bsobeloffgittes/NFR25-CAD/Aerodynamics/Bodywork/PaintJob Design/2x2_twill_pattern_carbon_size-540.jpg

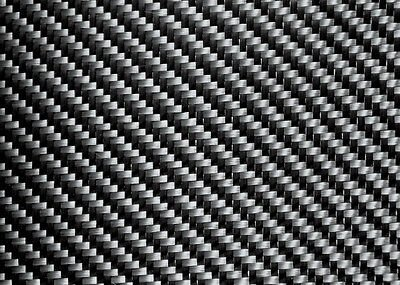
Aerodynamics/Bodywork/PaintJob Design/2x2_twill_pattern_carbon_size-540.jpg
