bsobeloffgittes/NFR25-CAD/Accumulator/Penthouse/Penthouse Internals/reference_images/receptacle_model_dimensions.jpg

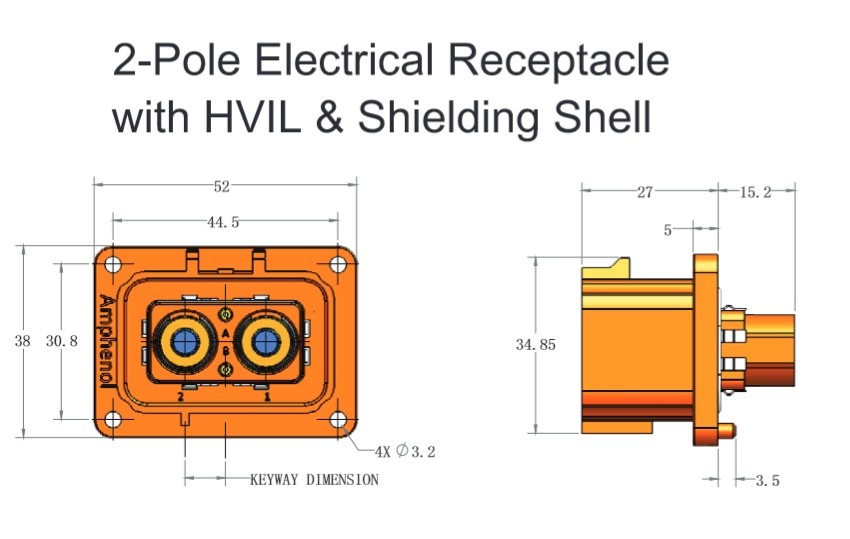
Accumulator/Penthouse/Penthouse Internals/reference_images/receptacle_model_dimensions.jpg
