bsobeloffgittes/NFR25-CAD/README.md

# NFR25-CAD
CAD file management for NFR25
