bsobeloffgittes/NFR25-CAD/Aerodynamics/Bodywork/Car Number.jpg

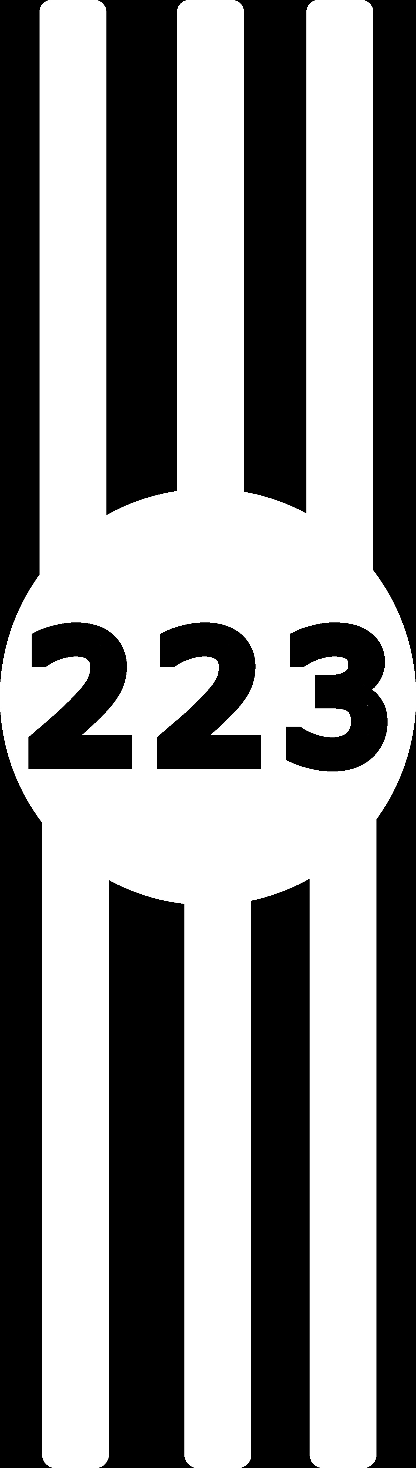
Aerodynamics/Bodywork/Car Number.jpg
