bsobeloffgittes/NFR25-CAD/Aerodynamics/Bodywork/Car Number.png

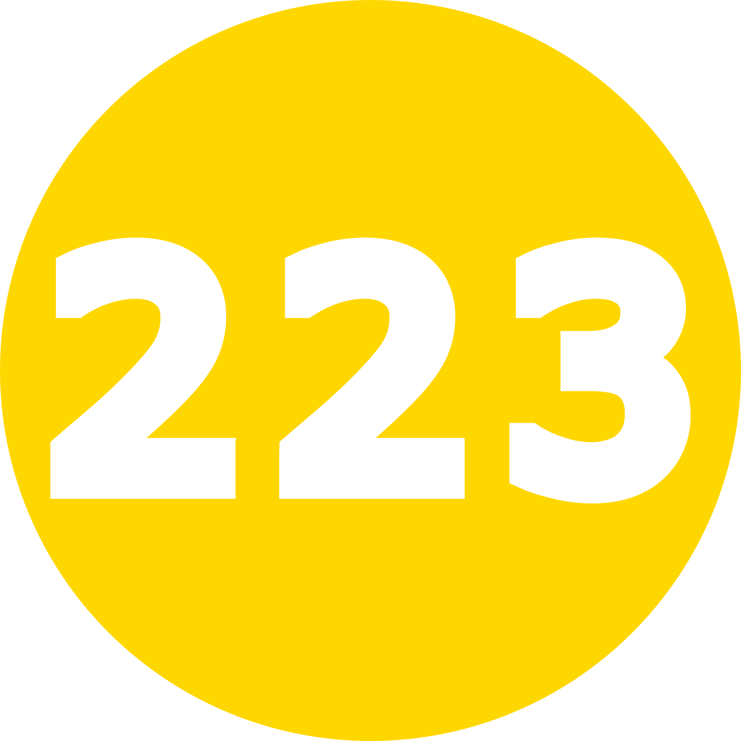
Aerodynamics/Bodywork/Car Number.png
