bsobeloffgittes/NFR25-CAD/Aerodynamics/Bodywork/Mechanical Tech Inspection Stickers/NFR25_Car_Number.png

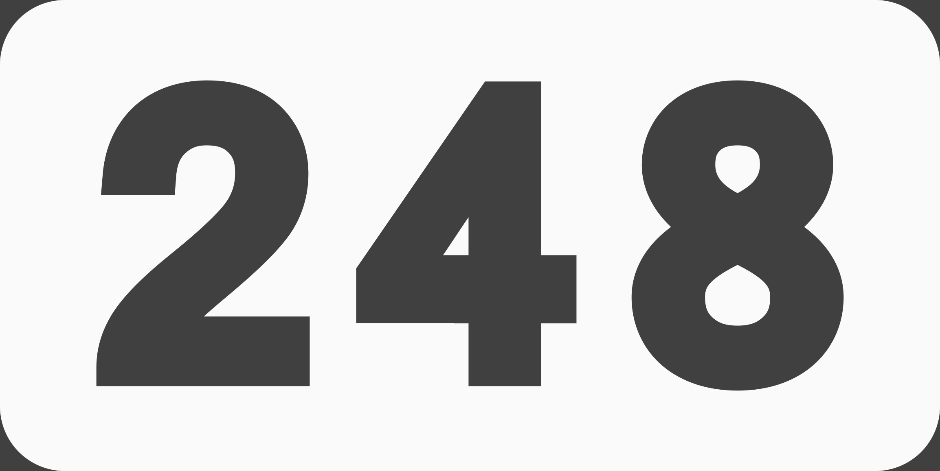
Aerodynamics/Bodywork/Mechanical Tech Inspection Stickers/NFR25_Car_Number.png
