bsobeloffgittes/NFR25-CAD/Aerodynamics/Bodywork/Mechanical Tech Inspection Stickers/NFR25_School_Name.png

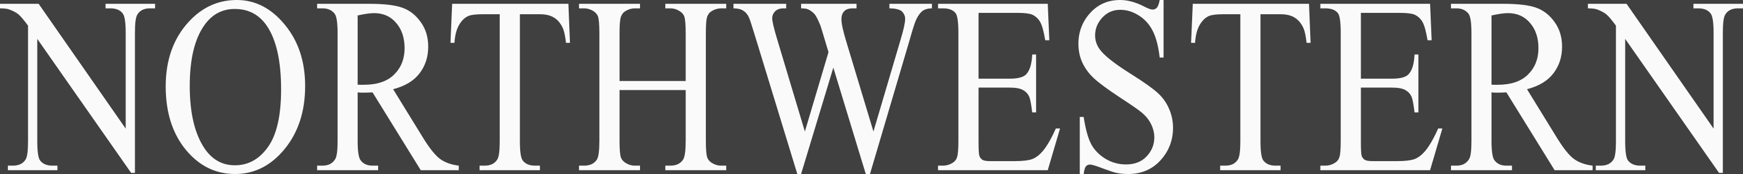
Aerodynamics/Bodywork/Mechanical Tech Inspection Stickers/NFR25_School_Name.png
