bsobeloffgittes/NFR25-CAD/Aerodynamics/Bodywork/School Name.png

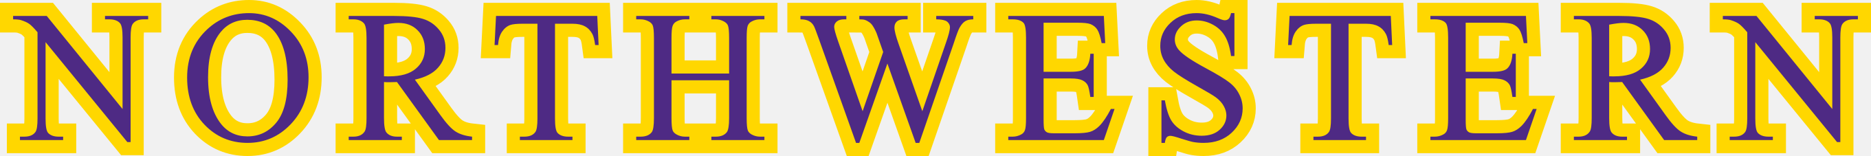
Aerodynamics/Bodywork/School Name.png
