bsobeloffgittes/NFR25-CAD/Aerodynamics/Bodywork/Wildcat.png

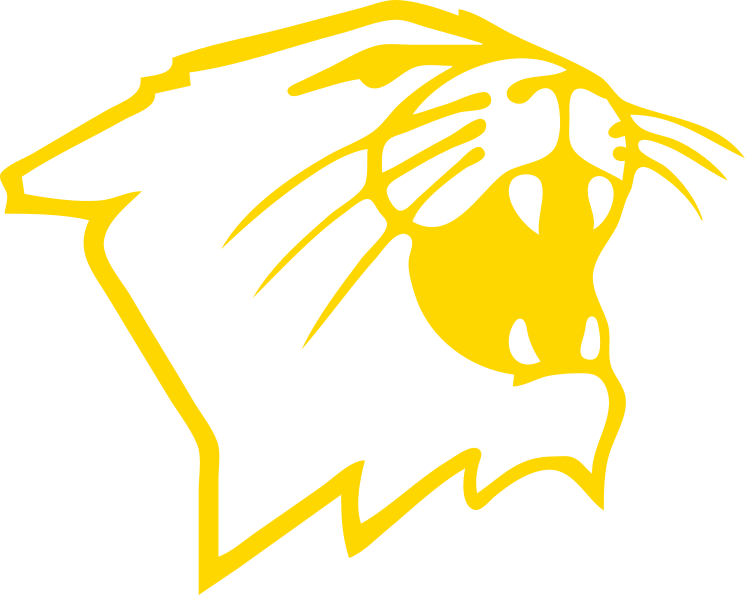
Aerodynamics/Bodywork/Wildcat.png
