bsobeloffgittes/NFR25-CAD/Chassis/Jigging/Adapter Plate Drawings/2_frame.JPG

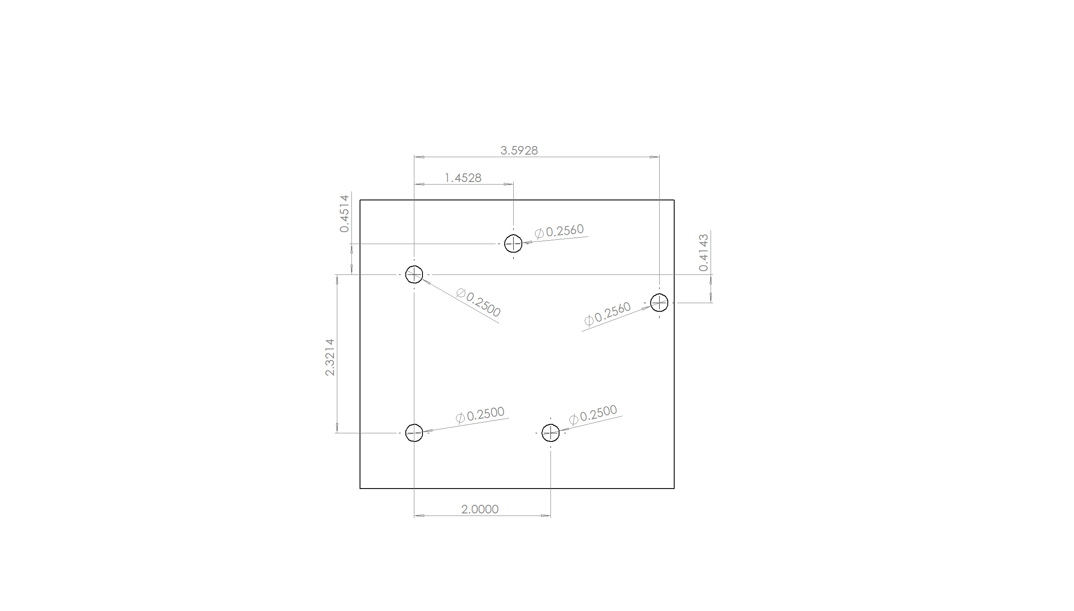
Chassis/Jigging/Adapter Plate Drawings/2_frame.JPG
