bsobeloffgittes/NFR25-CAD/Suspension/Rockers/Rear Rockers/Front-Rear Rocker Tabs.JPG

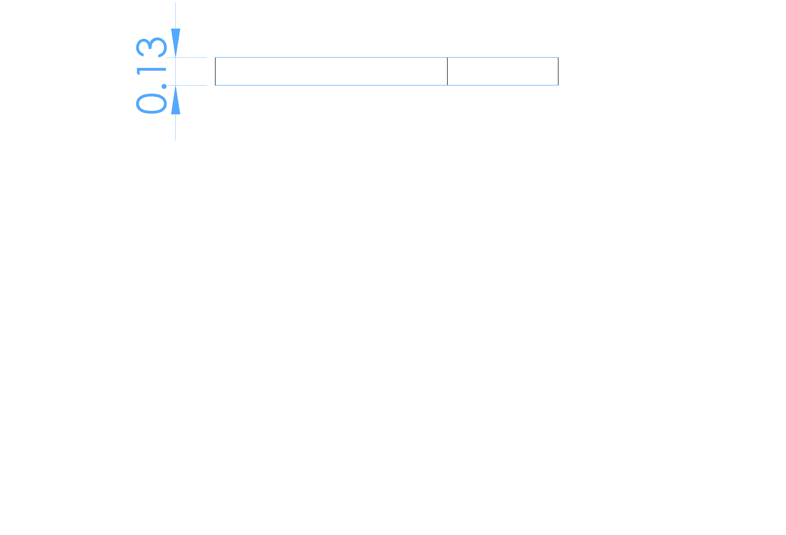
Suspension/Rockers/Rear Rockers/Front-Rear Rocker Tabs.JPG
