bsobeloffgittes/NFR25-CAD/Accumulator/Penthouse/Penthouse Internals/Penthouse Bystronic Parts/GLV_Penthouse_Plate.png

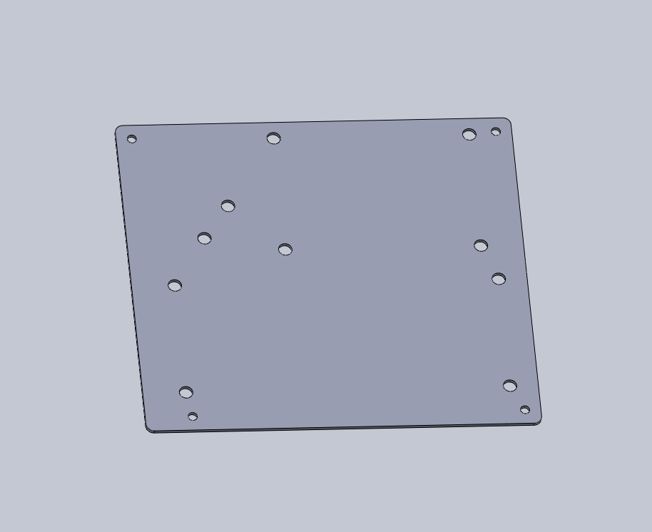
Accumulator/Penthouse/Penthouse Internals/Penthouse Bystronic Parts/GLV_Penthouse_Plate.png
