bsobeloffgittes/NFR25-CAD/Accumulator/Penthouse/Penthouse Internals/Penthouse Bystronic Parts/TS_Penthouse_Plate.png

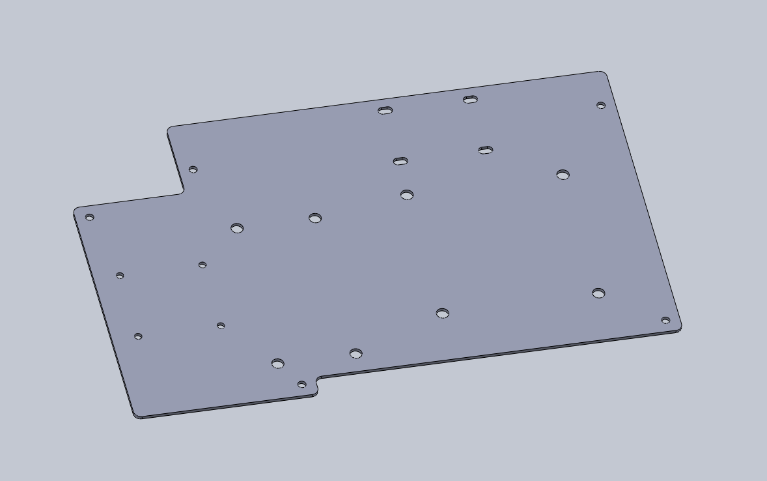
Accumulator/Penthouse/Penthouse Internals/Penthouse Bystronic Parts/TS_Penthouse_Plate.png
