bsobeloffgittes/NFR25-CAD/Electrical/Inverter/Bystronic Parts Order/InverterBody.png

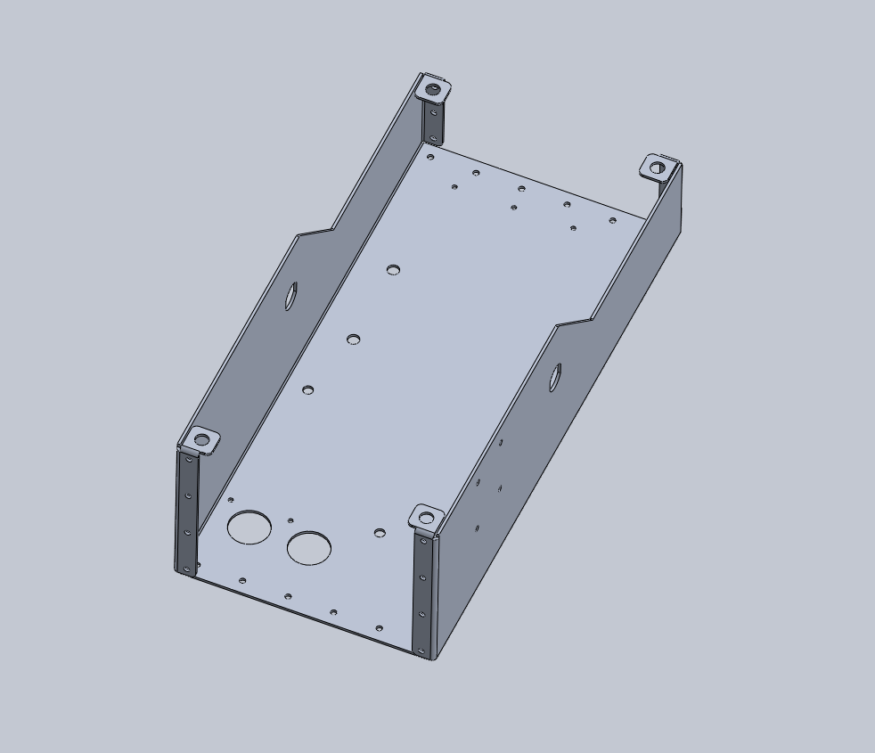
Electrical/Inverter/Bystronic Parts Order/InverterBody.png
