bsobeloffgittes/NFR25-CAD/Electrical/Inverter/Bystronic Parts Order/InverterLeftWall.png

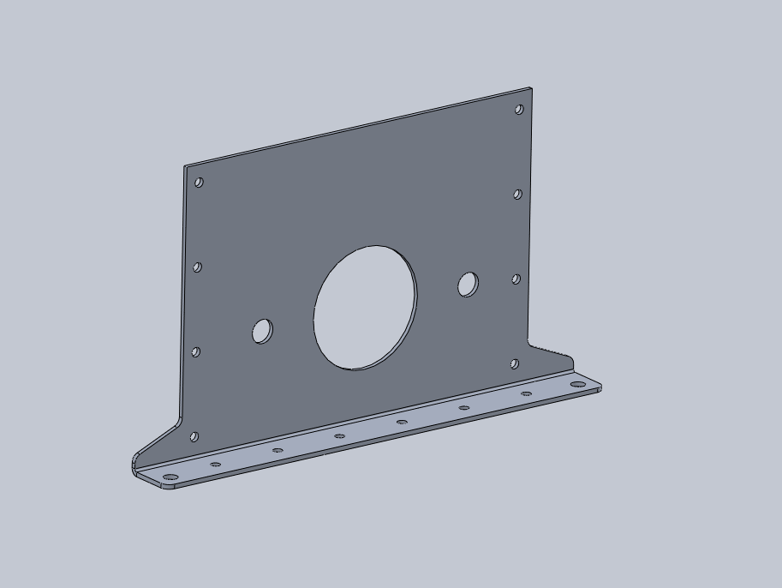
Electrical/Inverter/Bystronic Parts Order/InverterLeftWall.png
