bsobeloffgittes/NFR25-CAD/Electrical/Inverter/Bystronic Parts Order/InverterLid.png

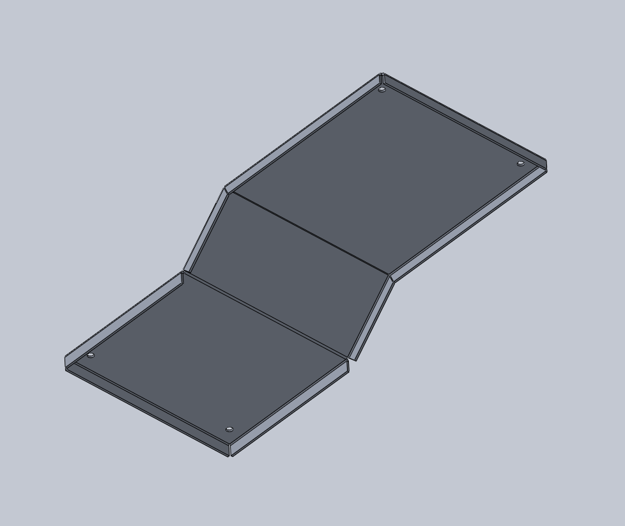
Electrical/Inverter/Bystronic Parts Order/InverterLid.png
