bsobeloffgittes/NFR25-CAD/Electrical/Inverter/Bystronic Parts Order/InverterRightWall.png

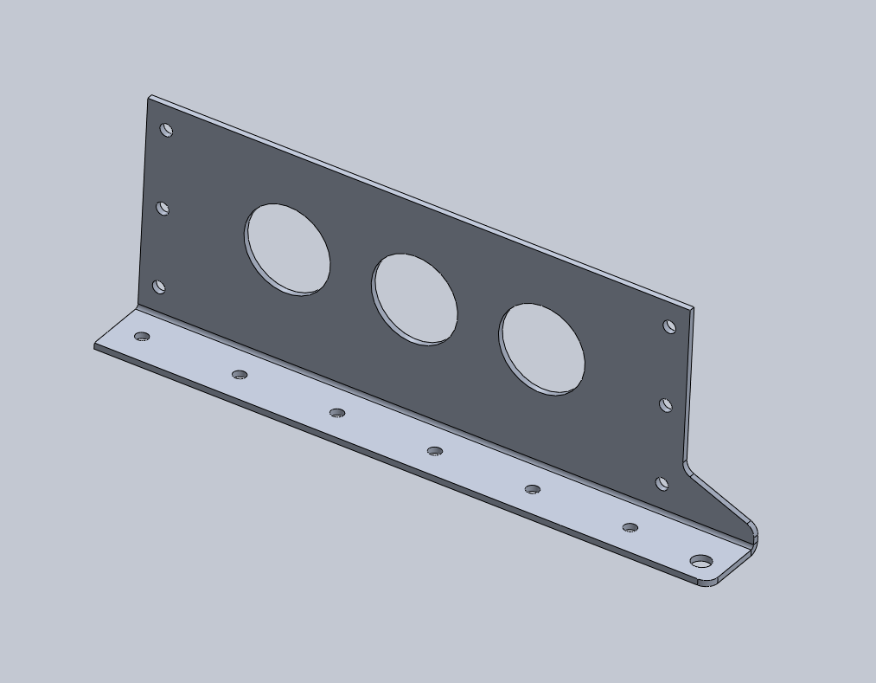
Electrical/Inverter/Bystronic Parts Order/InverterRightWall.png
