bsobeloffgittes/NFR25-CAD/Electrical/Inverter/Bystronic Parts Order/PenthouseLid.png

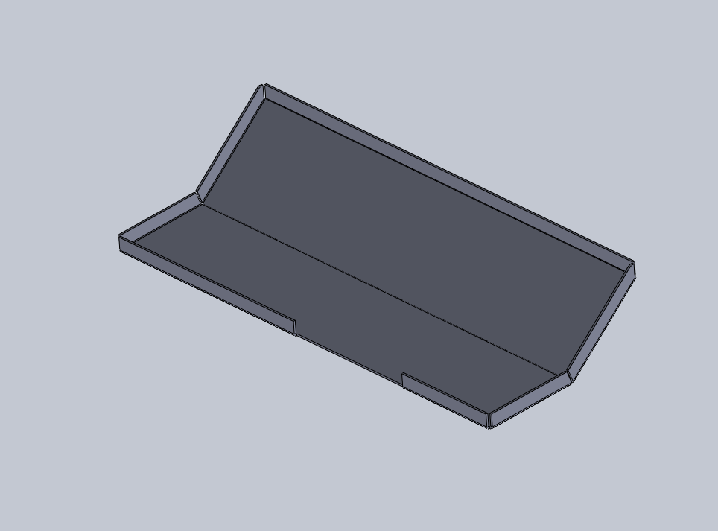
Electrical/Inverter/Bystronic Parts Order/PenthouseLid.png
