bsobeloffgittes/NFR25-CAD/Electrical/Inverter/Bystronic Parts Order/SegmentInternalWall.png

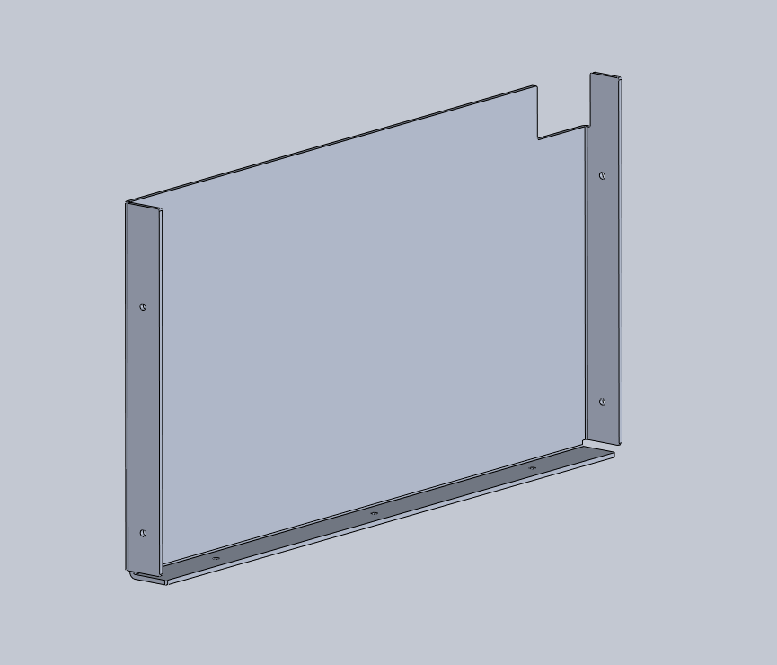
Electrical/Inverter/Bystronic Parts Order/SegmentInternalWall.png
