bsobeloffgittes/NFR25-CAD/Chassis/Ergo/PedalBox Floor^_Chassis_Assembly_NFR25.SLDPRT

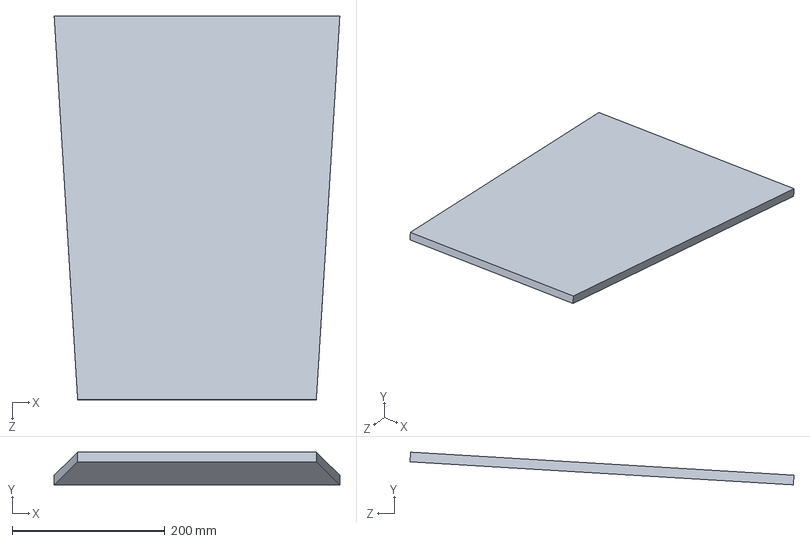
[picture p19: CAD file, 2025-07-07]
Chassis/Ergo/PedalBox Floor^_Chassis_Assembly_NFR25.SLDPRT
373.9 x 42.9 x 502.6 mm
