bsobeloffgittes/NFR25-CAD/Chassis/Frame/Main RH 1.SLDPRT

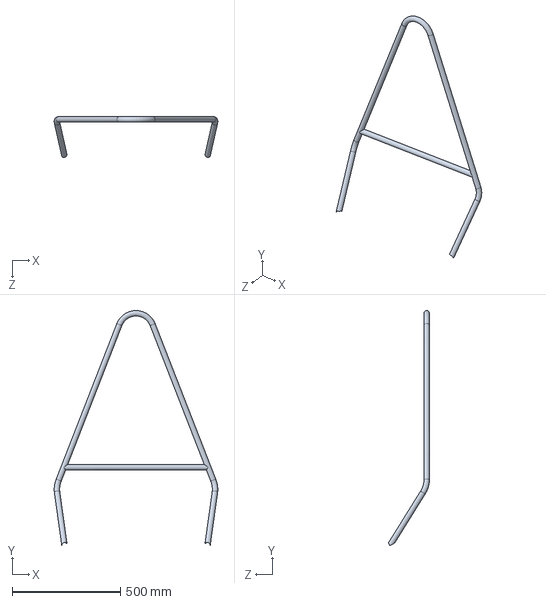
[picture p20: CAD file, 2024-11-23]
Chassis/Frame/Main RH 1.SLDPRT
756.1 x 1085.5 x 188.7 mm
