bsobeloffgittes/NFR25-CAD/Aerodynamics/Floors/Main Floor.DXF

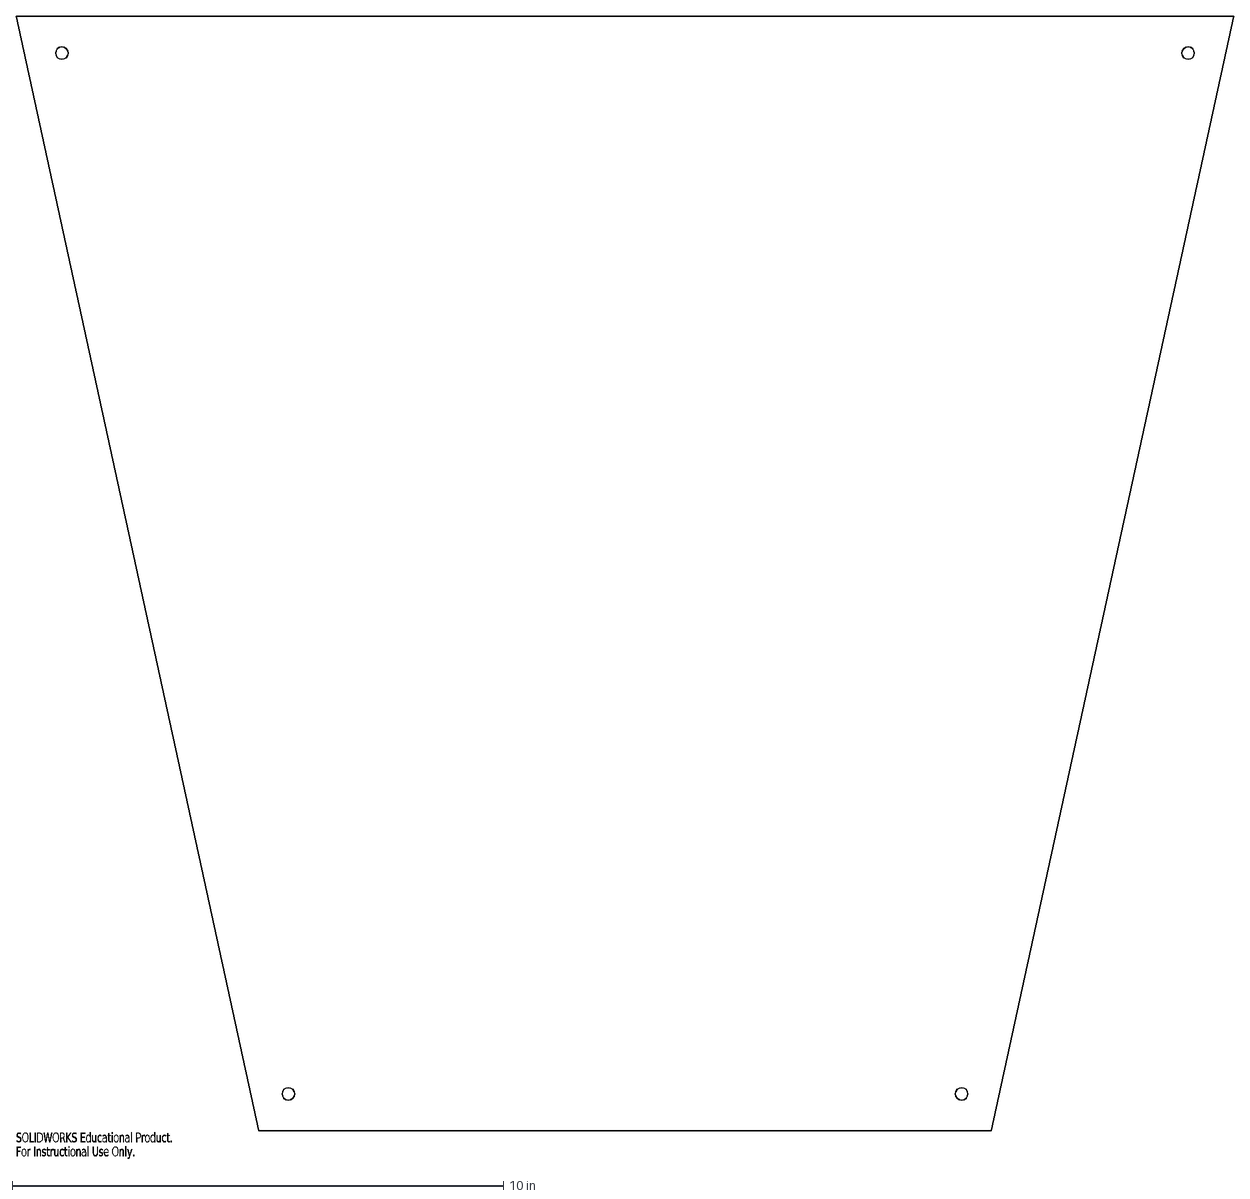
[picture p21: CAD file, 2025-04-21]
Aerodynamics/Floors/Main Floor.DXF
SOLIDWORKS Educational Product.
For Instructional Use Only.
