bsobeloffgittes/NFR25-CAD/Aerodynamics/Front Wing/Front Wing Molds/Front_Wing_Main_Foil.STEP

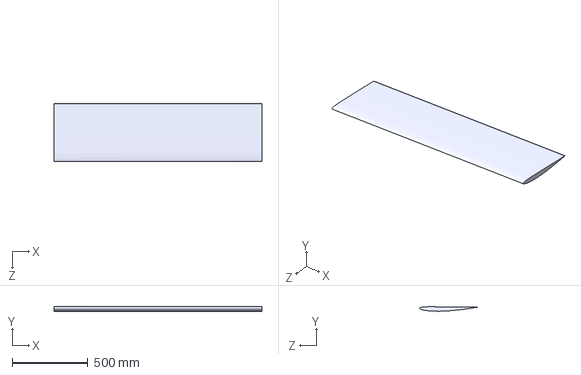
[picture p22: CAD file, 2025-02-25]
Aerodynamics/Front Wing/Front Wing Molds/Front_Wing_Main_Foil.STEP
1377.2 x 30.3 x 384.4 mm
