bsobeloffgittes/NFR25-CAD/Chassis/Frame/Full Main RH.SLDPRT

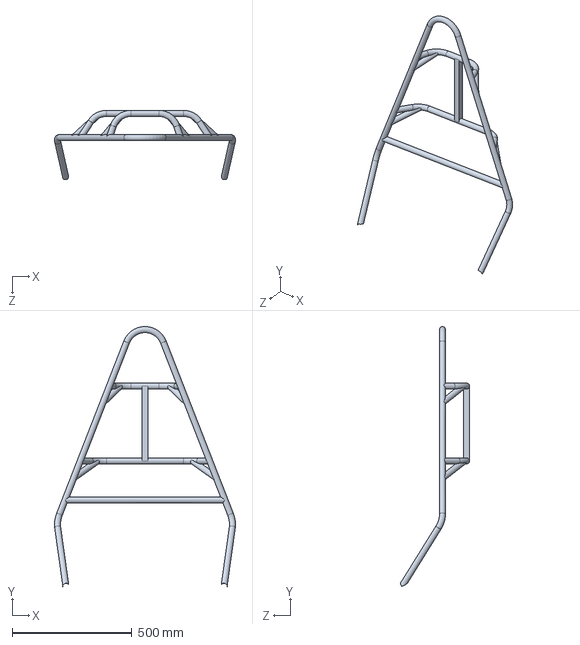
[picture p23: CAD file, 2024-11-20]
Chassis/Frame/Full Main RH.SLDPRT
756.1 x 1085.5 x 289.5 mm
