bsobeloffgittes/NFR25-CAD/Aerodynamics/Front Wing/Front Wing Molds/Front_Wing_Main_Foil_Mold.STEP

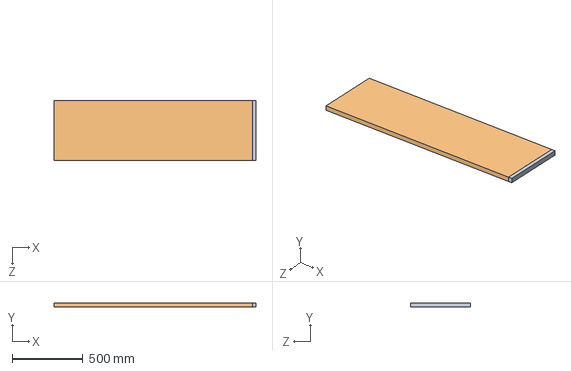
[picture p24: CAD file, 2025-02-25]
Aerodynamics/Front Wing/Front Wing Molds/Front_Wing_Main_Foil_Mold.STEP
1428.0 x 30.7 x 425.5 mm
