bsobeloffgittes/NFR25-CAD/Chassis/Ergo/Main Floor Front Tab NFR25.SLDPRT

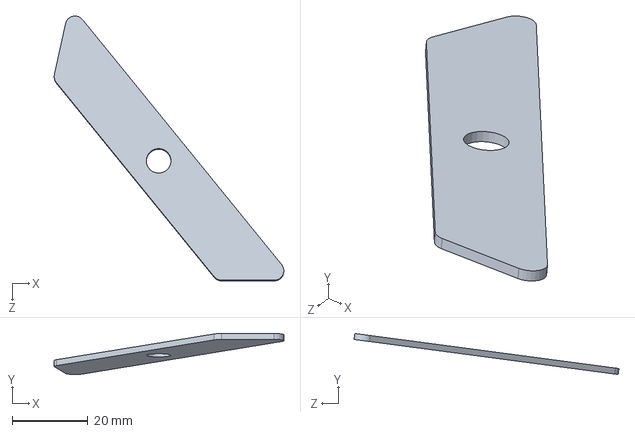
[picture p25: CAD file, 2025-04-30]
Chassis/Ergo/Main Floor Front Tab NFR25.SLDPRT
60.5 x 10.8 x 69.9 mm
