bsobeloffgittes/NFR25-CAD/Chassis/Ergo/Seat Floor^_Chassis_Assembly_NFR25.SLDPRT

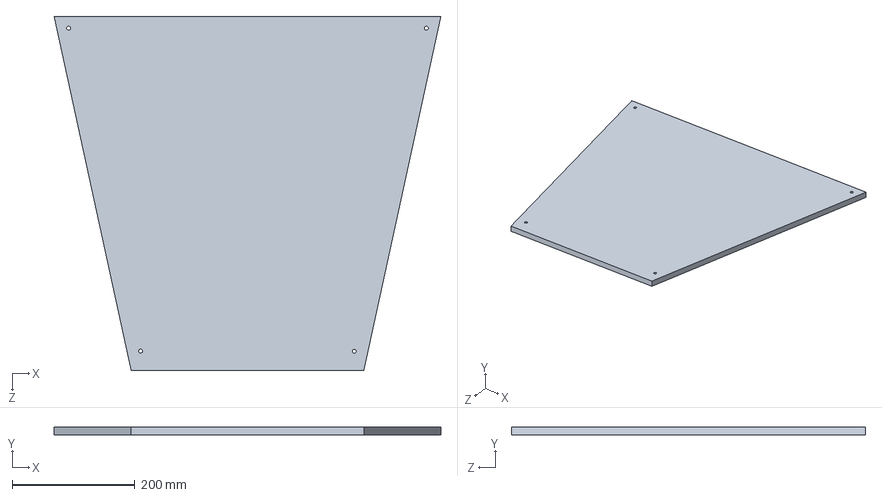
[picture p26: CAD file, 2025-04-30]
Chassis/Ergo/Seat Floor^_Chassis_Assembly_NFR25.SLDPRT
629.9 x 12.7 x 576.5 mm
