bsobeloffgittes/NFR25-CAD/Chassis/sus tab jigging/Motor diff mount tabs/Part31^sus tab jigging assembly.SLDPRT

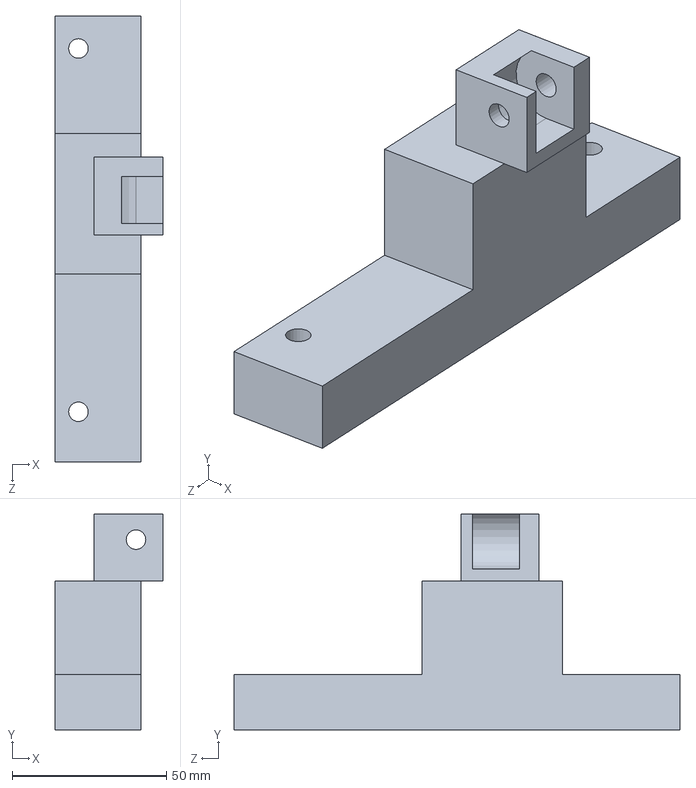
[picture p27: CAD file, 2025-02-08]
Chassis/sus tab jigging/Motor diff mount tabs/Part31^sus tab jigging assembly.SLDPRT
35.1 x 70.0 x 144.8 mm
