bsobeloffgittes/NFR25-CAD/Accumulator/Segments/Busbar Bonding/segAssemblyCover.SLDPRT

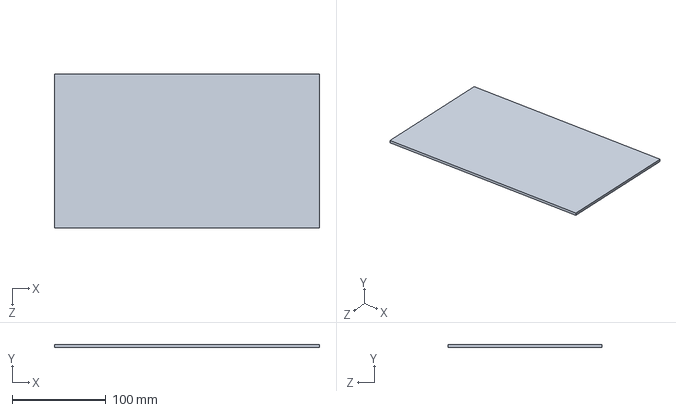
[picture p28: CAD file, 2024-10-24]
Accumulator/Segments/Busbar Bonding/segAssemblyCover.SLDPRT
283.0 x 3.20 x 164.0 mm
