bsobeloffgittes/NFR25-CAD/Accumulator/Segments/Maintenance Plugs and Busbars/Intersegment Maintenance Plugs/Covers and Busbar/LongFemale_Maintenance_Plug_CoverPrint.STL

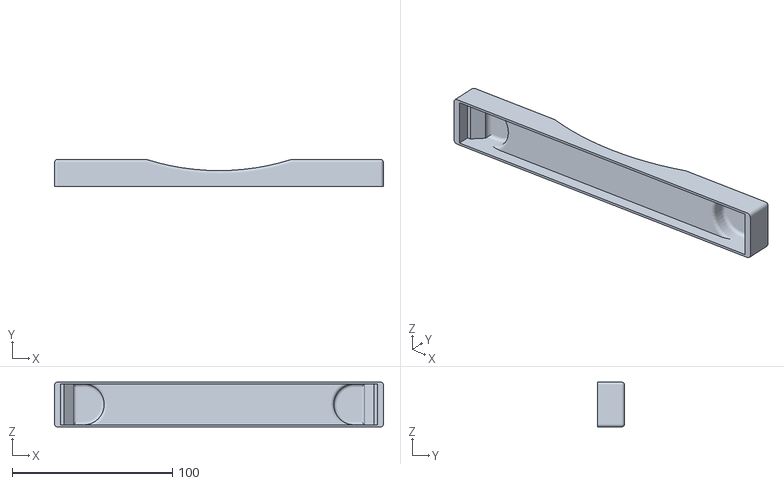
[picture p29: CAD file, 2025-04-21]
Accumulator/Segments/Maintenance Plugs and Busbars/Intersegment Maintenance Plugs/Covers and Busbar/LongFemale_Maintenance_Plug_CoverPrint.STL
205.0 x 17.0 x 28.0
