bsobeloffgittes/NFR25-CAD/Accumulator/Water Cooling/CFD Assemblies and Step files/CFDSimAssemblyStep.STEP

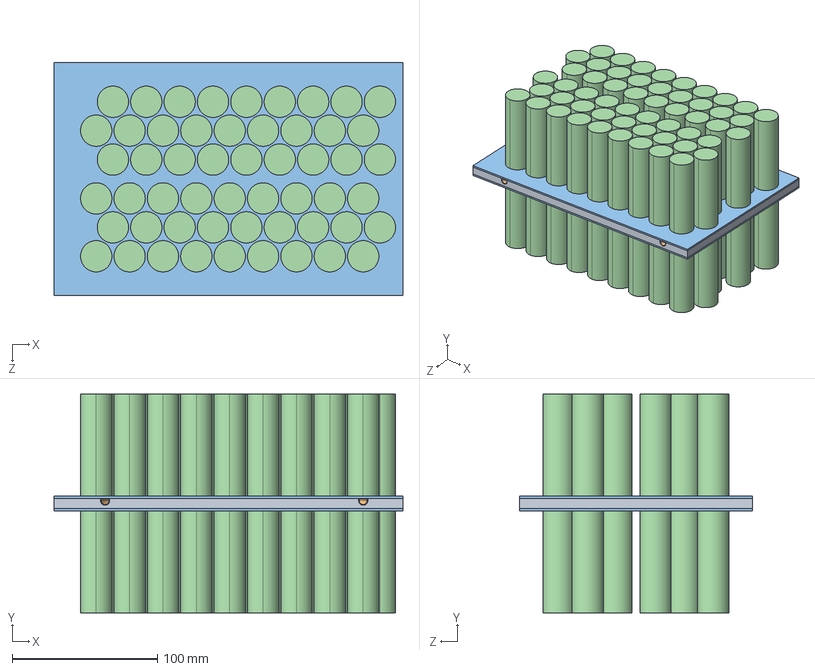
[picture p30: CAD file, 2024-08-12]
Accumulator/Water Cooling/CFD Assemblies and Step files/CFDSimAssemblyStep.STEP
240.0 x 150.3 x 160.0 mm
seriesColdPlate
thermalPad x 2
CellExample x 108
