bsobeloffgittes/NFR25-CAD/Suspension/Steering/151931058-7-skf_bearing_61904-2rs1_2/skf_bearing_61904-2rs1_2.SLDASM

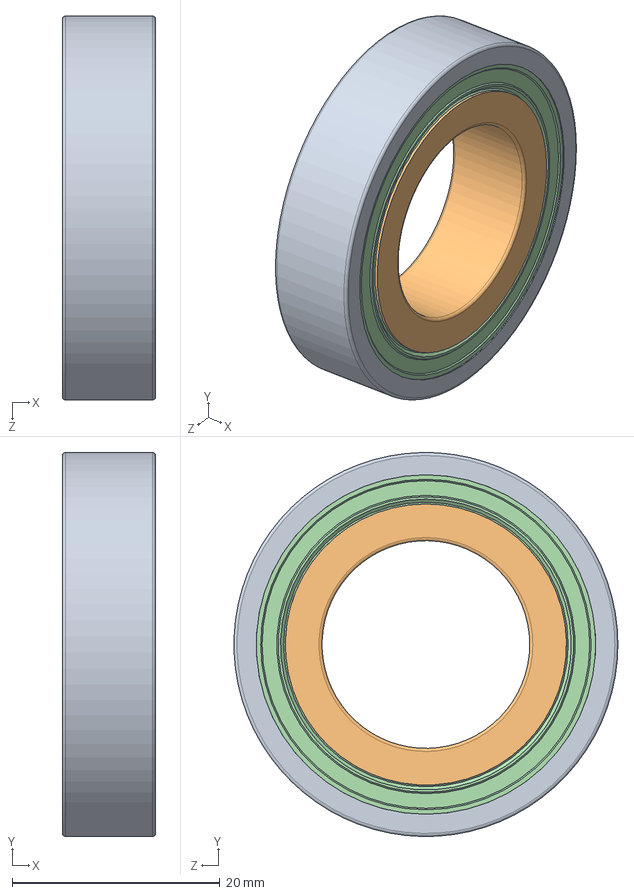
[picture p31: CAD file, 2024-10-29]
Suspension/Steering/151931058-7-skf_bearing_61904-2rs1_2/skf_bearing_61904-2rs1_2.SLDASM
9.00 x 37.0 x 37.0 mm
skf_bearing_61904-2rs1_2_01
skf_bearing_61904-2rs1_2_02
skf_bearing_61904-2rs1_2_03
skf_bearing_61904-2rs1_2_04
skf_bearing_61904-2rs1_2_05
