bsobeloffgittes/NFR25-CAD/Chassis/Ergo/Main Floor.DXF

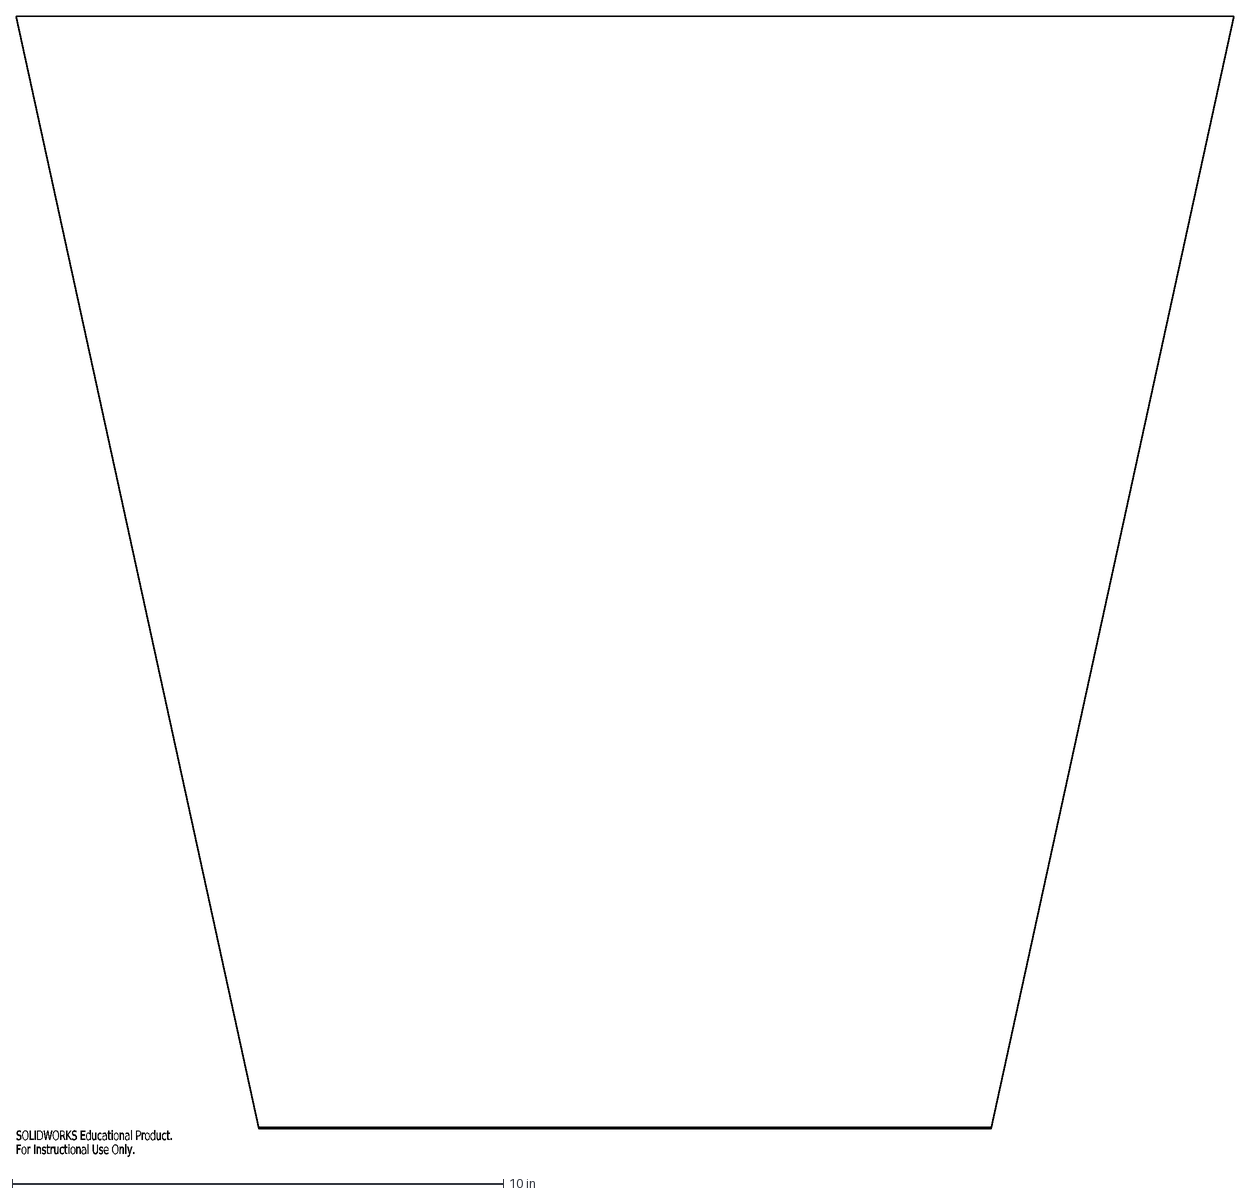
[picture p32: CAD file, 2025-04-21]
Chassis/Ergo/Main Floor.DXF
SOLIDWORKS Educational Product.
For Instructional Use Only.
