bsobeloffgittes/NFR25-CAD/Accumulator/Penthouse/Penthouse Internals/ELRA2Z25_main_battery_connector.SLDPRT

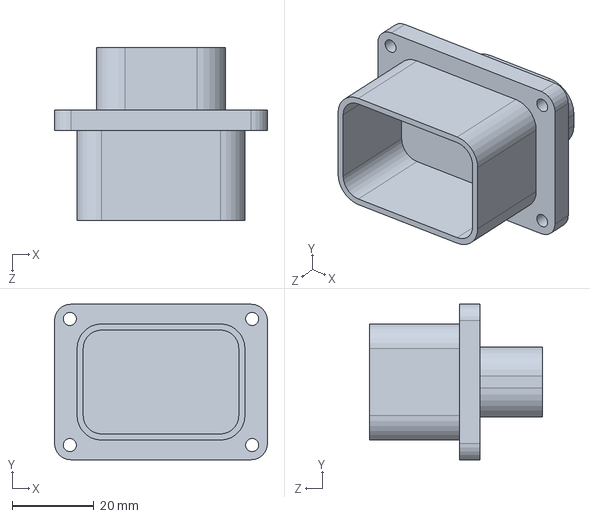
[picture p33: CAD file, 2024-11-02]
Accumulator/Penthouse/Penthouse Internals/ELRA2Z25_main_battery_connector.SLDPRT
52.0 x 38.0 x 42.2 mm
