bsobeloffgittes/NFR25-CAD/Electrical/LV Battery/Yay!/LV_main-connector.SLDPRT

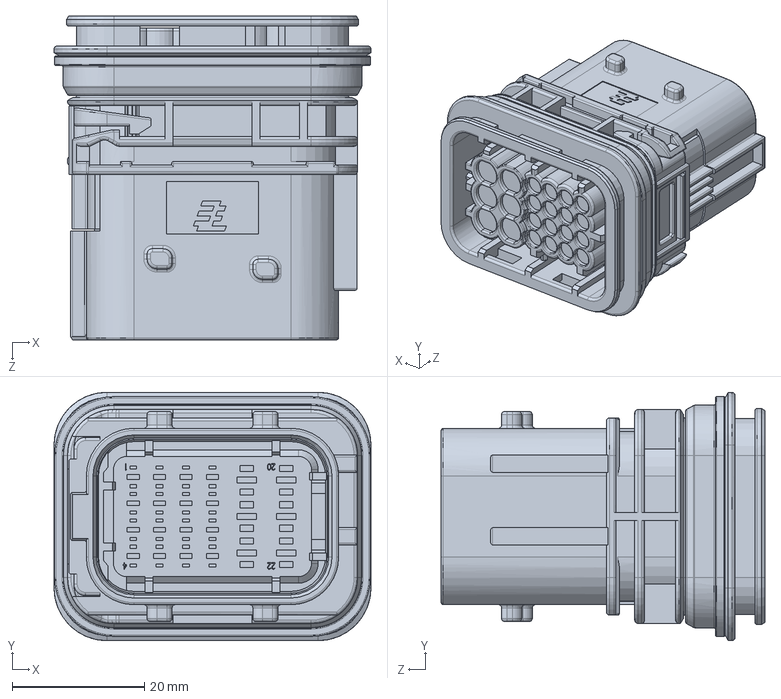
[picture p34: CAD file, 2025-02-05]
Electrical/LV Battery/Yay!/LV_main-connector.SLDPRT
48.0 x 37.6 x 49.0 mm
