bsobeloffgittes/NFR25-CAD/Chassis/Jigging/Adapter Plates/main_roll_hoop_frame.SLDPRT

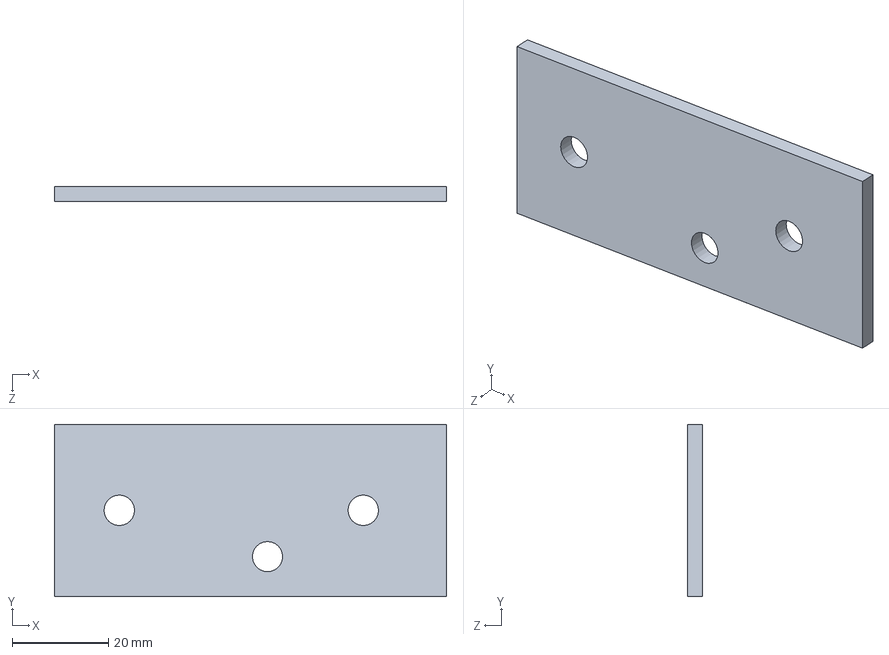
[picture p35: CAD file, 2024-12-17]
Chassis/Jigging/Adapter Plates/main_roll_hoop_frame.SLDPRT
81.6 x 35.8 x 3.17 mm
