bsobeloffgittes/NFR25-CAD/Suspension/Hubs/Front Hubs/skf_bearing_32008_x_2.SLDASM

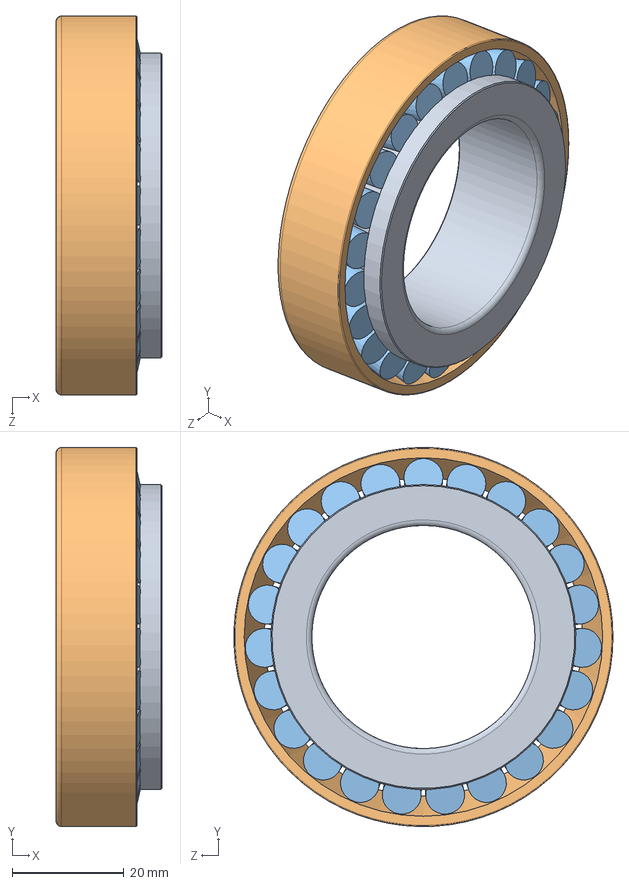
[picture p36: CAD file, 2024-10-03]
Suspension/Hubs/Front Hubs/skf_bearing_32008_x_2.SLDASM
19.0 x 68.0 x 68.0 mm
skf_bearing_32008_x_2_01
skf_bearing_32008_x_2_02
skf_bearing_32008_x_2_03
