bsobeloffgittes/NFR25-CAD/Accumulator/Segments/Maintenance Plugs and Busbars/Intersegment Maintenance Plugs/Covers and Busbar/Female_Maintenance_Plug_Cover.SLDPRT

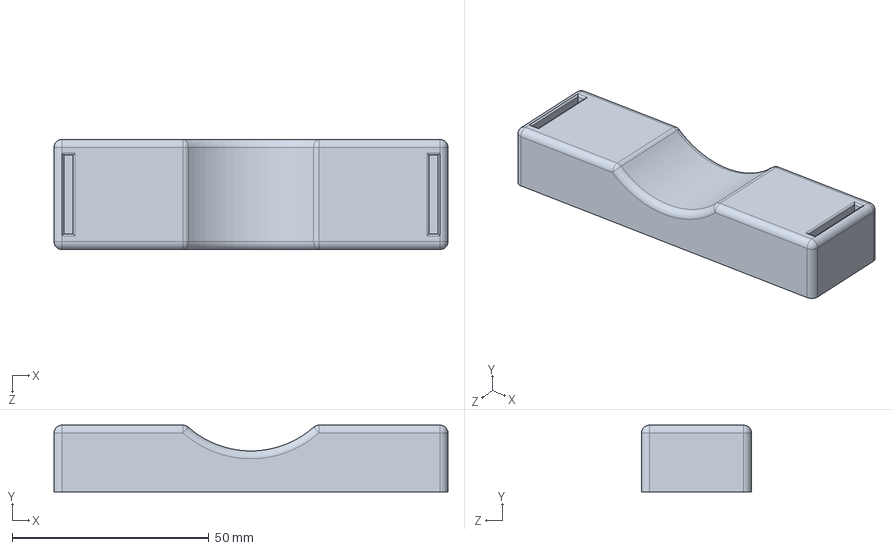
[picture p37: CAD file, 2025-02-15]
Accumulator/Segments/Maintenance Plugs and Busbars/Intersegment Maintenance Plugs/Covers and Busbar/Female_Maintenance_Plug_Cover.SLDPRT
100.2 x 17.0 x 28.0 mm
