bsobeloffgittes/NFR25-CAD/Chassis/Ergo/Main Floor Rear Tab NFR25.SLDPRT

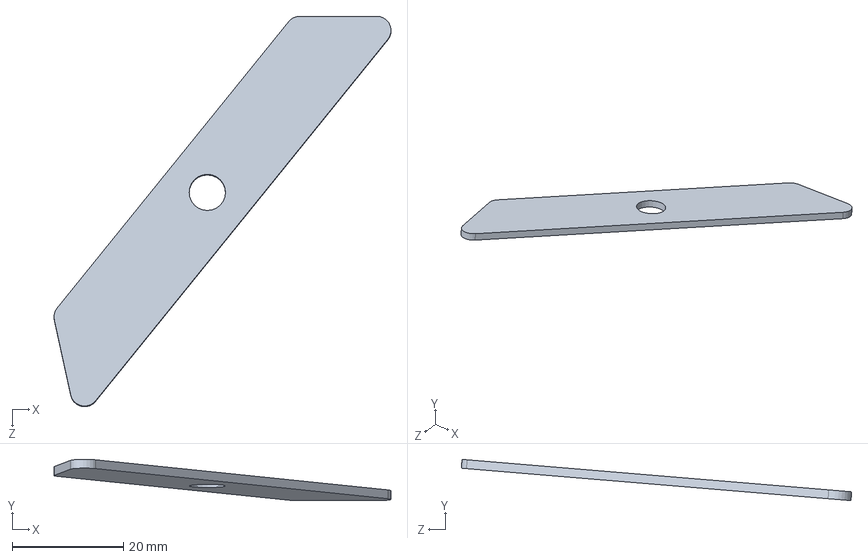
[picture p38: CAD file, 2025-04-03]
Chassis/Ergo/Main Floor Rear Tab NFR25.SLDPRT
60.5 x 7.41 x 70.1 mm
