bsobeloffgittes/NFR25-CAD/Accumulator/Mounts/Jig assembly.SLDASM

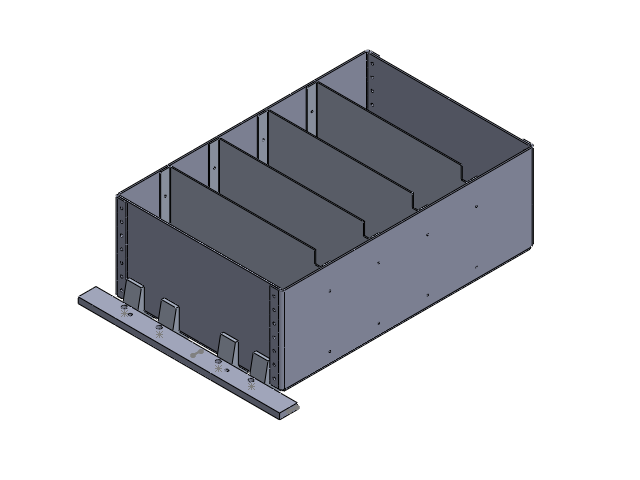
[picture p39: CAD file, 2025-02-11]
Accumulator/Mounts/Jig assembly.SLDASM
Side_Accumulator_Mount x 4
SegmentExternalWalls
SegmentInternalWall x 4
Mount Jig Bar
