bsobeloffgittes/NFR25-CAD/Accumulator/Other/Drake's Folder/5seg_accumulator.SLDASM

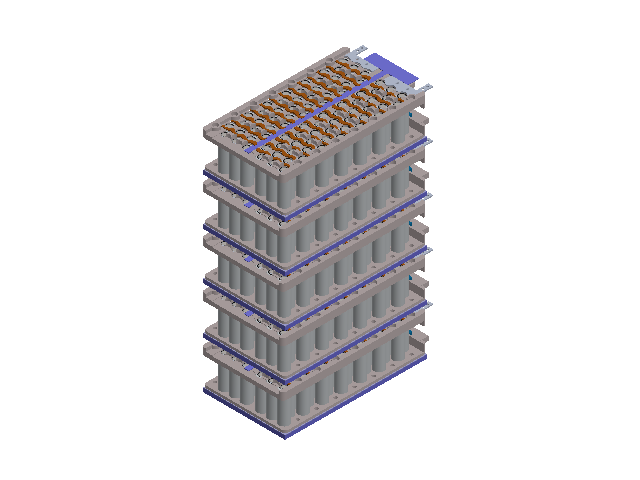
[picture p40: CAD file, 2024-08-24]
Accumulator/Other/Drake's Folder/5seg_accumulator.SLDASM
TopCellHolder_5seg x 5
BottomCellHolder_5segV2 x 5
NFR_22_molicell_21700_Version_2.0 (shucked, different top geometry) x 420
5seg_busbar_1 x 70
topBusbar x 5
bottomBusbar x 5
maleMolexMP x 10
BMS_25 x 5
MockSensePCB x 5
5seg_busbar_2 x 60
MasterNegativeSM x 5
MasterPositiveSM x 5
thermal_pad_5seg x 5
temp_cold_plate_5seg x 5
