bsobeloffgittes/NFR25-CAD/Accumulator/Penthouse/penthouse box/penthouse_container.SLDASM

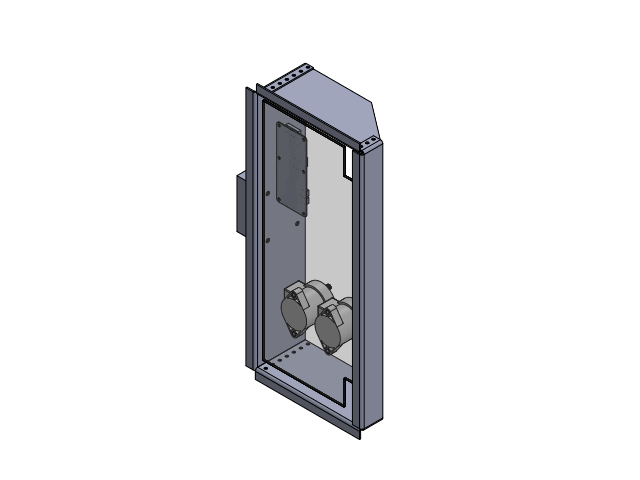
[picture p41: CAD file, 2024-10-17]
Accumulator/Penthouse/penthouse box/penthouse_container.SLDASM
Penthouse_rightwall
Penthouse_box_frontface
Penthouse_box_backface
iso175_IMD
ev200a_KILOVAC-Contactor-500+Amps-12-900VDC x 2
Plastic Base Plate
MSDXLF000R Base Mockup
Penthouse_leftwall
SLPRBBPSO_Receptacle
