bsobeloffgittes/NFR25-CAD/Accumulator/Penthouse/Penthouse_Container.SLDASM

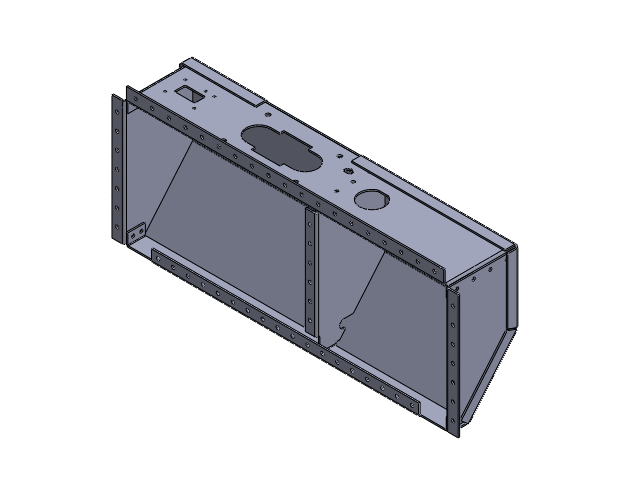
[picture p42: CAD file, 2025-04-03]
Accumulator/Penthouse/Penthouse_Container.SLDASM
PenthouseInternalWall
Penthouse_Rear_Wall
Penthouse_Front_Wall
Penthouse_Left_Wall
PenthouseLid
Penthouse_Right_Wall
