bsobeloffgittes/NFR25-CAD/Accumulator/Segment Container/Container/Latches/Southco-TL-40-111-52.sldasm

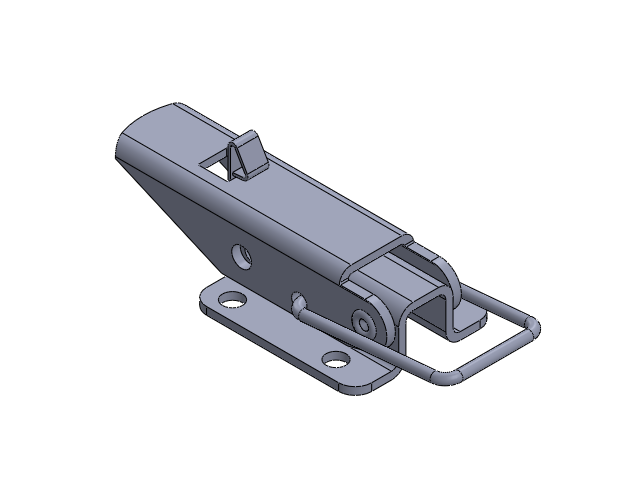
[picture p43: CAD file, 2025-04-21]
Accumulator/Segment Container/Container/Latches/Southco-TL-40-111-52.sldasm
Southco-TL-40-111-52_TL-40-111-52_Base
Southco-TL-40-111-52_TL-40-111-52_Lever
Southco-TL-40-111-52_TL-40-111-52_Rivet
Southco-TL-40-111-52_TL-40-111-52_Special link
