bsobeloffgittes/NFR25-CAD/Accumulator/Segment Container/SegmentContainer.SLDASM

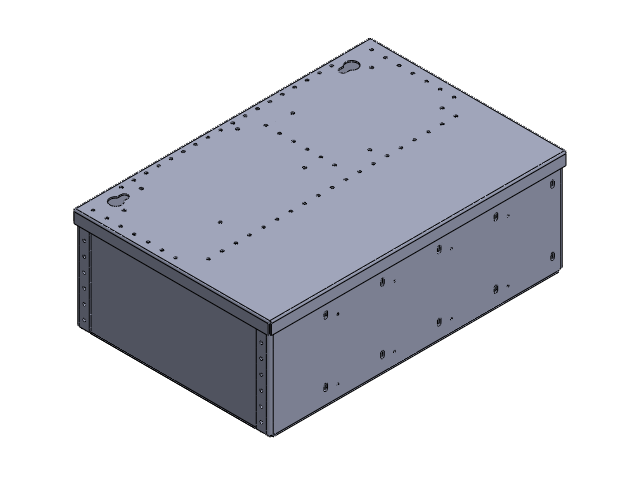
[picture p44: CAD file, 2025-05-03]
Accumulator/Segment Container/SegmentContainer.SLDASM
SegmentExternalWalls
SegmentInternalWall x 4
SegmentLid
