bsobeloffgittes/NFR25-CAD/Accumulator/Segment_Box.SLDASM

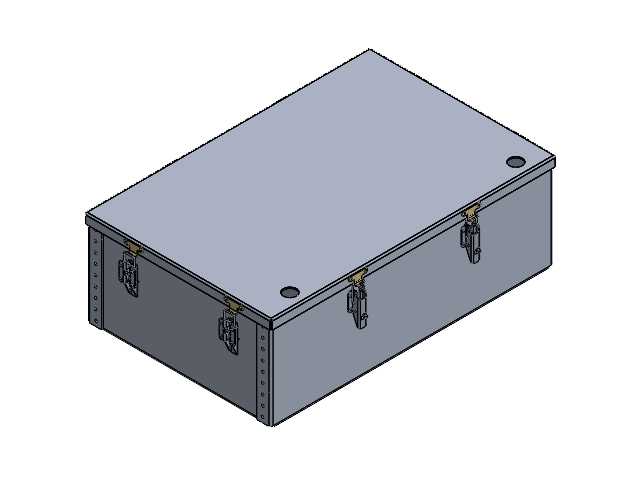
[picture p45: CAD file, 2024-10-30]
Accumulator/Segment_Box.SLDASM
Accumulator_Container_Lid_v2
Accumulator_Container_OnePiece
wall with flanges x 4
Southco-TL-17-209-52 x 8
Southco-TL-40-111-52_TL-40-111-52_Base x 8
Southco-TL-40-111-52_TL-40-111-52_Lever x 8
Southco-TL-40-111-52_TL-40-111-52_Rivet x 8
Southco-TL-40-111-52_TL-40-111-52_Special link x 8
