bsobeloffgittes/NFR25-CAD/Accumulator/Segments/5 Segment Assemblies/5SegAssem.SLDASM

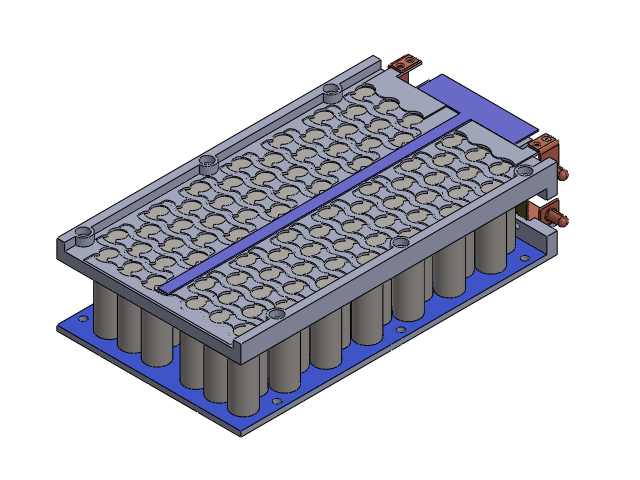
[picture p46: CAD file, 2024-08-24]
Accumulator/Segments/5 Segment Assemblies/5SegAssem.SLDASM
5SegTopCellHolder
CellExample x 84
5SegBottomCellHolder
MockSensePCB
BMS_25
MasterPos5Seg
MasterNeg5Seg
bottomBusbar
topBusbar
maleMolexMP x 2
BusbarBolt
