bsobeloffgittes/NFR25-CAD/Accumulator/Segments/8 Segment Design/Assemblies/SegmentandColdplate.SLDASM

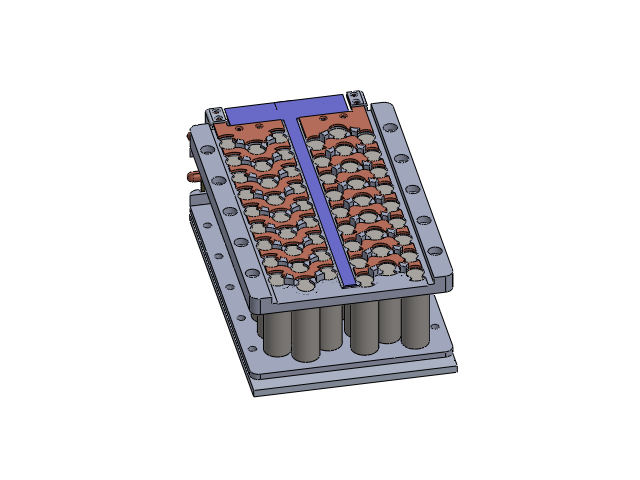
[picture p47: CAD file, 2024-08-19]
Accumulator/Segments/8 Segment Design/Assemblies/SegmentandColdplate.SLDASM
TopCellHolder
BottomCellHolder
CellExample x 54
MockSensePCB
maleMolexMP x 2
MasterPositiveSM
MasterNegativeSM
topBusbar
bottomBusbar
CellBusbarTemplate x 16
BMS_25
seriesColdPlate
