bsobeloffgittes/NFR25-CAD/Accumulator/Segments/Cell Holders/Moi_Calcs_Assem.SLDASM

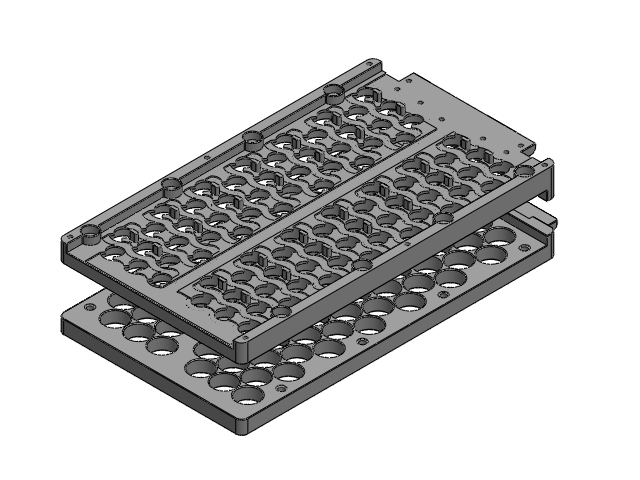
[picture p48: CAD file, 2025-01-15]
Accumulator/Segments/Cell Holders/Moi_Calcs_Assem.SLDASM
BottomCellHolder
TopCellHolder
