bsobeloffgittes/NFR25-CAD/Accumulator/Segments/Maintenance Plugs and Busbars/Intersegment Maintenance Plugs/LongMP.SLDASM

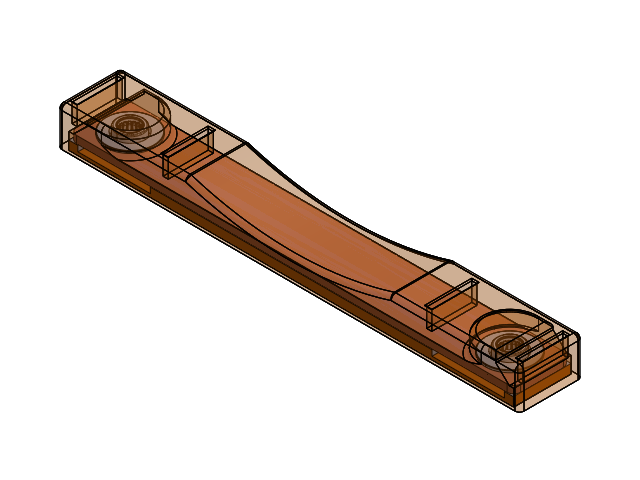
[picture p49: CAD file, 2025-04-21]
Accumulator/Segments/Maintenance Plugs and Busbars/Intersegment Maintenance Plugs/LongMP.SLDASM
LongFemaleMPBusbar
LongFemaleMPBottomCover
LongFemale_Maintenance_Plug_Cover
femaleMolexMP x 2
