bsobeloffgittes/NFR25-CAD/Accumulator/Segments/Segment Assemblies/OneSegTopPositive.SLDASM

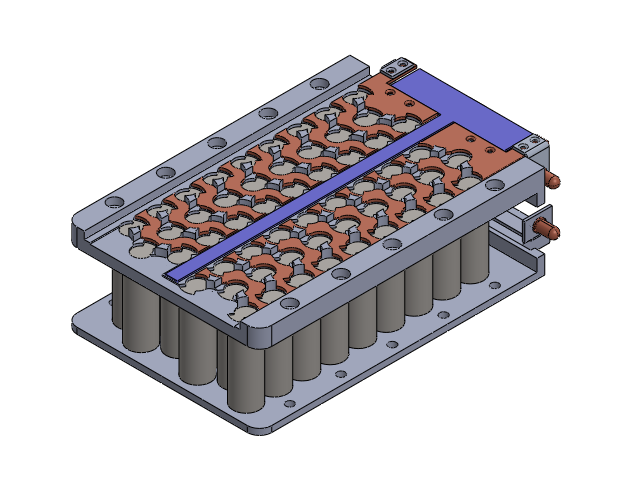
[picture p50: CAD file, 2024-08-12]
Accumulator/Segments/Segment Assemblies/OneSegTopPositive.SLDASM
TopCellHolder
BottomCellHolder
CellExample x 54
MockSensePCB
maleMolexMP x 2
MasterNegativeSM
MasterPositiveSM
topBusbar
bottomBusbar
CellBusbarTemplate x 16
