bsobeloffgittes/NFR25-CAD/Accumulator/Water Cooling/CFD Assemblies and Step files/SegmentCFD.SLDASM

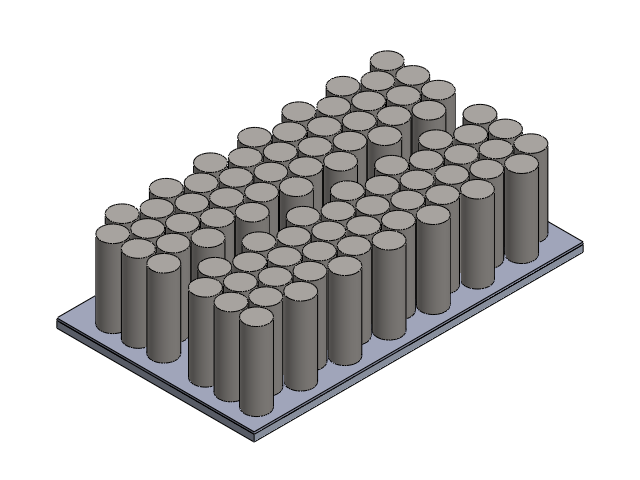
[picture p51: CAD file, 2024-10-01]
Accumulator/Water Cooling/CFD Assemblies and Step files/SegmentCFD.SLDASM
Molicel21700 x 84
AccumColdPlate
ThermalPad
