bsobeloffgittes/NFR25-CAD/Accumulator/Water Cooling/Cold Plates/Manufacturing/Base_Plate_Assembly.SLDASM

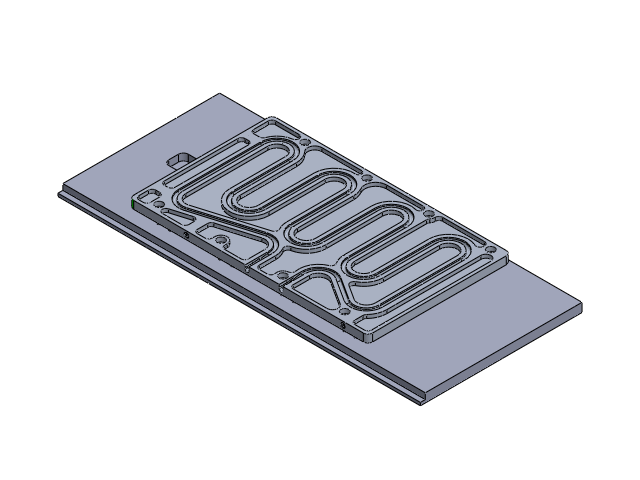
[picture p52: CAD file, 2025-01-20]
Accumulator/Water Cooling/Cold Plates/Manufacturing/Base_Plate_Assembly.SLDASM
Base_Plate
Cold_Plate
