bsobeloffgittes/NFR25-CAD/Accumulator/Water Cooling/Cold_Plate_Assembly.SLDASM

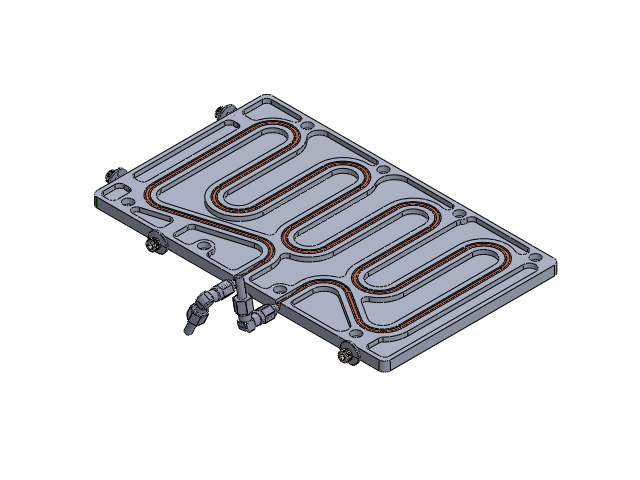
[picture p53: CAD file, 2025-05-03]
Accumulator/Water Cooling/Cold_Plate_Assembly.SLDASM
Cold_Plate
TubeNutCollar x 2
TubenutBlockModel x 2
RightAngleBlockModel x 2
BarbBlockModel x 2
94709A416_1-4_.75_SealingWasher x 4
91864A047_1-4x28_1-2_CapScrew x 4
