bsobeloffgittes/NFR25-CAD/Accumulator/Water Cooling/Hardware/ColdPlateFittingAssembly.SLDASM

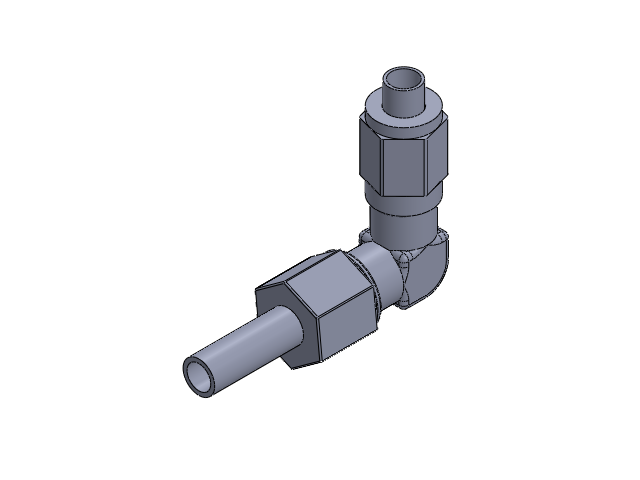
[picture p54: CAD file, 2025-02-05]
Accumulator/Water Cooling/Hardware/ColdPlateFittingAssembly.SLDASM
TubeNutCollar
TubenutBlockModel
RightAngleBlockModel
BarbBlockModel
