bsobeloffgittes/NFR25-CAD/Accumulator/Water Cooling/Splitter/5WaySplitter.SLDASM

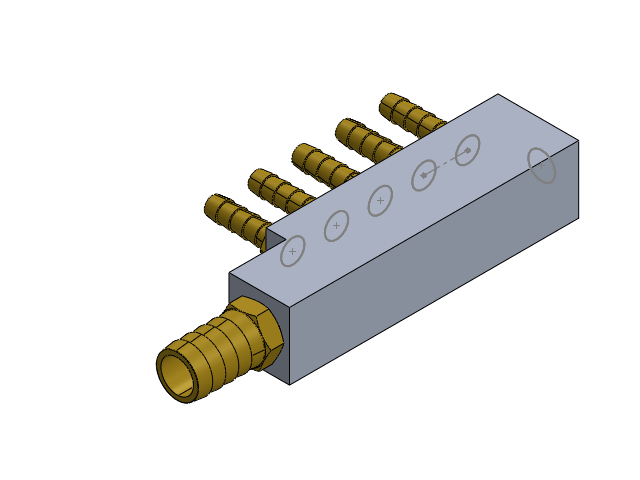
[picture p55: CAD file, 2025-05-03]
Accumulator/Water Cooling/Splitter/5WaySplitter.SLDASM
5waysplitter11.2
5346K13_1-4Hose1-8NPTThreads x 5
5346K65_5-8Hose3-8NPTThreads
