bsobeloffgittes/NFR25-CAD/Accumulator/Water Cooling/Swirl Pot/Swirl Pot Assembly.SLDASM

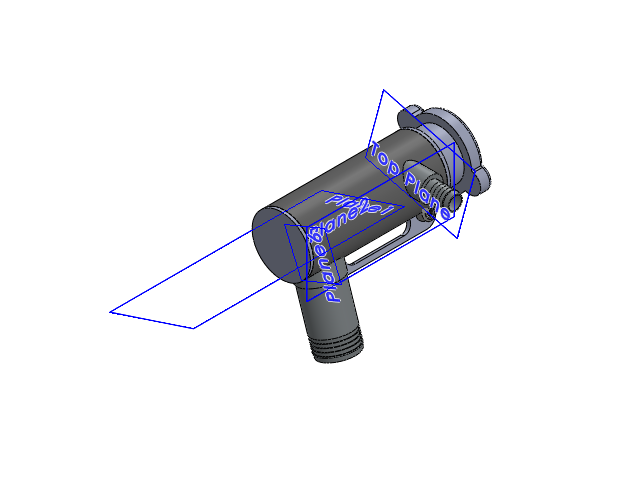
[picture p56: CAD file, 2025-07-06]
Accumulator/Water Cooling/Swirl Pot/Swirl Pot Assembly.SLDASM
Tube
top
bottom
1 barb
3_8 barb
Part2^Swirl Pot Assembly
95105A122_Zinc-Plated Steel Heavy-Duty Rivet Nut x 2
Swirl Pot
tabsnew
