bsobeloffgittes/NFR25-CAD/Aerodynamics/Bodywork/Mold/Routing Layers/Layer_1&2.SLDASM

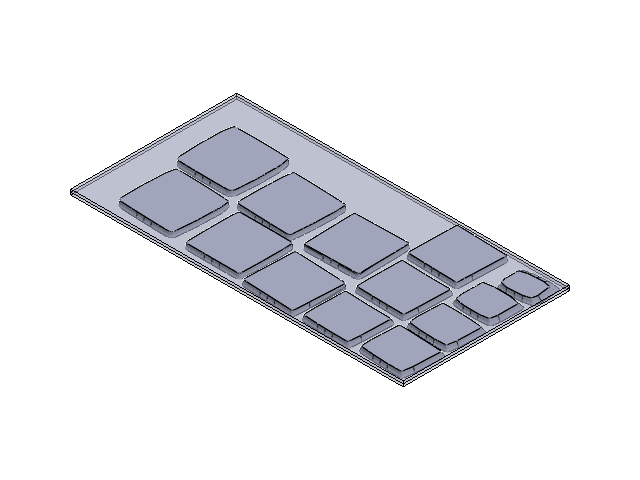
[picture p57: CAD file, 2024-09-24]
Aerodynamics/Bodywork/Mold/Routing Layers/Layer_1&2.SLDASM
MDF_Layer x 2
NS_10
NS_2
NS_3
NS_4
NS_5
NS_6
NS_7
NS_8
NS_9
NS_11
NS_12
NS_13
NS_14
