bsobeloffgittes/NFR25-CAD/Aerodynamics/Bodywork/NFR25_Bodywork.SLDASM

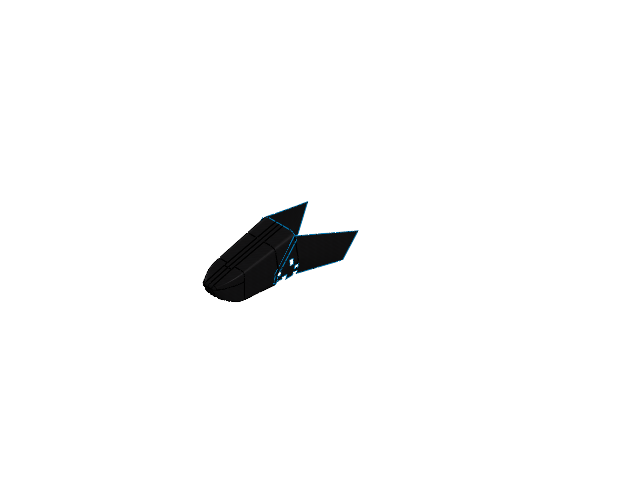
[picture p58: CAD file, 2025-07-06]
Aerodynamics/Bodywork/NFR25_Bodywork.SLDASM
NFR25_Nosecone
NFR25_Side_panels
