bsobeloffgittes/NFR25-CAD/Aerodynamics/CFD Block Model/CFD_Block_Model_All_Aero_NFR25.SLDASM

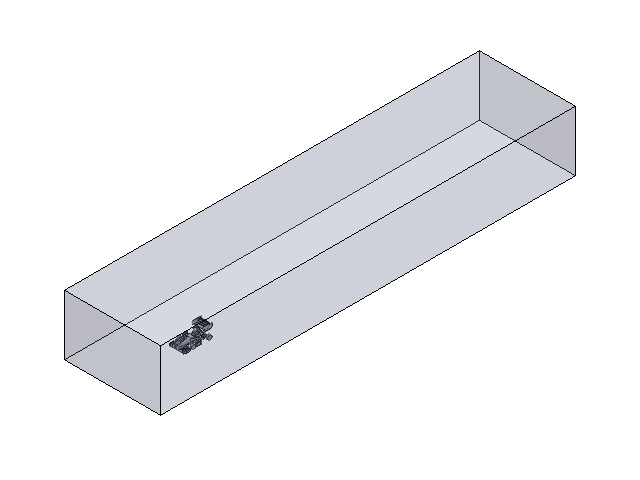
[picture p59: CAD file, 2024-09-06]
Aerodynamics/CFD Block Model/CFD_Block_Model_All_Aero_NFR25.SLDASM
CFD_Block_Model_NFR25
NFR24_Front_Wing
NFR24_Rear_Wing
NFR21_Side_Aero
NFR24_Undertray_Diffuser
NFR25_Straight_Wind_Tunnel
