bsobeloffgittes/NFR25-CAD/Aerodynamics/Composites_One_Carbon_Fiber.SLDASM

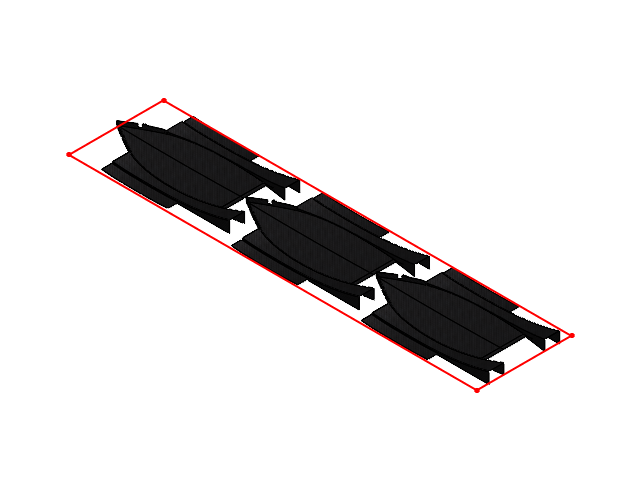
[picture p60: CAD file, 2025-04-03]
Aerodynamics/Composites_One_Carbon_Fiber.SLDASM
Undertray_V10 x 3
