bsobeloffgittes/NFR25-CAD/Aerodynamics/Rear Wing/Active Aero Virtual Rig V2.SLDASM

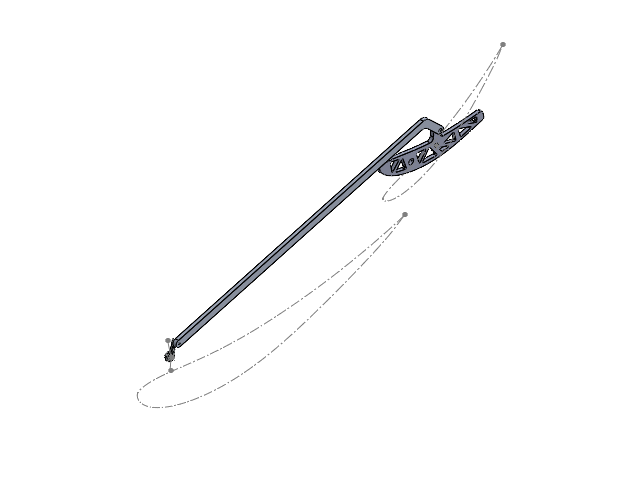
[picture p61: CAD file, 2025-07-06]
Aerodynamics/Rear Wing/Active Aero Virtual Rig V2.SLDASM
RW_SF_Insert_Active_Aero
active_aero_arm_v4
SERVO ARM HORN 25T ALUMINIUM
