bsobeloffgittes/NFR25-CAD/Aerodynamics/Rear Wing/Mounting/NFR25_RearWing_Mounting.SLDASM

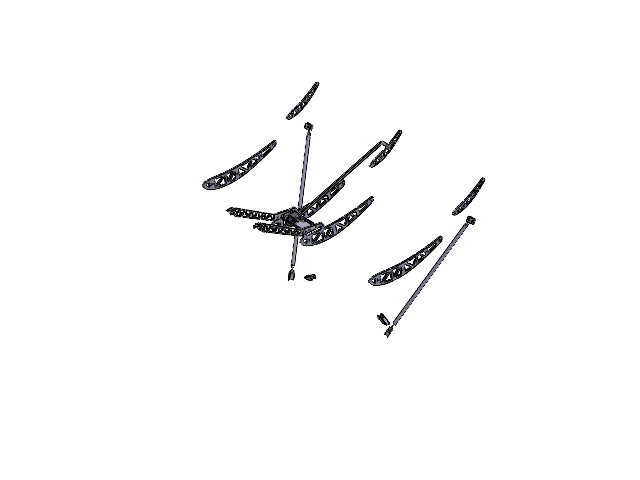
[picture p62: CAD file, 2025-07-06]
Aerodynamics/Rear Wing/Mounting/NFR25_RearWing_Mounting.SLDASM
Insert x 4
AB-4-AuroraBearingC0.-1 x 4
Carbon tube x 2
Swan_Neck x 2
RW_SF_Insert
Bottom Tabs
Aluminum Tabs
Top Tabs
Cable_Pulley_Tabs
servo_motor
Servo_Mount
Servo_brace_v2
SERVO ARM HORN 25T ALUMINIUM
Bottom Tabs Spacer x 4
Active_Aero_Linkages
Top Tabs Spacer x 4
active_aero_arm_v4
