bsobeloffgittes/NFR25-CAD/Aerodynamics/Undertray/Tabs/Undertray_Tab_Location.SLDASM

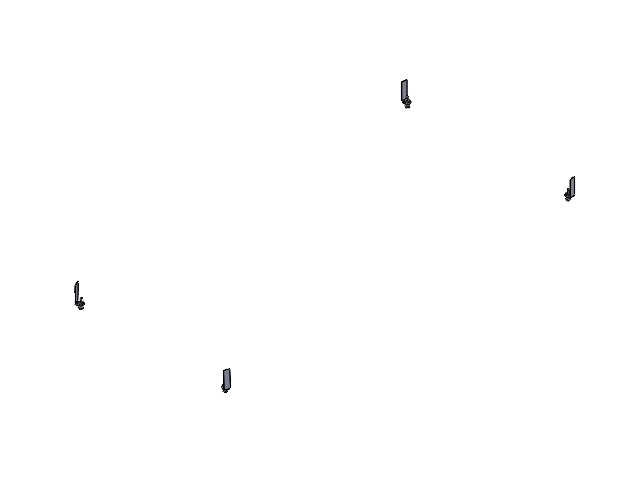
[picture p63: CAD file, 2025-07-06]
Aerodynamics/Undertray/Tabs/Undertray_Tab_Location.SLDASM
Undertray_tab_front x 4
92620A564_Zinc Yellow-Chromate Plated Hex Head Screw x 4
93286A013_Aluminum Washer x 4
95462A505_Medium-Strength Steel Hex Nut x 4
