bsobeloffgittes/NFR25-CAD/Chassis/Baseplate/Baseplate Assembly/Total Baseplate.SLDASM

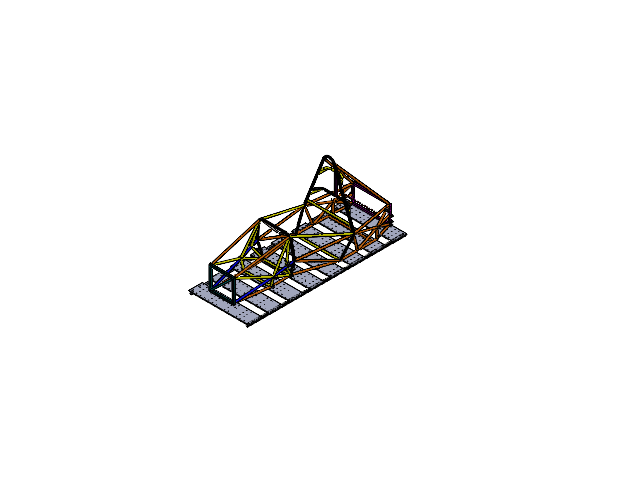
[picture p65: CAD file, 2025-04-03]
Chassis/Baseplate/Baseplate Assembly/Total Baseplate.SLDASM
Slab x 8
SquareRods
1010-S-92-CL
Frame_NFR25
