bsobeloffgittes/NFR25-CAD/Chassis/Dash/Dashbox CAD/Dashbox assembly.SLDASM

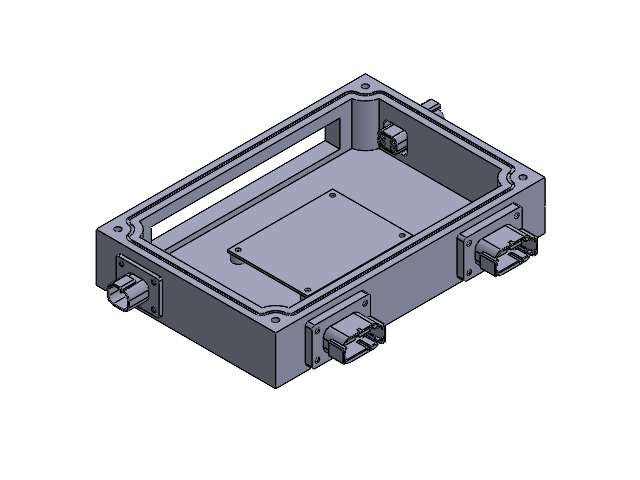
[picture p66: CAD file, 2025-04-03]
Chassis/Dash/Dashbox CAD/Dashbox assembly.SLDASM
Dashbox
12 pin connector x 2
4 pin connector x 2
PCB mockup
