bsobeloffgittes/NFR25-CAD/Chassis/Drivetrain/Motor Sprocket Adapter/MSA_Assembly.SLDASM

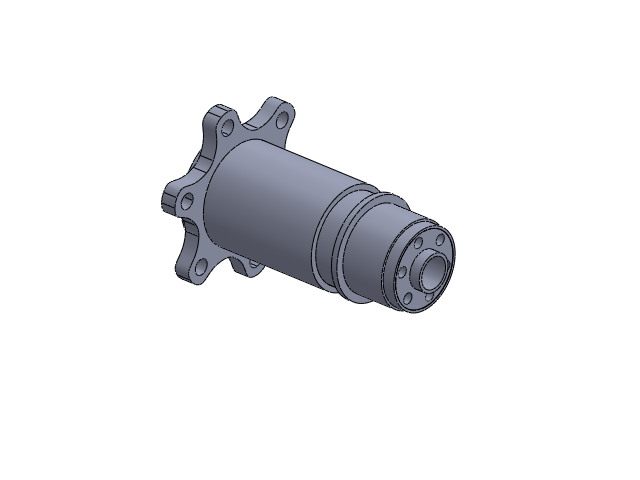
[picture p67: CAD file, 2025-07-06]
Chassis/Drivetrain/Motor Sprocket Adapter/MSA_Assembly.SLDASM
Adapter
MSA Spacer
MSA Sleeve
90117A205_Alloy Steel Wire-Lockable Socket Head Screw x 6
