bsobeloffgittes/NFR25-CAD/Chassis/Jigging/Jigging Assembly.SLDASM

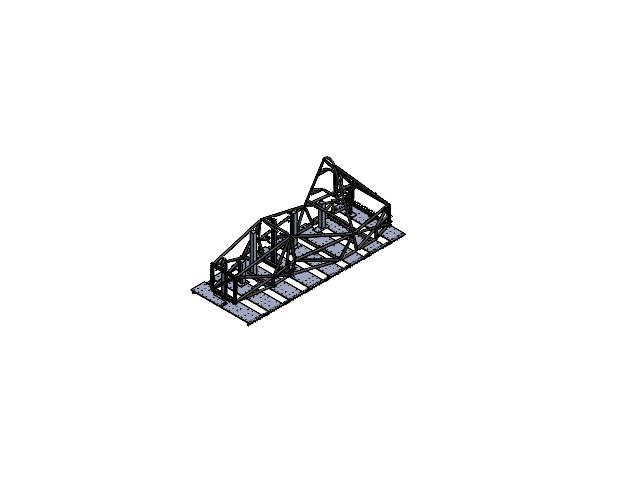
[picture p68: CAD file, 2025-02-05]
Chassis/Jigging/Jigging Assembly.SLDASM
Slab x 8
SquareRods
1010-S-92-CL
Frame_NFR25
Aluminum Extrusion x 7
First Plate^Jigging Assembly
Second Plate^Jigging Assembly
Third Plate^Jigging Assembly
Fourth Plate^Jigging Assembly
Fifth Plate^Jigging Assembly
Sixth Plate^Jigging Assembly
Seventh Plate^Jigging Assembly
FBH Holder^Jigging Assembly
RBH Holder^Jigging Assembly
Tube Holder x 24
Standardized_UBlock x 6
UBlock_Square x 2
1_frame
2_frame
3_frame
4_frame
5_frame
Part13^Jigging Assembly
7_frame 1x1
FBH
front_sus_box_frame
front_roll_hoop_frame
main_floor_frame
RBH
