bsobeloffgittes/NFR25-CAD/Chassis/Pedalbox/Machining/Pedal Machining Assembly.SLDASM

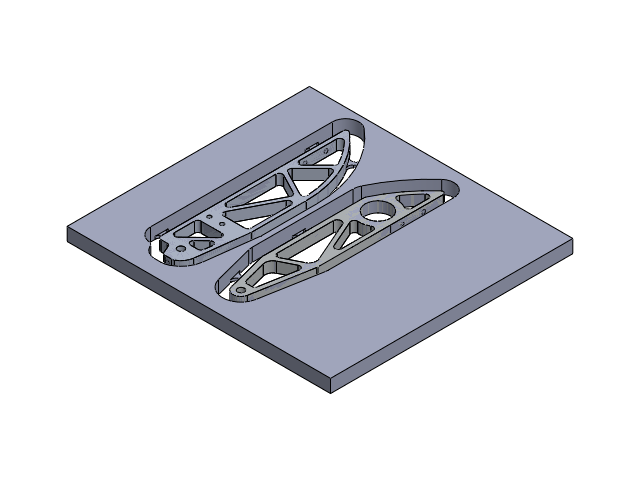
[picture p69: CAD file, 2025-04-03]
Chassis/Pedalbox/Machining/Pedal Machining Assembly.SLDASM
ThrottlePedalArm_Corrected
UpdatedBrakePedalBody
Pedal Stock
