bsobeloffgittes/NFR25-CAD/Electrical/Charger/Charger internals/Internals mounting plate/Internals mounting plate assembly.SLDASM

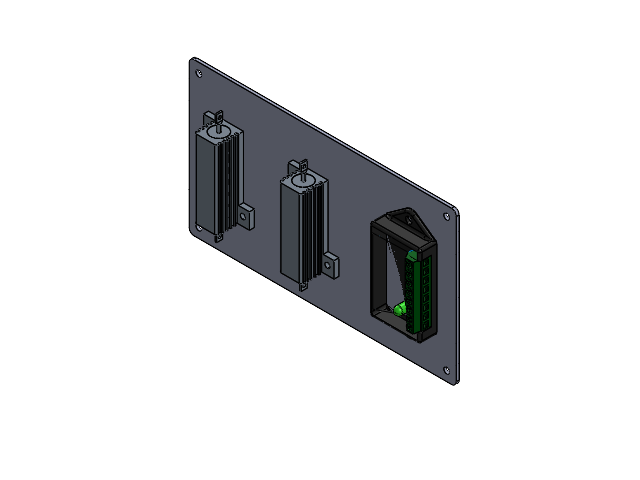
[picture p70: CAD file, 2025-05-01]
Electrical/Charger/Charger internals/Internals mounting plate/Internals mounting plate assembly.SLDASM
charger internals mounting plate
te hsa50 x 2
avc2.r
