bsobeloffgittes/NFR25-CAD/Electrical/Maintenance Panel/_Maintenance_Panel_Assembly_NFR25.SLDASM

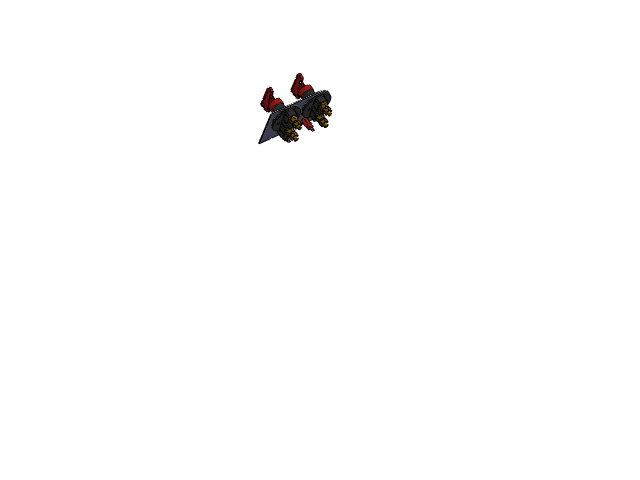
[picture p71: CAD file, 2025-05-02]
Electrical/Maintenance Panel/_Maintenance_Panel_Assembly_NFR25.SLDASM
Maintenance_Panel_NFR25
72913-2_Banana_Jack_Red x 2
72913-0_Banana_Jack_Black
TSMS Circle
GLVMS Circle
Battery Disconnect Switch x 2
