bsobeloffgittes/NFR25-CAD/Suspension/Brakes/MirrorWilwood_GP200.SLDASM

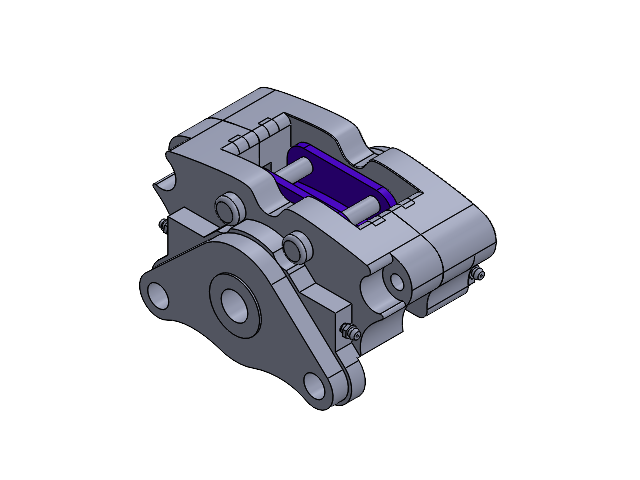
[picture p73: CAD file, 2025-04-03]
Suspension/Brakes/MirrorWilwood_GP200.SLDASM
MirrorBrake Caliper_Corrected
MirrorBrake Caliper 2
MirrorGuide x 2
MirrorPads x 2
MirrorBleed Screw x 4
