bsobeloffgittes/NFR25-CAD/Suspension/Coilovers/Ohlins TTX25 MkII FSAE Shock Assembly.SLDASM

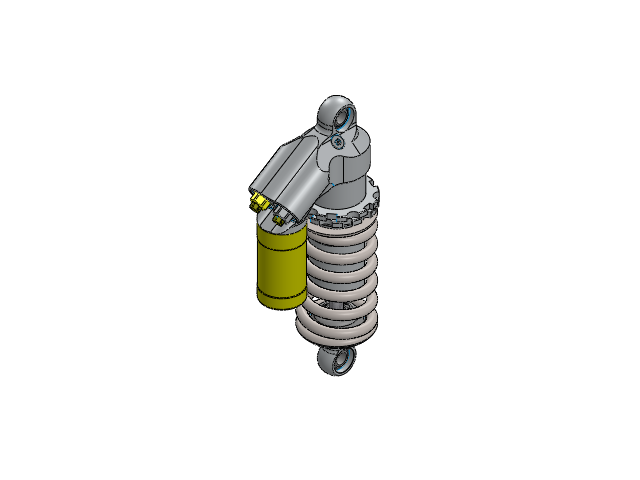
[picture p74: CAD file, 2025-07-06]
Suspension/Coilovers/Ohlins TTX25 MkII FSAE Shock Assembly.SLDASM
Ohlins TTX25 MkII FSAE Shock Upper
Ohlins TTX25 MkII FSAE Shock Lower
Ohlin FSAE Shock Spring
