bsobeloffgittes/NFR25-CAD/Suspension/Rockers/Rear Rockers/Reference_Rocker and Arm Assem.SLDASM

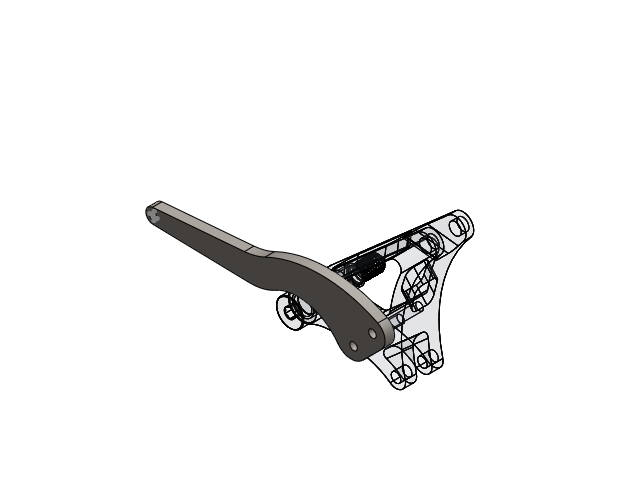
[picture p75: CAD file, 2025-05-22]
Suspension/Rockers/Rear Rockers/Reference_Rocker and Arm Assem.SLDASM
Rear_Rocker_ARB_Arm
Rear_Rocker_For_Arm_Reference
92981A415_Alloy Steel Shoulder Screws
