bsobeloffgittes/NFR25-CAD/Suspension/Rockers/Rockers CNC/Rockers billet assembly.SLDASM

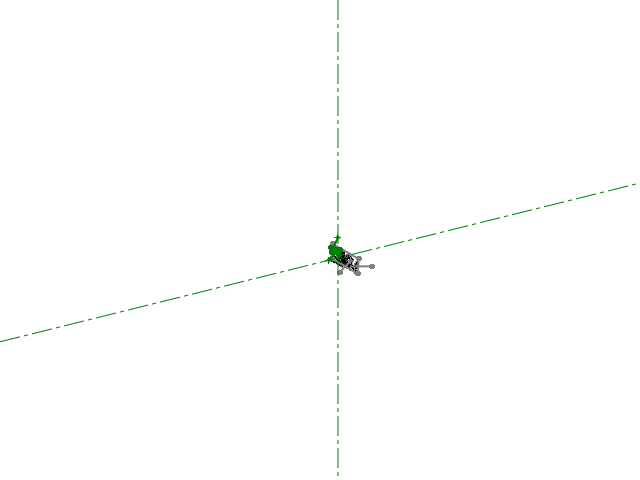
[picture p76: CAD file, 2024-10-28]
Suspension/Rockers/Rockers CNC/Rockers billet assembly.SLDASM
Front Rockers x 2
Rear Rockers V3 x 2
