bsobeloffgittes/NFR25-CAD/Suspension/Steering/Ruland_US12-6-6-F/Ruland_us12-6-f.SLDASM

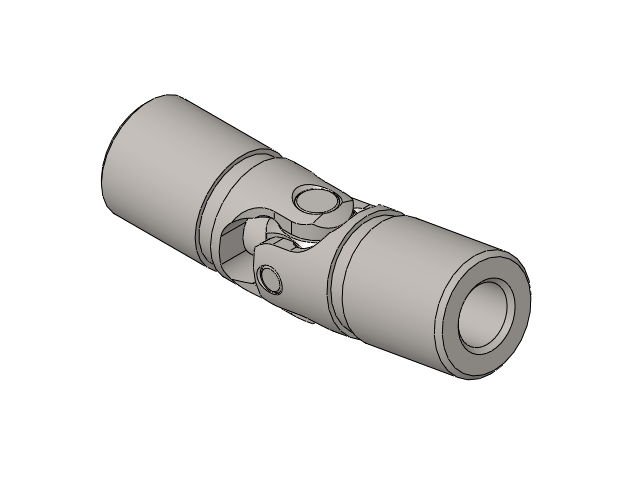
[picture p77: CAD file, 2025-02-05]
Suspension/Steering/Ruland_US12-6-6-F/Ruland_us12-6-f.SLDASM
Ruland_Y750 YOKES_Y6X6-LH
Ruland_HD-2A HD SERIES BLOCK_750-2A
Ruland_HD-3A HD SERIES SMALL PIN_750-3A
Ruland_HD-5A HD SERIES LARGE PIN_750-5A
Ruland_Y750 YOKES_Y6X6-SH
