bsobeloffgittes/NFR25-CAD/Suspension/Steering/Steering Wheel Assembly.SLDASM

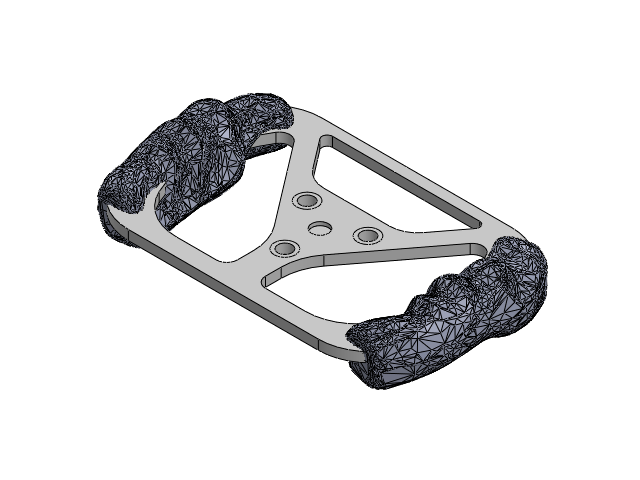
[picture p78: CAD file, 2025-05-05]
Suspension/Steering/Steering Wheel Assembly.SLDASM
Steering Wheel Plate
Steering_Wheel_Grip x 2
