bsobeloffgittes/NFR25-CAD/Vehicle Integration/Tabs for manufacturing/125 tabs/0.125 tabs assem.SLDASM

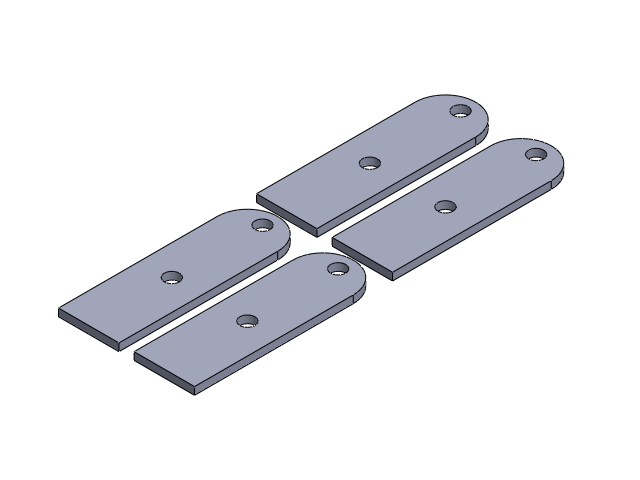
[picture p79: CAD file, 2025-04-03]
Vehicle Integration/Tabs for manufacturing/125 tabs/0.125 tabs assem.SLDASM
4X---New_Rear_ARB_Tab x 4
