bsobeloffgittes/NFR25-CAD/Accumulator/Penthouse/penthouse box/Penthouse_internals.SLDASM

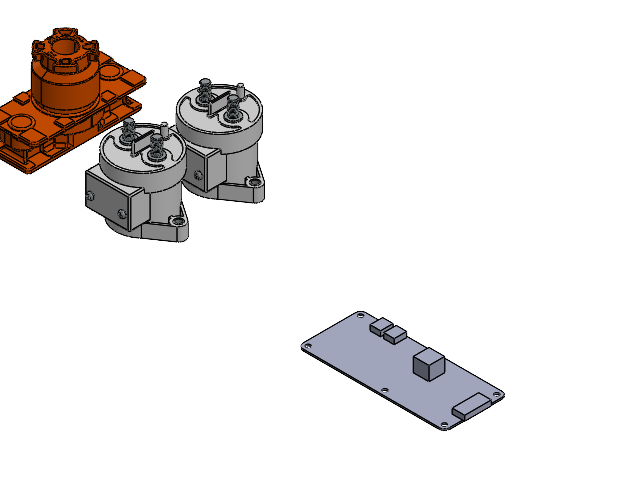
[picture p80: CAD file, 2024-10-17]
Accumulator/Penthouse/penthouse box/Penthouse_internals.SLDASM
iso175_IMD
ev200a_KILOVAC-Contactor-500+Amps-12-900VDC x 2
