bsobeloffgittes/NFR25-CAD/Accumulator/Segments/Cell Characterization/cell char holder assembly.SLDASM

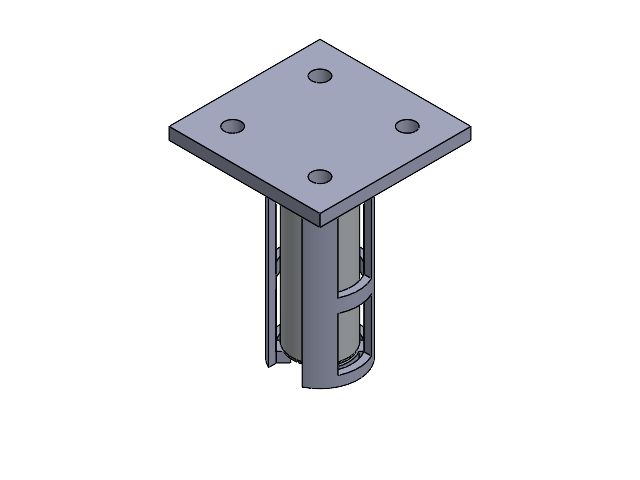
[picture p81: CAD file, 2025-02-08]
Accumulator/Segments/Cell Characterization/cell char holder assembly.SLDASM
cell char holder
Molicel21700
cell char base plate
