bsobeloffgittes/NFR25-CAD/Accumulator/Segments/Maintenance Plugs and Busbars/Intersegment Maintenance Plugs/Female_Maintenance_Plug_Assembly.SLDASM

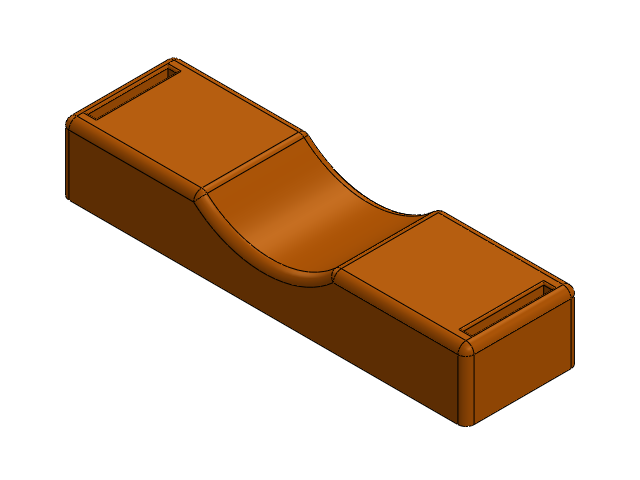
[picture p82: CAD file, 2025-02-15]
Accumulator/Segments/Maintenance Plugs and Busbars/Intersegment Maintenance Plugs/Female_Maintenance_Plug_Assembly.SLDASM
FemaleMPBusbar
2043130010_FemaleMolex x 2
Female_Maintenance_Plug_Cover
FemaleMPBottomCover
