bsobeloffgittes/NFR25-CAD/Accumulator/Segments/Segment Assemblies/OneSegTopNegative.SLDASM

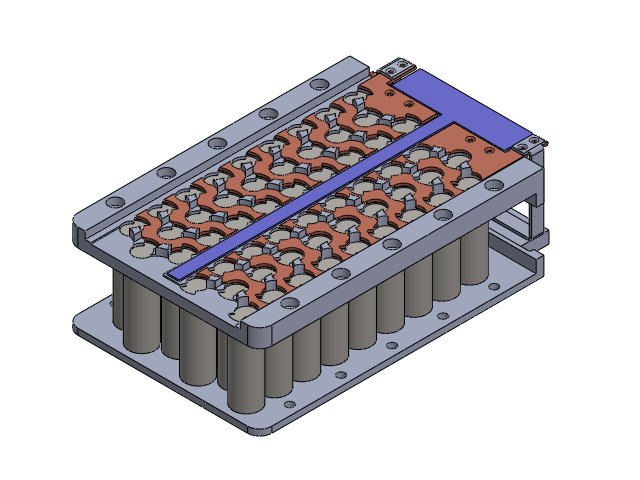
[picture p83: CAD file, 2024-08-12]
Accumulator/Segments/Segment Assemblies/OneSegTopNegative.SLDASM
TopCellHolder
BottomCellHolder
CellExample x 54
MockSensePCB
maleMolexMP x 2
MasterPositiveSM
MasterNegativeSM
topBusbar
bottomBusbar
CellBusbarTemplate x 16
