bsobeloffgittes/NFR25-CAD/Accumulator/Water Cooling/Splitter/Cylindrical splitter (iteration 2)/cylindrical splitter assembly.SLDASM

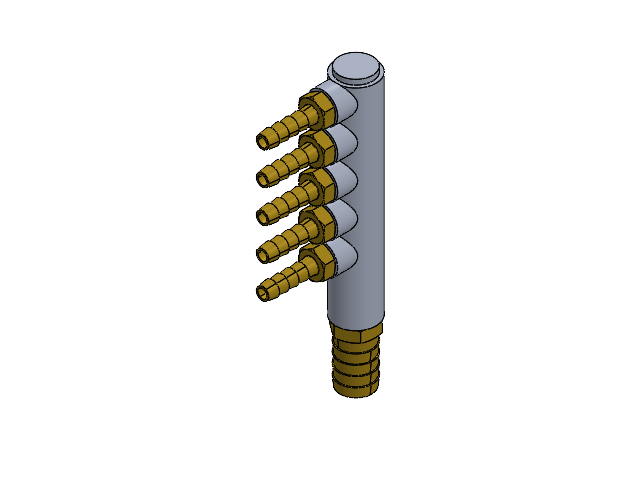
[picture p84: CAD file, 2025-01-15]
Accumulator/Water Cooling/Splitter/Cylindrical splitter (iteration 2)/cylindrical splitter assembly.SLDASM
splitter cylindrical body
5346K65_5-8Hose3-8NPTThreads
5346K13_1-4Hose1-8NPTThreads x 5
