bsobeloffgittes/NFR25-CAD/Aerodynamics/Bodywork/Mold/Routing Layers/Layer_5&6.SLDASM

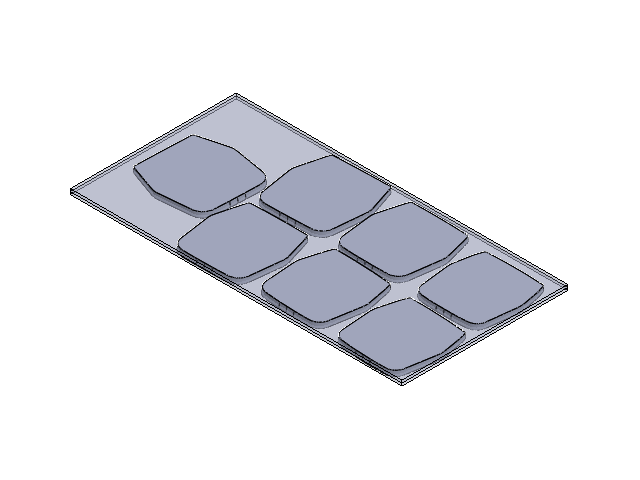
[picture p85: CAD file, 2024-09-24]
Aerodynamics/Bodywork/Mold/Routing Layers/Layer_5&6.SLDASM
MDF_Layer x 2
NS_23
NS_24
NS_25
NS_26
NS_27
NS_28
NS_29
