bsobeloffgittes/NFR25-CAD/Aerodynamics/Bodywork/Tabs/Bodywork Tabs.SLDASM

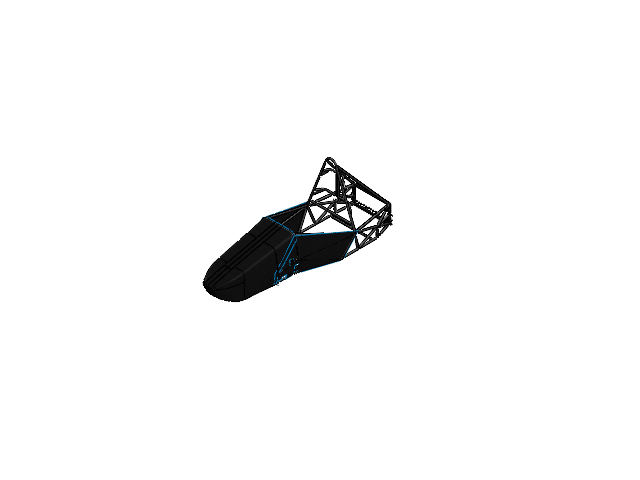
[picture p86: CAD file, 2025-04-03]
Aerodynamics/Bodywork/Tabs/Bodywork Tabs.SLDASM
Frame_NFR25
NFR25_Nosecone
NFR25_Side_panels
