bsobeloffgittes/NFR25-CAD/Aerodynamics/NFR25_Aero.SLDASM

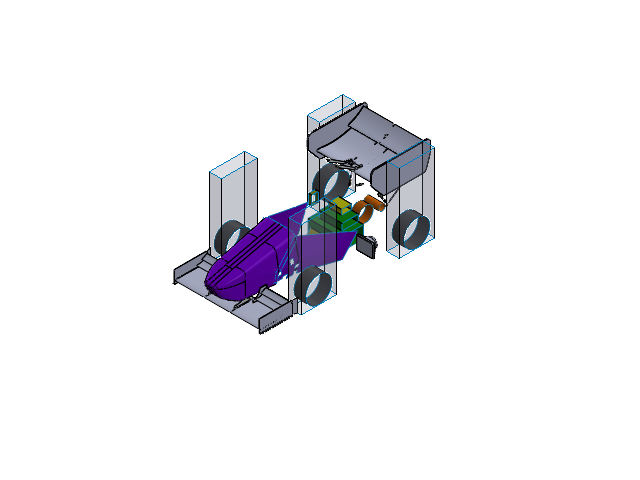
[picture p87: CAD file, 2024-11-26]
Aerodynamics/NFR25_Aero.SLDASM
_Block_Model_NFR25
NFR25 Aero Limits
NFR25_Nosecone
NFR25_Side_panels
NFR25_Radiator
NFR25_RearWing_DONOTCHANGEhigh_aoa x 2
Active_Aero_Linkages
Insert x 4
AB-4-AuroraBearingC0.-1 x 3
Carbon tube x 2
Swan_Neck x 2
NFR25_RearWing_Inserts
Bottom Tabs
Aluminum Tabs
Top Tabs
Cable_Pulley_Tabs
Pulley_Body x 2
Pulley_Eye x 2
servo_motor
Servo_Mount
Servo_Brace
NFR_25_FrontWing_Insert
NFR_25_FrontWing_V2 (drew)
NFR_25_FrontWing_Top_Mount
NFR_25_FrontWing_Tabs
