bsobeloffgittes/NFR25-CAD/Aerodynamics/Rear Wing/Mounting/Carbon tube assembly.SLDASM

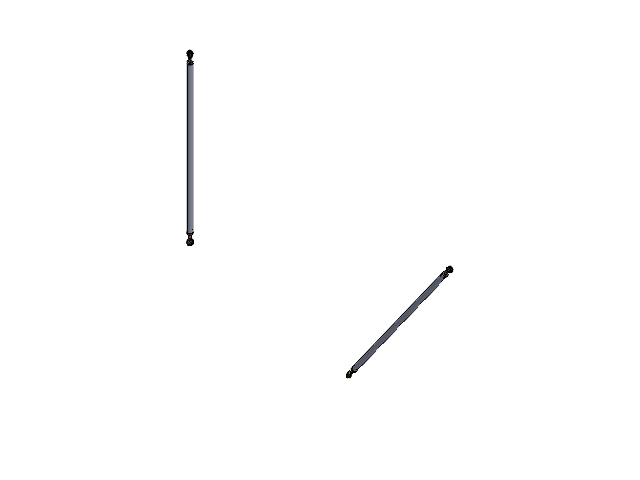
[picture p88: CAD file, 2025-07-06]
Aerodynamics/Rear Wing/Mounting/Carbon tube assembly.SLDASM
Insert x 4
AB-4-AuroraBearingC0.-1 x 4
Carbon tube x 2
