bsobeloffgittes/NFR25-CAD/Chassis/Baseplate/Baseplate Assembly/Only Baseplate.SLDASM

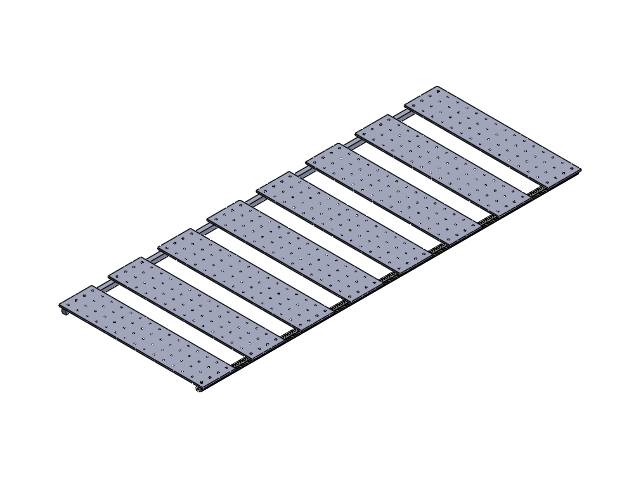
[picture p89: CAD file, 2024-11-20]
Chassis/Baseplate/Baseplate Assembly/Only Baseplate.SLDASM
Slab x 8
SquareRods
1010-S-92-CL
91290A148_Alloy Steel Socket Head Screw (1)
