bsobeloffgittes/NFR25-CAD/Chassis/Drivetrain/MotorDiffAssembly_24(Reference)/xcadmodel-r1132100926407-00035150.sldasm

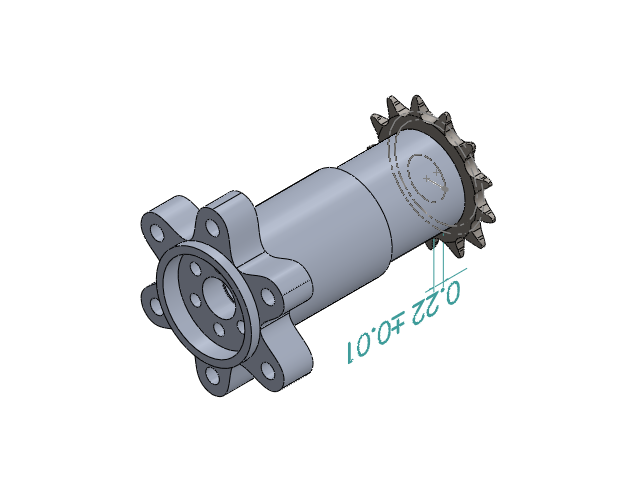
[picture p90: CAD file, 2024-10-28]
Chassis/Drivetrain/MotorDiffAssembly_24(Reference)/xcadmodel-r1132100926407-00035150.sldasm
Motor_Sprocket_Adapter_V.2_NFR24 - Copy
Motor_Sprocket_V.2_NFR24
Motor_Sprocket_Adapter_Spacer_V2.0_NFR24
