bsobeloffgittes/NFR25-CAD/Chassis/Pedalbox/OTS parts - Brake/Balance Bar/72-260 .4375 BALANCE BAR, 10-20-2014.SLDASM

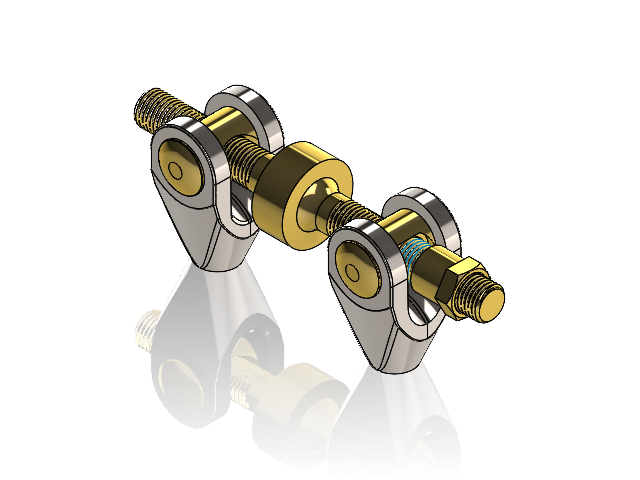
[picture p91: CAD file, 2024-09-08]
Chassis/Pedalbox/OTS parts - Brake/Balance Bar/72-260 .4375 BALANCE BAR, 10-20-2014.SLDASM
