bsobeloffgittes/NFR25-CAD/Suspension/Anti-Roll Bar/AM-3 Motion.SLDASM

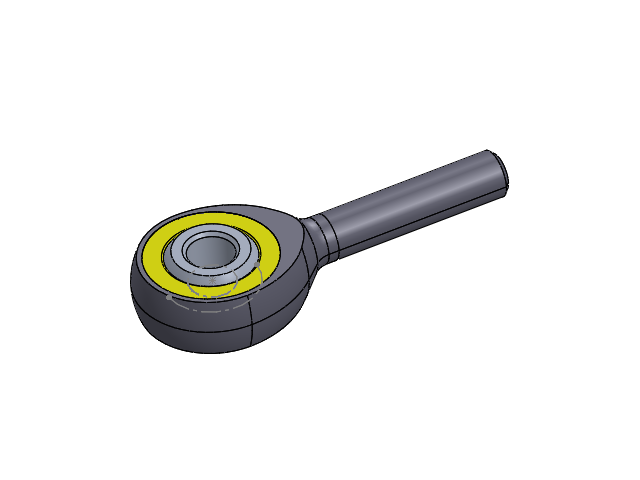
[picture p92: CAD file, 2025-04-03]
Suspension/Anti-Roll Bar/AM-3 Motion.SLDASM
AM-3
AM-3 Spherical
