bsobeloffgittes/NFR25-CAD/Suspension/Anti-Roll Bar/New_Rear_ARB/Rear_ARB_Right_Mount.SLDASM

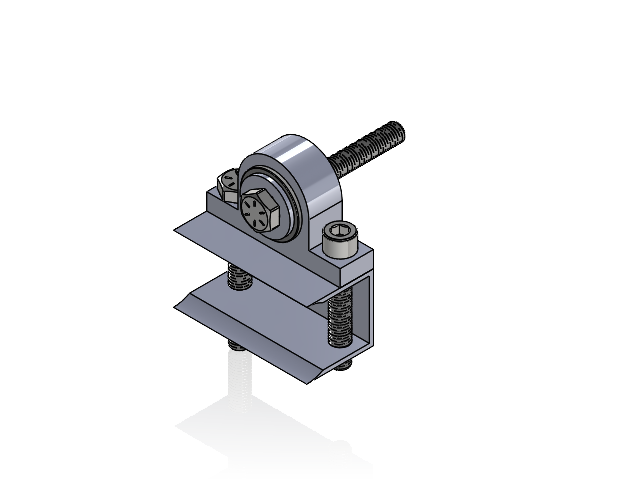
[picture p93: CAD file, 2025-05-22]
Suspension/Anti-Roll Bar/New_Rear_ARB/Rear_ARB_Right_Mount.SLDASM
New_Front_ARBMount
Front_arb_bearing_6338K572_Oil-Embedded Flanged Sleeve Bearing x 2
New_Front_ARB_Sleeve
