bsobeloffgittes/NFR25-CAD/Suspension/Hub Motors/R&D Assembly.SLDASM

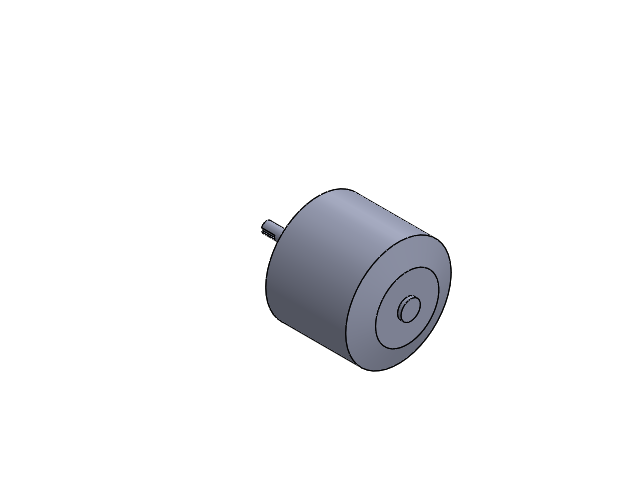
[picture p94: CAD file, 2025-05-22]
Suspension/Hub Motors/R&D Assembly.SLDASM
25KW MOTOR MA-3D
Motor Mount
