bsobeloffgittes/NFR25-CAD/Vehicle Integration/Tabs for manufacturing/250 tabs/0.25 tabs assem.SLDASM

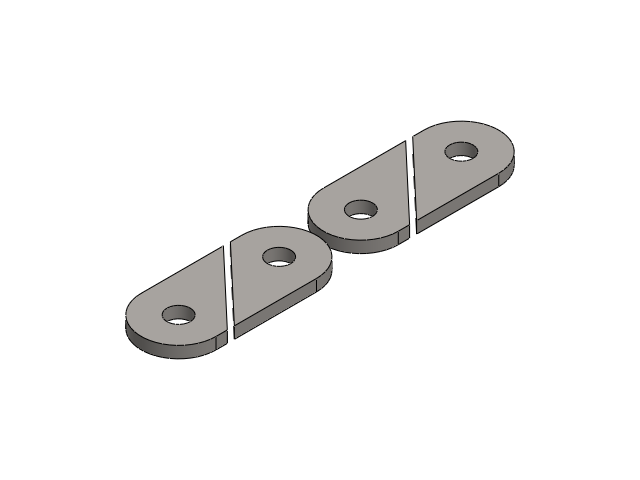
[picture p95: CAD file, 2025-04-03]
Vehicle Integration/Tabs for manufacturing/250 tabs/0.25 tabs assem.SLDASM
4X---Lap Belt Tab x 4
