bsobeloffgittes/NFR25-CAD/Accumulator/Segment Container/Container/Latches/Southco-TL-20-102-52.sldasm

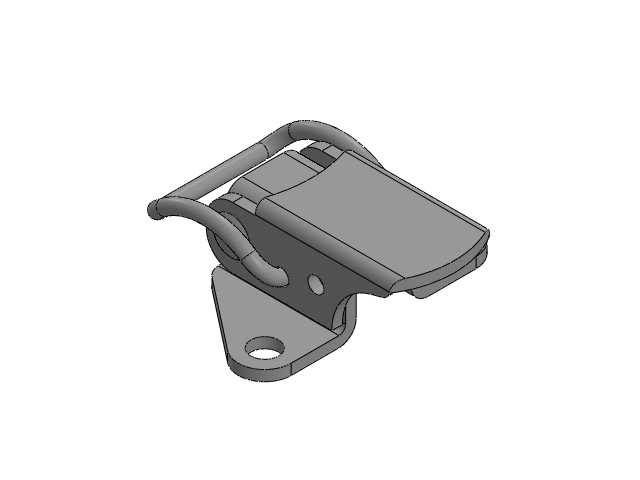
[picture p96: CAD file, 2024-12-11]
Accumulator/Segment Container/Container/Latches/Southco-TL-20-102-52.sldasm
Southco-TL-20-102-52_SW3dPS-TL-20-102-07_TL_BASE_clf
Southco-TL-20-102-52_TL-20-102-52.sldasm-Part-1
Southco-TL-20-102-52_SW3dPS-TL-20-102-07_TL_RIVET_clf
Southco-TL-20-102-52_SW3dPS-TL-20-102-07_TL LEVER_clf
