bsobeloffgittes/NFR25-CAD/Accumulator/Segments/Segment Assemblies/TwoSegments.SLDASM

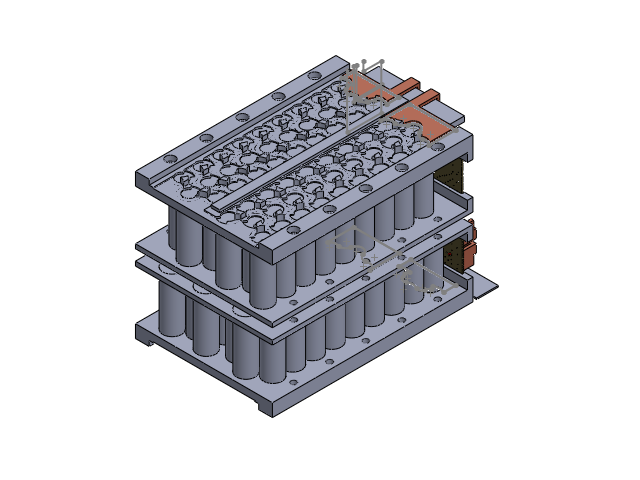
[picture p97: CAD file, 2024-08-07]
Accumulator/Segments/Segment Assemblies/TwoSegments.SLDASM
TopCellHolder x 2
BottomCellHolder x 2
CellExample x 108
Board.step x 2
0.47uF.step x 178
DF11-4DP-2DSA(24).step x 6
ESDAVLC6-2BLY.step x 4
PBQ79656PAPTQ1.step x 4
10.step x 108
PBHV8115X, 115.step x 4
TPB2,54.step x 4
87606-315LF.step x 4
SMD1,27-2,54.step x 4
10_1.step x 40
