bsobeloffgittes/NFR25-CAD/Aerodynamics/Bodywork/Mold/Routing Layers/Layer_3&4.SLDASM

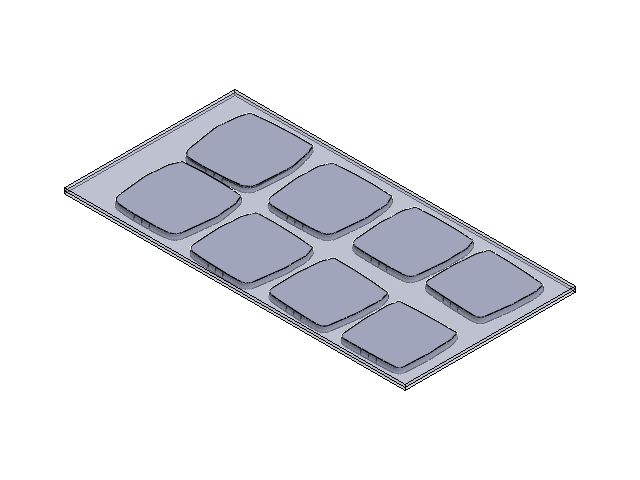
[picture p98: CAD file, 2024-09-24]
Aerodynamics/Bodywork/Mold/Routing Layers/Layer_3&4.SLDASM
MDF_Layer x 2
NS_15
NS_16
NS_17
NS_18
NS_19
NS_20
NS_21
NS_22
