bsobeloffgittes/NFR25-CAD/Aerodynamics/Front Wing/wind tunnel/Wind Tunnel Assembly.SLDASM

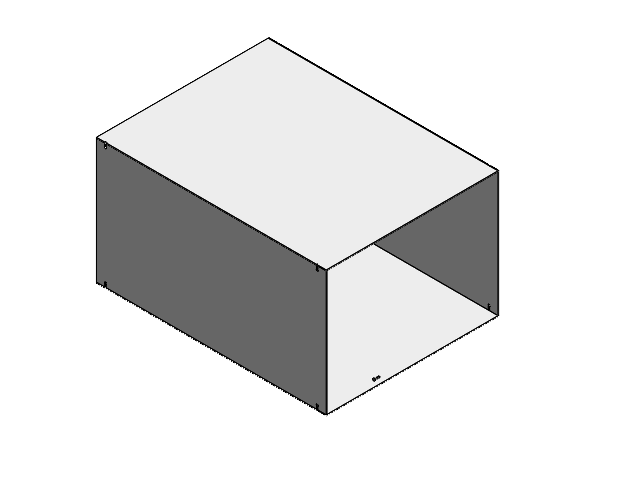
[picture p99: CAD file, 2025-02-27]
Aerodynamics/Front Wing/wind tunnel/Wind Tunnel Assembly.SLDASM
Sides x 2
Top & bottom x 2
92356A261_18-8 Stainless Steel Square-Neck Carriage Bolt
