bsobeloffgittes/NFR25-CAD/Aerodynamics/Rear Wing/Mounting/Active_Aero_Mounting.SLDASM

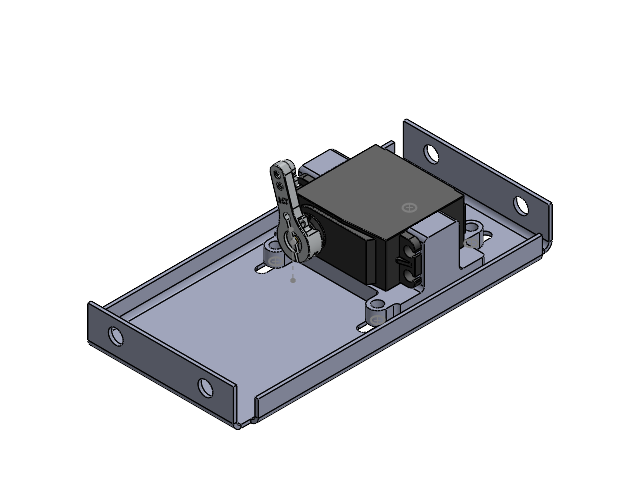
[picture p100: CAD file, 2025-07-06]
Aerodynamics/Rear Wing/Mounting/Active_Aero_Mounting.SLDASM
servo_motor
Servo_Mount
Servo_brace_v2
SERVO ARM HORN 25T ALUMINIUM
