bsobeloffgittes/NFR25-CAD/Aerodynamics/Waterjetting/Plate_23in_10in.SLDASM

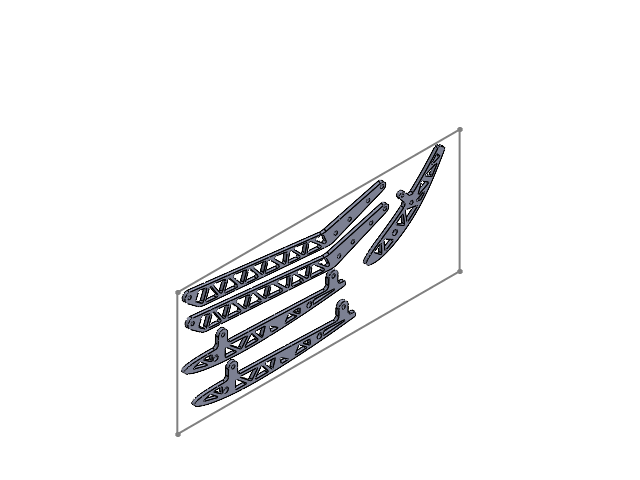
[picture p101: CAD file, 2025-02-28]
Aerodynamics/Waterjetting/Plate_23in_10in.SLDASM
RW_Swan_Neck.step x 2
RW_SF_Insert.step
FW_MF_Insert.step x 2
