bsobeloffgittes/NFR25-CAD/Chassis/Dash/V1/Dashboard CAD/screen-cad/assembly.SLDASM

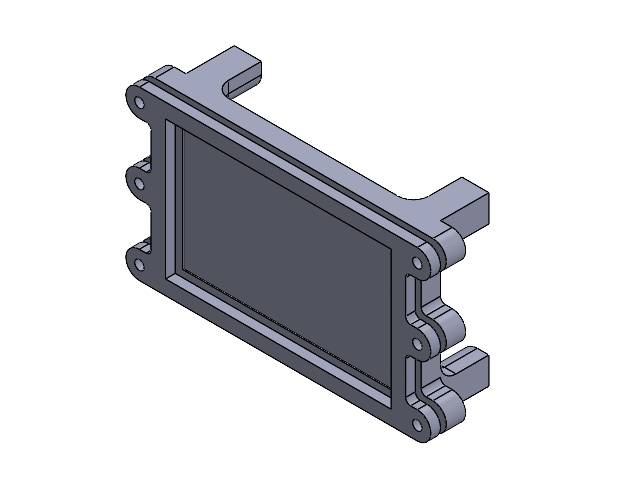
[picture p102: CAD file, 2025-03-01]
Chassis/Dash/V1/Dashboard CAD/screen-cad/assembly.SLDASM
5in-display
top-plate
base
standoff x 4
board
