bsobeloffgittes/NFR25-CAD/Electrical/LV Battery/Yay!/lv_layout.SLDASM

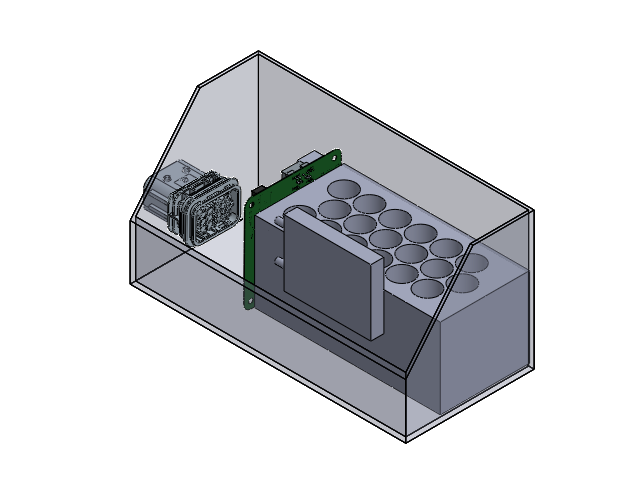
[picture p103: CAD file, 2025-02-05]
Electrical/LV Battery/Yay!/lv_layout.SLDASM
LV_Battery_Testing
lv_cell_block
PDM
LV_main-connector
bms_block
