bsobeloffgittes/NFR25-CAD/Electrical/Safety Lights Enclosure/RML Enclosure Assembly.SLDASM

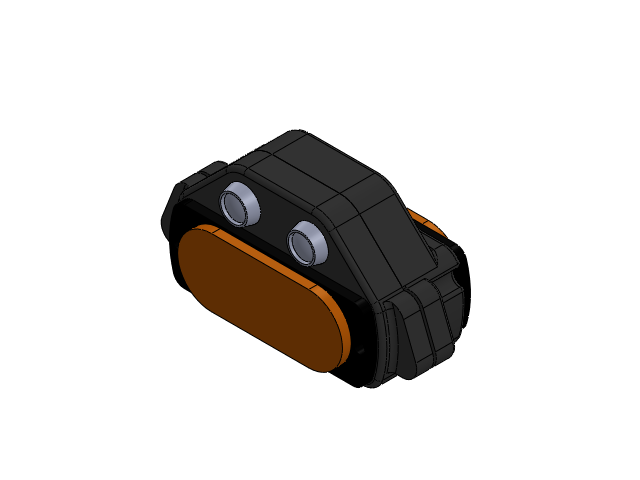
[picture p104: CAD file, 2025-04-21]
Electrical/Safety Lights Enclosure/RML Enclosure Assembly.SLDASM
Ready to Move Light x 2
Safety Status Indicator x 2
RML TSSI Enclosure
