bsobeloffgittes/NFR25-CAD/Suspension/Anti-Roll Bar/New_Rear_ARB/New_Rear_ARB.SLDASM

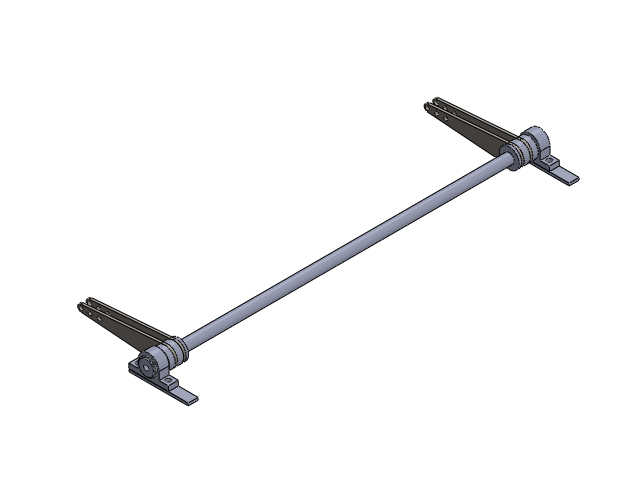
[picture p105: CAD file, 2025-05-22]
Suspension/Anti-Roll Bar/New_Rear_ARB/New_Rear_ARB.SLDASM
New_Rear_ARB_Delrin_Spacer x 2
New_Rear_ARB_Steel_Inster x 2
New_Front_ARBMount x 2
Front_arb_bearing_6338K572_Oil-Embedded Flanged Sleeve Bearing x 4
New_Front_ARB_Sleeve x 2
Rear_ARB_Torsion_Bar
Rear_ARB_Tab x 2
New_Rear_ARB_Lever x 4
Part2^New_Rear_ARB
New_Rear_ARB_Cyl_Delrin_Spacer x 2
