bsobeloffgittes/NFR25-CAD/Suspension/Arms/Front_Lower_Arm_Assembly_NFR25.SLDASM

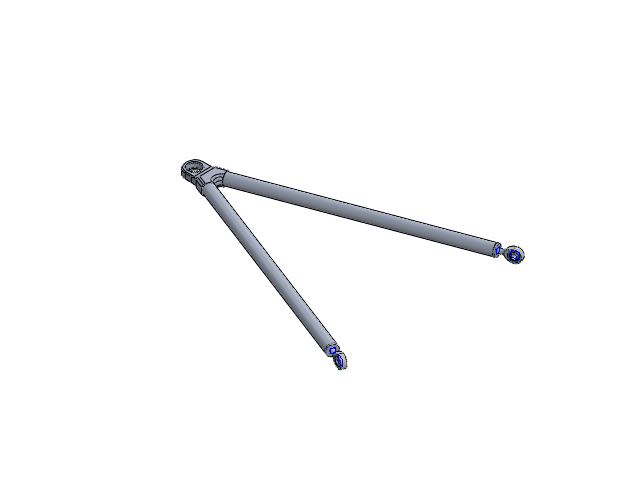
[picture p106: CAD file, 2025-04-03]
Suspension/Arms/Front_Lower_Arm_Assembly_NFR25.SLDASM
AM-4T x 2
wishbone_end_front_lower_nfr25
0.625x0.5 insert x 2
CF Tube 1^Front_Lower_Arm_Assembly_NFR25
CF Tube 2^Front_Lower_Arm_Assembly_NFR25
