bsobeloffgittes/NFR25-CAD/Vehicle Integration/remodeled/pedalbox_throttle.SLDASM

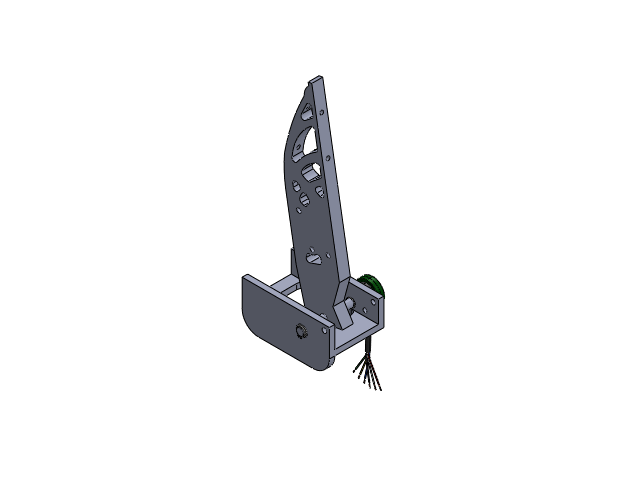
[picture p108: CAD file, 2025-02-08]
Vehicle Integration/remodeled/pedalbox_throttle.SLDASM
throttle_baseplate
ThrottlePedalBody
6659K222_Oil-Embedded 841 Bronze Flanged Sleeve Bearing x 2
Euro-XPD-2832-836-214-911-00.STEP
98541A116_External Retaining Ring
throttle_shaft
