bsobeloffgittes/NFR25-CAD/Vehicle Integration/Tabs for manufacturing/0625 tabs/0.0625 tabs pt5.SLDASM

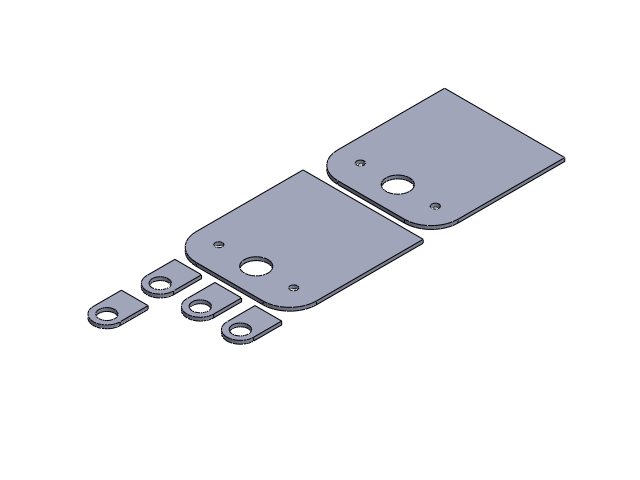
[picture p109: CAD file, 2025-04-21]
Vehicle Integration/Tabs for manufacturing/0625 tabs/0.0625 tabs pt5.SLDASM
4X---Dashboard_Tab_NFR25 x 4
Bodywork Tab x 2
