bsobeloffgittes/NFR25-CAD/Accumulator/Mounts/Container in frame.SLDASM

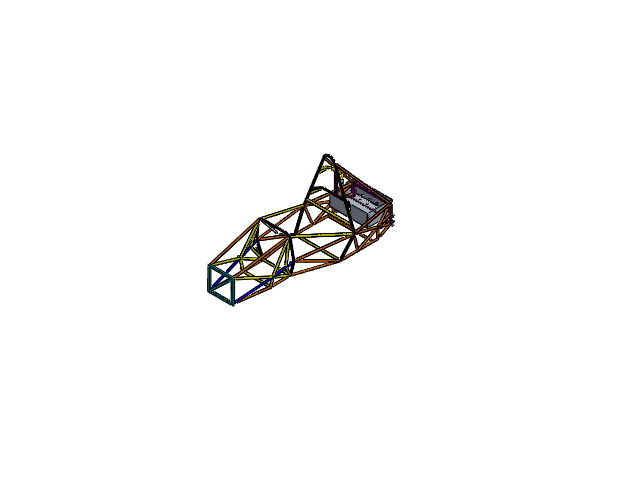
[picture p110: CAD file, 2024-10-17]
Accumulator/Mounts/Container in frame.SLDASM
Frame_NFR25
Accumulator_Container_OnePiece
