bsobeloffgittes/NFR25-CAD/Accumulator/Mounts/Mounts Parts & Assemblies/Rear_Mount_Assembly.SLDASM

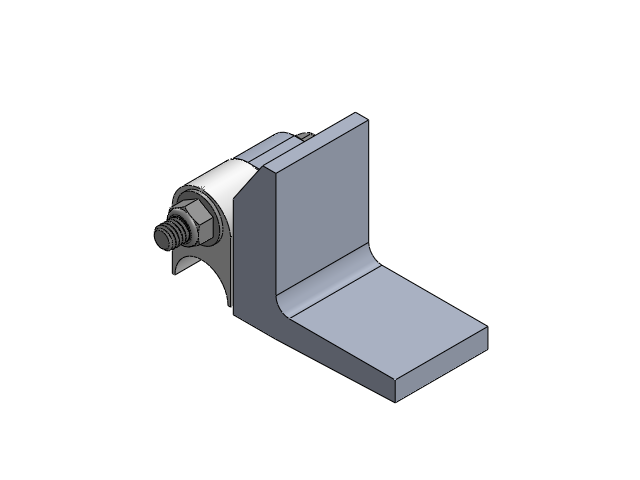
[picture p111: CAD file, 2025-02-05]
Accumulator/Mounts/Mounts Parts & Assemblies/Rear_Mount_Assembly.SLDASM
Rear_Chassis_Mount
Rear_Accumulator_Mount
93298A130_Medium-Strength Steel Nylon-Insert Flange Locknut
90409A138_High-Strength Grade 8 Steel Hex Head Screw
