bsobeloffgittes/NFR25-CAD/Accumulator/Segments/8 Segment Design/Assemblies/OneSegmentTemplate.SLDASM

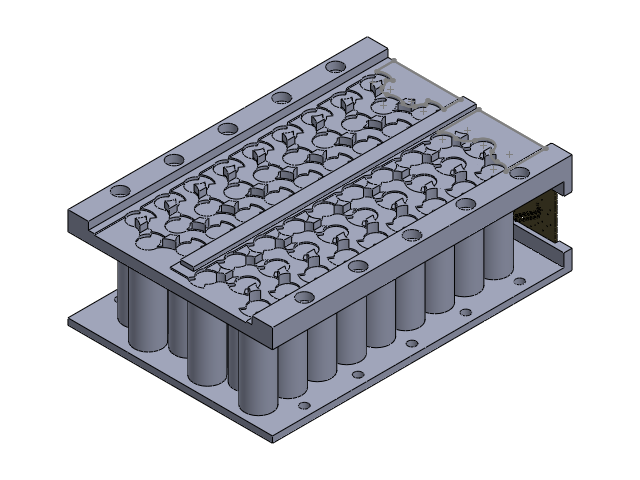
[picture p112: CAD file, 2024-08-08]
Accumulator/Segments/8 Segment Design/Assemblies/OneSegmentTemplate.SLDASM
TopCellHolder
BottomCellHolder
CellExample x 54
Board.step
0.47uF.step x 89
DF11-4DP-2DSA(24).step x 3
ESDAVLC6-2BLY.step x 2
PBQ79656PAPTQ1.step x 2
10.step x 54
PBHV8115X, 115.step x 2
TPB2,54.step x 2
87606-315LF.step x 2
SMD1,27-2,54.step x 2
10_1.step x 20
