bsobeloffgittes/NFR25-CAD/Accumulator/Segments/8 Segment Design/Practice Cell Holders/PracticeSegmentAssembly.SLDASM

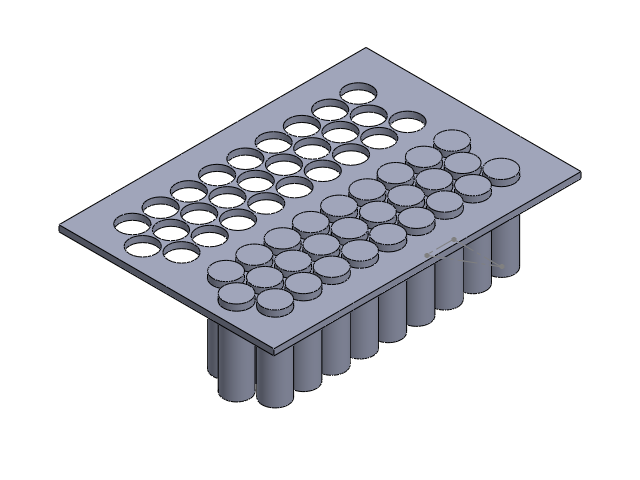
[picture p113: CAD file, 2024-07-14]
Accumulator/Segments/8 Segment Design/Practice Cell Holders/PracticeSegmentAssembly.SLDASM
CellExample x 27
PracticeCellHolder
