bsobeloffgittes/NFR25-CAD/Aerodynamics/Front Wing/Front_Wing_Assembly.SLDASM

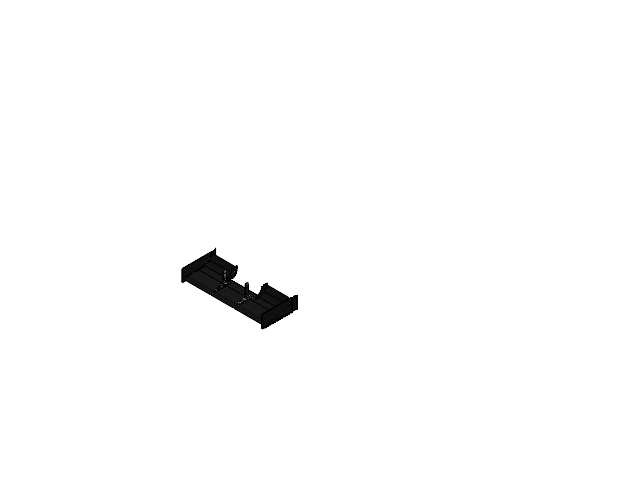
[picture p114: CAD file, 2025-04-03]
Aerodynamics/Front Wing/Front_Wing_Assembly.SLDASM
NFR_25_FrontWing_Insert
NFR_25_FrontWing_V2 (drew)
NFR_25_FrontWing_Top_Mount
NFR_25_FrontWing_Tabs
94459A340_Heat-Set Inserts for Plastic x 22
Structural Tube x 2
TopFoilInsert
MidFoilInsert
91255A027_Button Head Hex Drive Screw x 22
98019A226_18-8 Stainless Steel Mil. Spec. Washer x 8
90631A411_Low-Strength Steel Nylon-Insert Locknut x 8
90128A944_Zinc-Plated Alloy Steel Socket Head Screw x 4
92562A143_Mil. Spec. Alloy Steel Socket Head Screw x 4
