bsobeloffgittes/NFR25-CAD/Aerodynamics/Rear Wing/Mounting/twoSwanNecks.SLDASM

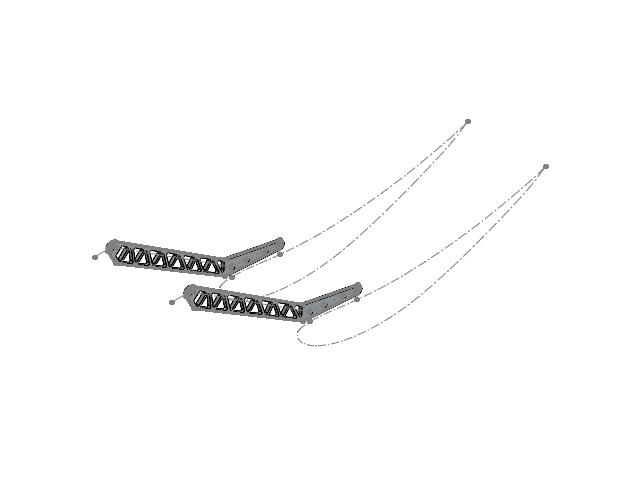
[picture p115: CAD file, 2025-05-03]
Aerodynamics/Rear Wing/Mounting/twoSwanNecks.SLDASM
Swan_Neck x 2
