bsobeloffgittes/NFR25-CAD/Suspension/Arms/Front_Pull_Rod_Assembly_NFR25.SLDASM

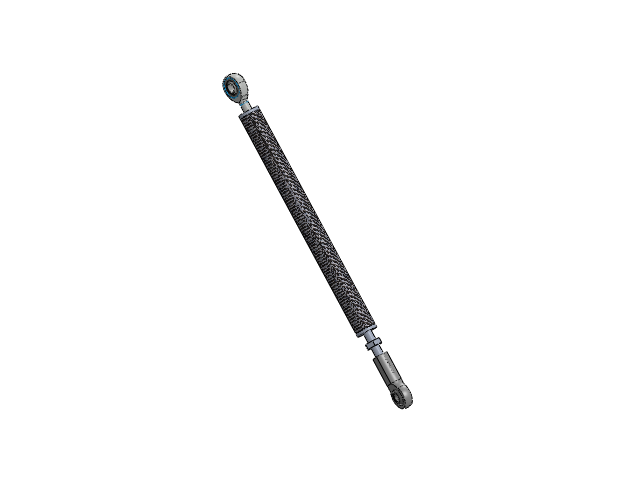
[picture p116: CAD file, 2025-04-03]
Suspension/Arms/Front_Pull_Rod_Assembly_NFR25.SLDASM
AM-4T
0.625x0.5 insert x 2
Female 0.25-28 Rod end
JSI-4F_turnbuckle
CF Tube^Front_Pull_Rod_Assembly_NFR25
