bsobeloffgittes/NFR25-CAD/Suspension/Front_Corner_Assembly_Right_NFR25.SLDASM

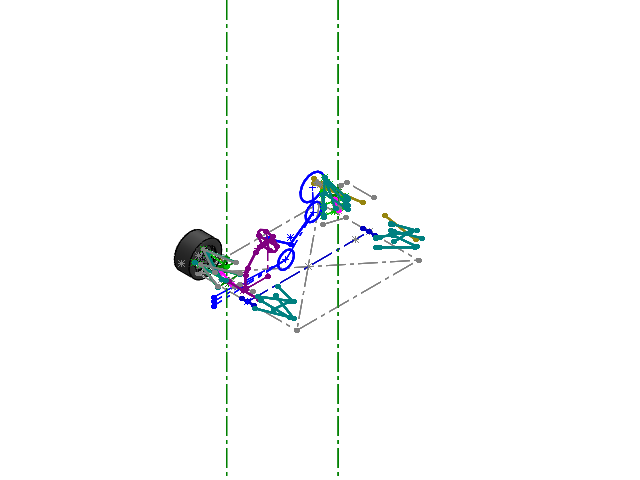
[picture p117: CAD file, 2024-09-10]
Suspension/Front_Corner_Assembly_Right_NFR25.SLDASM
_Suspension_Skeleton_NFR25 x 2
Hoosier 16.0 x 7.5-10
OZ FS Magnesium CL 10in Wheel 7.5in
FrontHub_NFR25
SKF_32007_X
SKF_32006_X
Wheel_Nut_NFR24
Front_Uprights_NFR25
Rotor_Front_NFR24
NFR22-20 Float Pin x 6
Ohlins TTX25 MkII FSAE Shock Upper
Ohlins TTX25 MkII FSAE Shock Lower
Ohlin FSAE Shock Spring
AM-4T x 2
HAB-4ET-sphericalbearing x 2
NFR22 Spherical Bearing Housing x 2
rough-block x 2
