bsobeloffgittes/NFR25-CAD/Suspension/Hubs/Rear Hubs/RearHubAssembly.SLDASM

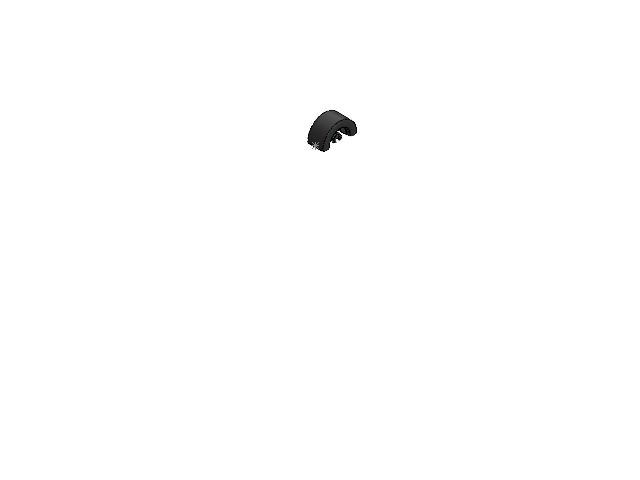
[picture p118: CAD file, 2025-05-11]
Suspension/Hubs/Rear Hubs/RearHubAssembly.SLDASM
RearHubs_NFR25
skf_bearing_61916-2rz_2_01 x 2
skf_bearing_61916-2rz_2_02 x 2
skf_bearing_61916-2rz_2_03 x 2
skf_bearing_61916-2rz_2_04 x 2
skf_bearing_61916-2rz_2_05 x 2
rear hub back
Wheel_Nut_NFR24
Hoosier 16.0 x 7.5-10
OZ FS Magnesium CL 10in Wheel 7.5in
