bsobeloffgittes/NFR25-CAD/Suspension/Steering/_Steering_Assembly_NFR25.SLDASM

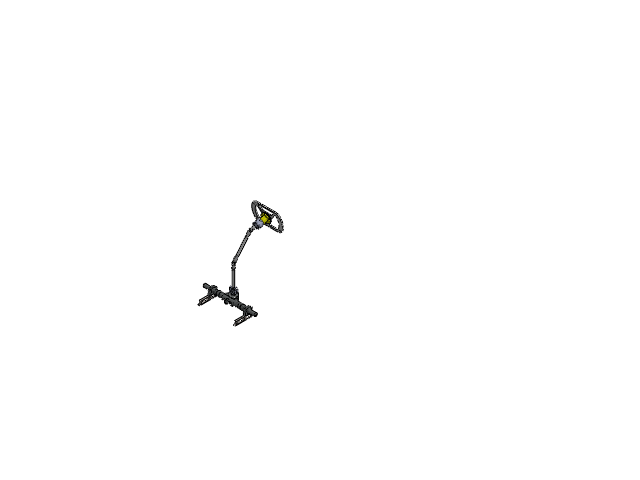
[picture p119: CAD file, 2025-05-02]
Suspension/Steering/_Steering_Assembly_NFR25.SLDASM
_Suspension_Skeleton_NFR25
Steering Wheel Plate
Racetech Quick Release
Top Mount Adapter
Steering Mount
skf_bearing_61904-2rs1_2_01 x 2
skf_bearing_61904-2rs1_2_02 x 2
skf_bearing_61904-2rs1_2_03 x 2
skf_bearing_61904-2rs1_2_04 x 2
skf_bearing_61904-2rs1_2_05 x 2
KAZ_Steering_Rack_-_Dumb_Solid
Ruland_Y750 YOKES_Y6X6-LH x 2
Ruland_HD-2A HD SERIES BLOCK_750-2A x 2
Ruland_HD-3A HD SERIES SMALL PIN_750-3A x 2
Ruland_HD-5A HD SERIES LARGE PIN_750-5A x 2
Ruland_Y750 YOKES_Y6X6-SH x 2
Steering Upper Column
Steering Lower Column
NFR25 Rack Pillow Block Mount x 2
Steering Column to U Joint Adapter x 3
lower_steering_adapter_nfr24
