bsobeloffgittes/NFR25-CAD/Suspension/Uprights/Front Uprights/Front Uprights Assembly.SLDASM

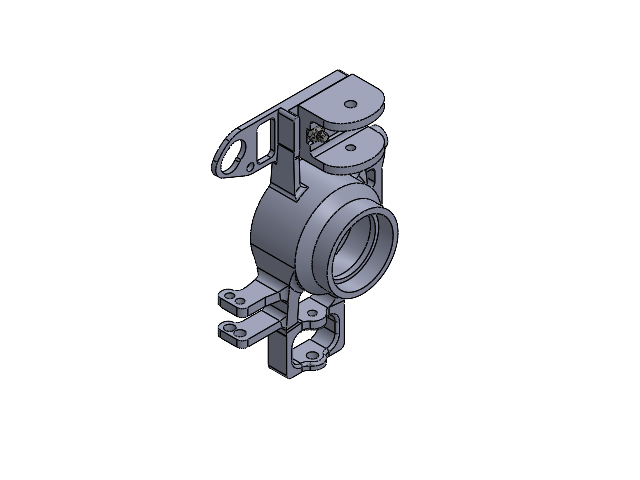
[picture p120: CAD file, 2025-02-13]
Suspension/Uprights/Front Uprights/Front Uprights Assembly.SLDASM
Front_Uprights_NFR25
Part1^Front Uprights Assembly
front Upright clevis NFR25
99291A220_Top-Lock Distorted-Thread Locknut x 2
91257A112_Zinc Yellow-Chromate Plated Hex Head Screw x 2
