bsobeloffgittes/NFR25-CAD/Vehicle Integration/Tabs for manufacturing/0625 tabs/0.0625 tabs pt1.SLDASM

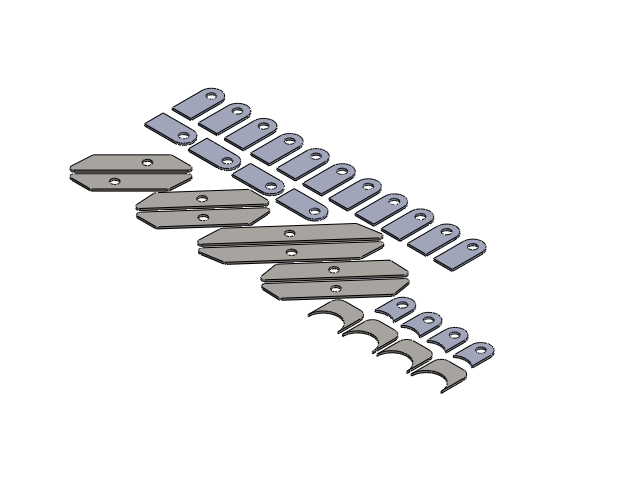
[picture p121: CAD file, 2025-04-03]
Vehicle Integration/Tabs for manufacturing/0625 tabs/0.0625 tabs pt1.SLDASM
2X---Front Floor Front Tab NFR25 x 2
2X---Front Floor Rear Tab NFR25 x 2
2X---Main Floor Front Tab NFR25 x 2
2X---Main Floor Rear Tab NFR25 x 2
4X---Shoulder Harness Tab x 4
4X---Standard Coped 1in Tab x 4
15X---Standard 1in Tab x 15
