bsobeloffgittes/NFR25-CAD/Vehicle Integration/Tabs for manufacturing/125 tabs/0.125 tabs pt 2.SLDASM

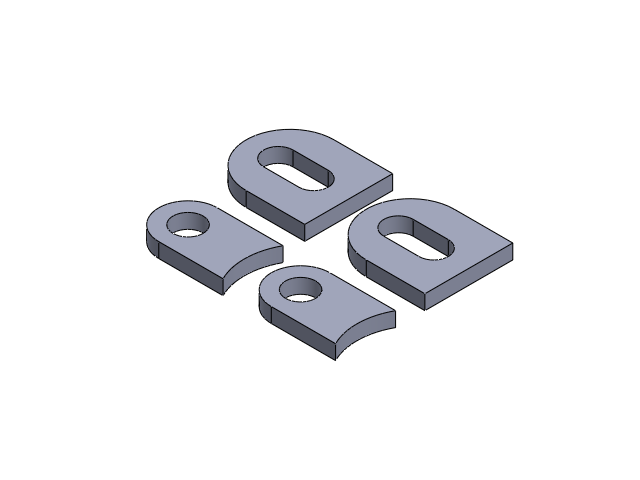
[picture p122: CAD file, 2025-04-03]
Vehicle Integration/Tabs for manufacturing/125 tabs/0.125 tabs pt 2.SLDASM
2X---Firewall Tab Top x 2
2X---Firewall Tab Bottom x 2
