bsobeloffgittes/NFR25-CAD/Accumulator/Segments/Boards and Cells/Ugly_SensePCB/SensePCB.SLDASM

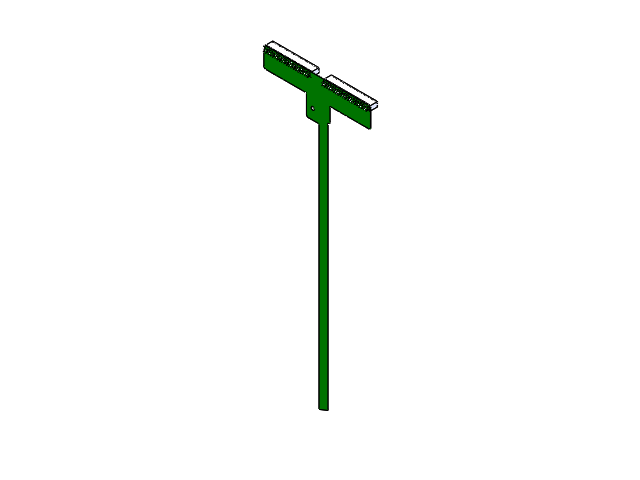
[picture p123: CAD file, 2024-09-08]
Accumulator/Segments/Boards and Cells/Ugly_SensePCB/SensePCB.SLDASM
Board-Part-1
