bsobeloffgittes/NFR25-CAD/Aerodynamics/Bodywork/Mold/side_panel_mdf.SLDASM

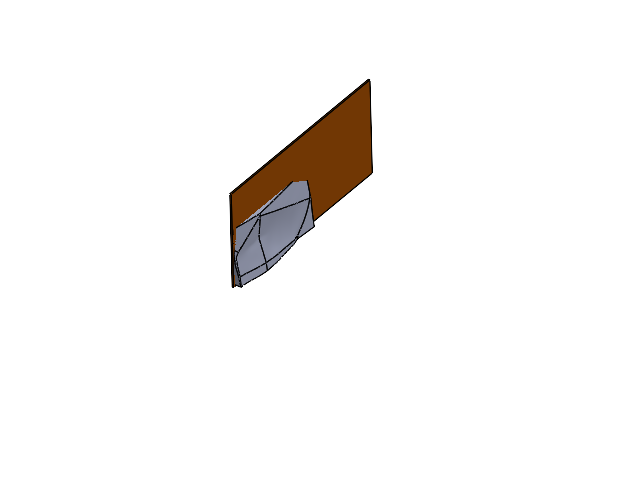
[picture p124: CAD file, 2024-11-21]
Aerodynamics/Bodywork/Mold/side_panel_mdf.SLDASM
NFR25_Right_Back_Side_Panel_Mold
MDF_Layer
