bsobeloffgittes/NFR25-CAD/Electrical/Charger/Elcon HK-LF-540-12-A assembly.SLDPRT.SLDASM

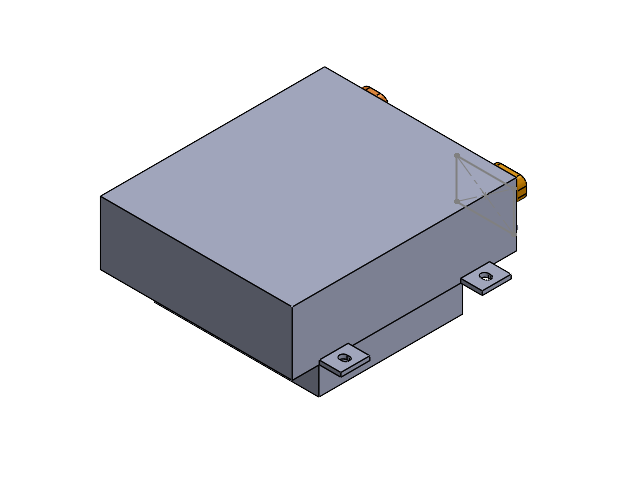
[picture p125: CAD file, 2025-04-26]
Electrical/Charger/Elcon HK-LF-540-12-A assembly.SLDPRT.SLDASM
Elcon HK-LF-540-12-A block model
HVSL362022A
HVSL633023A
Molex 348302001
