bsobeloffgittes/NFR25-CAD/Suspension/Anti-Roll Bar/ARB_Assembly_Front_NFR25.SLDASM

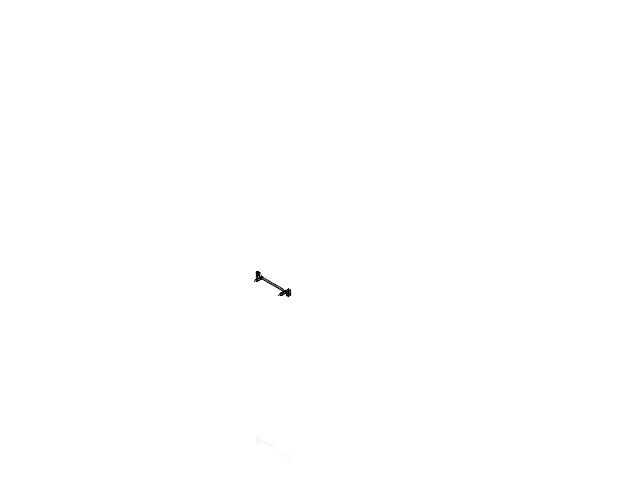
[picture p126: CAD file, 2025-02-26]
Suspension/Anti-Roll Bar/ARB_Assembly_Front_NFR25.SLDASM
_Suspension_Skeleton_NFR25
_Chassis_Skeleton_NFR25
AM-3 x 2
Front_arb_bearing_6338K572_Oil-Embedded Flanged Sleeve Bearing x 4
Front_arb_bolt_92620A241_Zinc Yellow-Chromate Plated Hex Head Screw x 2
Front_arb_slot x 4
Front_arb_small_bar_89955K479 x 2
Front_arb_torsion_bar_89955K299
Front_arb_torsion_lever_adapter x 2
Front_arb_washer x 2
Front_arb_lower_tab x 2
