bsobeloffgittes/NFR25-CAD/Suspension/Arms/Front_Tie_Rod_Assembly_NFR25.SLDASM

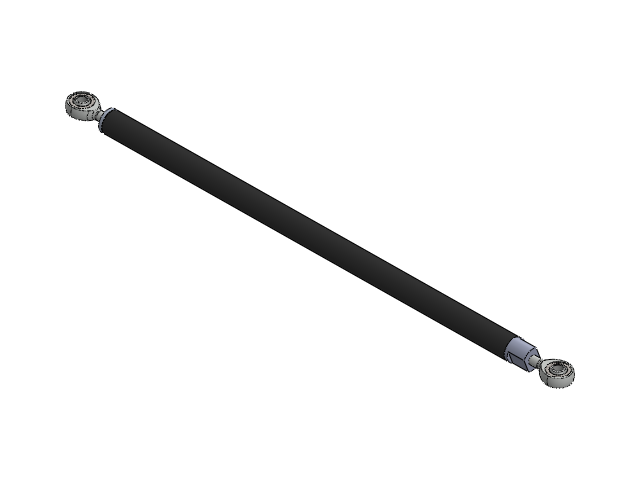
[picture p127: CAD file, 2025-04-03]
Suspension/Arms/Front_Tie_Rod_Assembly_NFR25.SLDASM
AM-4T x 2
0.625x0.5 LHT insert
0.625x0.5 insert
CF Tube^Front_Tie_Rod_Assembly_NFR25
