bsobeloffgittes/NFR25-CAD/Suspension/Hubs/Front Hubs/Front_hubs_assembly.SLDASM

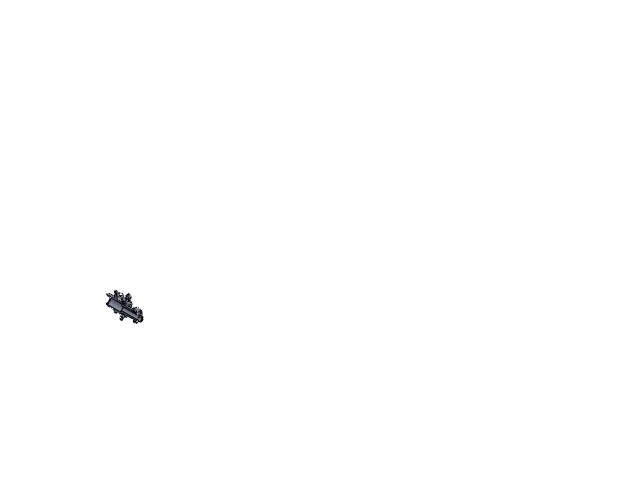
[picture p128: CAD file, 2024-10-03]
Suspension/Hubs/Front Hubs/Front_hubs_assembly.SLDASM
FrontHub_NFR25
skf_bearing_32006_x_2_01
skf_bearing_32006_x_2_02
skf_bearing_32006_x_2_03
skf_bearing_32008_x_2_01
skf_bearing_32008_x_2_02
skf_bearing_32008_x_2_03
