bsobeloffgittes/NFR25-CAD/Suspension/Rear_Corner_Assembly_Right_NFR25.SLDASM

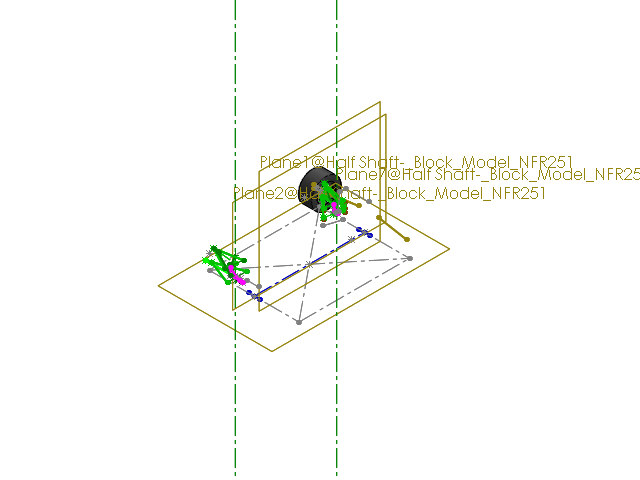
[picture p129: CAD file, 2024-09-01]
Suspension/Rear_Corner_Assembly_Right_NFR25.SLDASM
_Suspension_Skeleton_NFR25
Hoosier 16.0 x 7.5-10
OZ FS Magnesium CL 10in Wheel 7.5in
RearHubs_NFR25
Wheel_Nut_NFR24
RearUpright NFR25
MirrorBrake Caliper_Corrected
MirrorBrake Caliper 2
MirrorGuide x 2
MirrorPads x 2
MirrorBleed Screw x 4
Rotor_Rear_NFR24
NFR22-20 Float Pin x 6
SKF_61916-2RZ x 2
Ohlins TTX25 MkII FSAE Shock Upper
Ohlins TTX25 MkII FSAE Shock Lower
Ohlin FSAE Shock Spring
AM-4T x 4
HAB-4ET-sphericalbearing
NFR22 Spherical Bearing Housing
