bsobeloffgittes/NFR25-CAD/Suspension/Tire Sensor/SensorMountv3.SLDASM

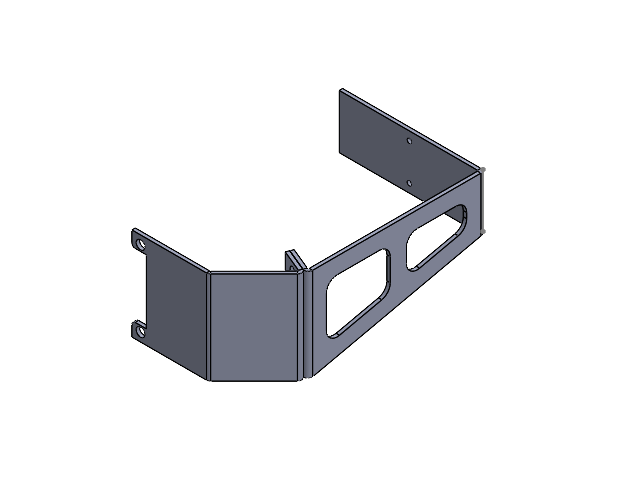
[picture p130: CAD file, 2025-04-21]
Suspension/Tire Sensor/SensorMountv3.SLDASM
SensorMountv3pt1
SensorMountv3pt2
