bsobeloffgittes/NFR25-CAD/Accumulator/Segments/8 Segment Design/Practice Cell Holders/PracticeSegmentAssembly2.SLDASM

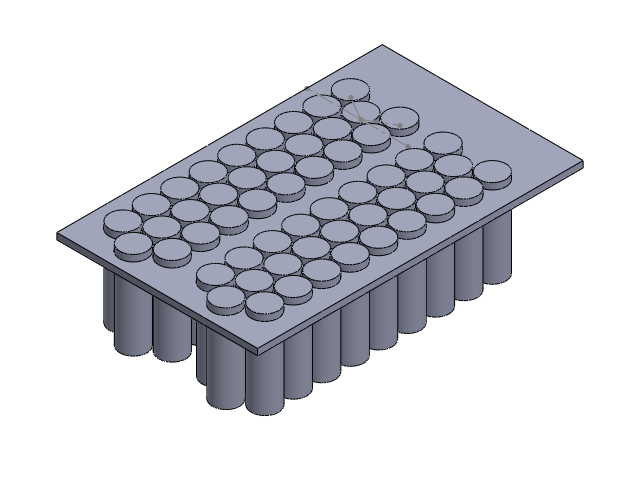
[picture p131: CAD file, 2024-07-14]
Accumulator/Segments/8 Segment Design/Practice Cell Holders/PracticeSegmentAssembly2.SLDASM
PracticeCellHolder2
CellExample x 54
