bsobeloffgittes/NFR25-CAD/Aerodynamics/Bodywork/Nosecone mdf/Assem1.SLDASM

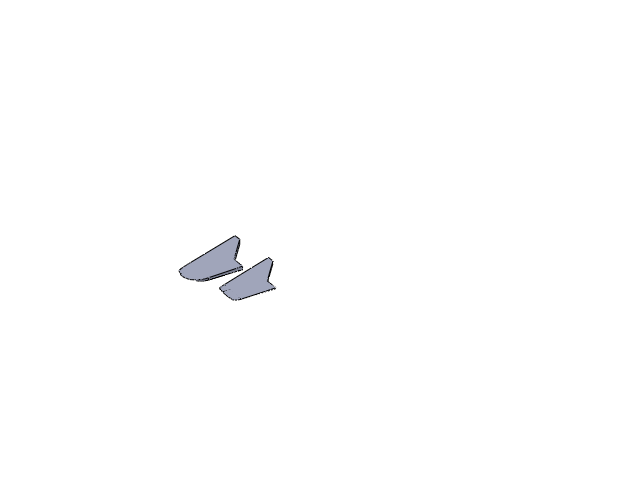
[picture p132: CAD file, 2024-10-28]
Aerodynamics/Bodywork/Nosecone mdf/Assem1.SLDASM
NFR25_Nosecone_mdf_2 x 2
