bsobeloffgittes/NFR25-CAD/Chassis/Jigging/Main RH Setup.SLDASM

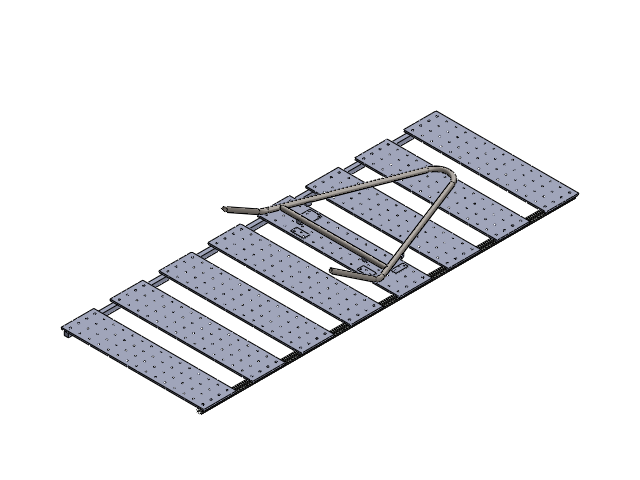
[picture p133: CAD file, 2024-11-23]
Chassis/Jigging/Main RH Setup.SLDASM
Slab x 8
SquareRods
1010-S-92-CL
91290A148_Alloy Steel Socket Head Screw (1)
Main RH 1
Standardized_UBlock x 4
Driver Right
Driver Left
Across Tube
Across Tube 2
