bsobeloffgittes/NFR25-CAD/Electrical/LV Battery/Yay!/LV_Battery_Testing_Assem.SLDASM

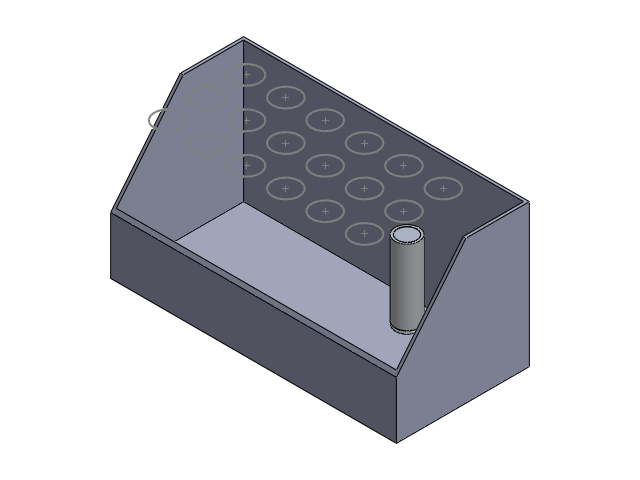
[picture p134: CAD file, 2025-02-05]
Electrical/LV Battery/Yay!/LV_Battery_Testing_Assem.SLDASM
LV_Battery_Testing
NFR_22_molicell_21700_Version_2.0 (shucked, different top geometry)
