bsobeloffgittes/NFR25-CAD/Suspension/Anti-Roll Bar/ARB_Assembly_Rear_NFR25.SLDASM

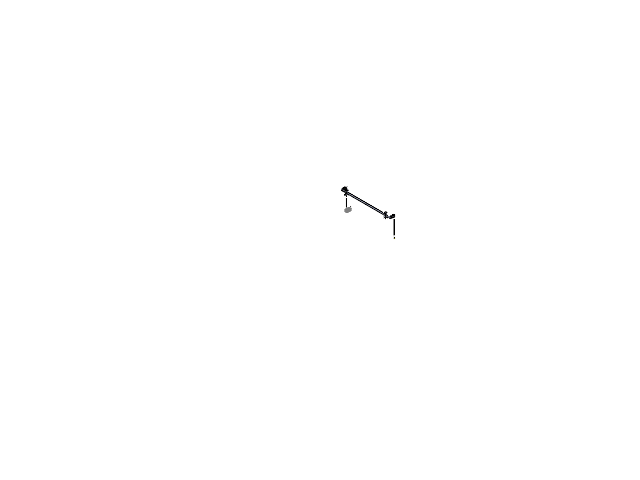
[picture p135: CAD file, 2025-02-15]
Suspension/Anti-Roll Bar/ARB_Assembly_Rear_NFR25.SLDASM
AM-3 x 5
_Chassis_Skeleton_NFR25
rear_arb_drop_link x 2
Rear_arb_slot x 4
Rear_arb_torsion_lever_adapter x 2
Rear_arb_torsion_bar_89955K299
Rear_arb_tab x 2
Rear_arb_upper_tab x 4
Rear_arb_bearing_6338K123_Oil-Embedded 841 Bronze Flanged Sleeve Bearing x 4
Rear_arb_tab_longer_screw_91251A149_Black-Oxide Alloy Steel Socket Head Screw x 4
Reat_arb_tab_nut_94528A112_Titanium Nylon-Insert Locknut x 4
