bsobeloffgittes/NFR25-CAD/Suspension/Arms/Front_Upper_Arm_Assembly_NFR25.SLDASM

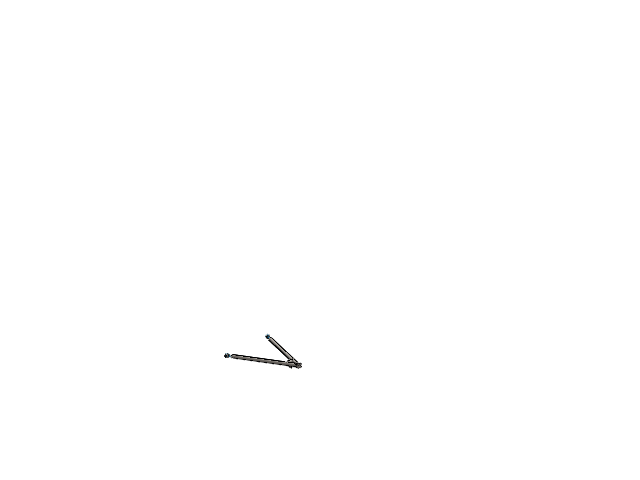
[picture p136: CAD file, 2025-04-03]
Suspension/Arms/Front_Upper_Arm_Assembly_NFR25.SLDASM
_Suspension_Skeleton_NFR25
wishbone_steel_front_upper_nfr25
AM-4T x 2
