bsobeloffgittes/NFR25-CAD/Suspension/Uprights/Mirrored Rear Upright in Stock.SLDASM

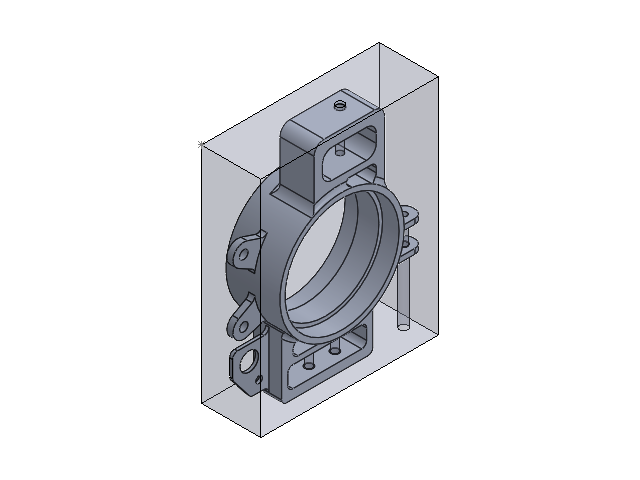
[picture p139: CAD file, 2025-01-18]
Suspension/Uprights/Mirrored Rear Upright in Stock.SLDASM
Mirrored Rear Upright
Mirrored Upright Stock
