bsobeloffgittes/NFR25-CAD/Accumulator/Mounts/Mounts Parts & Assemblies/Side_Mount_Assembly.SLDASM

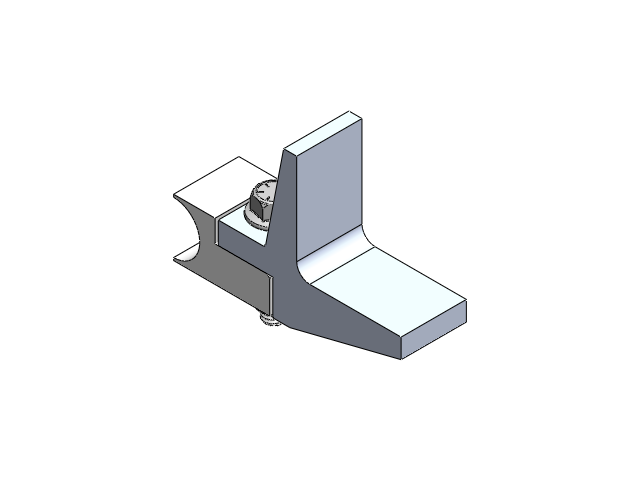
[picture p140: CAD file, 2025-02-05]
Accumulator/Mounts/Mounts Parts & Assemblies/Side_Mount_Assembly.SLDASM
Side_Chassis_Mount
Side_Accumulator_Mount
90409A135_High-Strength Grade 8 Steel Hex Head Screw
93298A130_Medium-Strength Steel Nylon-Insert Flange Locknut
