bsobeloffgittes/NFR25-CAD/Accumulator/Segment Container/8 Section Mockup/accumulator container Assemb/Accumulator_Container_Assembly_2025.SLDASM

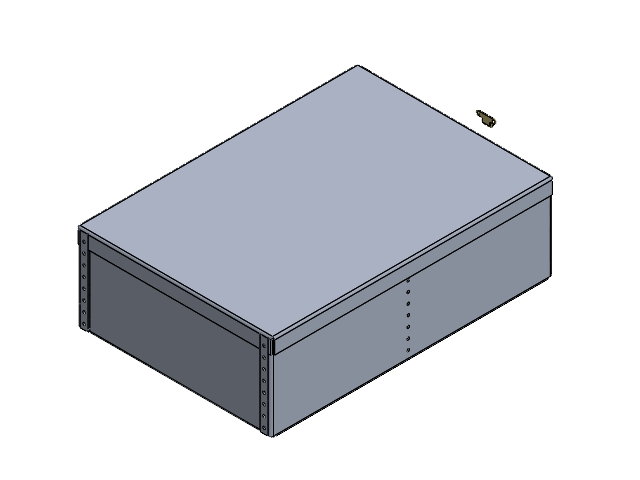
[picture p141: CAD file, 2024-08-21]
Accumulator/Segment Container/8 Section Mockup/accumulator container Assemb/Accumulator_Container_Assembly_2025.SLDASM
Accumulator_Container_OnePiece
Inner_wall_wide x 3
Inner_wall_long
Southco-TL-17-209-52
Southco-TL-40-111-52_TL-40-111-52_Base
Southco-TL-40-111-52_TL-40-111-52_Lever
Southco-TL-40-111-52_TL-40-111-52_Rivet
Southco-TL-40-111-52_TL-40-111-52_Special link
simplelid
