bsobeloffgittes/NFR25-CAD/Accumulator/Segments/Boards and Cells/NFR25_SensePCB.SLDASM

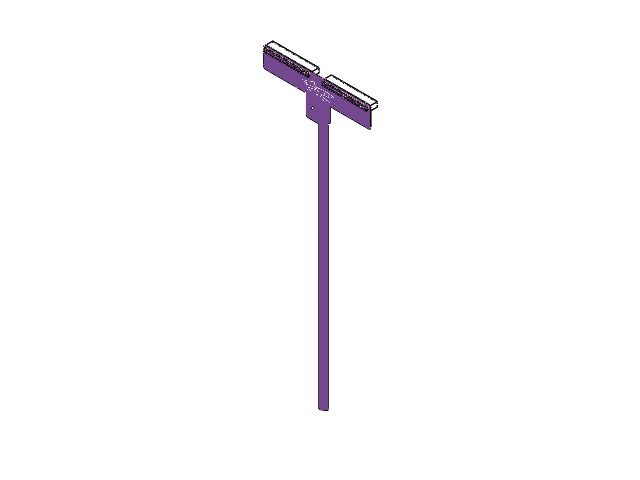
[picture p142: CAD file, 2024-09-08]
Accumulator/Segments/Boards and Cells/NFR25_SensePCB.SLDASM
NFR25_SensePCB_BOARD
AMPHENOL_87606-320LF_CMP-002-00085-2 x 2
