bsobeloffgittes/NFR25-CAD/Aerodynamics/Waterjetting/Plate_18in_14in.SLDASM

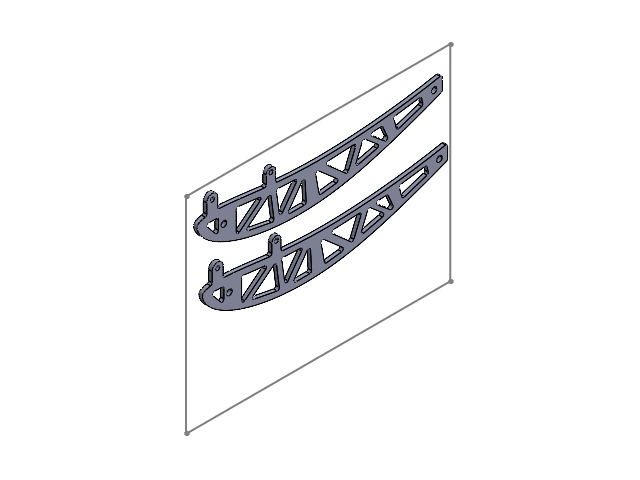
[picture p143: CAD file, 2025-02-28]
Aerodynamics/Waterjetting/Plate_18in_14in.SLDASM
RW_MF_insert.step x 2
