bsobeloffgittes/NFR25-CAD/Chassis/sus tab jigging/sus tab jigging assembly.SLDASM

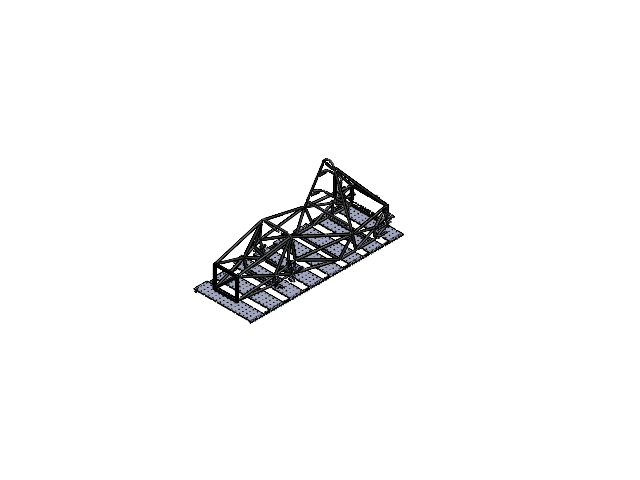
[picture p144: CAD file, 2025-02-08]
Chassis/sus tab jigging/sus tab jigging assembly.SLDASM
Slab x 8
SquareRods
1010-S-92-CL
Frame_NFR25
Part4^sus tab jigging assembly
Part8^sus tab jigging assembly
Part14^sus tab jigging assembly
back_upper_3(L)
back_lower_1(L)
back_upper_2(L)
back_upper_1(L)
front_upper_3(L)
front_lower_2(L)
front_upper_1(L)
front_lower_1(L)
Part28^sus tab jigging assembly
front_upper_2(L)
Part29^sus tab jigging assembly
Part30^sus tab jigging assembly
cyl_short x 2
Part31^sus tab jigging assembly
Part32^sus tab jigging assembly
Mirrorback_upper_3(L)
Mirrorback_lower_1(L)
Mirrorback_upper_2(L)
Mirrorfront_upper_3(L)
Mirrorfront_upper_2(L)
Mirrorfront_upper_1(L)
Mirrorfront_lower_2(L)
Mirrorfront_lower_1(L)
Mirrorback_upper_1(L)
