bsobeloffgittes/NFR25-CAD/Suspension/Arms/Rear_Upper_Arm_Assembly_NFR25.SLDASM

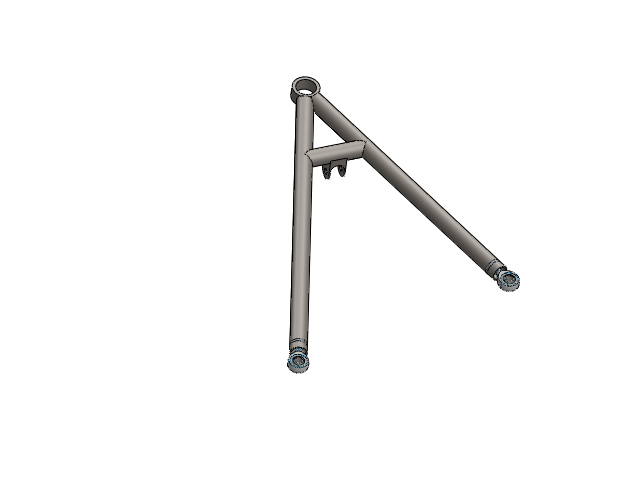
[picture p145: CAD file, 2025-04-03]
Suspension/Arms/Rear_Upper_Arm_Assembly_NFR25.SLDASM
AM-4T x 2
0.625x0.5 insert x 2
wishbone_steel_rear_upper_V2_nfr25
