bsobeloffgittes/NFR25-CAD/Suspension/Uprights/Front Uprights/FrontAssembForCAM.SLDASM

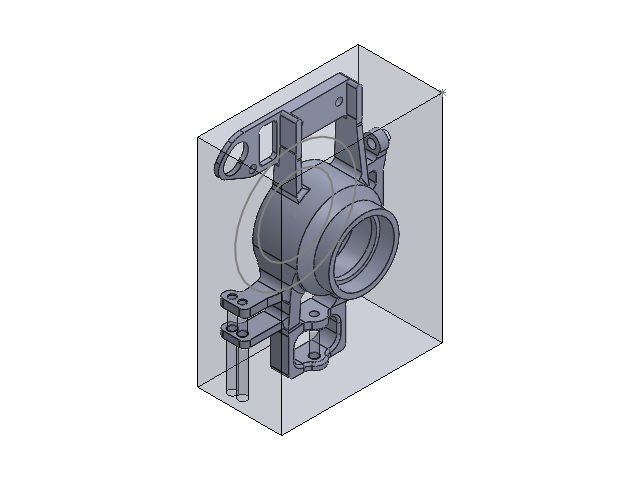
[picture p146: CAD file, 2024-11-05]
Suspension/Uprights/Front Uprights/FrontAssembForCAM.SLDASM
Front Upright Blank
Front_Uprights_NFR25
