bsobeloffgittes/NFR25-CAD/Suspension/Uprights/Rear Upright in Stock.SLDASM

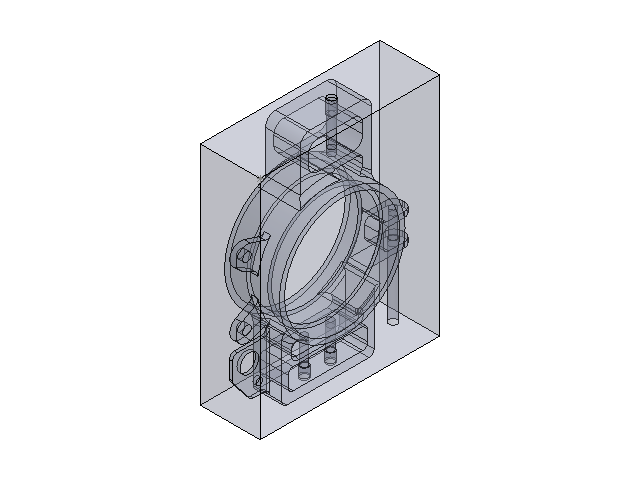
[picture p147: CAD file, 2024-11-19]
Suspension/Uprights/Rear Upright in Stock.SLDASM
RearUpright NFR25
Upright Stock
