bsobeloffgittes/NFR25-CAD/Vehicle Integration/Tabs for manufacturing/0625 tabs/0.0625 tabs pt4.SLDASM

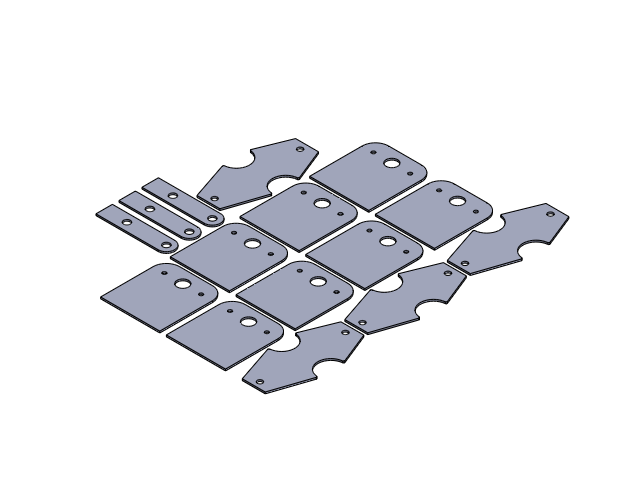
[picture p148: CAD file, 2025-04-03]
Vehicle Integration/Tabs for manufacturing/0625 tabs/0.0625 tabs pt4.SLDASM
Bodywork Tab x 8
3X---Undertray_front_top_tab x 3
4X---LV_tabs x 4
