bsobeloffgittes/NFR25-CAD/Aerodynamics/Front Wing/Inside Endplate Mold and Sytock.SLDASM

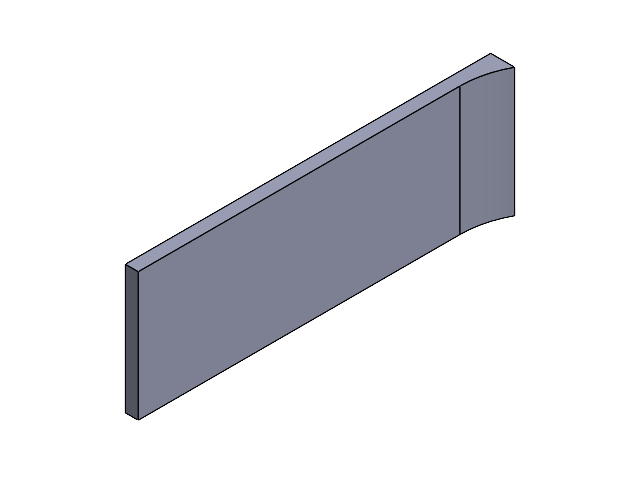
[picture p149: CAD file, 2025-04-03]
Aerodynamics/Front Wing/Inside Endplate Mold and Sytock.SLDASM
Inside Endplate Mold Stock
inside_endplate_mold.step
