bsobeloffgittes/NFR25-CAD/Suspension/Arms/Rear_Rear_Lower_Control_Arm_Assembly_NFR25.SLDASM

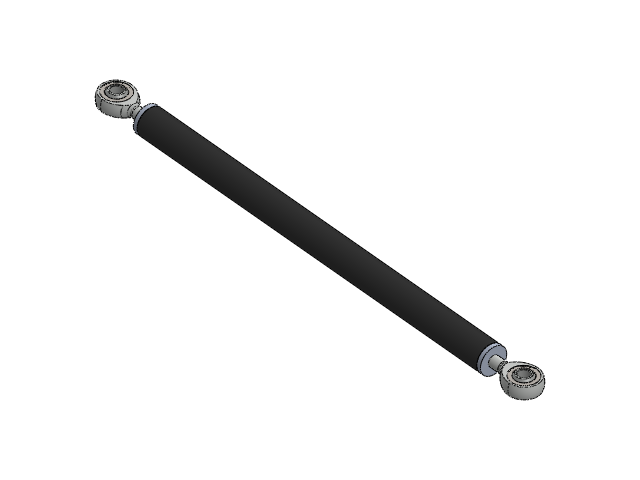
[picture p150: CAD file, 2025-04-03]
Suspension/Arms/Rear_Rear_Lower_Control_Arm_Assembly_NFR25.SLDASM
AM-4T x 2
0.625x0.5 insert x 2
CF Tube^Rear_Rear_Lower_Control_Arm_Assembly_NFR25
