bsobeloffgittes/NFR25-CAD/Suspension/Rockers/Rear Rockers/Rockers Tabs Assembly.SLDASM

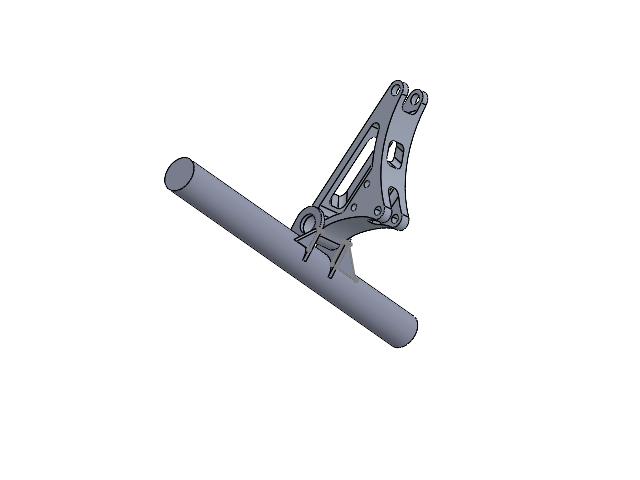
[picture p151: CAD file, 2025-02-13]
Suspension/Rockers/Rear Rockers/Rockers Tabs Assembly.SLDASM
Rear-Rear Rocker Tab Triangle
Rear-Rear Rocker Tabs
Chassis Model
Front-Rear Rocker Tabs
Front-Rear Rocker Tab Triangle
Rear Rockers V3
