bsobeloffgittes/NFR25-CAD/Aerodynamics/Waterjetting/Plate_12in_11in.SLDASM

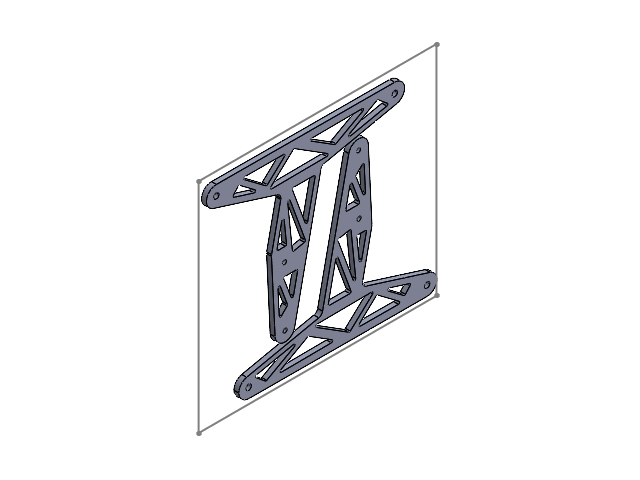
[picture p152: CAD file, 2025-02-28]
Aerodynamics/Waterjetting/Plate_12in_11in.SLDASM
FW_Tmount.step x 2
