bsobeloffgittes/NFR25-CAD/Suspension/Arms/Rear_Pullrod_Assembly_NFR25.SLDASM

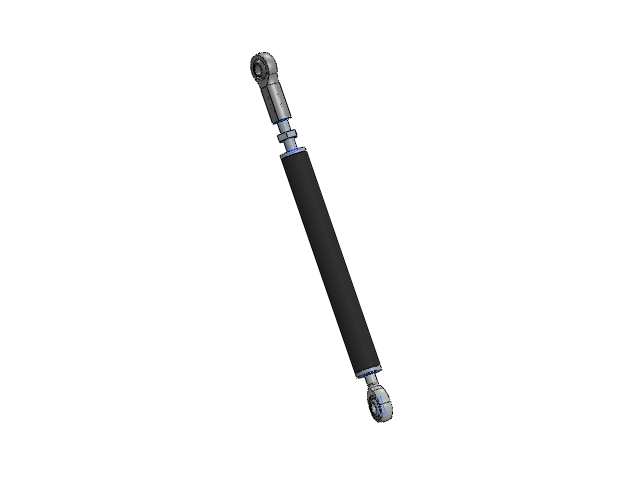
[picture p153: CAD file, 2025-04-03]
Suspension/Arms/Rear_Pullrod_Assembly_NFR25.SLDASM
AM-4T
0.625x0.5 insert x 2
Female 0.25-28 Rod end
JSI-4F_turnbuckle
Part5^Rear_Pullrod_Assembly_NFR25
