bsobeloffgittes/NFR25-CAD/(list of files, cad)

Other CAD files:
_NFR25_Vehicle_Assembly.SLDASM
Accumulator/Segments/Boards and Cells/Ugly_SensePCB/High Side.SLDASM
Accumulator/Water Cooling/Radiator/Radiator with mounts.SLDASM
Chassis/Dash/V1/Dashboard CAD/Dashboard assembly.SLDASM
Suspension/Anti-Roll Bar/Lower Rear ARB/Lower_Rear_ARB_Assembly_NFR25.SLDASM
Suspension/Hub Motors/Just_Goofing_Around.SLDASM
Accumulator/Segments/Boards and Cells/Ugly_SensePCB/Board.SLDASM
Accumulator/Segments/Boards and Cells/Ugly_SensePCB/Low Side.SLDASM
Accumulator/Water Cooling/Radiator/radiator_tab_)jig.SLDASM
Electrical/Charger/Bumper Assembly.SLDASM
Suspension/Anti-Roll Bar/New_Front_ARB/Left Mount.SLDASM
Accumulator/Segments/Maintenance Plugs and Busbars/Intersegment Maintenance Plugs/Covers and Busbar/LongFemale_Maintenance_Plug_Cover.SLDPRT
Suspension/Anti-Roll Bar/New_Front_ARB/Right Mount.SLDASM
Accumulator/Segment Container/Container/Latches/Southco-TL-20-102-52_TL-20-102-52.sldasm-Part-1.sldprt
Suspension/Anti-Roll Bar/New_Rear_ARB/Rear_ARB_Left_Mount.SLDASM
Accumulator/Cell Characterization/Flat pattern - cell_char_base.DXF
Accumulator/Cell Characterization/Hardware/92985A130_Splined Press-Fit Threaded Standoffs with Open End.SLDPRT
Accumulator/Cell Characterization/Molicel21700.SLDPRT
Accumulator/Cell Characterization/Prints/cell_char_cap.STL
Accumulator/Cell Characterization/cell_char_base.SLDPRT
Accumulator/Cell Characterization/cell_char_cap.SLDPRT
Accumulator/Cell Characterization/cell_char_cap_2.SLDPRT
Accumulator/Cell Characterization/cell_char_power_res.SLDPRT
Accumulator/Drawings/Container Drawings/penthouse_front_wall_drawing.SLDDRW
Accumulator/Drawings/Container Drawings/penthouse_internal_wall_drawing.SLDDRW
Accumulator/Drawings/Container Drawings/penthouse_left_wall_drawing.SLDDRW
Accumulator/Drawings/Container Drawings/penthouse_lid_drawing.SLDDRW
Accumulator/Drawings/Container Drawings/penthouse_rear_wall_drawing.SLDDRW
Accumulator/Drawings/Container Drawings/penthouse_right_wall_drawing.SLDDRW
Accumulator/Drawings/Container Drawings/segment_box_drawing.SLDDRW
Accumulator/Drawings/Container Drawings/segment_box_lid_drawing.SLDDRW
Accumulator/Drawings/Container Drawings/segment_box_wall_drawing.SLDDRW
Accumulator/Drawings/Segment Drawings/bottom_cell_holder_drawing.SLDDRW
Accumulator/Drawings/Segment Drawings/cold_plate_drawing.SLDDRW
Accumulator/Drawings/Segment Drawings/maintenance_plug_bottom_drawing.SLDDRW
Accumulator/Drawings/Segment Drawings/maintenance_plug_busbar_drawing.SLDDRW
Accumulator/Drawings/Segment Drawings/maintenance_plug_cover_drawing.SLDDRW
Accumulator/Drawings/Segment Drawings/master_negative_busbar_drawing.SLDDRW
Accumulator/Drawings/Segment Drawings/master_positive_busbar_drawing.SLDDRW
Accumulator/Drawings/Segment Drawings/negative_busbar_drawing.SLDDRW
Accumulator/Drawings/Segment Drawings/parallel_busbar_drawing.SLDDRW
Accumulator/Drawings/Segment Drawings/positive_busbar_drawing.SLDDRW
Accumulator/Drawings/Segment Drawings/segment_bolt_tube_drawing.SLDDRW
Accumulator/Drawings/Segment Drawings/top_cell_holder_drawing.SLDDRW
Accumulator/Drawings/Segment Drawings/top_cover_drawing.SLDDRW
Accumulator/Drawings/Water Cooling Drawings/5_Way_Splitter_3.0_halfinch Drawing.SLDDRW
Accumulator/Drawings/Water Cooling Drawings/5_Way_Splitter_3.0_threeeighths Drawing.SLDDRW
Accumulator/Drawings/Water Cooling Drawings/BarbBlockModel Drawing.SLDDRW
Accumulator/Drawings/Water Cooling Drawings/ColdPlateFitting Drawing.SLDDRW
Accumulator/Drawings/Water Cooling Drawings/RightAngleBlockModel Drawing.SLDDRW
Accumulator/Drawings/Water Cooling Drawings/TubenutBlockModel Drawing.SLDDRW
Accumulator/Drawings/cell_drawing.SLDDRW
Accumulator/Mounts/Mount Jig Bar.SLDPRT
Accumulator/Mounts/Mount jig assist.SLDPRT
Accumulator/Mounts/Mounts Drawings/Mount jig assist.SLDDRW
Accumulator/Mounts/Mounts Drawings/Rear chassis mount SES drawing.SLDDRW
Accumulator/Mounts/Mounts Drawings/Rear chassis mount v2 Drawing.SLDDRW
Accumulator/Mounts/Mounts Drawings/Rear chassis mount v2.SLDDRW
Accumulator/Mounts/Mounts Drawings/Rear mount container side SES Drawing.SLDDRW
Accumulator/Mounts/Mounts Drawings/Rear mount v2 Drawing.SLDDRW
Accumulator/Mounts/Mounts Drawings/Rear mount v2.SLDDRW
Accumulator/Mounts/Mounts Drawings/Side chassis mount SES drawing.SLDDRW
Accumulator/Mounts/Mounts Drawings/Side chassis mount v3 Drawing.SLDDRW
Accumulator/Mounts/Mounts Drawings/Side mount container side SES drawing.SLDDRW
Accumulator/Mounts/Mounts Drawings/Side mount v3 Drawing.SLDDRW
Accumulator/Mounts/Mounts Drawings/Tolerance stackup sketch.SLDPRT
Accumulator/Mounts/Mounts Parts & Assemblies/90409A135_High-Strength Grade 8 Steel Hex Head Screw.SLDPRT
Accumulator/Mounts/Mounts Parts & Assemblies/90409A138_High-Strength Grade 8 Steel Hex Head Screw.SLDPRT
Accumulator/Mounts/Mounts Parts & Assemblies/93298A130_Medium-Strength Steel Nylon-Insert Flange Locknut.SLDPRT
Accumulator/Mounts/Mounts Parts & Assemblies/Rear_Accumulator_Mount.SLDPRT
Accumulator/Mounts/Mounts Parts & Assemblies/Rear_Chassis_Mount.SLDPRT
Accumulator/Mounts/Mounts Parts & Assemblies/Side_Accumulator_Mount.SLDPRT
Accumulator/Mounts/Mounts Parts & Assemblies/Side_Chassis_Mount.SLDPRT
Accumulator/Mounts/Mounts Solid Files (For XACT)/Rear Mount Chassis side Solid File.x_t
Accumulator/Mounts/Mounts Solid Files (For XACT)/Rear Mount Container side Solid File.x_t
Accumulator/Mounts/Mounts Solid Files (For XACT)/Side Mount Chassis side Solid File.x_t
Accumulator/Mounts/Mounts Solid Files (For XACT)/Side Mount Container side Solid File.x_t
Accumulator/Other/Drake's Folder/5seg_busbar_1.SLDPRT
Accumulator/Other/Drake's Folder/5seg_busbar_2.SLDPRT
Accumulator/Other/Drake's Folder/BottomCellHolder_5segV2.SLDPRT
Accumulator/Other/Drake's Folder/MasterNegativeSM.SLDPRT
Accumulator/Other/Drake's Folder/MasterPositiveSM.SLDPRT
Accumulator/Other/Drake's Folder/TopCellHolder_5seg.SLDPRT
Accumulator/Other/Drake's Folder/box_5seg.SLDPRT
Accumulator/Other/Drake's Folder/temp_cold_plate_5seg.SLDPRT
Accumulator/Other/Drake's Folder/thermal_pad_5seg.SLDPRT
Accumulator/Other/Tools/10mmSocket.SLDPRT
Accumulator/Other/Tools/5543A23_1-4_socket.SLDPRT
Accumulator/Penthouse/Layout/0430200400.SLDPRT
Accumulator/Penthouse/Layout/ELPA2Z1601.stp
Accumulator/Penthouse/Layout/ELRA2Z03.stp
Accumulator/Penthouse/Layout/HDP24-18-20PE.stp
Accumulator/Penthouse/Layout/HSC100S6K8J_Precharge_Resistor.SLDPRT
Accumulator/Penthouse/Layout/LSCR101.stp
Accumulator/Penthouse/Layout/MSDXLF000R Base Mockup.SLDPRT
Accumulator/Penthouse/Layout/PenthouseLayout.SLDPRT
Accumulator/Penthouse/Layout/Plastic Base Plate.SLDPRT
Accumulator/Penthouse/Layout/SLPPA25BSO.stp
Accumulator/Penthouse/Layout/TSCB_NFR25.SLDPRT
Accumulator/Penthouse/Layout/TSCB_NFR25.step
Accumulator/Penthouse/Layout/Voltage Indicator Holder.SLDPRT
Accumulator/Penthouse/Layout/Voltage Indicator WP7113.SLDPRT
Accumulator/Penthouse/Layout/Voltage_Indicator_Board_NFR25.SLDPRT
Accumulator/Penthouse/Layout/c-2-1445055-2-b-3d.SLDPRT
Accumulator/Penthouse/Layout/c-2-1445055-2-b-3d.stl
Accumulator/Penthouse/Layout/c-2-1445057-8-d-3d.SLDPRT
Accumulator/Penthouse/Layout/c-2-1445057-8-d-3d.stl
Accumulator/Penthouse/Layout/ev200a_KILOVAC-Contactor-500+Amps-12-900VDC.SLDPRT
Accumulator/Penthouse/Layout/iso175_IMD.SLDPRT
Accumulator/Penthouse/Layout/penthouse_layout.SLDPRT
Accumulator/Penthouse/Penthouse Container/PenthouseInternalWall.SLDPRT
Accumulator/Penthouse/Penthouse Container/PenthouseLid.SLDPRT
Accumulator/Penthouse/Penthouse Container/Penthouse_Front_Wall.SLDPRT
Accumulator/Penthouse/Penthouse Container/Penthouse_Left_Wall.SLDPRT
Accumulator/Penthouse/Penthouse Container/Penthouse_Rear_Wall.SLDPRT
Accumulator/Penthouse/Penthouse Container/Penthouse_Right_Wall.SLDPRT
Accumulator/Penthouse/Penthouse Container/SendCutSend/Flat pattern - PenthouseLid.DXF
Accumulator/Penthouse/Penthouse Container/SendCutSend/PenthouseInternalWall.STEP
Accumulator/Penthouse/Penthouse Container/SendCutSend/PenthouseLid.STEP
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
