bsobeloffgittes/NFR25-CAD/Suspension/Hubs/Rear Hubs/RearHubAssembly.JPG

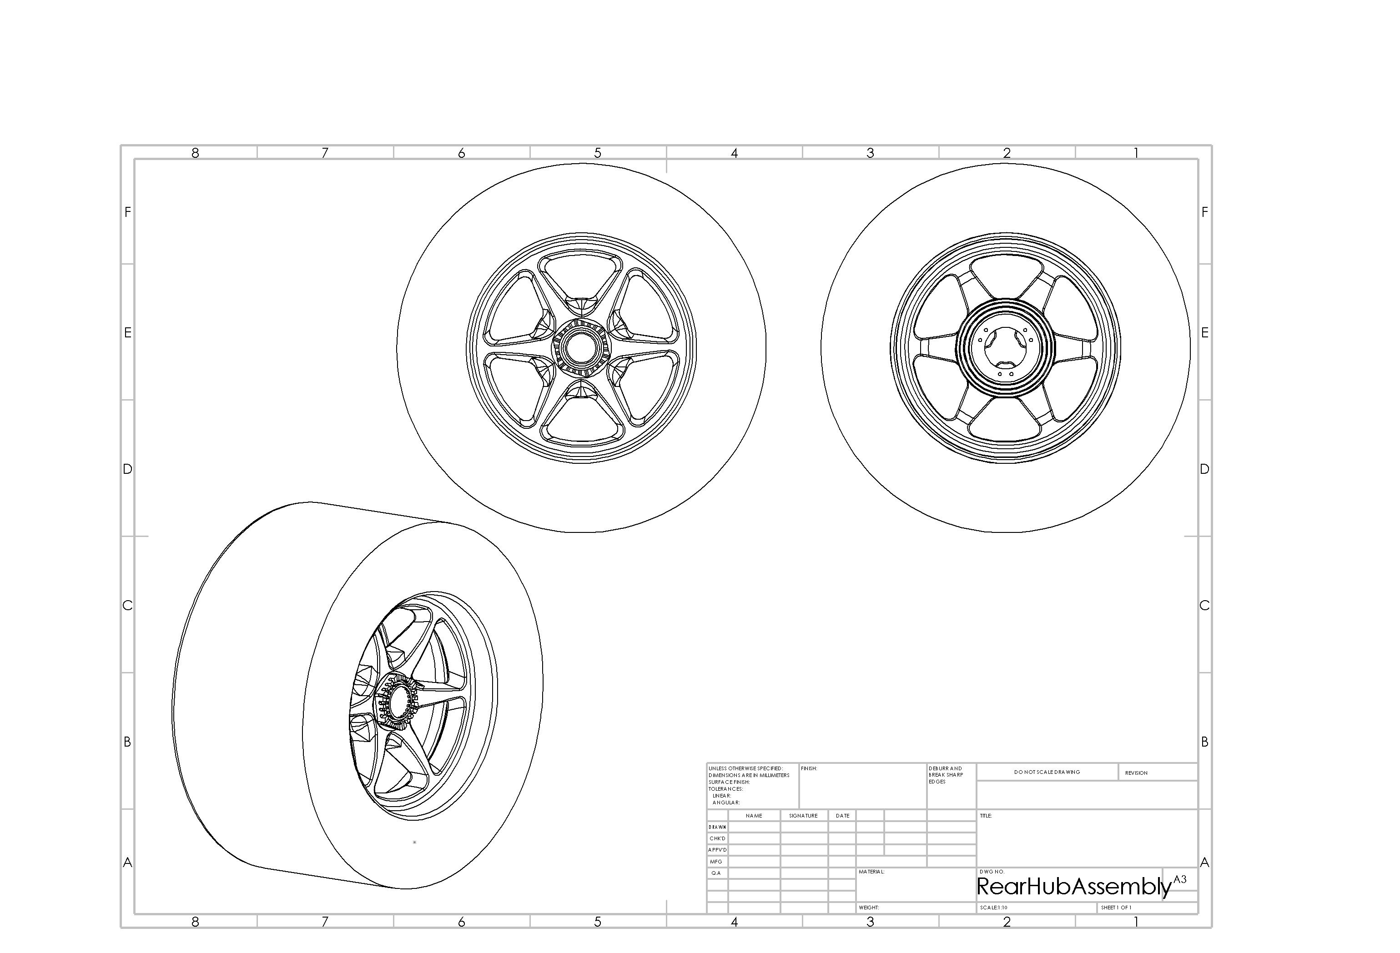
Suspension/Hubs/Rear Hubs/RearHubAssembly.JPG
