bsobeloffgittes/NFR25-CAD/Chassis/Differential Sprocket Adapter/DSA Earlier Iterations/Test_DSA_v4-Static 1-BenchMark-Solver.txt

Solver 0.001 Linear-static-solver-Start 0 0 0 0 0 0 0 0 0 0 0 0 0 0 0 0 0 0 0 0 0 0 0 0 0 0 0 0
Solver 0.001 Loading-and-preparing-input-data-Start 0 0 0 0 0 0 0 0 0 0 0 0 0 0 0 0 0 0 0 0 0 0 0 0 0 0 0 0
Solver 0.307 Loading-and-preparing-input-data-End 0 0 0 0 0 0 0 0 0 0 0 0 0 0 0 0 0 0 0 0 0 0 0 0 0 0 0 0
Solver 0.307 Computing-load-vector-Start 0 0 0 0 0 0 0 0 0 0 0 0 0 0 0 0 0 0 0 0 0 0 0 0 0 0 0 0
Solver 0.397 Computing-load-vector-End 0 0 0 0 0 0 0 0 0 0 0 0 0 0 0 0 0 0 0 0 0 0 0 0 0 0 0 0
Solver 0.477 FFEPlus-Solver-start 0 0 0 0 0 0 0 0 0 0 0 0 0 0 0 0 0 0 0 0 0 0 0 0 0 0 0 0
Solver 0.601 Element-connectivity-Start (all) 0 0 0 0 0 0 0 0 0 0 0 0 0 0 0 0 0 0 0 0 0 0 0 0 0 0 0 0
Solver 0.642 Element-connectivity-End (all) 0 0 0 0 0 0 0 0 0 0 0 0 0 0 0 0 0 0 0 0 0 0 0 0 0 0 0 0
Solver 1.828 PCGLSS-Assembly-End 0 0 0 0 0 0 0 0 0 0 0 0 0 0 0 0 0 0 0 0 0 0 0 0 0 0 0 0
Solver 2.189 PCGLSS-Preconditioner-End 0 0 0 0 0 0 0 0 0 0 0 0 0 0 0 0 0 0 0 0 0 0 0 0 0 0 0 0
Solver 2.564 FFEPlus-Solver-End 0 0 0 0 0 0 0 0 0 0 0 0 0 0 0 0 0 0 0 0 0 0 0 0 0 0 0 0
Solver 3.063 Computing-stresses-for-load-case=1-Start 0 0 0 0 0 0 0 0 0 0 0 0 0 0 0 0 0 0 0 0 0 0 0 0 0 0 0 0
Solver 3.064 Computing-reaction-forces-for-load-case(LCASE)=1-Start 0 0 0 0 0 0 0 0 0 0 0 0 0 0 0 0 0 0 0 0 0 0 0 0 0 0 0 0
Solver 3.804 Computing-reaction-forces-for-load-case(LCASE)=1-End 0 0 0 0 0 0 0 0 0 0 0 0 0 0 0 0 0 0 0 0 0 0 0 0 0 0 0 0
Solver 3.829 Computing-stresses-for-load-case=1-End 0 0 0 0 0 0 0 0 0 0 0 0 0 0 0 0 0 0 0 0 0 0 0 0 0 0 0 0
Solver 3.852 Linear-static-solver-End 0 0 0 0 0 0 0 0 0 0 0 0 0 0 0 0 0 0 0 0 0 0 0 0 0 0 0 0
SOLVER TYPE= FFEPlus (PCG Iterative Solver)
Number of Equations (NEQ)=321096
Number of Nodal points (NUMNP)=114130
Number of Pseudo nodes (NUMPS)=0
Number of Elements (NUME)=72059
Number of Pseudo Elements (NUMP)=0
SOLVER TYPE ACTUALLY USED= FFEPlus (PCG Iterative Solver)
SOLUTION TIME LOG
Time for Input Data Transfer from Database =0.512000
TIME FOR CALCULATION OF STRUCTURE STIFFNESS MATRIX (STF_PHASE)=0.011000
TIME FOR FFEPlus (PCG ITERATIVE SOLVER) =2.103000
TIME FOR GAP & CONTACT ITERATIONS (CNT_PHASE)=0.000000
TIME FOR REACTION FORCE & DISP UPDATE TO POST (REC_PAHS)=0.494000
TIME FOR STRESS CALCULATION (STS_PHASE)=0.766000
TIME FOR WRITING POST PROCESSING INFORMATION (PST_PHASE)=0.001000
TOTAL SOLUTION TIME (TOT_TIME)=3.892000
