bsobeloffgittes/NFR25-CAD/Accumulator/Drawings/Side chassis mount v3 drawing.pdf

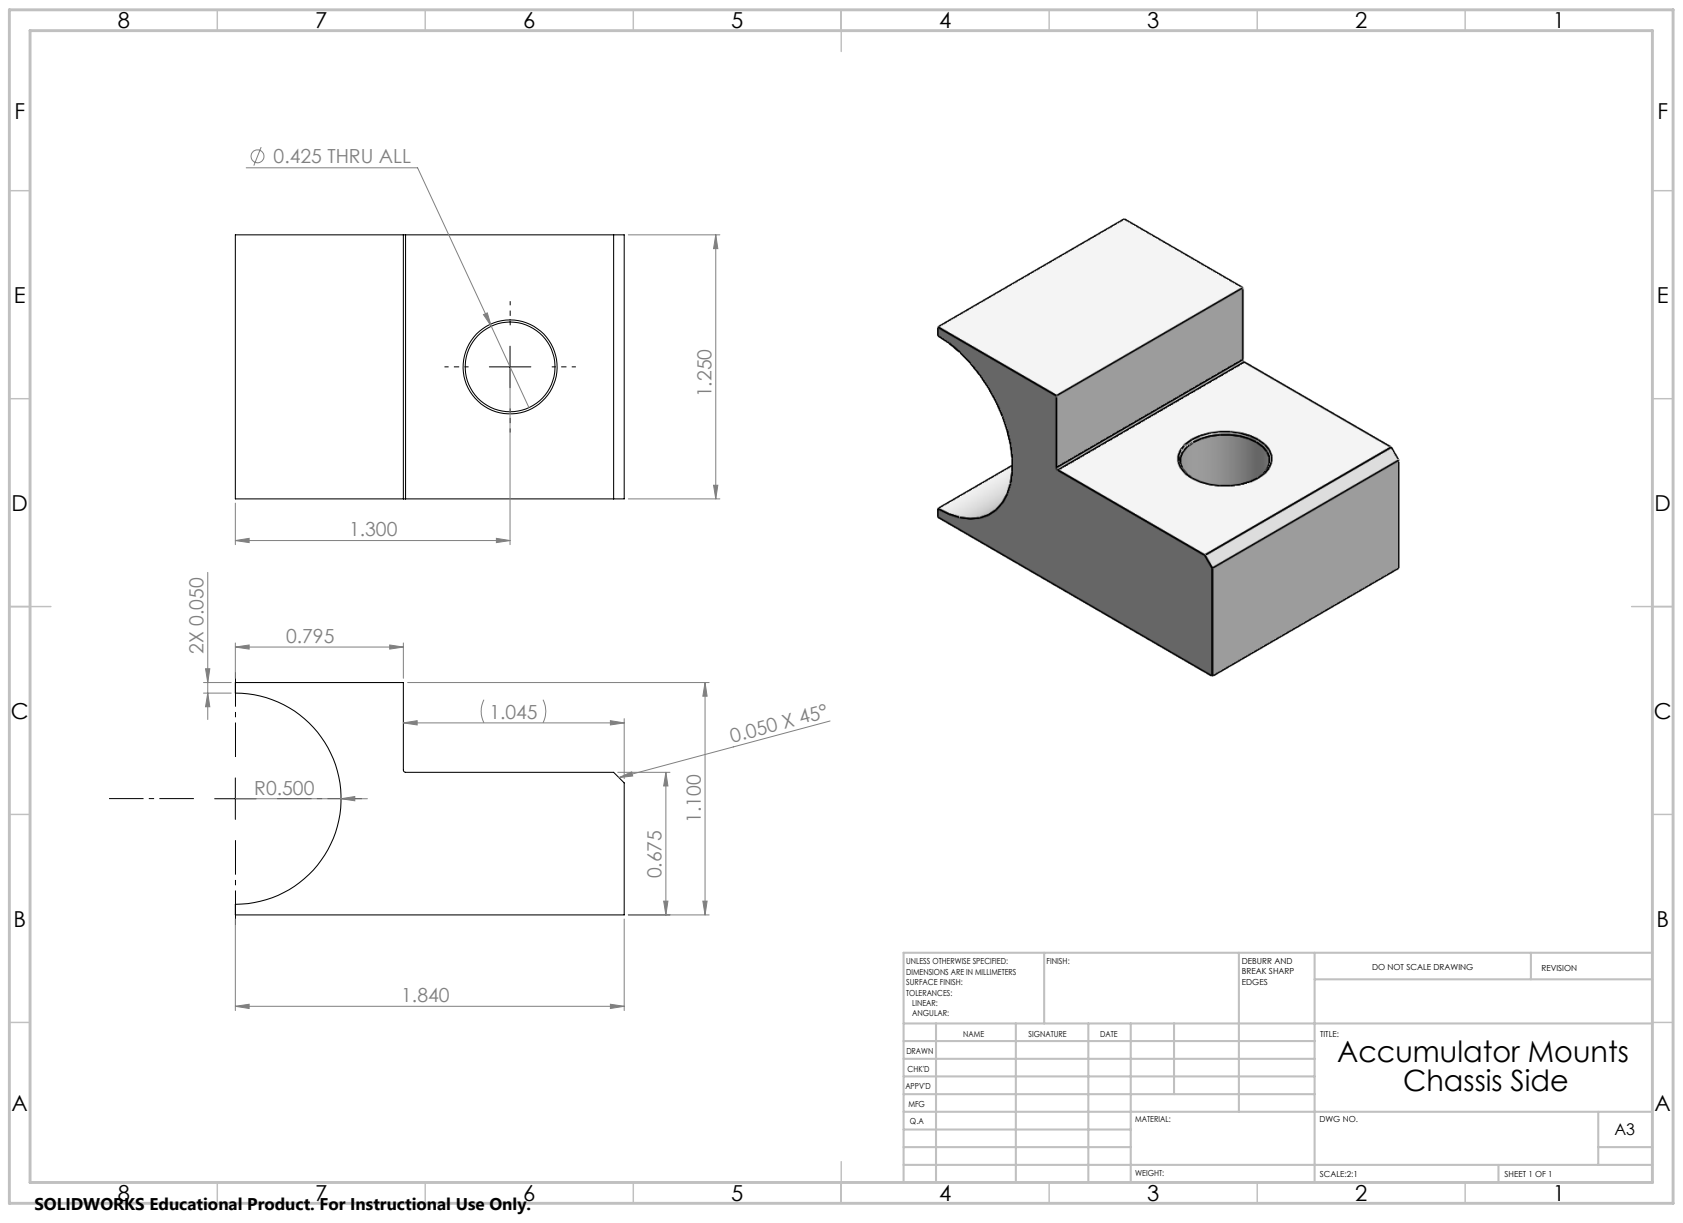
[picture p155: page 1]
0.425 THRU ALL; FINISH:; DEBURR AND; BREAK SHARP; DO NOT SCALE DRAWING; REVISION; SCALE:2:1; SHEET 1 OF 1

UNLESS OTHERWISE SPECIFIED:
DIMENSIONS ARE IN MILLIMETERS
SURFACE FINISH:
TOLERANCES:
LINEAR:
ANGULAR:

NAME | SIGNATURE | DATE | | | | TITLE: Accumulator Mounts Chassis Side

DRAWN
CHK'D
APPV'D
MFG
Q.A | | | | MATERIAL: | DWG NO. | A3

SOLIDWORKS Educational Product. For Instructional Use Only.
