bsobeloffgittes/NFR25-CAD/Suspension/Rockers/Rear Rockers/Rear Rockers Cost Report drawing.pdf

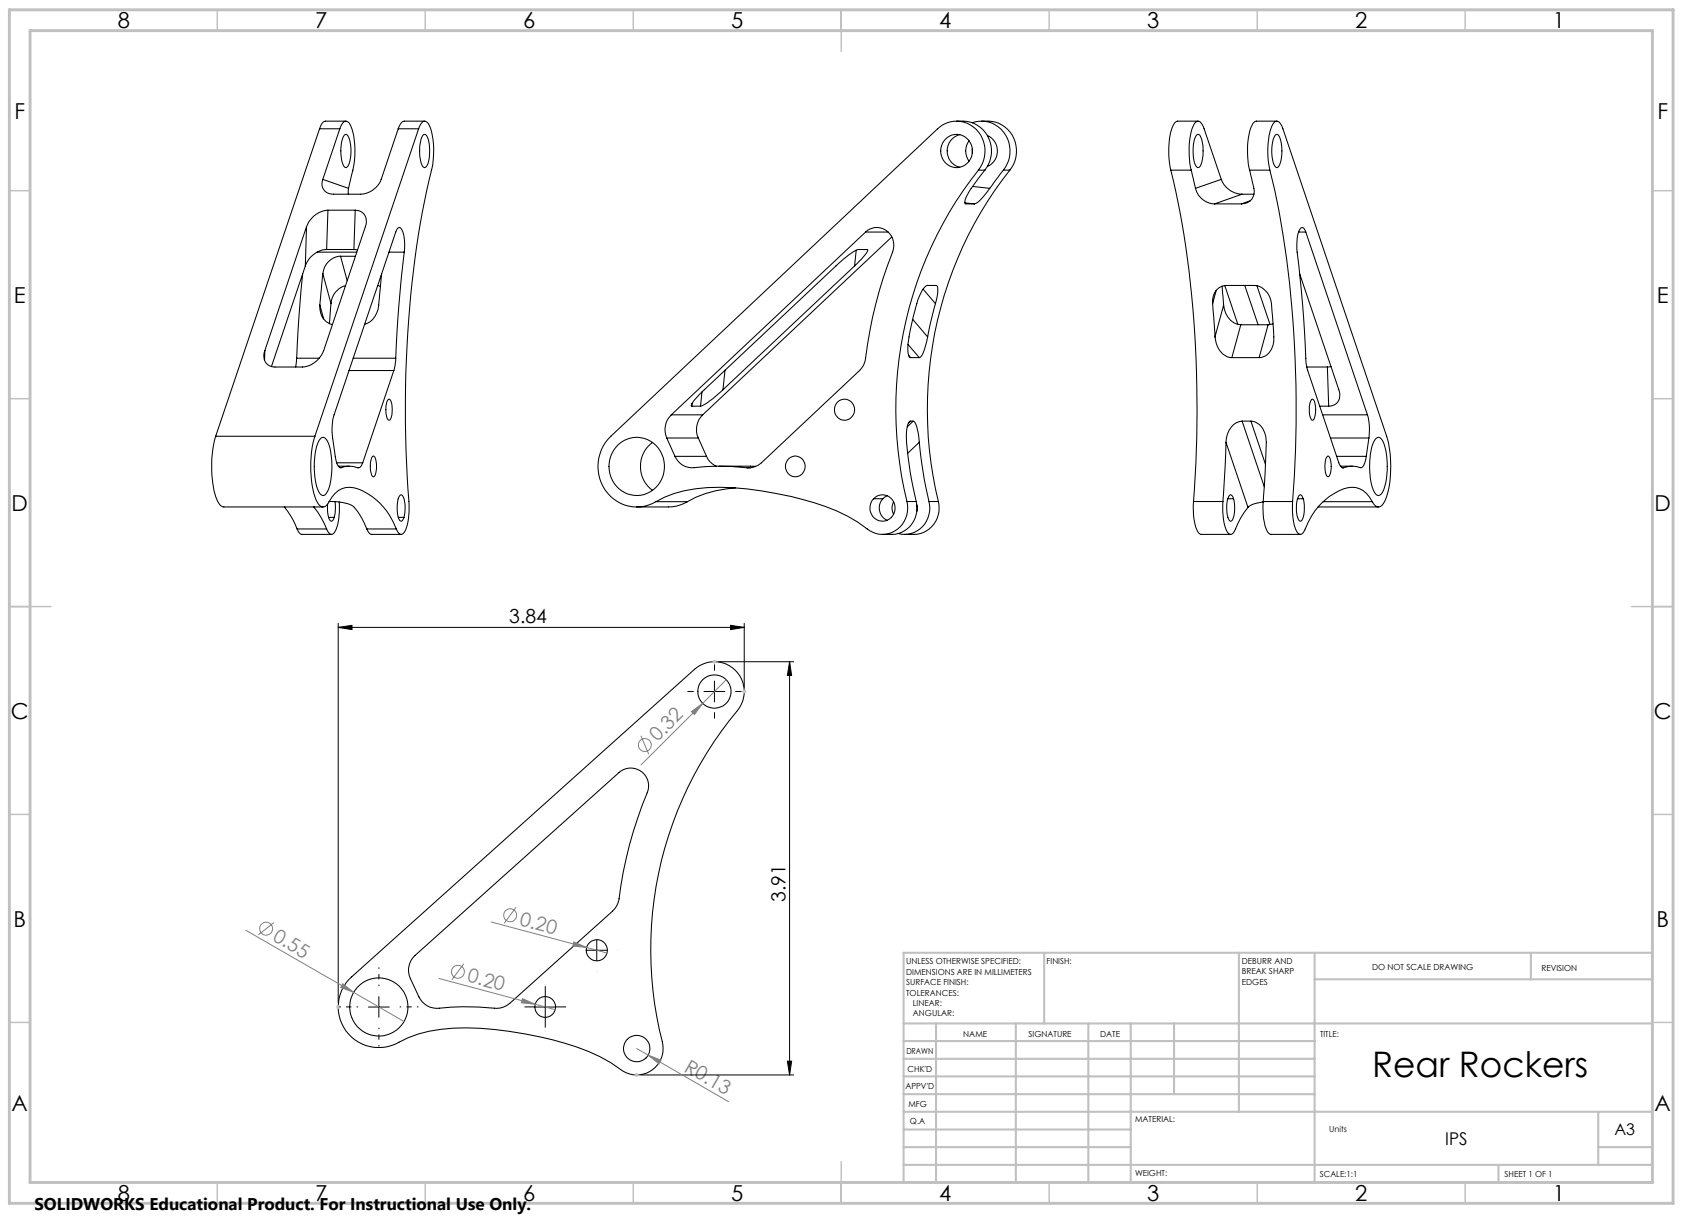
[picture p156: page 1]
FINISH:; DEBURR AND; BREAK SHARP; DO NOT SCALE DRAWING; REVISION; SCALE:1:1; SHEET 1 OF 1

UNLESS OTHERWISE SPECIFIED:
DIMENSIONS ARE IN MILLIMETERS
SURFACE FINISH:
TOLERANCES:
LINEAR:
ANGULAR:

NAME | SIGNATURE | DATE | | | | TITLE: Rear Rockers

DRAWN
CHK'D
APPV'D
MFG
Q.A | | | | MATERIAL: | Units IPS | A3

SOLIDWORKS Educational Product. For Instructional Use Only.
