bsobeloffgittes/NFR25-CAD/Chassis/Pedalbox/Drawings!!!/springHolder_3_1_25.pdf

4

3

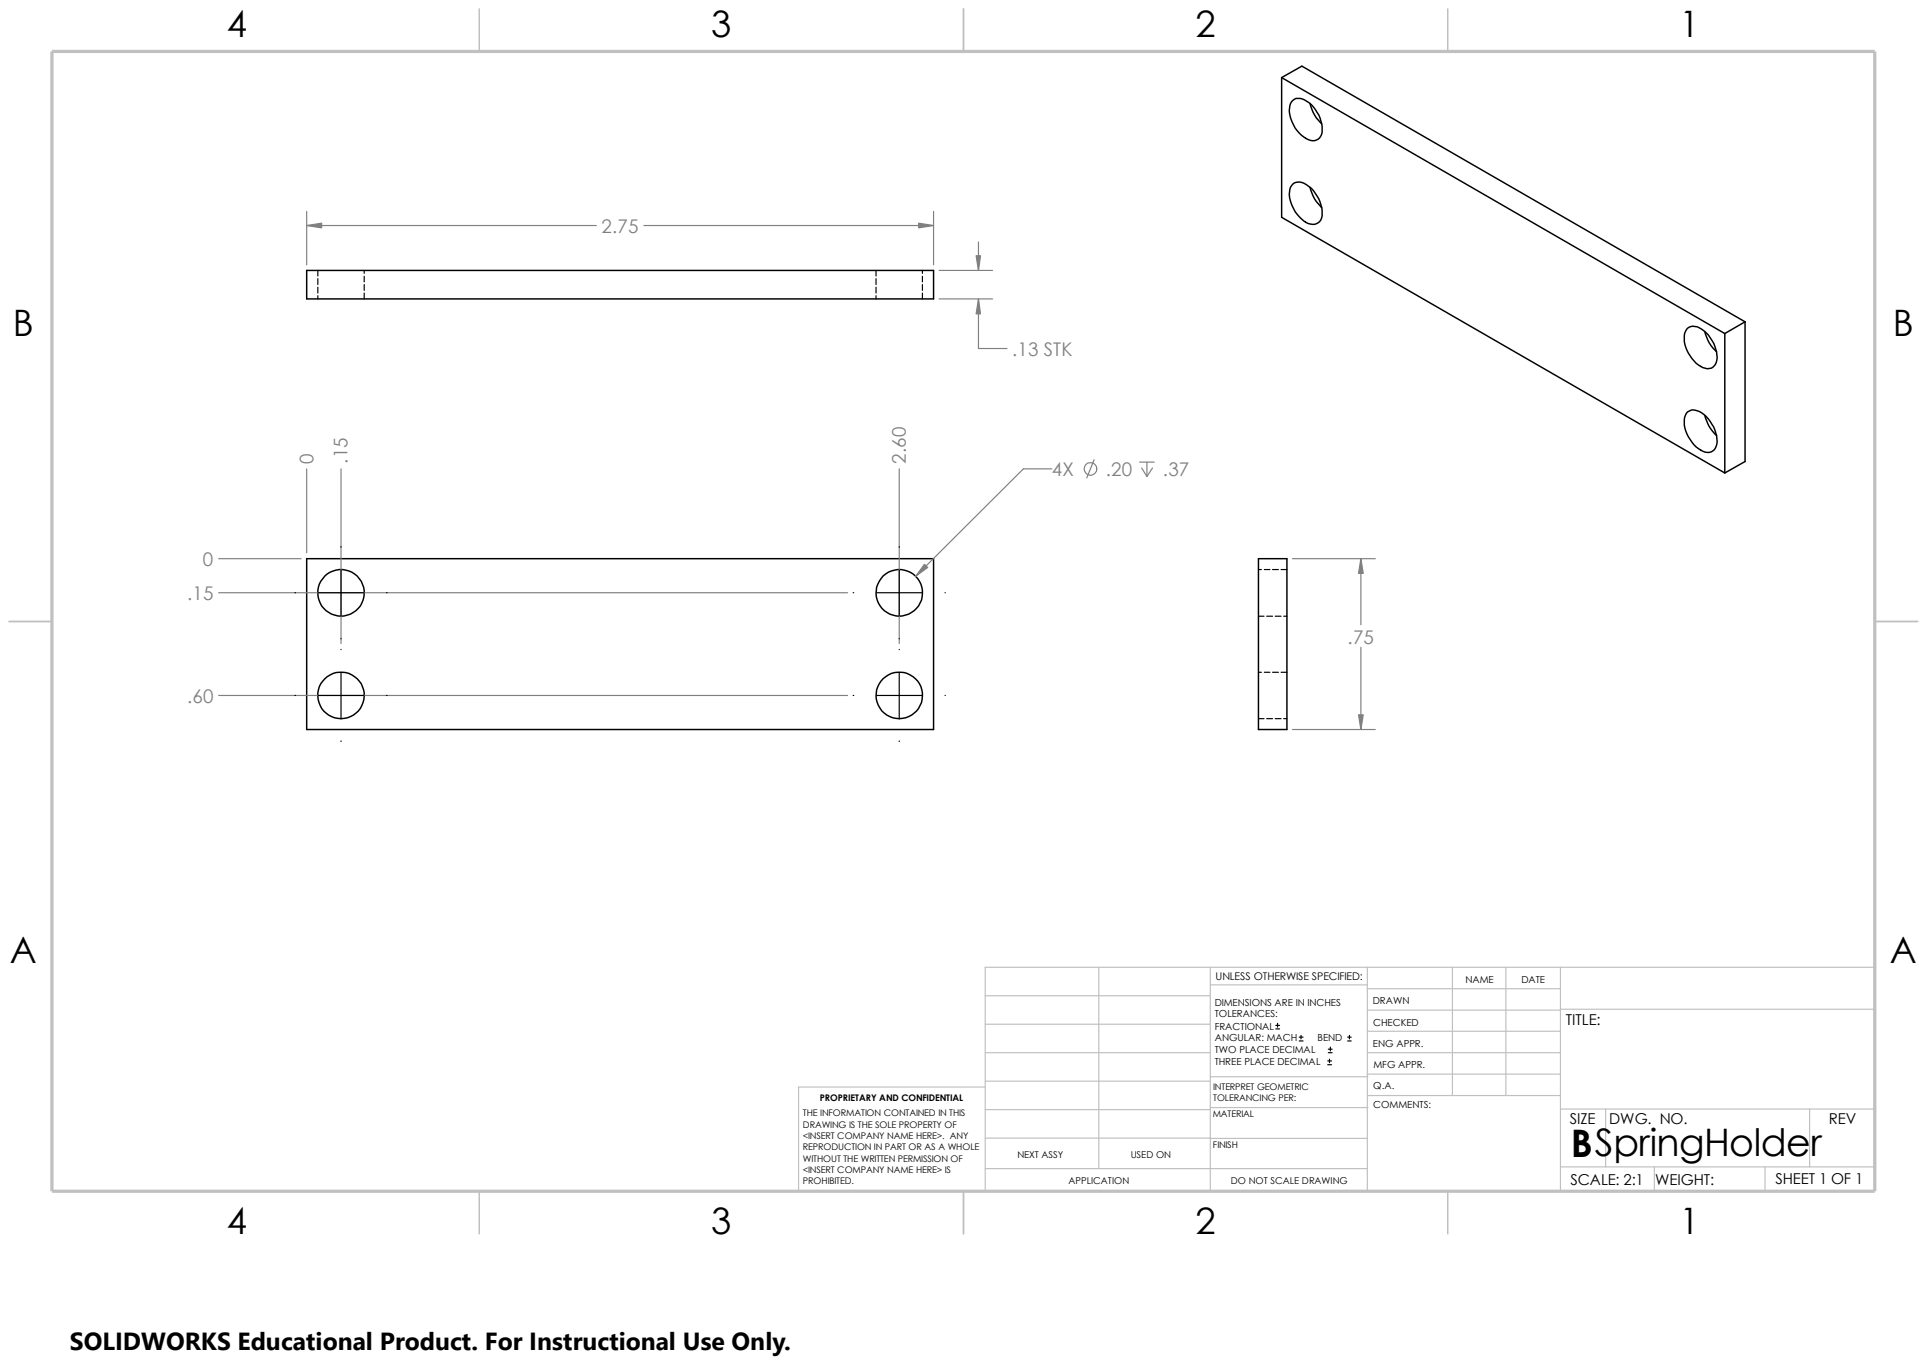
[picture p157: page 1]
COMMENTS:; .13 STK

UNLESS OTHERWISE SPECIFIED: | | NAME | DATE

DIMENSIONS ARE IN INCHES TOLERANCES: FRACTIONAL ANGULAR: MACH BEND TWO PLACE DECIMAL THREE PLACE DECIMAL | DRAWN

CHECKED | | | TITLE:

ENG APPR.

MFG APPR.

PROPRIETARY AND CONFIDENTIAL
THE INFORMATION CONTAINED IN THIS
DRAWING IS THE SOLE PROPERTY OF
<INSERT COMPANY NAME HERE>. ANY
REPRODUCTION IN PART OR AS A WHOLE
WITHOUT THE WRITTEN PERMISSION OF
<INSERT COMPANY NAME HERE> IS
PROHIBITED.

INTERPRET GEOMETRIC TOLERANCING PER: | Q.A.
MATERIAL | | SIZE B SpringHolder | DWG. NO. | REV

NEXT ASSY | USED ON | FINISH

APPLICATION | DO NOT SCALE DRAWING | | SCALE: 2:1 | WEIGHT: | SHEET 1 OF 1

SOLIDWORKS Educational Product. For Instructional Use Only.
