bsobeloffgittes/NFR25-CAD/Chassis/Pedalbox/Drawings!!!/throttle_shaft_3_1_25.pdf

# For 1/4-28 Set Screw

.14

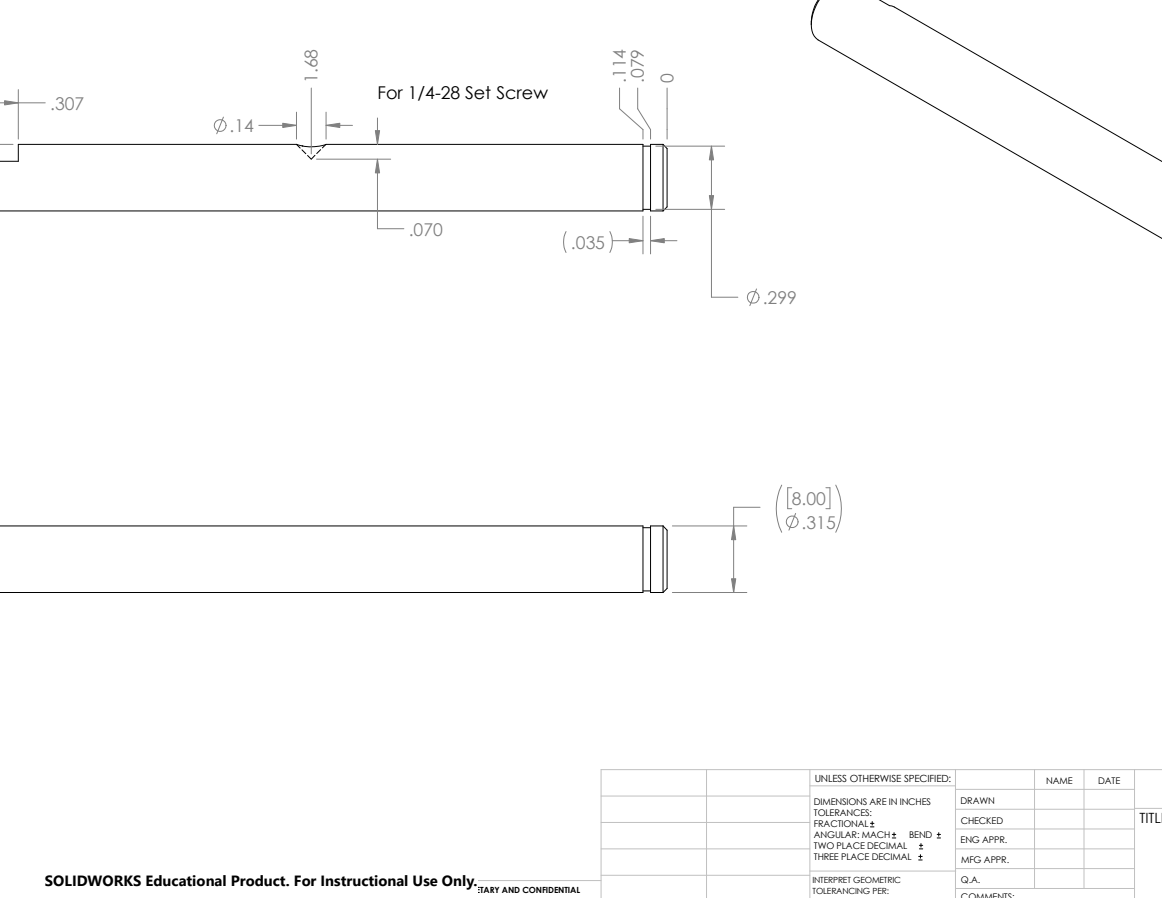
[picture p158: page 1]
TITLE:; NAME; DATE; COMMENTS:; INTERPRET GEOMETRIC; PROPRIETARY AND CONFIDENTIAL; TOLERANCING PER:

UNLESS OTHERWISE SPECIFIED:

DIMENSIONS ARE IN INCHES TOLERANCES: FRACTIONAL ANGULAR: MACH BEND TWO PLACE DECIMAL THREE PLACE DECIMAL | DRAWN

CHECKED
ENG APPR.
MFG APPR.
Q.A.

SOLIDWORKS Educational Product. For Instructional Use Only.
