bsobeloffgittes/NFR25-CAD/Chassis/Pedalbox/Drawings!!!/ThrottlePedal_corrected_3_1_25.pdf

1.10 0

.38

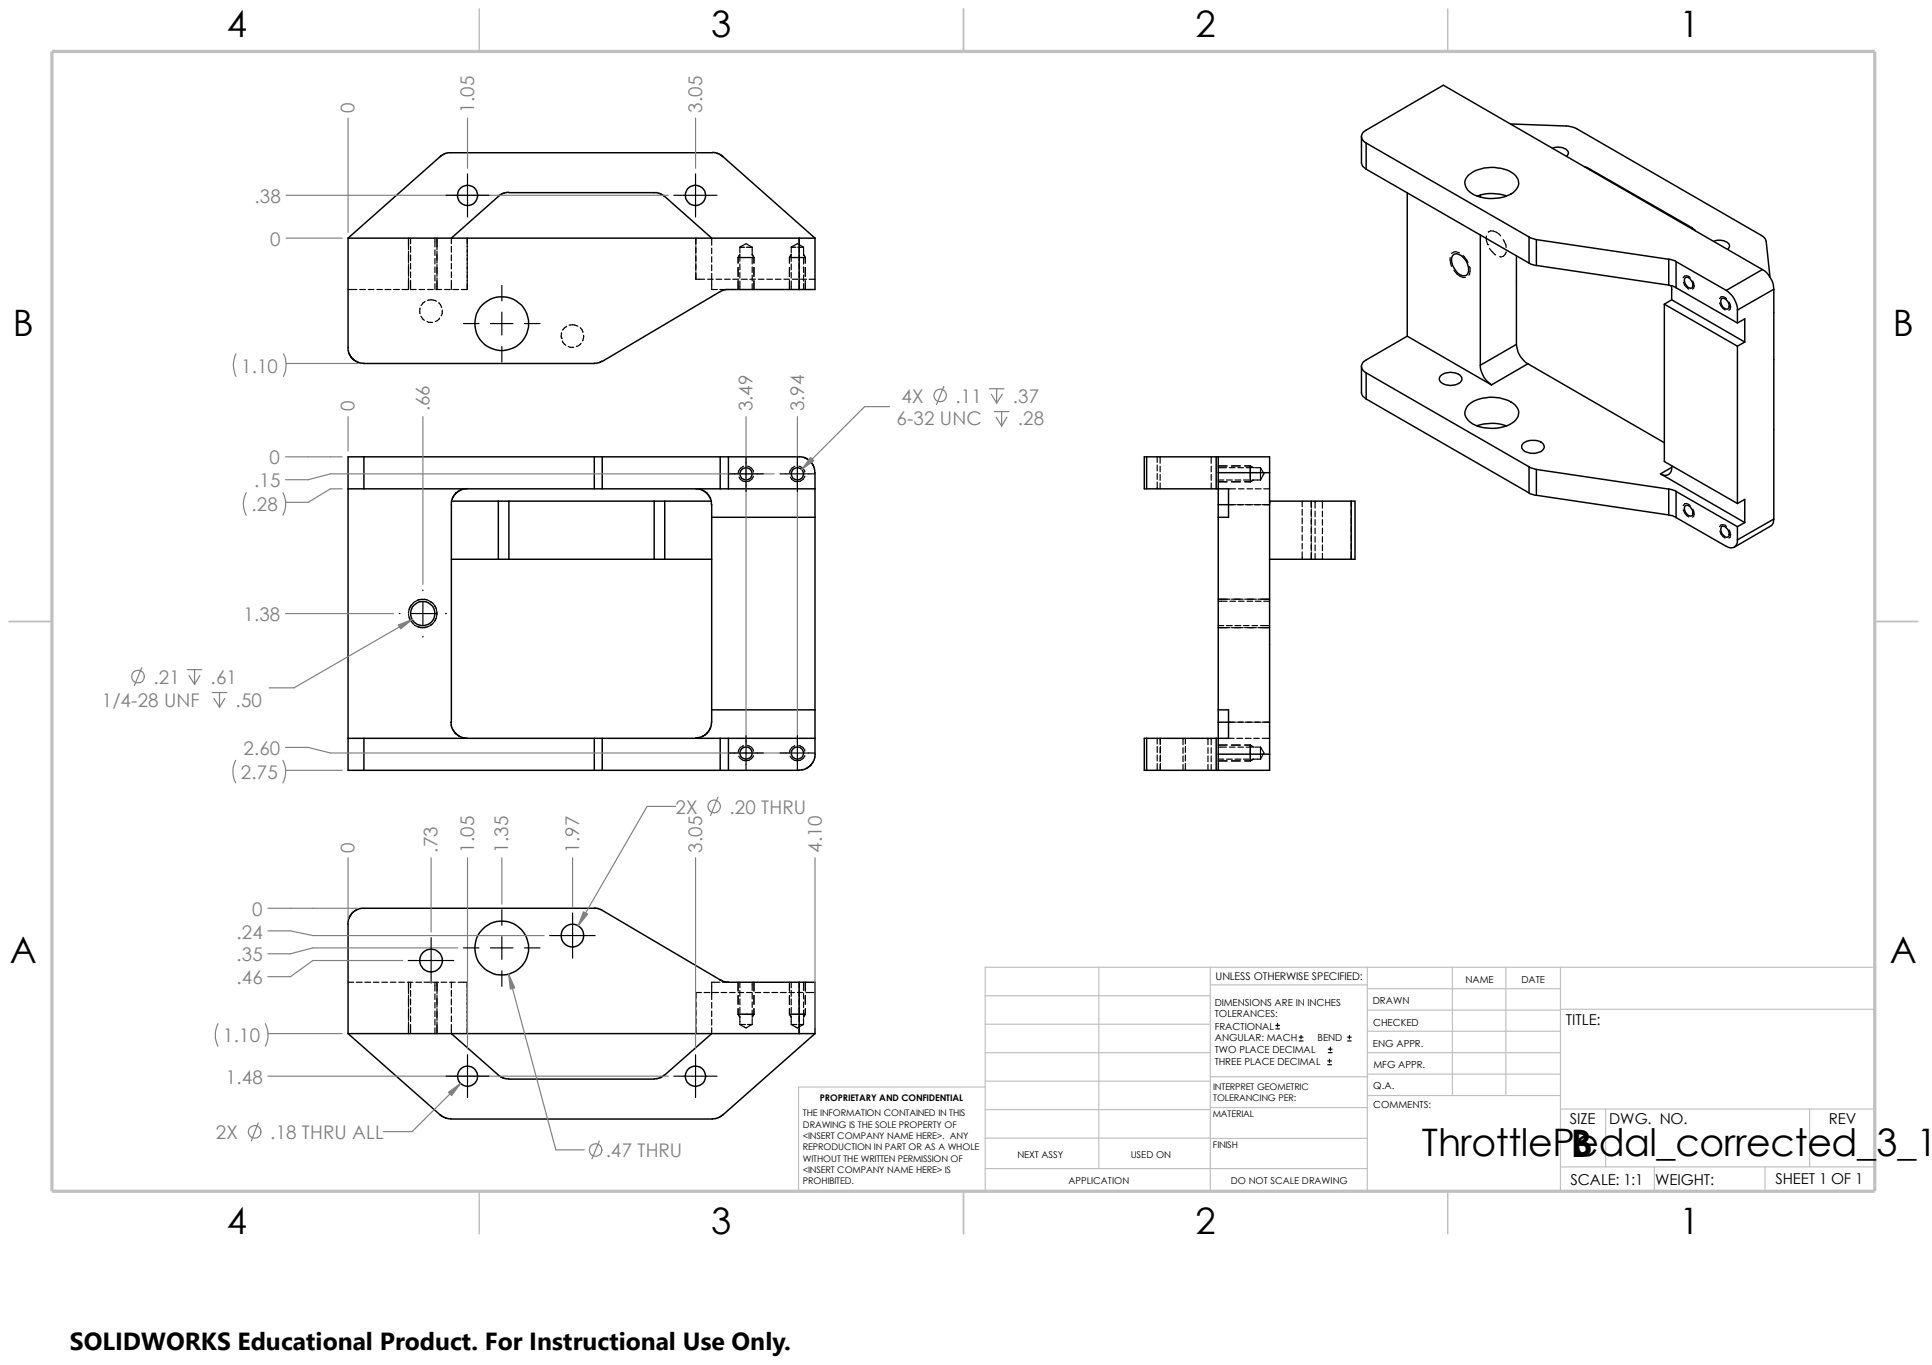
[picture p159: page 1]
ThrottlePedal_corrected_3_1_25; COMMENTS:; 6-32 UNC; 1/4-28 UNF; .47 THRU; .20 THRU; .18 THRU ALL

UNLESS OTHERWISE SPECIFIED: | | NAME | DATE

DIMENSIONS ARE IN INCHES TOLERANCES: FRACTIONAL ANGULAR: MACH BEND TWO PLACE DECIMAL THREE PLACE DECIMAL | DRAWN

CHECKED | | | TITLE:

ENG APPR.

MFG APPR.

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

INTERPRET GEOMETRIC TOLERANCING PER: | Q.A.
MATERIAL | | SIZE B | DWG. NO. | REV

NEXT ASSY | USED ON | FINISH

APPLICATION | DO NOT SCALE DRAWING | | SCALE: 1:1 | WEIGHT: | SHEET 1 OF 1

SOLIDWORKS Educational Product. For Instructional Use Only.
