bsobeloffgittes/NFR25-CAD/Chassis/Pedalbox/Drawings!!!/ThrottleSpacer3_3_1_25.pdf

4

3

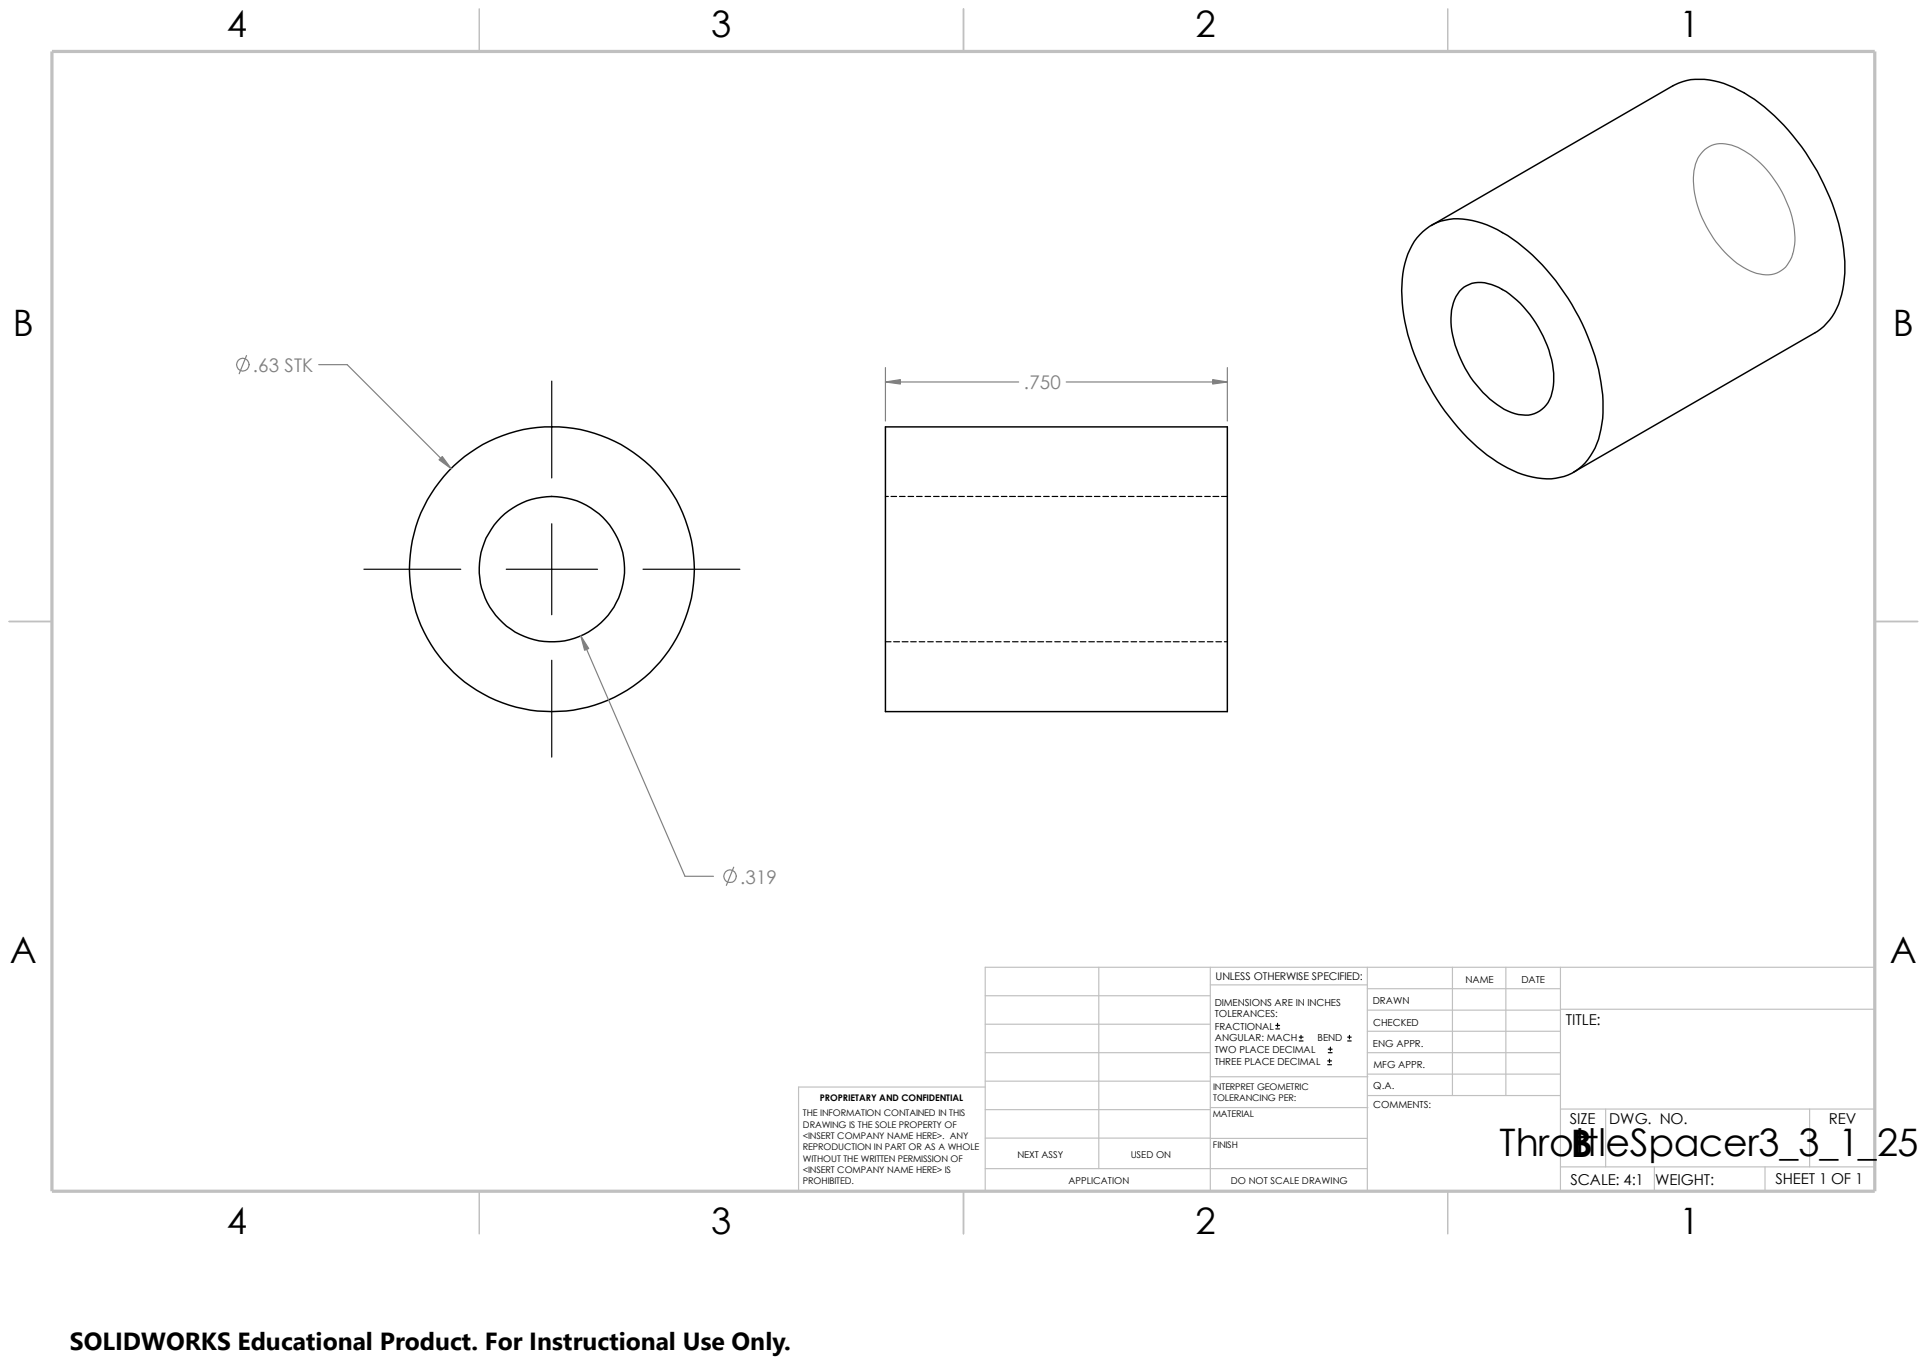
[picture p160: page 1]
ThrottleSpacer3_3_1_25; COMMENTS:; .63 STK

UNLESS OTHERWISE SPECIFIED: | | NAME | DATE

DIMENSIONS ARE IN INCHES TOLERANCES: FRACTIONAL ANGULAR: MACH TWO PLACE DECIMAL THREE PLACE DECIMAL | DRAWN ENG APPR. BEND

CHECKED | | | TITLE:

MFG APPR.

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

INTERPRET GEOMETRIC TOLERANCING PER: | Q.A.
MATERIAL | | SIZE B | DWG. NO. | REV

NEXT ASSY | USED ON | FINISH

APPLICATION | DO NOT SCALE DRAWING | | SCALE: 4:1 | WEIGHT: | SHEET 1 OF 1

SOLIDWORKS Educational Product. For Instructional Use Only.
