bsobeloffgittes/NFR25-CAD/Aerodynamics/Wing Molds/STEP/FW1_v1.pdf

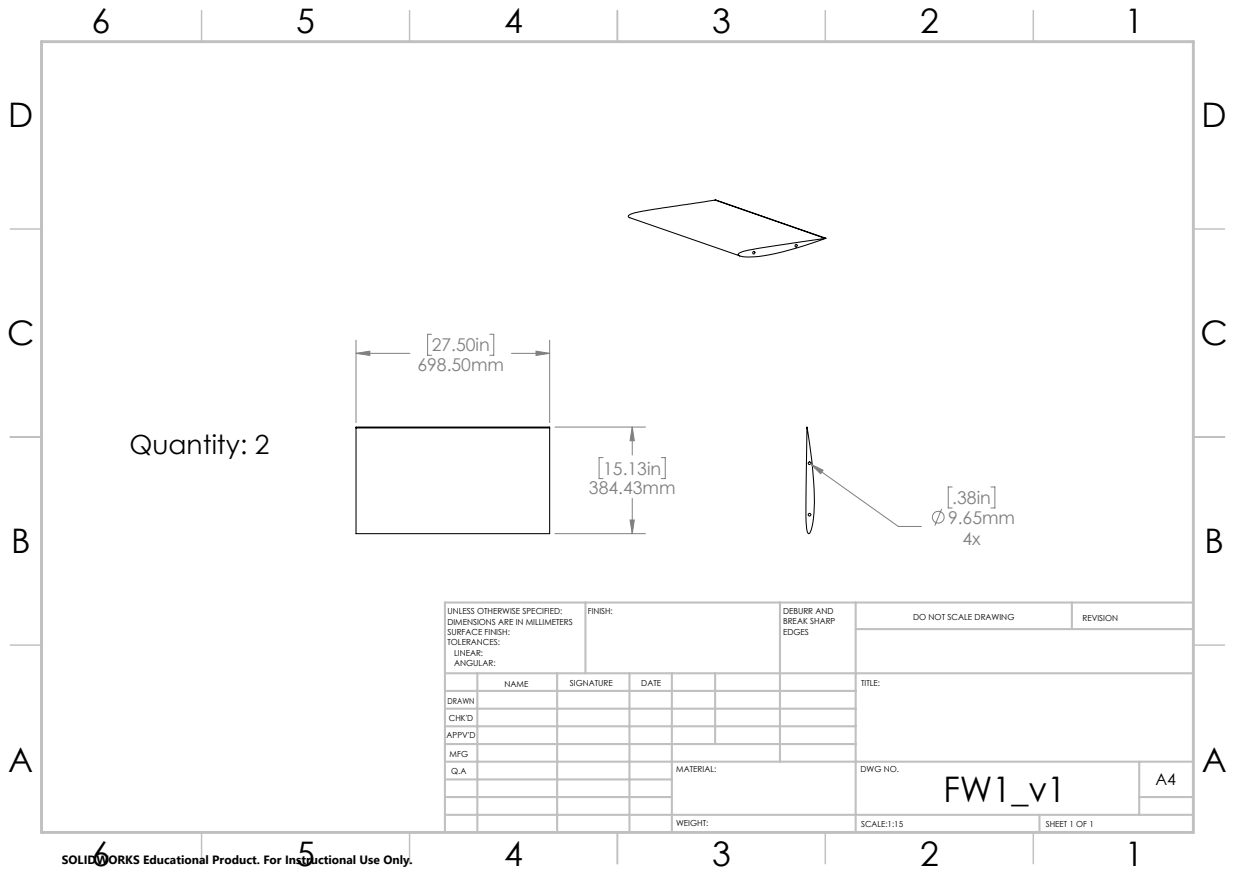
[picture p161: page 1]
Quantity: 2; FINISH:; DEBURR AND; BREAK SHARP; DO NOT SCALE DRAWING; REVISION; SCALE:1:15; SHEET 1 OF 1

UNLESS OTHERWISE SPECIFIED:
DIMENSIONS ARE IN MILLIMETERS
SURFACE FINISH:
TOLERANCES:
LINEAR:
ANGULAR:

NAME | SIGNATURE | DATE | | | | TITLE:

DRAWN
CHK'D
APPV'D
MFG
Q.A | | | | MATERIAL: | DWG NO. FW1_v1 | A4

SOLIDWORKS Educational Product. For Instructional Use Only.
