bsobeloffgittes/NFR25-CAD/Vehicle Integration/Motor Dyno/Planet Gear.pdf

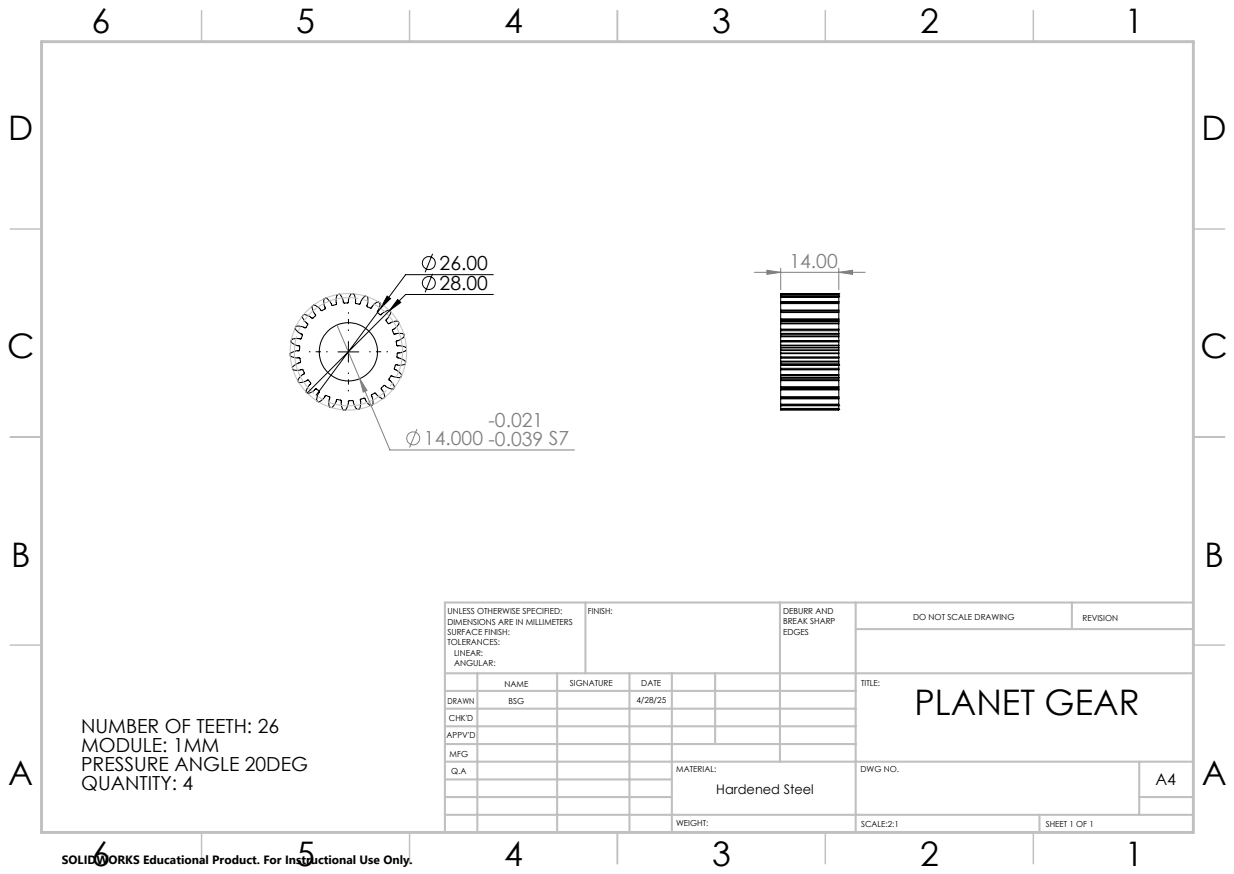
[picture p163: page 1]
PRESSURE ANGLE 20DEG A; QUANTITY: 4; FINISH:; DEBURR AND; BREAK SHARP; DO NOT SCALE DRAWING; REVISION; SCALE:2:1; SHEET 1 OF 1

UNLESS OTHERWISE SPECIFIED:
DIMENSIONS ARE IN MILLIMETERS
SURFACE FINISH:
TOLERANCES:
LINEAR:
ANGULAR:

DRAWN | BSG | | 4/28/25

NAME | SIGNATURE | DATE | | | | TITLE: PLANET GEAR

NUMBER OF TEETH: 26
MODULE: 1MM
SOLIDWORKS Educational Product. For Instructional Use Only.

CHK'D
APPV'D
MFG
Q.A | | | | MATERIAL: Hardened Steel | DWG NO. | A4
