bsobeloffgittes/NFR25-CAD/Vehicle Integration/Motor Dyno/Planetary Gear Set Rev A-01.pdf

16.00
D | D

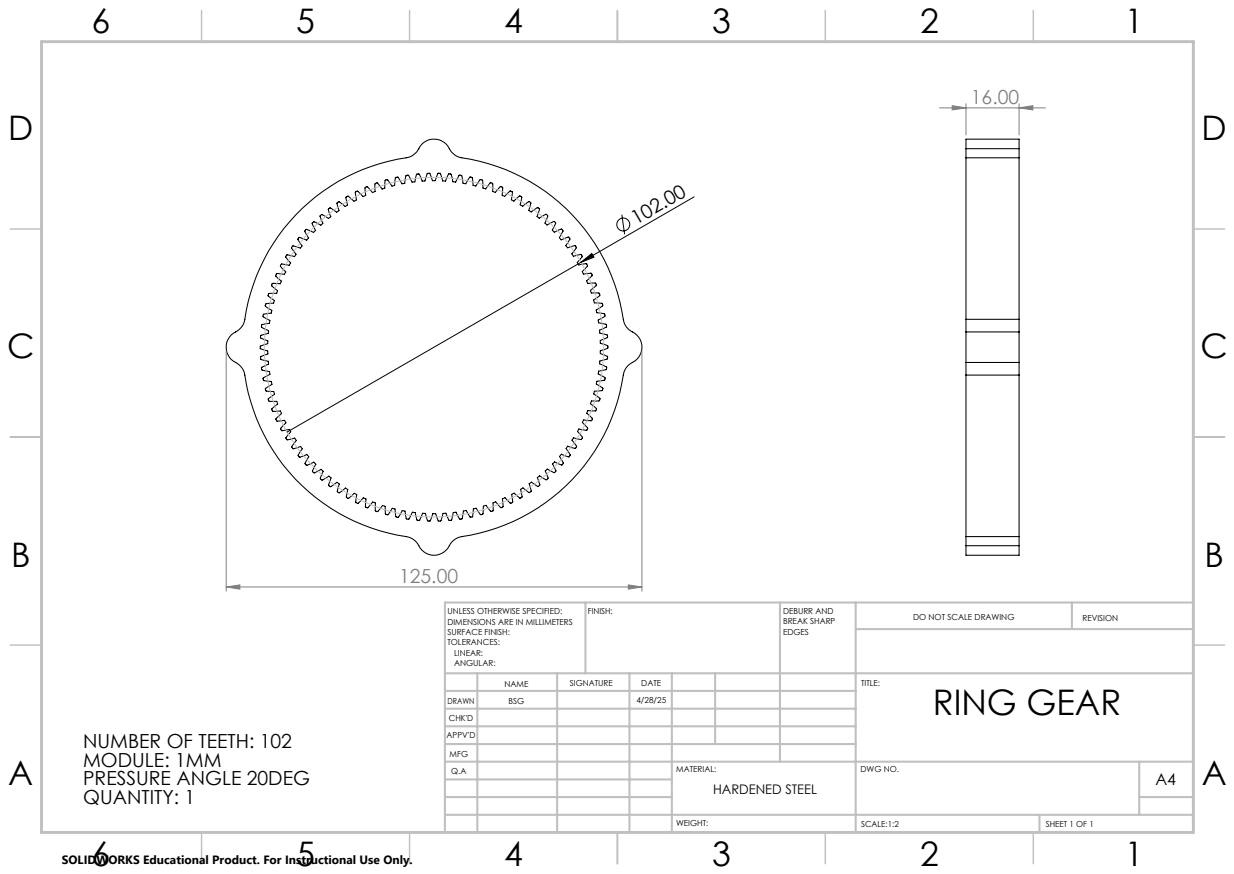
[picture p164: page 1]
FINISH:; DEBURR AND; BREAK SHARP EDGES; DO NOT SCALE DRAWING; REVISION; SCALE:1:2; SHEET 1 OF 1; WEIGHT:

UNLESS OTHERWISE SPECIFIED:
DIMENSIONS ARE IN MILLIMETERS
SURFACE FINISH:
TOLERANCES:
LINEAR:
ANGULAR:

DRAWN | BSG | | 4/28/25

NAME | SIGNATURE | DATE | | | | TITLE: RING GEAR

CHK'D
APPV'D
MFG
Q.A | | | | MATERIAL: HARDENED STEEL | DWG NO. | A4

NUMBER OF TEETH: 102
MODULE: 1MM
PRESSURE ANGLE 20DEG
QUANTITY: 1

SOLIDWORKS Educational Product. For Instructional Use Only.

D | D

PRESSURE ANGLE 20DEG A; QUANTITY: 4; FINISH:; DEBURR AND; BREAK SHARP EDGES; DO NOT SCALE DRAWING; REVISION; SCALE:2:1; SHEET 1 OF 1

UNLESS OTHERWISE SPECIFIED:
DIMENSIONS ARE IN MILLIMETERS
SURFACE FINISH:
TOLERANCES:
LINEAR:
ANGULAR:

DRAWN | BSG | | 4/28/25

NAME | SIGNATURE | DATE | | | | TITLE: PLANET GEAR

NUMBER OF TEETH: 26
MODULE: 1MM

CHK'D
APPV'D
MFG
Q.A | | | | MATERIAL: Hardened Steel | DWG NO. | A4

12.000

+0.018

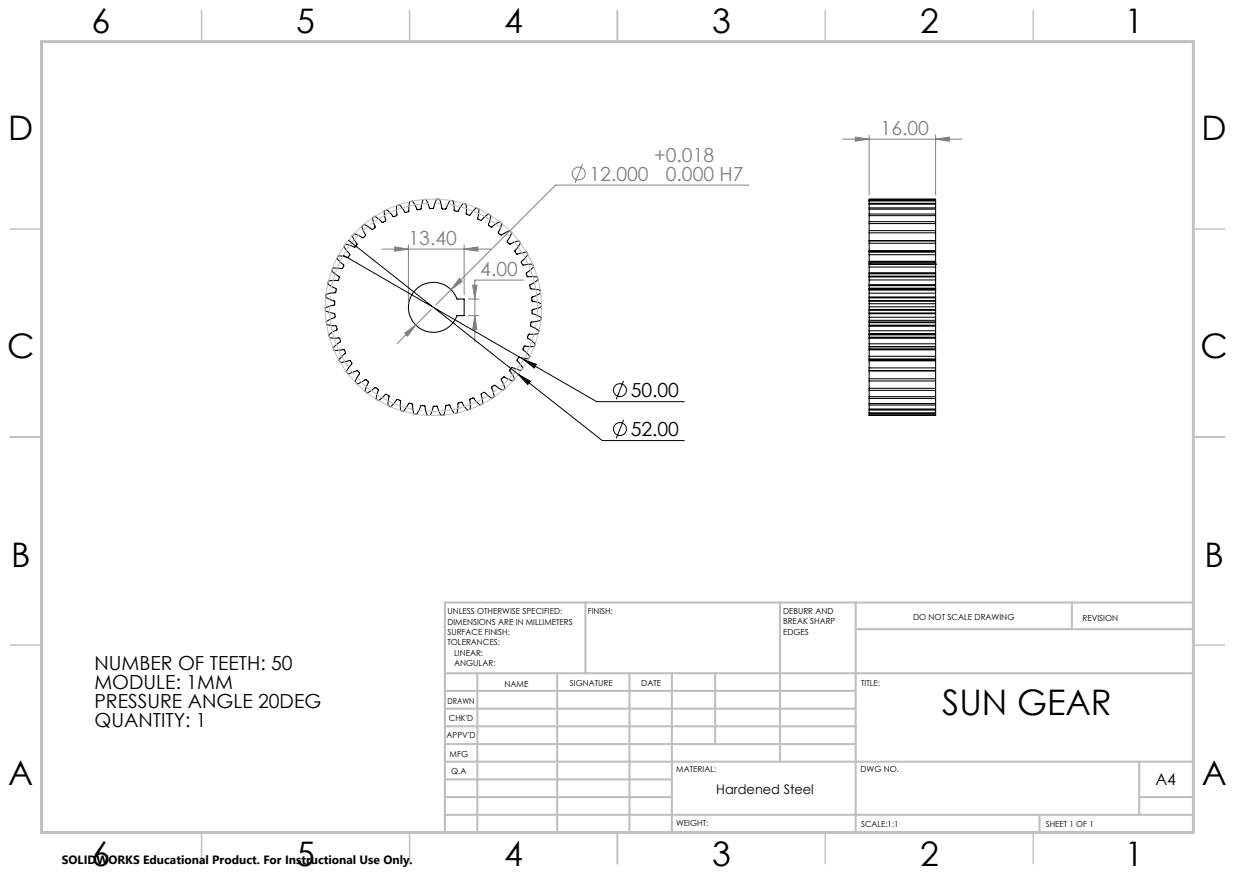
[picture p165: page 3]
FINISH:; DEBURR AND; BREAK SHARP EDGES; DO NOT SCALE DRAWING; REVISION; SCALE:1:1; SHEET 1 OF 1

UNLESS OTHERWISE SPECIFIED:
DIMENSIONS ARE IN MILLIMETERS
SURFACE FINISH:
TOLERANCES:
LINEAR:
ANGULAR:

NUMBER OF TEETH: 50
MODULE: 1MM
PRESSURE ANGLE 20DEG
QUANTITY: 1

NAME | SIGNATURE | DATE | | | | TITLE: SUN GEAR

DRAWN
CHK'D
APPV'D
MFG
Q.A | | | | MATERIAL: Hardened Steel | DWG NO. | A4
