bsobeloffgittes/NFR25-CAD/Suspension/Arms/steel_wishbone_insert_nfr25_DWG.pdf

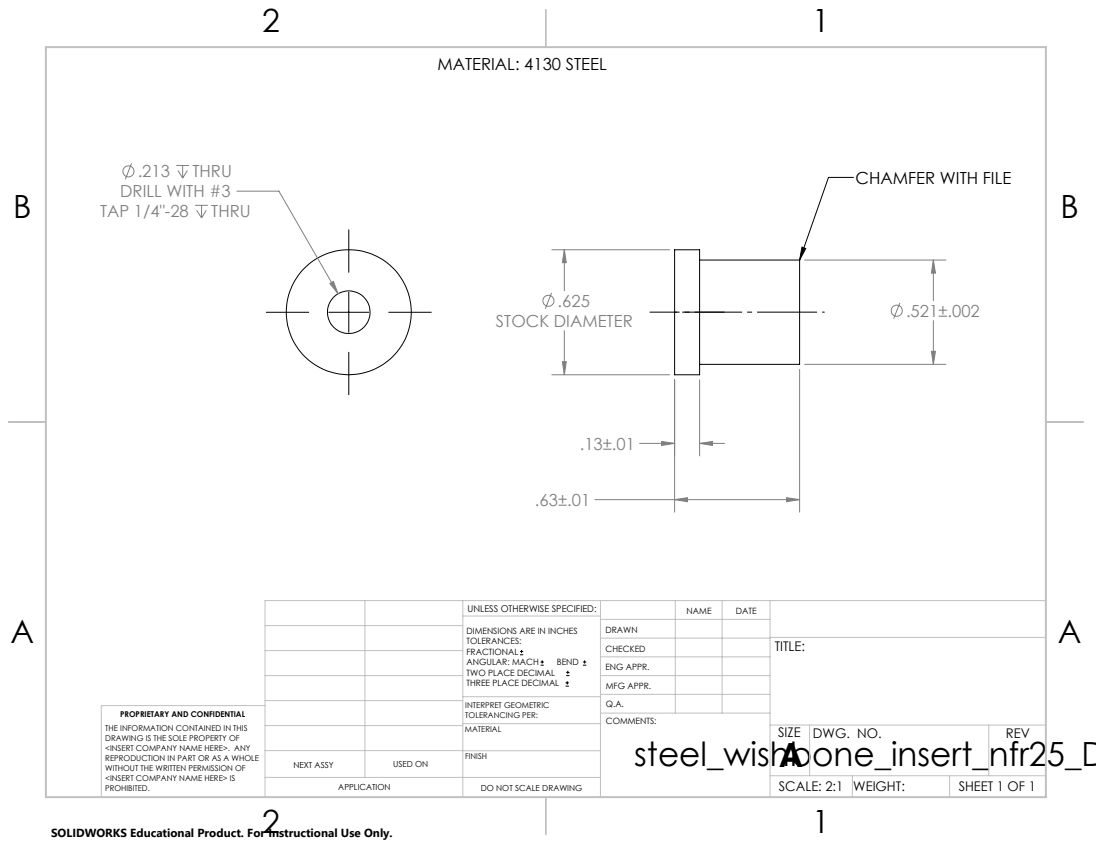
[picture p166: page 1]
.213 THRU DRILL WITH #3 TAP 1/4"-28 THRU; STOCK DIAMETER; MATERIAL: 4130 STEEL

CHAMFER WITH FILE

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

CHECKED | | | TITLE:

ENG APPR.
MFG APPR.

INTERPRET GEOMETRIC TOLERANCING PER: | Q.A.
MATERIAL | | SIZE A | DWG. NO. | REV

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

NEXT ASSY | USED ON | FINISH

APPLICATION | DO NOT SCALE DRAWING | | SCALE: 2:1 | WEIGHT: | SHEET 1 OF 1

SOLIDWORKS Educational Product. For Instructional Use Only.
