bsobeloffgittes/NFR25-CAD/Accumulator/Drawings/Segment Drawings/cold_plate_drawing.pdf

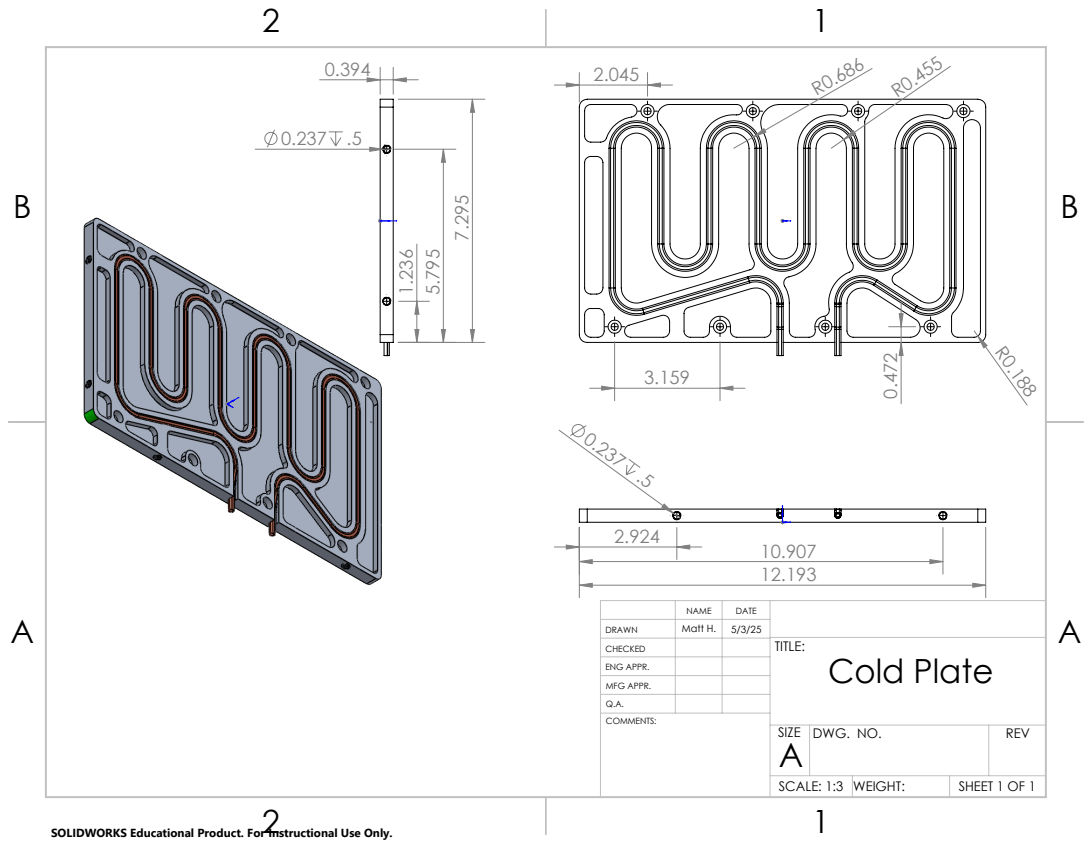
[picture p167: page 1]

NAME | DATE
CHECKED | | | TITLE: Cold Plate

DRAWN | Matt H. | 5/3/25

ENG APPR.
MFG APPR.
Q.A.

SIZE A | DWG. NO. | REV

SCALE: 1:3 | WEIGHT: | SHEET 1 OF 1

SOLIDWORKS Educational Product. For Instructional Use Only.
