bsobeloffgittes/NFR25-CAD/Accumulator/Drawings/Segment Drawings/segment_bolt_tube_drawing.pdf

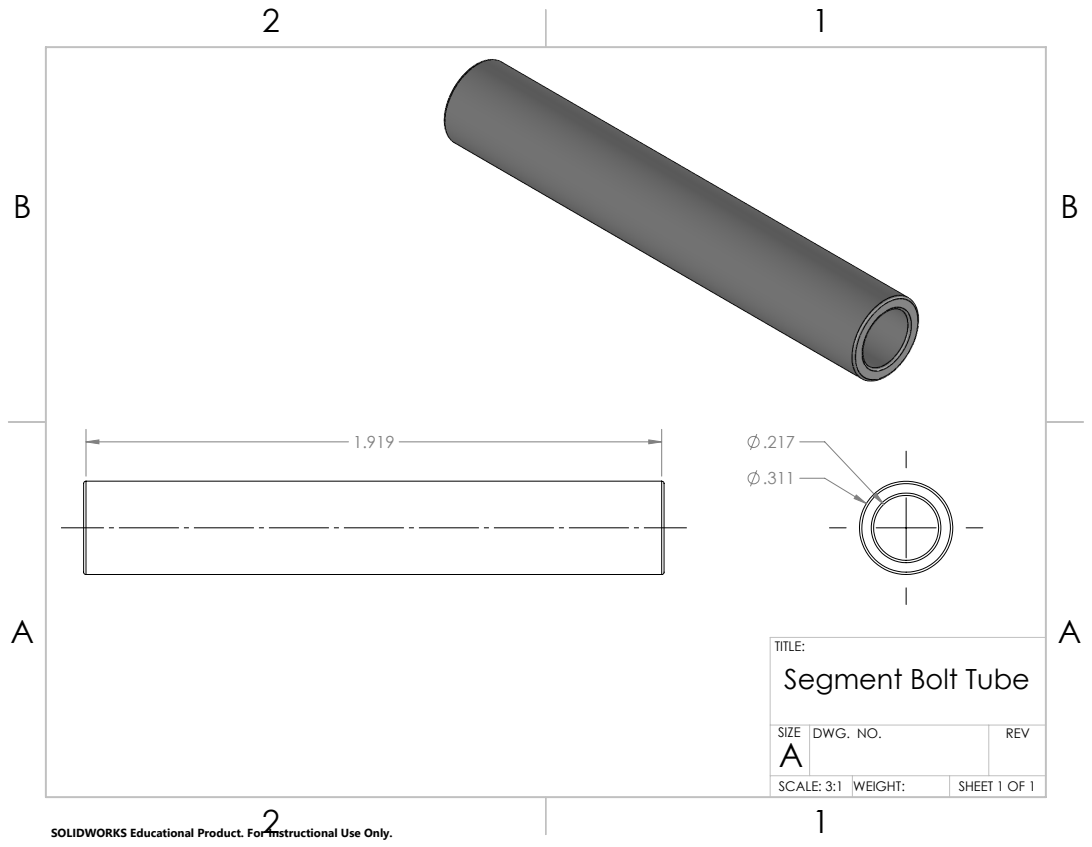
[picture p168: page 1]

TITLE:
Segment Bolt Tube

SIZE A | DWG. NO. | REV

SCALE: 3:1 | WEIGHT: | SHEET 1 OF 1

SOLIDWORKS Educational Product. For Instructional Use Only.
