bsobeloffgittes/NFR25-CAD/Accumulator/Drawings/Water Cooling Drawings/1-4_barb_drawing.PDF

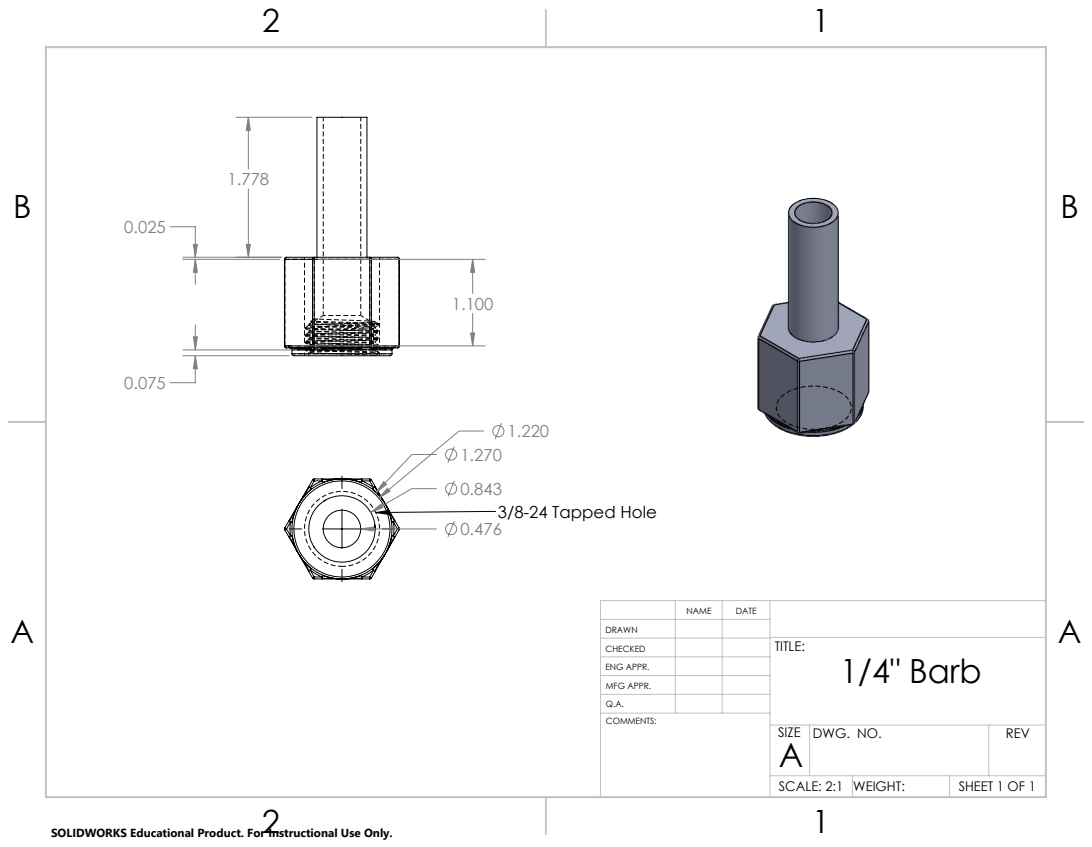
[picture p169: page 1]
3/8-24 Tapped Hole

NAME | DATE
CHECKED | | | TITLE: 1/4" Barb

DRAWN

ENG APPR.
MFG APPR.
Q.A.

SIZE A | DWG. NO. | REV

SCALE: 2:1 | WEIGHT: | SHEET 1 OF 1

SOLIDWORKS Educational Product. For Instructional Use Only.
