bsobeloffgittes/NFR25-CAD/Accumulator/Drawings/Water Cooling Drawings/right_angle_fitting_drawing.pdf

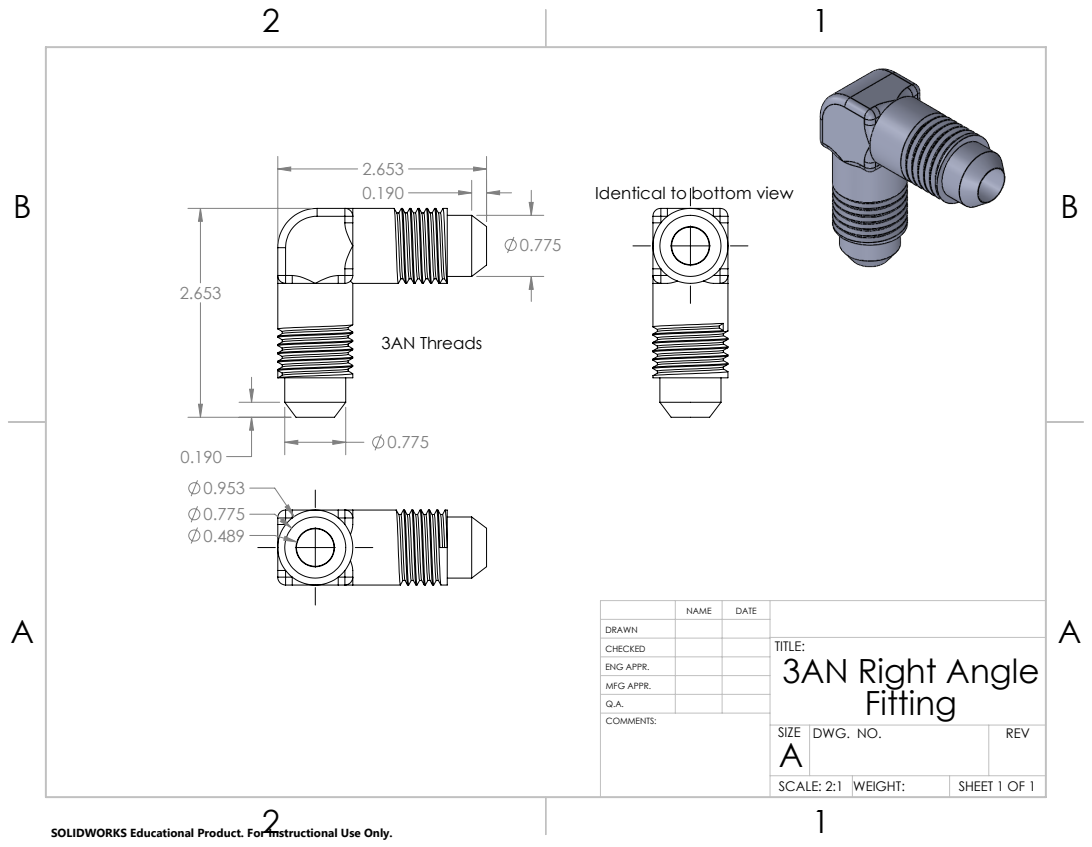
[picture p170: page 1]
3AN Threads

Identical to bottom view

NAME | DATE
CHECKED | | | TITLE: 3AN Right Angle Fitting

DRAWN

ENG APPR.
MFG APPR.
Q.A.

SIZE A | DWG. NO. | REV

SCALE: 2:1 | WEIGHT: | SHEET 1 OF 1

SOLIDWORKS Educational Product. For Instructional Use Only.
