bsobeloffgittes/NFR25-CAD/Accumulator/Drawings/Water Cooling Drawings/tube_nut_drawing.pdf

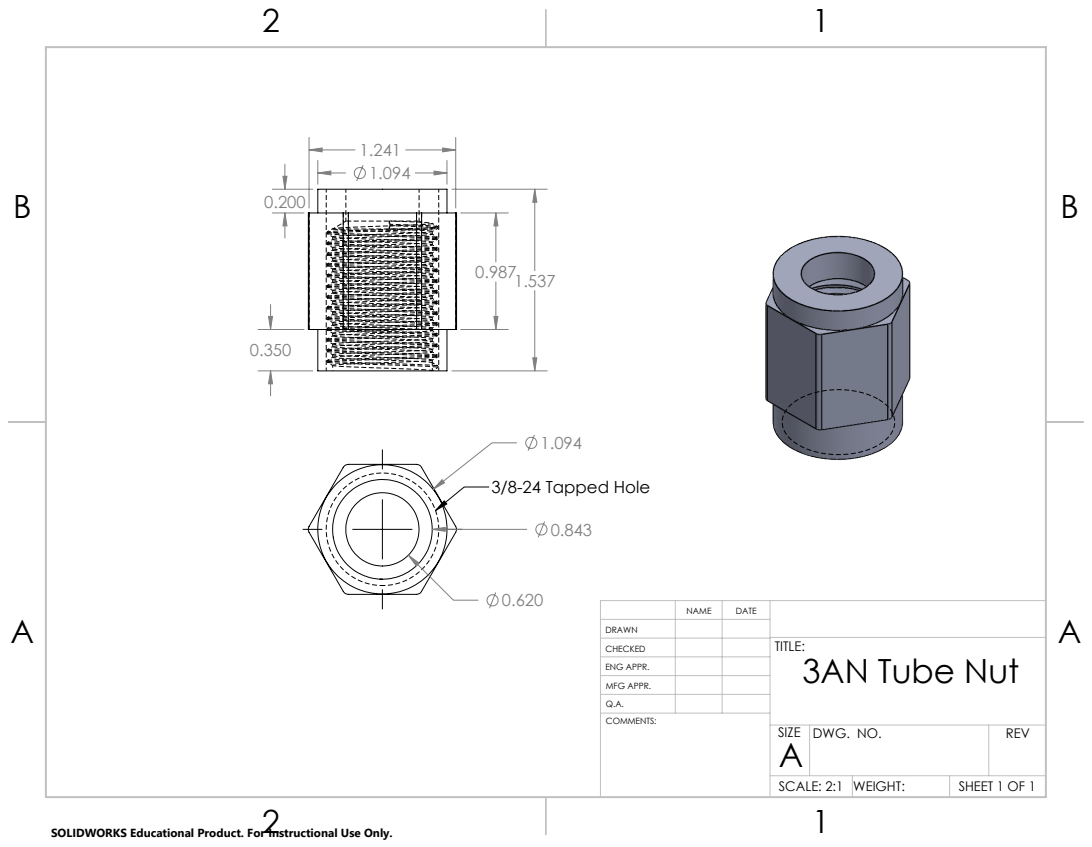
[picture p171: page 1]
3/8-24 Tapped Hole

NAME | DATE
CHECKED | | | TITLE: 3AN Tube Nut

DRAWN

ENG APPR.
MFG APPR.
Q.A.

SIZE A | DWG. NO. | REV

SCALE: 2:1 | WEIGHT: | SHEET 1 OF 1

SOLIDWORKS Educational Product. For Instructional Use Only.
