bsobeloffgittes/NFR25-CAD/Aerodynamics/Front Wing/Drawings/Front_Wing_Assem.pdf

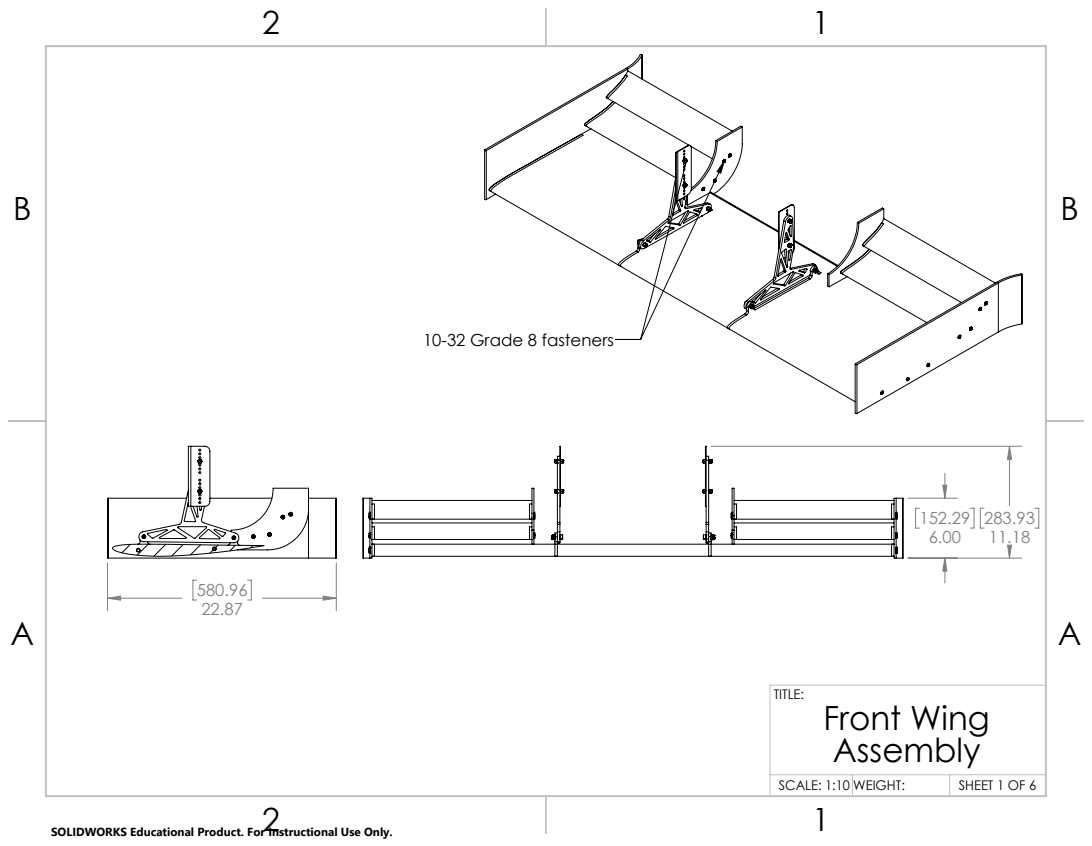
[picture p172: page 1]
10-32 Grade 8 fasteners; Front Wing; SCALE: 1:10 WEIGHT:; SHEET 1 OF 6

SOLIDWORKS Educational Product. For Instructional Use Only.
