bsobeloffgittes/NFR25-CAD/Aerodynamics/Front Wing/Drawings/Front_Wing_Element_2.pdf

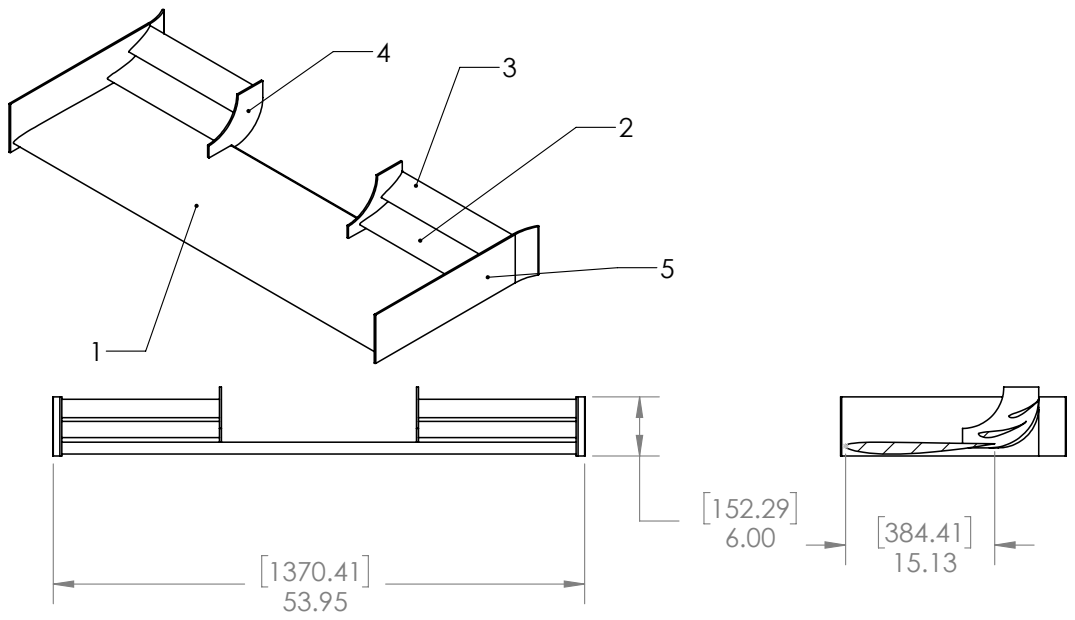
[picture p173: page 1]
Front Wing; SCALE: 1:16 WEIGHT:; SHEET 3 OF 6

Part | Quantity | Raw Material Size | Mold Material Size | Finished Material Size
1 | 1 | 1740 | 1740 | 1582
2 | 2 | 184 | 184 | 168
3 | 2 | 128 | 128 | 117
4 | 2 | 65 | 65 | 59
5 | 2 | 300 | 300 | 274

SOLIDWORKS Educational Product. For Instructional Use Only.
