bsobeloffgittes/NFR25-CAD/Aerodynamics/Front Wing/Drawings/Front_Wing_Elements_1.pdf

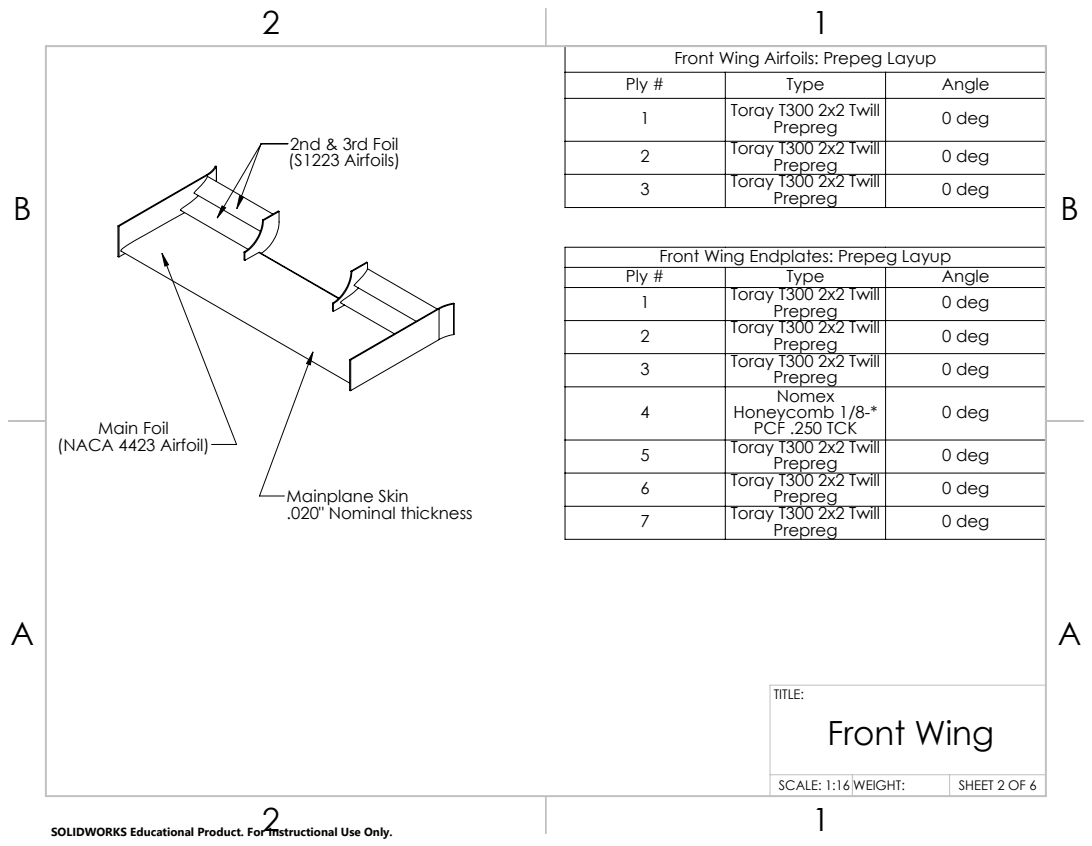
[picture p174: page 1]
2nd & 3rd Foil (S1223 Airfoils); Main Foil (NACA 4423 Airfoil); Mainplane Skin .020" Nominal thickness; Front Wing; SCALE: 1:16 WEIGHT:; SHEET 2 OF 6

Front Wing Airfoils: Prepeg Layup
Ply # | Type | Angle
1 | Toray T300 2x2 Twill Prepreg | 0 deg
2 | Toray T300 2x2 Twill Prepreg | 0 deg
3 | Toray T300 2x2 Twill Prepreg | 0 deg

Front Wing Endplates: Prepeg Layup

4 | Nomex Honeycomb 1/8-* PCF .250 TCK | 0 deg

5 | Toray T300 2x2 Twill Prepreg | 0 deg
6 | Toray T300 2x2 Twill Prepreg | 0 deg
7 | Toray T300 2x2 Twill Prepreg | 0 deg

SOLIDWORKS Educational Product. For Instructional Use Only.
