bsobeloffgittes/NFR25-CAD/Aerodynamics/Front Wing/Drawings/Front_Wing_Mounts.pdf

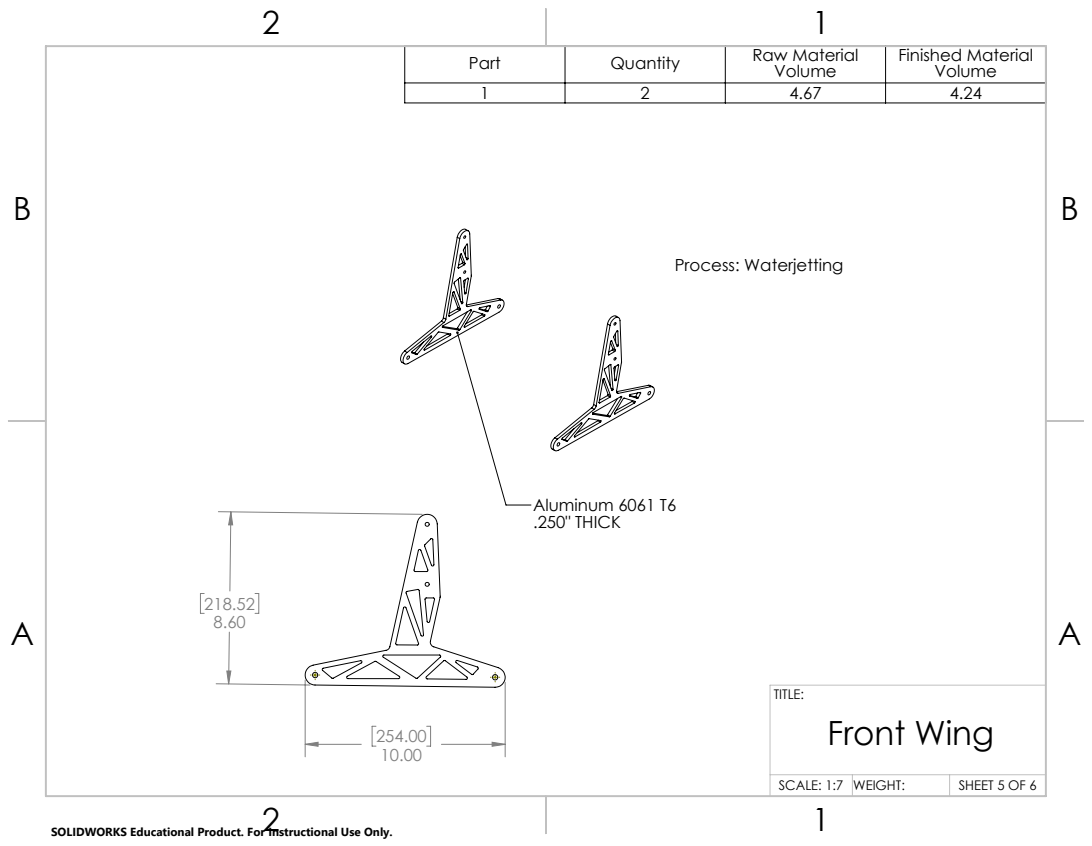
[picture p175: page 1]
Aluminum 6061 T6 .250" THICK; Process: Waterjetting; Front Wing; SCALE: 1:7; WEIGHT:; SHEET 5 OF 6

Part | Quantity | Raw Material Volume | Finished Material Volume
1 | 2 | 4.67 | 4.24

SOLIDWORKS Educational Product. For Instructional Use Only.
