bsobeloffgittes/NFR25-CAD/Aerodynamics/Front Wing/Drawings/Front_Wing_Ribs.pdf

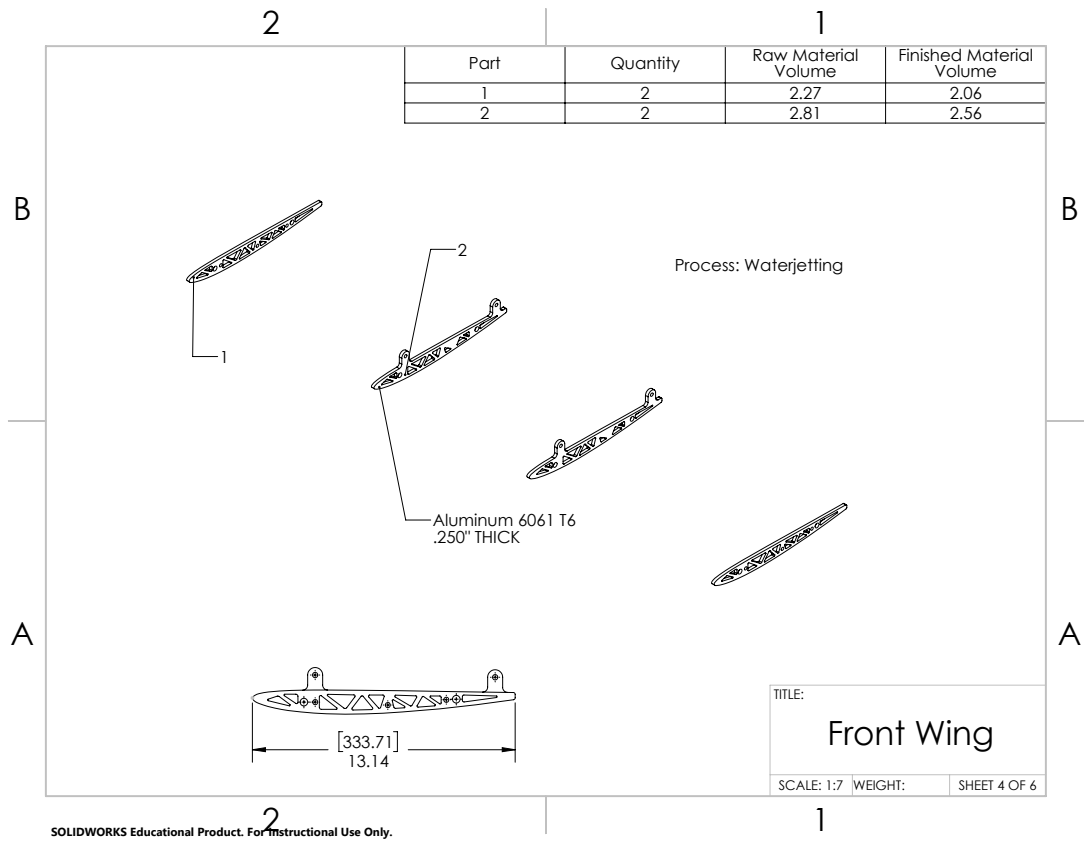
[picture p176: page 1]
Aluminum 6061 T6 .250" THICK; Process: Waterjetting; Front Wing; SCALE: 1:7; WEIGHT:; SHEET 4 OF 6

Part | Quantity | Raw Material Volume | Finished Material Volume
1 | 2 | 2.27 | 2.06
2 | 2 | 2.81 | 2.56

SOLIDWORKS Educational Product. For Instructional Use Only.
