bsobeloffgittes/NFR25-CAD/Aerodynamics/Front Wing/Drawings/Front_Wing_Tabs.pdf

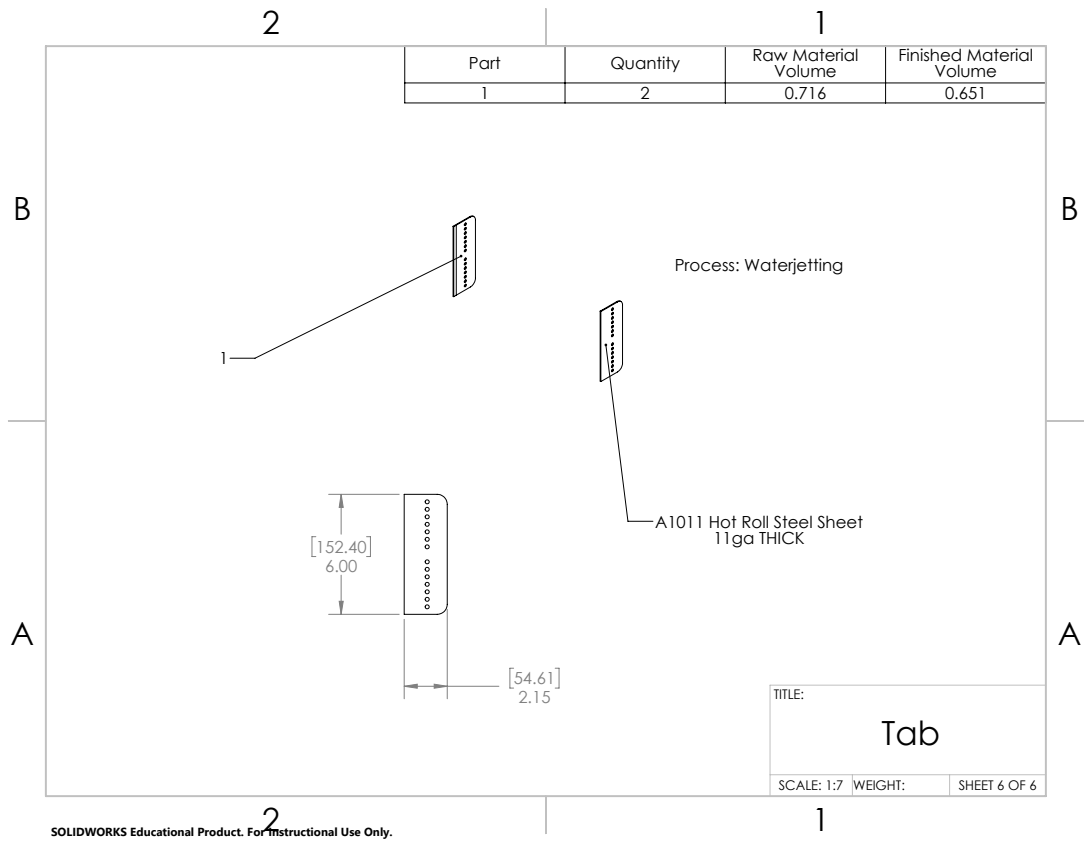
[picture p177: page 1]
Process: Waterjetting; SCALE: 1:7; WEIGHT:; SHEET 6 OF 6

Part | Quantity | Raw Material Volume | Finished Material Volume
1 | 2 | 0.716 | 0.651

A1011 Hot Roll Steel Sheet
11ga THICK

SOLIDWORKS Educational Product. For Instructional Use Only.
