bsobeloffgittes/NFR25-CAD/Aerodynamics/Rear Wing/Drawings/Rear_Wing_Assem.pdf

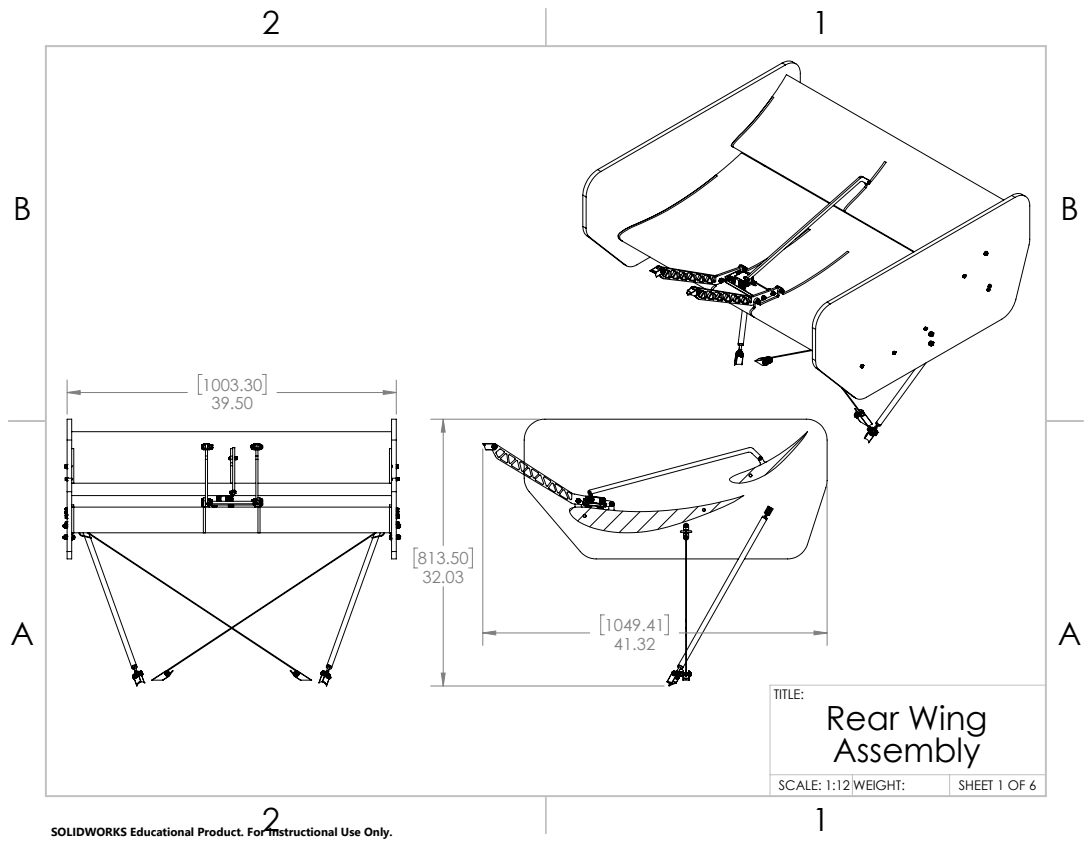
[picture p178: page 1]
Rear Wing; SCALE: 1:12 WEIGHT:; SHEET 1 OF 6

SOLIDWORKS Educational Product. For Instructional Use Only.
