bsobeloffgittes/NFR25-CAD/Aerodynamics/Rear Wing/Drawings/Rear_Wing_Elements_1.pdf

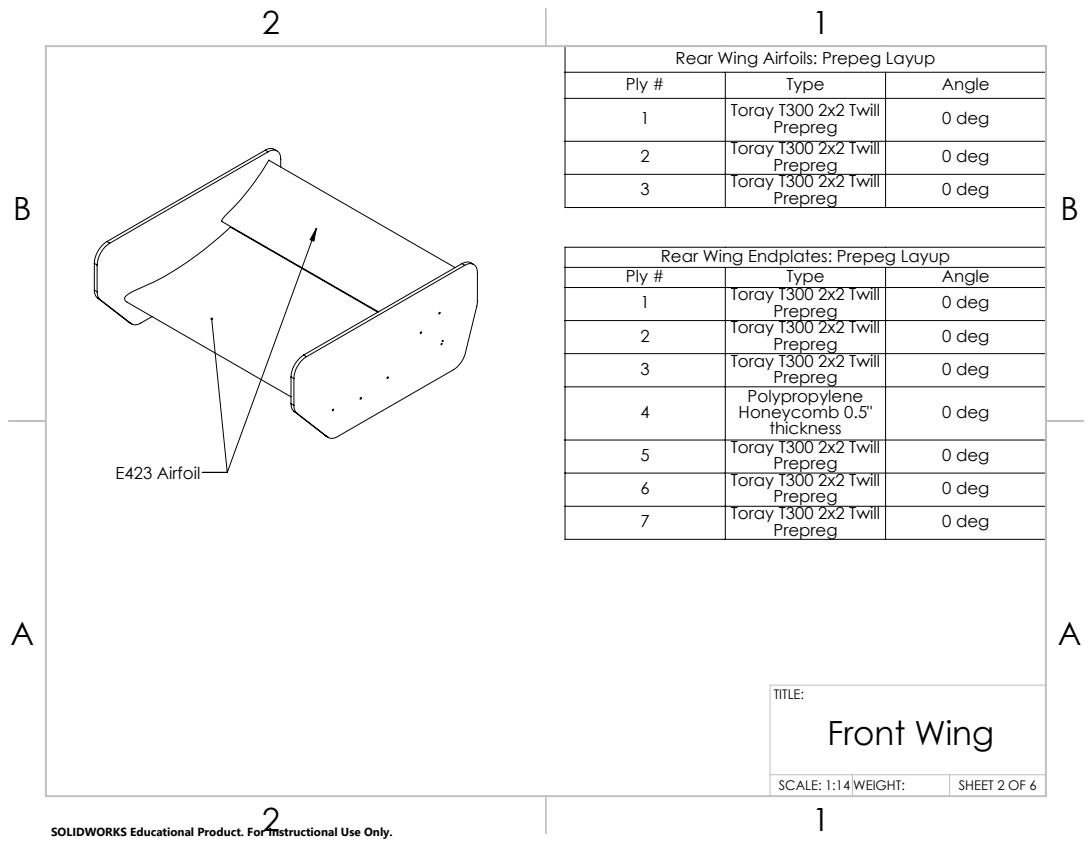
[picture p179: page 1]
E423 Airfoil; Front Wing; SCALE: 1:14 WEIGHT:; SHEET 2 OF 6

Rear Wing Airfoils: Prepeg Layup
Ply # | Type | Angle
1 | Toray T300 2x2 Twill Prepreg | 0 deg
2 | Toray T300 2x2 Twill Prepreg | 0 deg
3 | Toray T300 2x2 Twill Prepreg | 0 deg

Rear Wing Endplates: Prepeg Layup

4 | Polypropylene Honeycomb 0.5" thickness | 0 deg

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

SOLIDWORKS Educational Product. For Instructional Use Only.
