bsobeloffgittes/NFR25-CAD/Aerodynamics/Rear Wing/Drawings/Rear_Wing_Elements_2.pdf

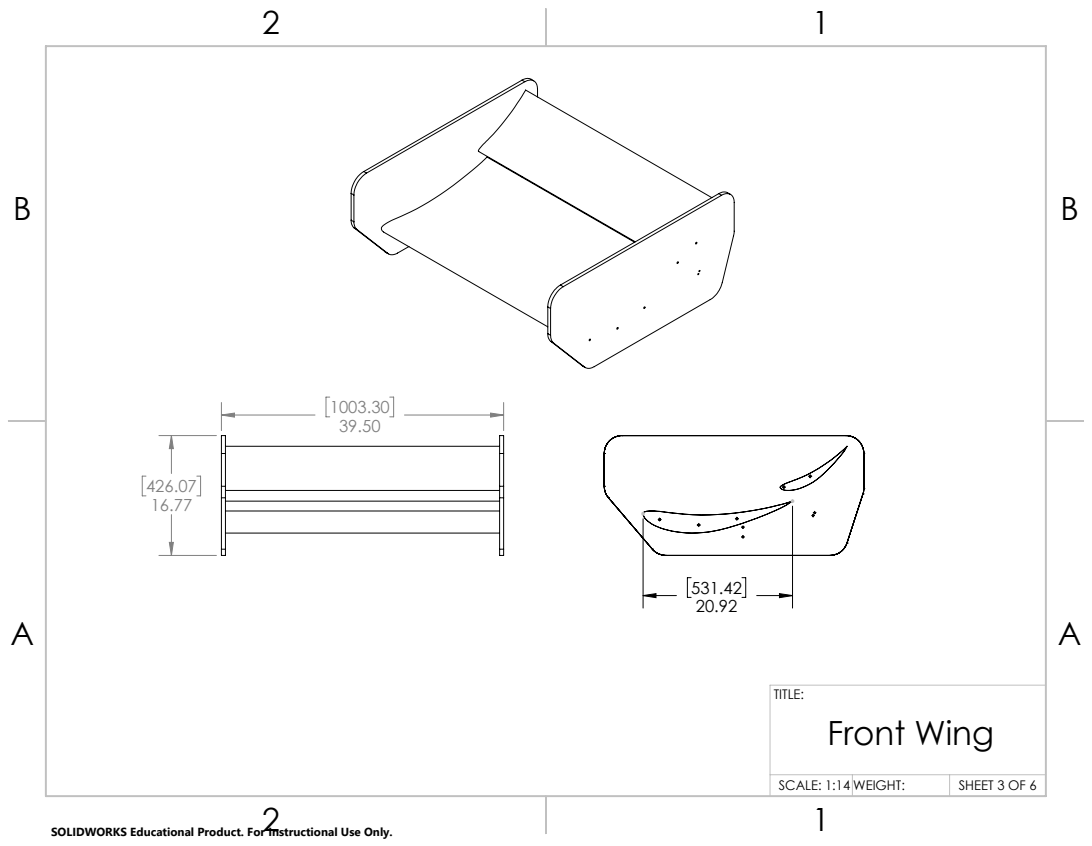
[picture p180: page 1]
Front Wing; SCALE: 1:14 WEIGHT:; SHEET 3 OF 6

SOLIDWORKS Educational Product. For Instructional Use Only.
