bsobeloffgittes/NFR25-CAD/Aerodynamics/Rear Wing/Drawings/Rear_Wing_Mount.pdf

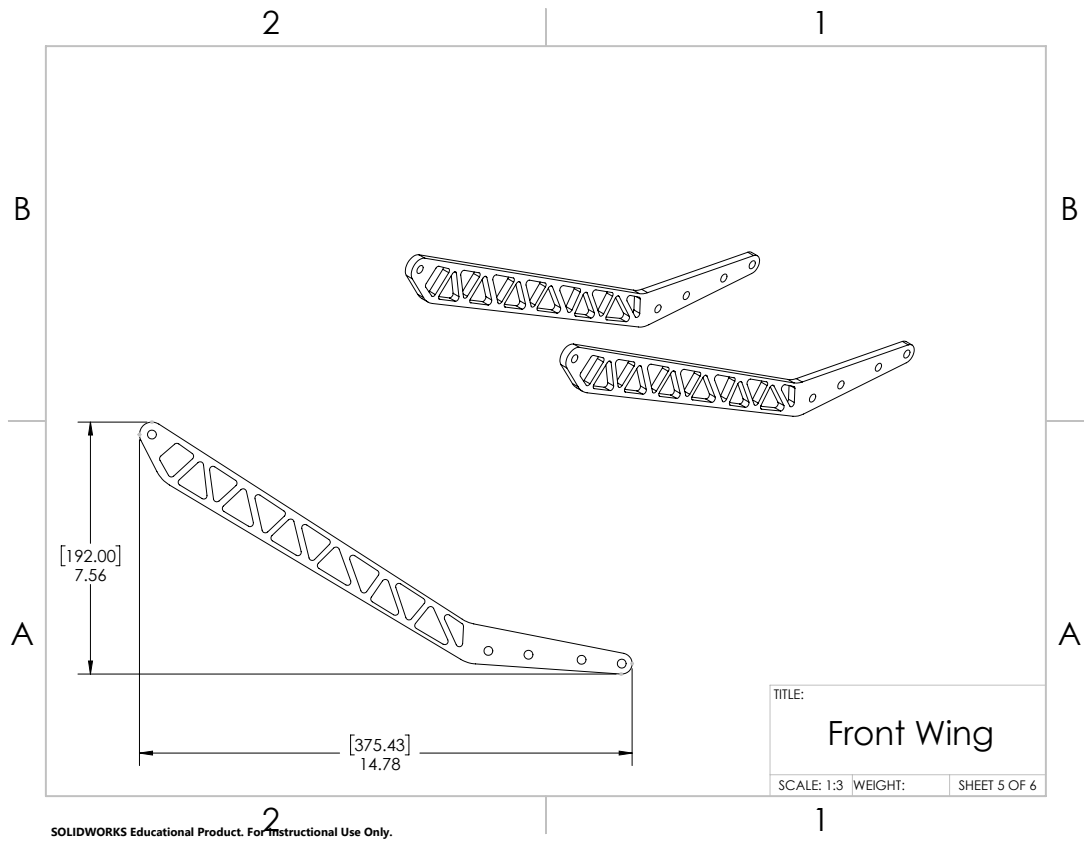
[picture p181: page 1]
Front Wing; SCALE: 1:3; WEIGHT:; SHEET 5 OF 6

SOLIDWORKS Educational Product. For Instructional Use Only.
