bsobeloffgittes/NFR25-CAD/Aerodynamics/Rear Wing/Drawings/Rear_Wing_Ribs.pdf

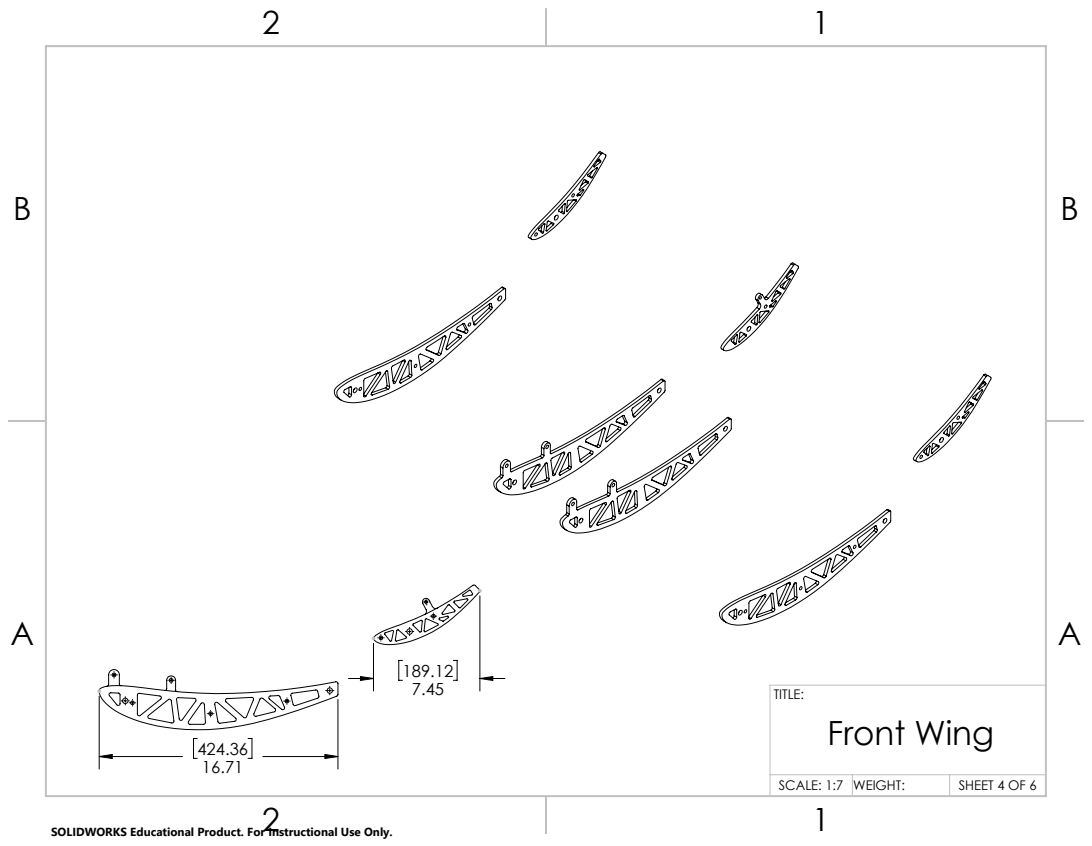
[picture p182: page 1]
Front Wing; SCALE: 1:7; WEIGHT:; SHEET 4 OF 6

SOLIDWORKS Educational Product. For Instructional Use Only.
