bsobeloffgittes/NFR25-CAD/Accumulator/Water Cooling/Splitter/5_Way_Splitter_3.0.pdf

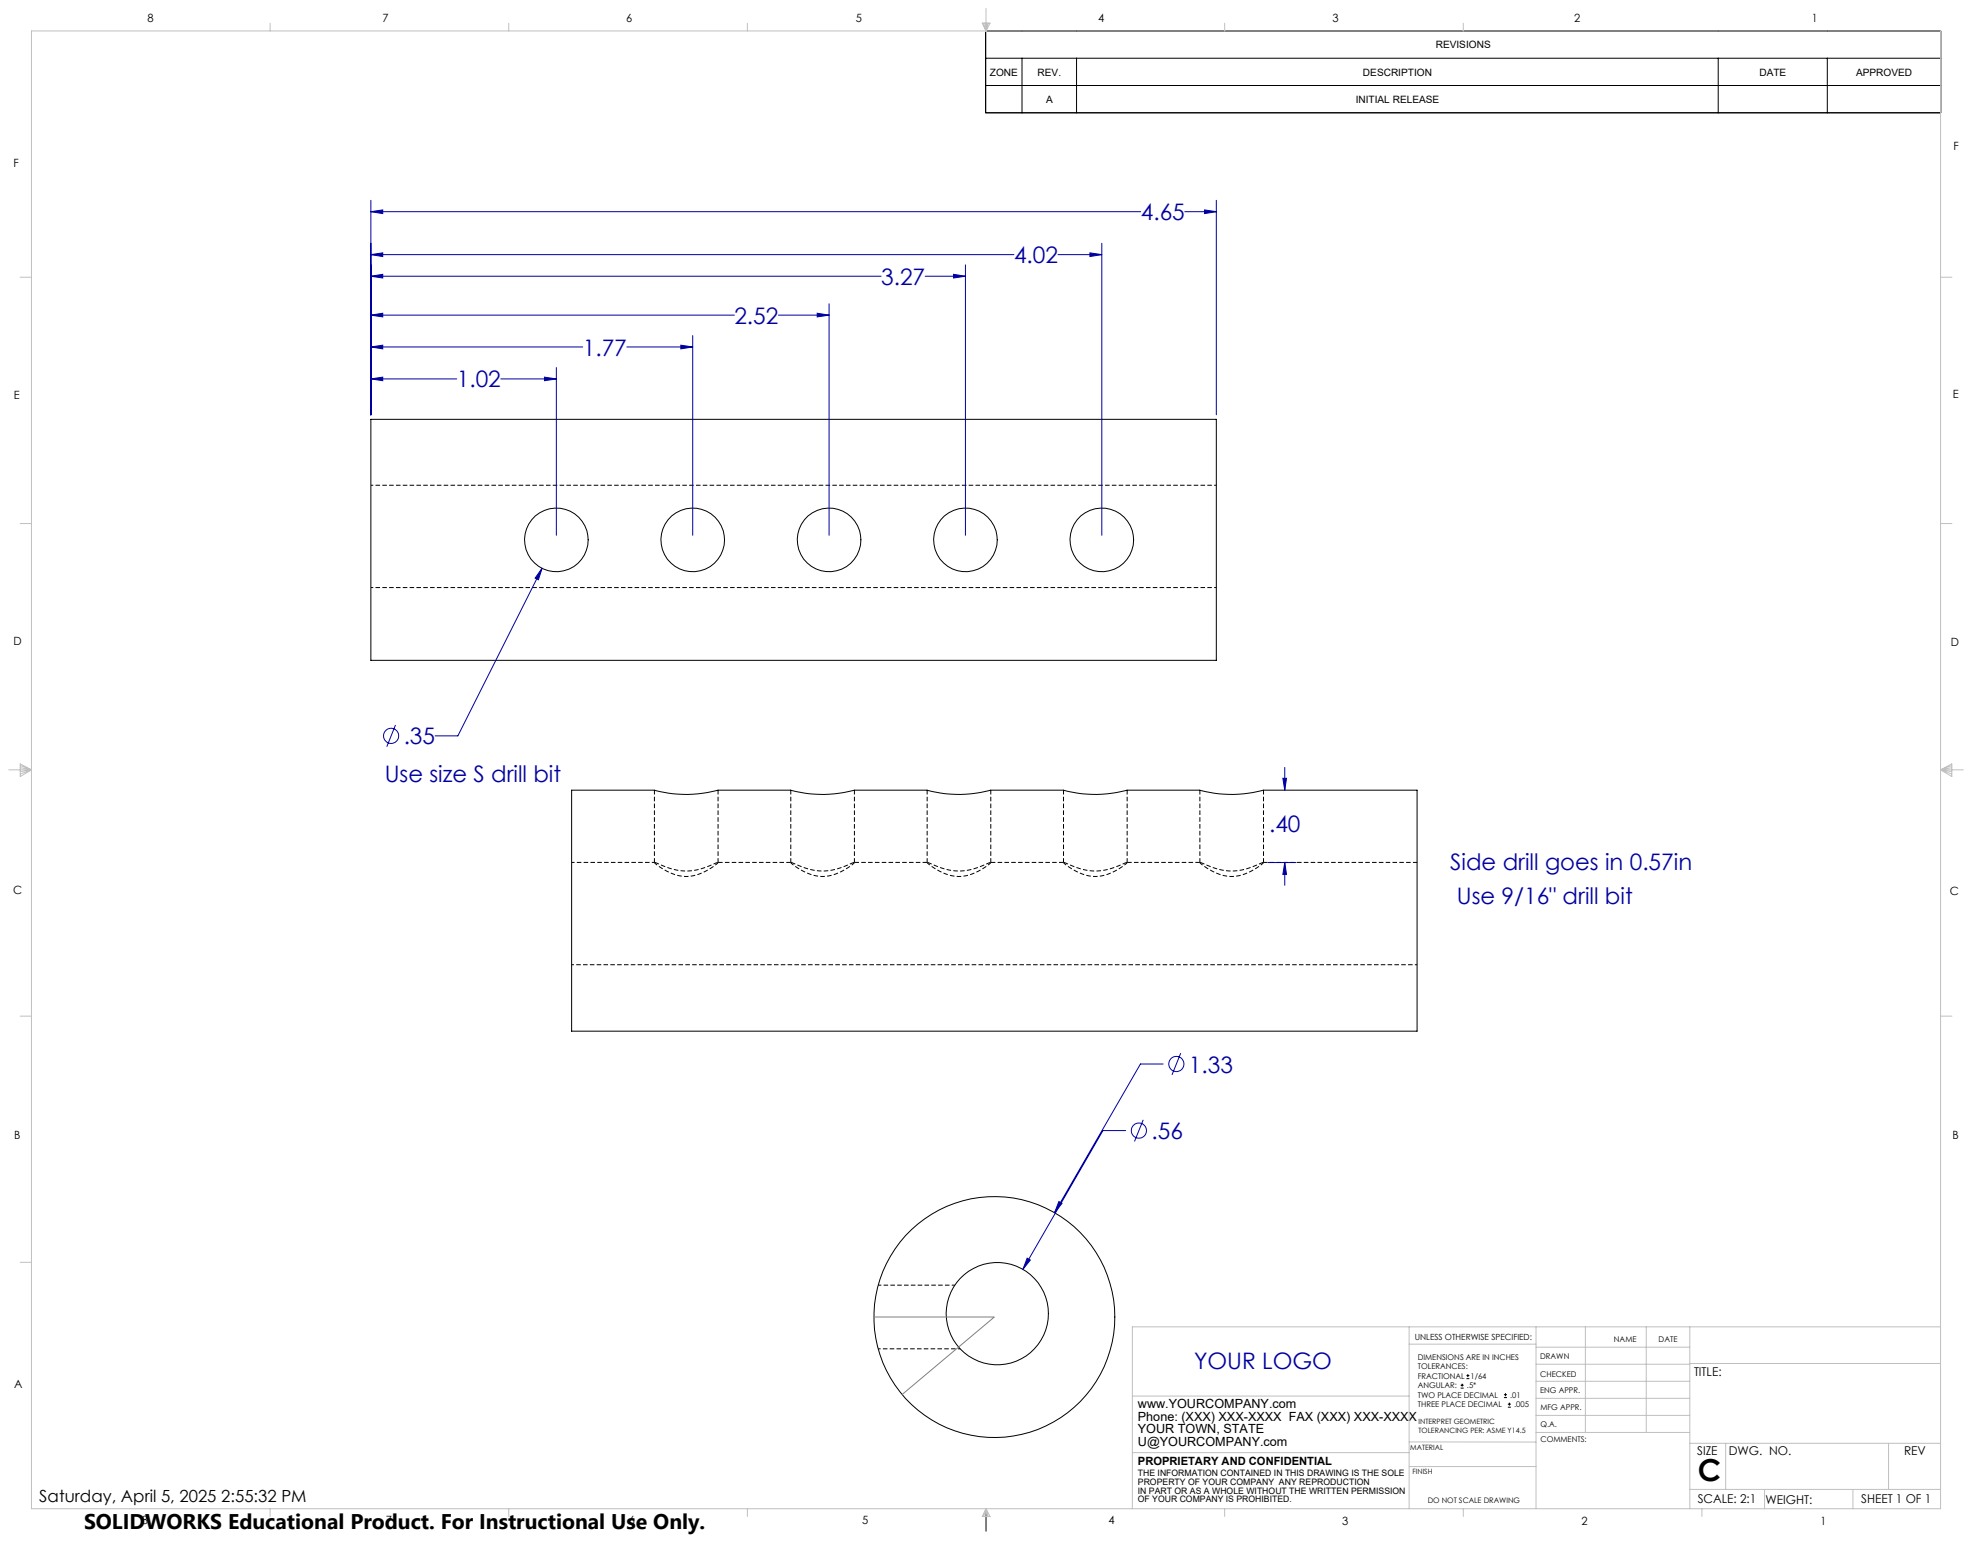
[picture p183: page 1]
SHEET 1 OF 1; SCALE: 2:1 WEIGHT:; DWG. NO.; REV; MFG APPR.; ENG APPR.; OF YOUR COMPANY IS PROHIBITED.; DO NOT SCALE DRAWING; YOUR LOGO

ZONE | REV. | DESCRIPTION | DATE | APPROVED

A | INITIAL RELEASE

Use size S drill bit

Side drill goes in 0.57in
Use 9/16" drill bit

UNLESS OTHERWISE SPECIFIED:
DIMENSIONS ARE IN INCHES
TOLERANCES:
FRACTIONAL 1/64
ANGULAR: .5*
TWO PLACE DECIMAL .01
THREE PLACE DECIMAL .005
INTERPRET GEOMETRIC
TOLERANCING PER: ASME Y14.5
MATERIAL

www.YOURCOMPANY.com
Phone: (XXX) XXX-XXXX FAX (XXX) XXX-XXXX
YOUR TOWN, STATE
U@YOURCOMPANY.com
PROPRIETARY AND CONFIDENTIAL
THE INFORMATION CONTAINED IN THIS DRAWING IS THE SOLE
PROPERTY OF YOUR COMPANY ANY REPRODUCTION
IN PART OR AS A WHOLE WITHOUT THE WRITTEN PERMISSION

Saturday, April 5, 2025 2:55:32 PM
SOLIDWORKS Educational Product. For Instructional Use Only.
