bsobeloffgittes/NFR25-CAD/Suspension/Hubs/Front Hubs/FrontHub_NFR25_drawing_pdf.PDF

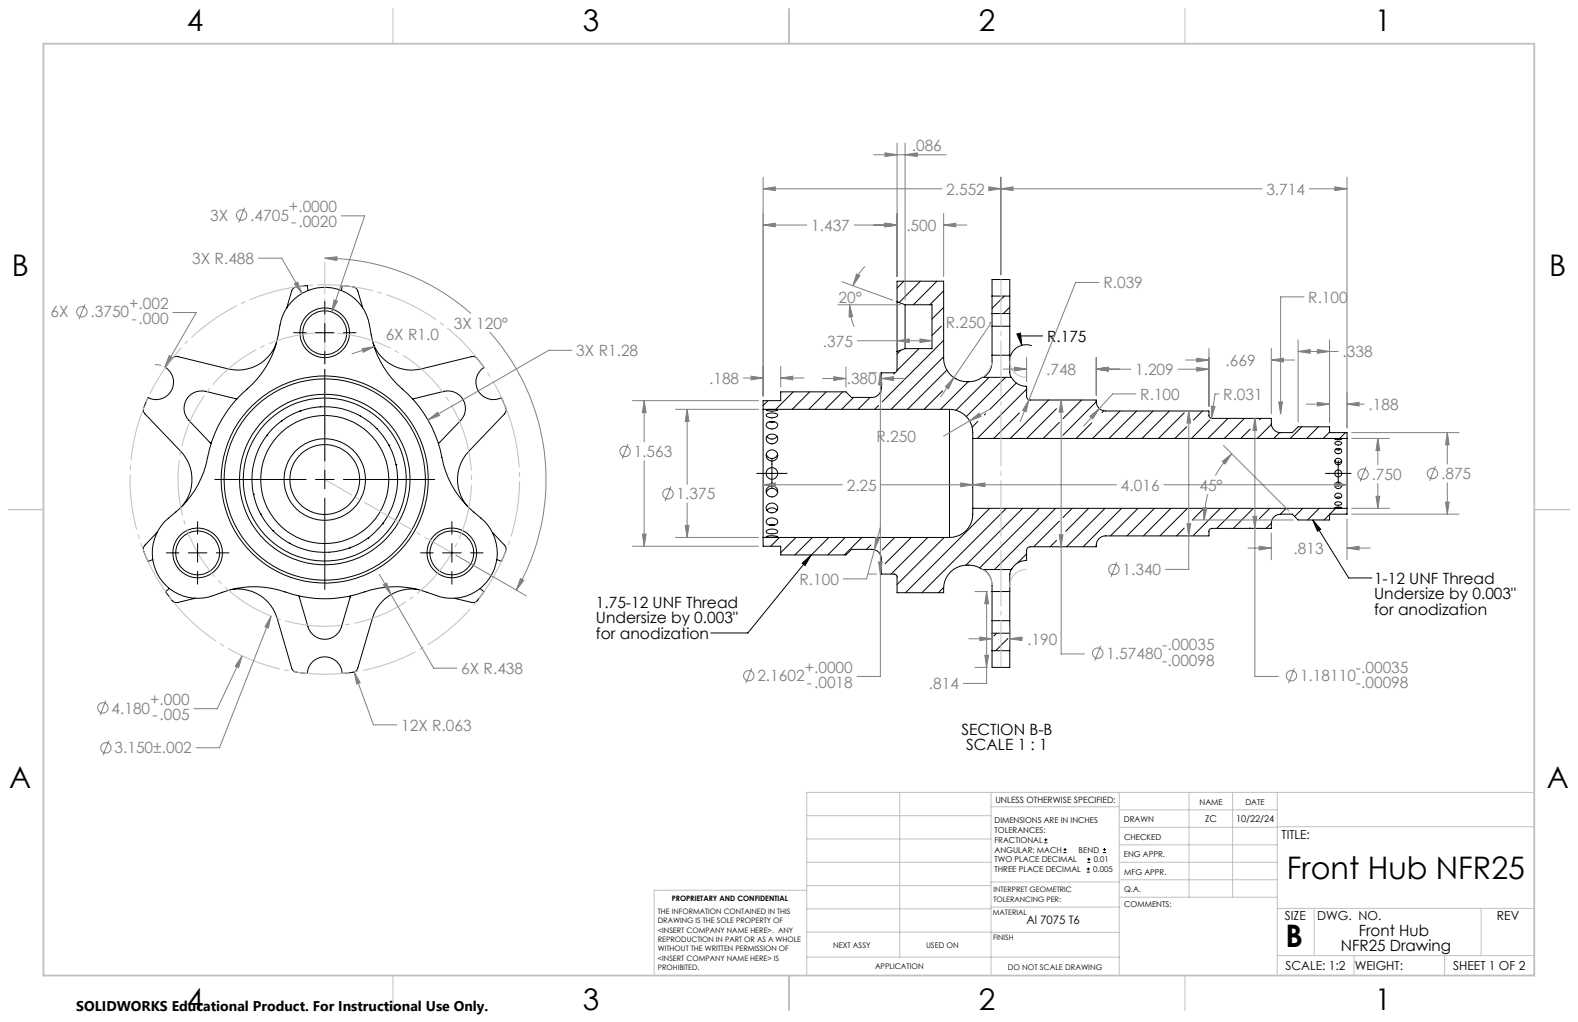
[picture p184: page 1]
SECTION B-B SCALE 1 : 1; 1.75-12 UNF Thread Undersize by 0.003" for anodization; 1-12 UNF Thread Undersize by 0.003" for anodization

UNLESS OTHERWISE SPECIFIED: | | NAME | DATE
DIMENSIONS ARE IN INCHES TOLERANCES: FRACTIONAL ANGULAR: MACH BEND TWO PLACE DECIMAL 0.01 THREE PLACE DECIMAL 0.005 | DRAWN | ZC | 10/22/24

CHECKED | | | TITLE: Front Hub NFR25

ENG APPR.
MFG APPR.

INTERPRET GEOMETRIC TOLERANCING PER: | Q.A.
MATERIAL Al 7075 T6 | | SIZE B | DWG. NO. Front Hub NFR25 Drawing | REV

PROPRIETARY AND CONFIDENTIAL
THE INFORMATION CONTAINED IN THIS
DRAWING IS THE SOLE PROPERTY OF
<INSERT COMPANY NAME HERE>. ANY
REPRODUCTION IN PART OR AS A WHOLE
WITHOUT THE WRITTEN PERMISSION OF
<INSERT COMPANY NAME HERE> IS
PROHIBITED.

NEXT ASSY | USED ON | FINISH

APPLICATION | DO NOT SCALE DRAWING | | SCALE: 1:2 | WEIGHT: | SHEET 1 OF 2

SOLIDWORKS Educational Product. For Instructional Use Only.

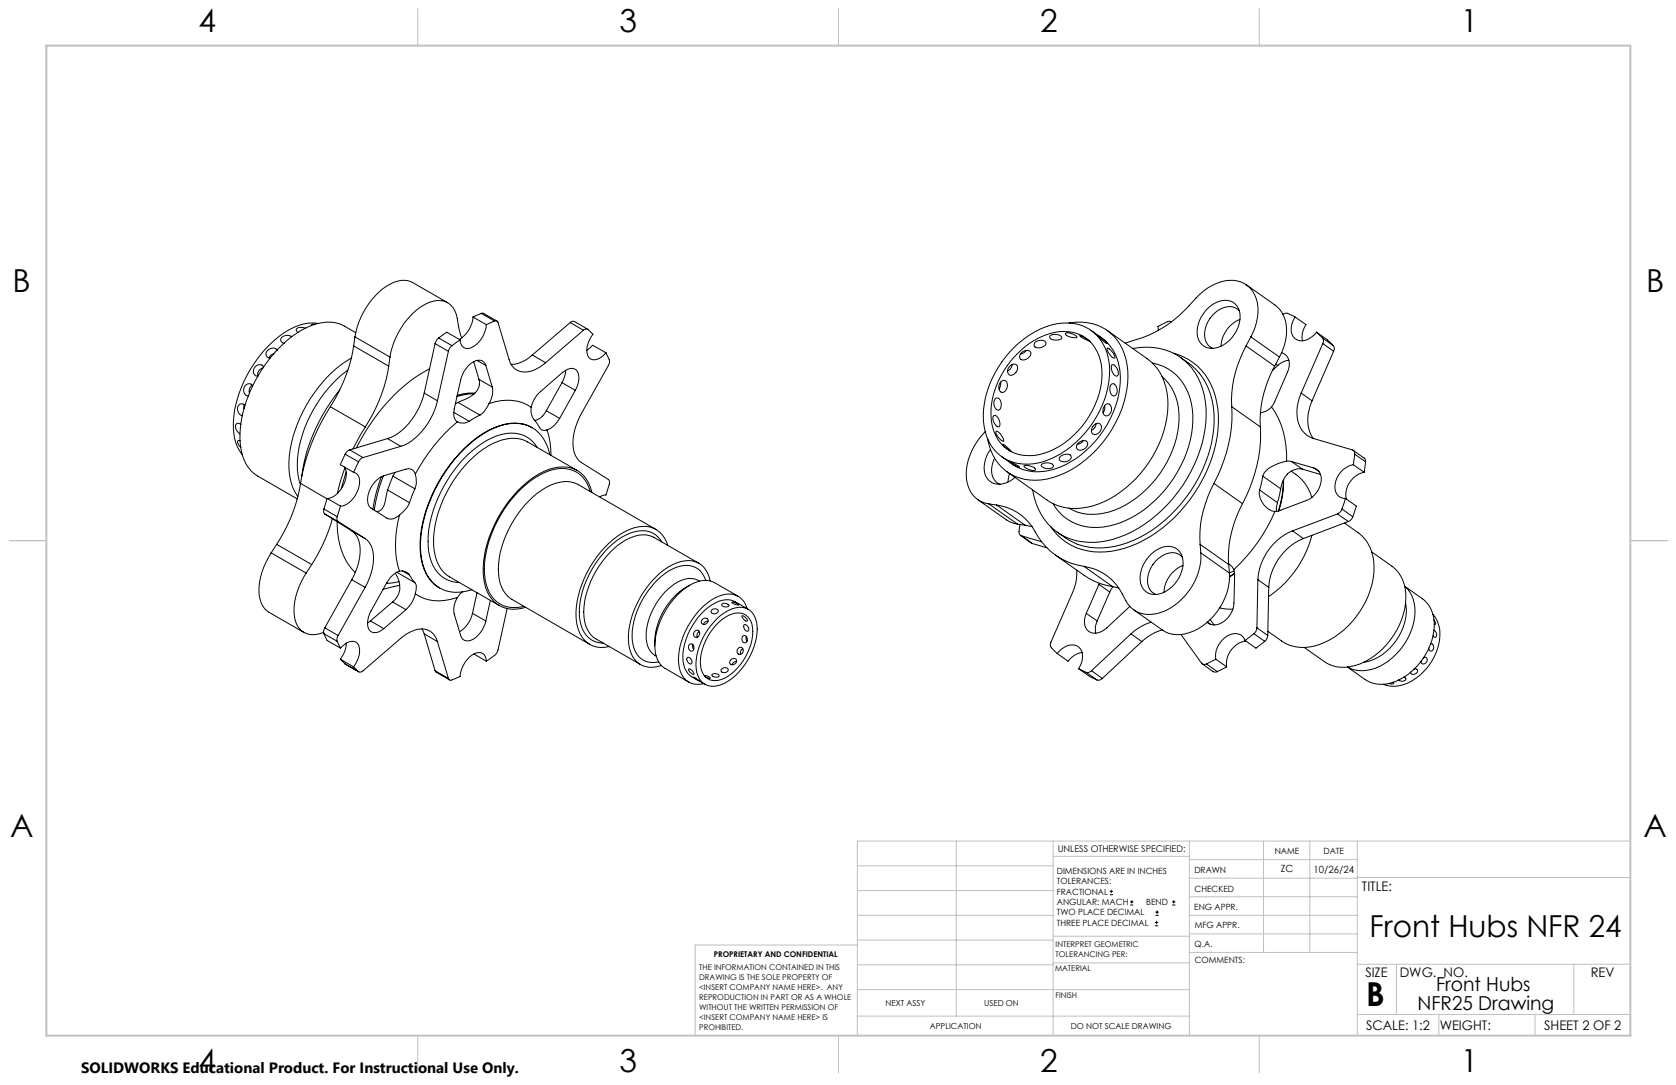
[picture p185: page 2]

UNLESS OTHERWISE SPECIFIED: | | NAME | DATE
DIMENSIONS ARE IN INCHES TOLERANCES: FRACTIONAL ANGULAR: MACH BEND TWO PLACE DECIMAL THREE PLACE DECIMAL | DRAWN | ZC | 10/26/24

CHECKED | | | TITLE: Front Hubs NFR 24

ENG APPR.
MFG APPR.

INTERPRET GEOMETRIC TOLERANCING PER: | Q.A.
MATERIAL | | SIZE B | DWG. NO. Front Hubs NFR25 Drawing | REV

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

NEXT ASSY | USED ON | FINISH

APPLICATION | DO NOT SCALE DRAWING | | SCALE: 1:2 | WEIGHT: | SHEET 2 OF 2

SOLIDWORKS Educational Product. For Instructional Use Only.
