bsobeloffgittes/NFR25-CAD/Suspension/Hubs/Rear Hubs/RearHubs_NFR25_pdf.pdf

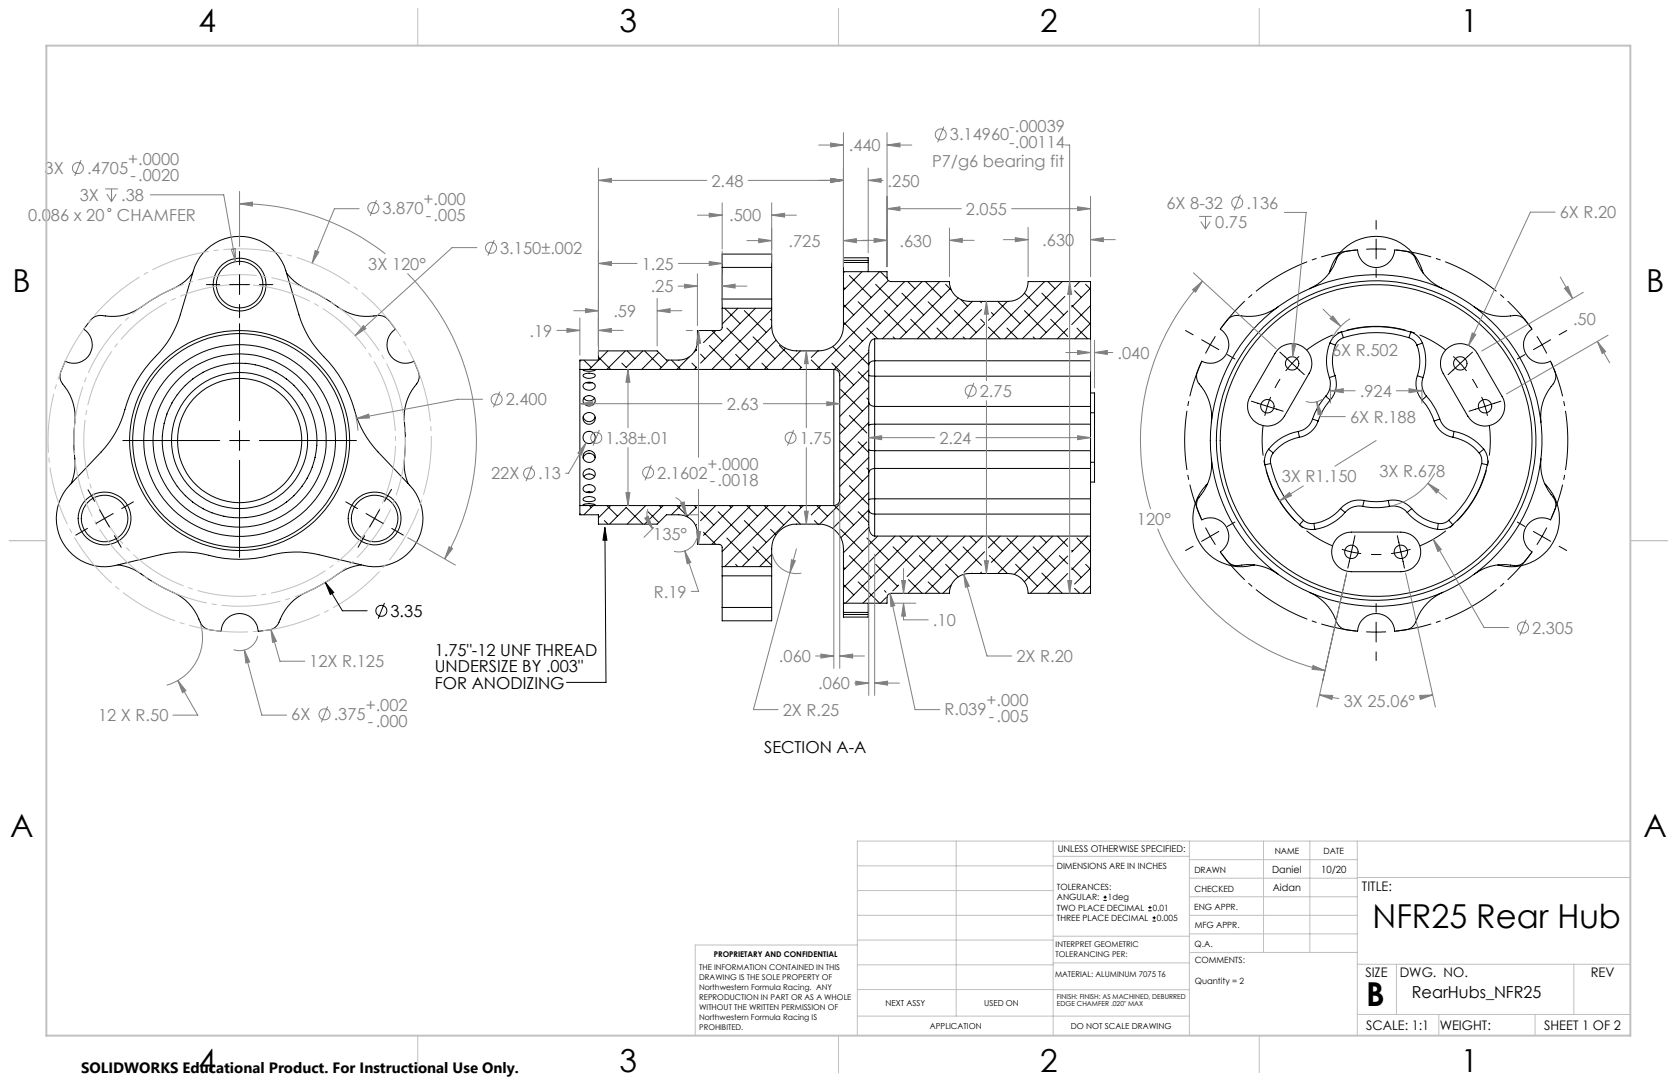
[picture p186: page 1]
3X .38 0.086 x 20 CHAMFER; P7/g6 bearing fit; 1.75"-12 UNF THREAD UNDERSIZE BY .003" FOR ANODIZING; SECTION A-A; Quantity = 2

UNLESS OTHERWISE SPECIFIED: | | NAME | DATE
DIMENSIONS ARE IN INCHES TOLERANCES: ANGULAR: 1deg TWO PLACE DECIMAL 0.01 THREE PLACE DECIMAL 0.005 | DRAWN | Daniel | 10/20

CHECKED | Aidan | | TITLE: NFR25 Rear Hub

ENG APPR.
MFG APPR.

INTERPRET GEOMETRIC TOLERANCING PER: | Q.A.
MATERIAL: ALUMINUM 7075 T6 | | SIZE B | DWG. NO. RearHubs_NFR25 | REV

PROPRIETARY AND CONFIDENTIAL
THE INFORMATION CONTAINED IN THIS
DRAWING IS THE SOLE PROPERTY OF
Northwestern Formula Racing. ANY
REPRODUCTION IN PART OR AS A WHOLE
WITHOUT THE WRITTEN PERMISSION OF
Northwestern Formula Racing IS
PROHIBITED.

NEXT ASSY | USED ON | FINISH: FINISH: AS MACHINED, DEBURRED EDGE CHAMFER .020" MAX

APPLICATION | DO NOT SCALE DRAWING | | SCALE: 1:1 | WEIGHT: | SHEET 1 OF 2

SOLIDWORKS Educational Product. For Instructional Use Only.

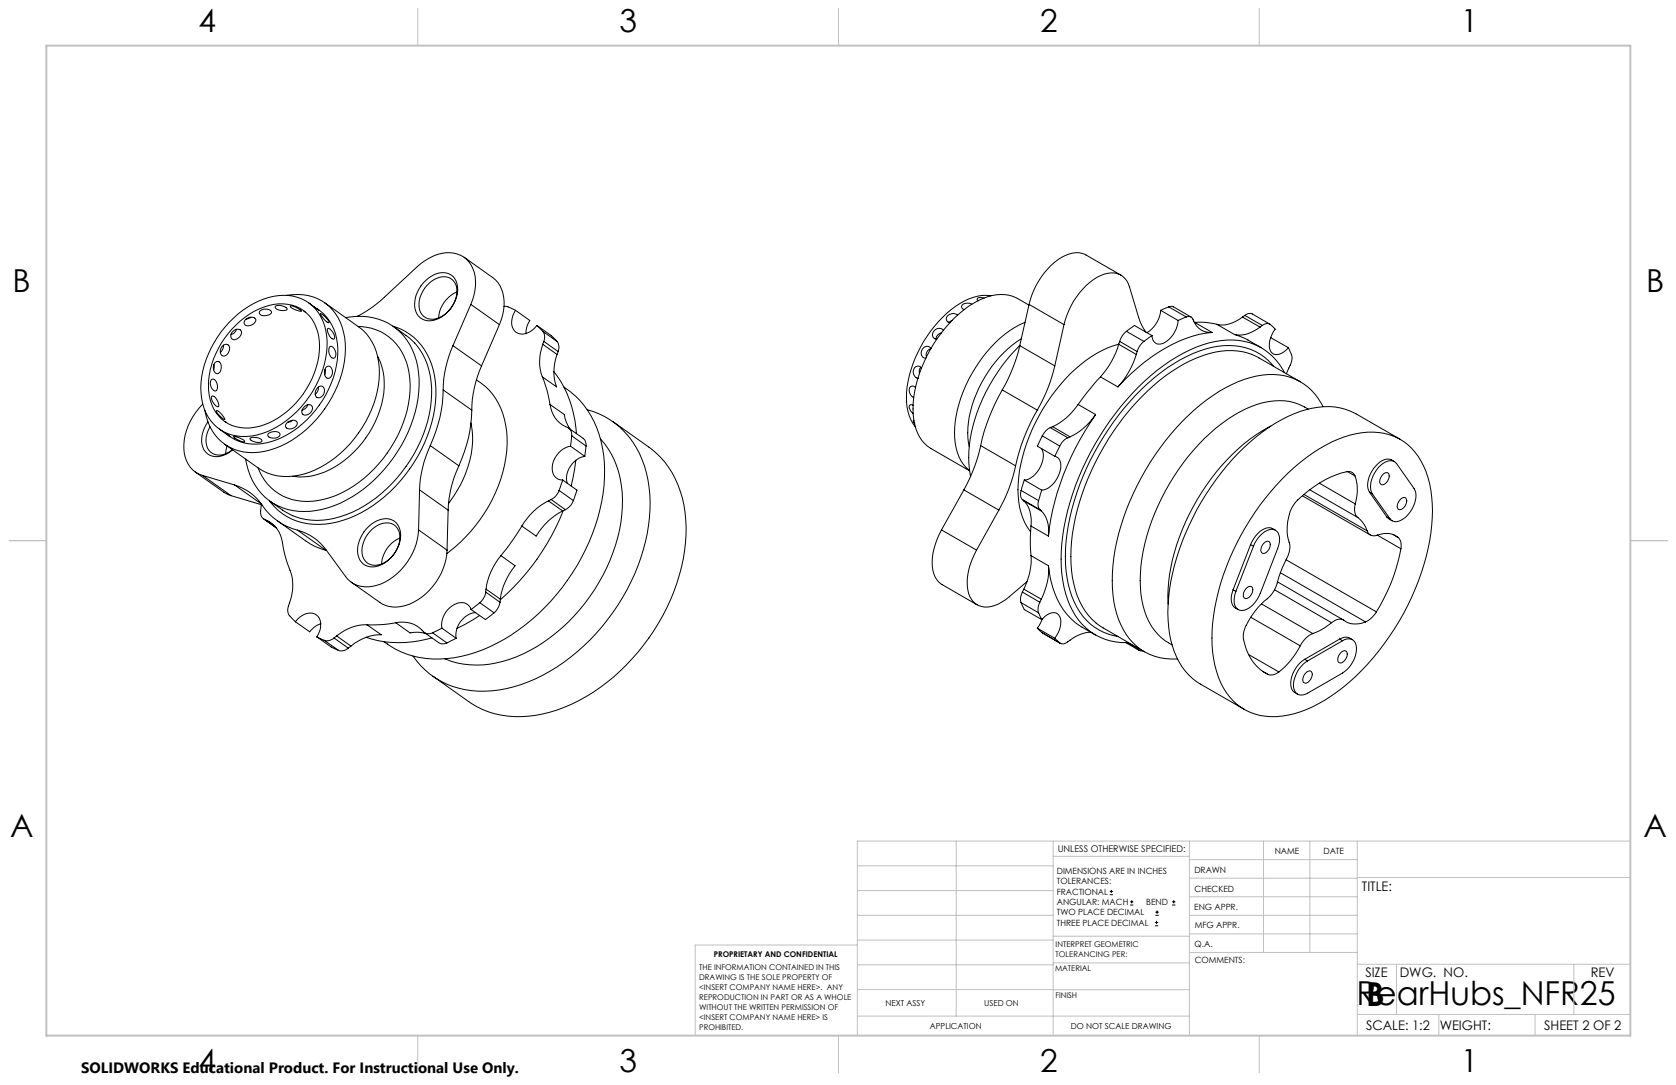
[picture p187: page 2]

UNLESS OTHERWISE SPECIFIED: | | NAME | DATE
DIMENSIONS ARE IN INCHES TOLERANCES: FRACTIONAL ANGULAR: MACH BEND TWO PLACE DECIMAL THREE PLACE DECIMAL | DRAWN

CHECKED | | | TITLE:

ENG APPR.
MFG APPR.

INTERPRET GEOMETRIC TOLERANCING PER: | Q.A.
MATERIAL | | SIZE RearHubs_NFR25 B | DWG. NO. | REV

PROPRIETARY AND CONFIDENTIAL
THE INFORMATION CONTAINED IN THIS
DRAWING IS THE SOLE PROPERTY OF
<INSERT COMPANY NAME HERE>. ANY
REPRODUCTION IN PART OR AS A WHOLE
WITHOUT THE WRITTEN PERMISSION OF
<INSERT COMPANY NAME HERE> IS
PROHIBITED.

NEXT ASSY | USED ON | FINISH

APPLICATION | DO NOT SCALE DRAWING | | SCALE: 1:2 | WEIGHT: | SHEET 2 OF 2

SOLIDWORKS Educational Product. For Instructional Use Only.
