bsobeloffgittes/NFR25-CAD/Accumulator/Drawings/Segment Drawings/maintenance_plug_bottom_drawing.pdf

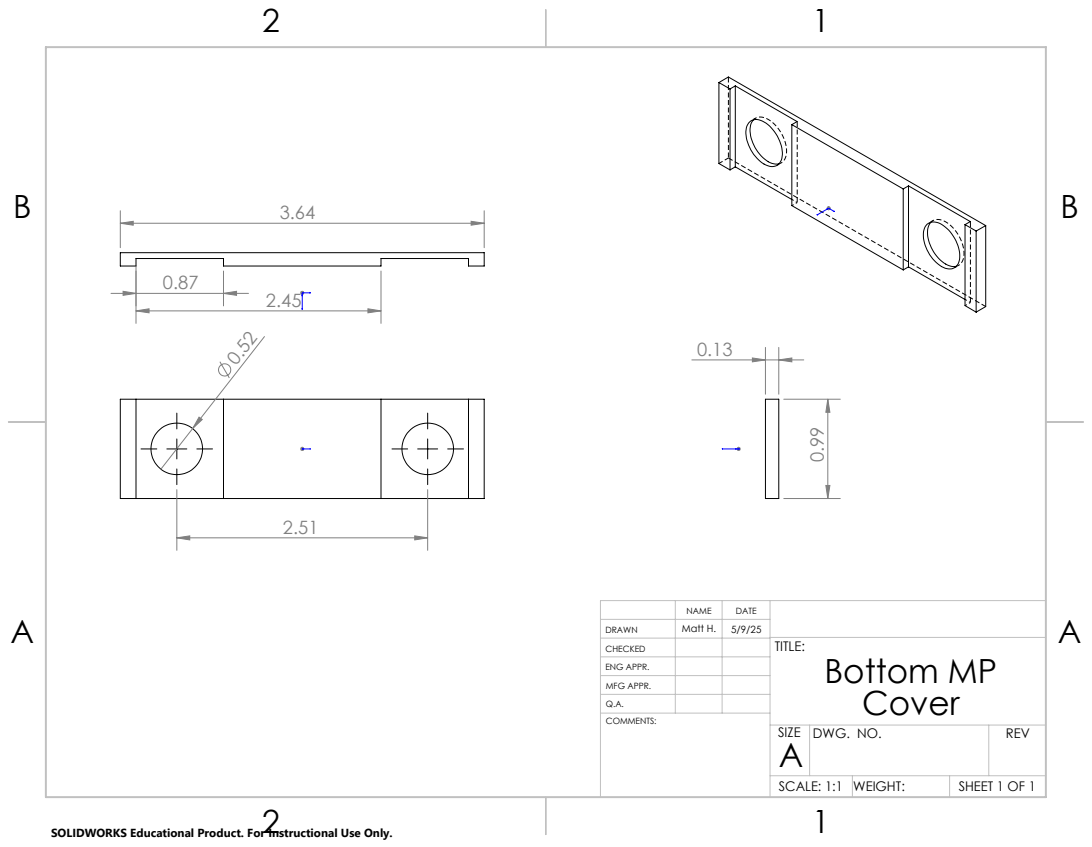
[picture p192: page 1]

NAME | DATE
CHECKED | | | TITLE: Bottom MP Cover

DRAWN | Matt H. | 5/9/25

ENG APPR.
MFG APPR.
Q.A.

SIZE A | DWG. NO. | REV

SCALE: 1:1 | WEIGHT: | SHEET 1 OF 1

SOLIDWORKS Educational Product. For Instructional Use Only.
