bsobeloffgittes/NFR25-CAD/Accumulator/Drawings/radiator_drawing.pdf

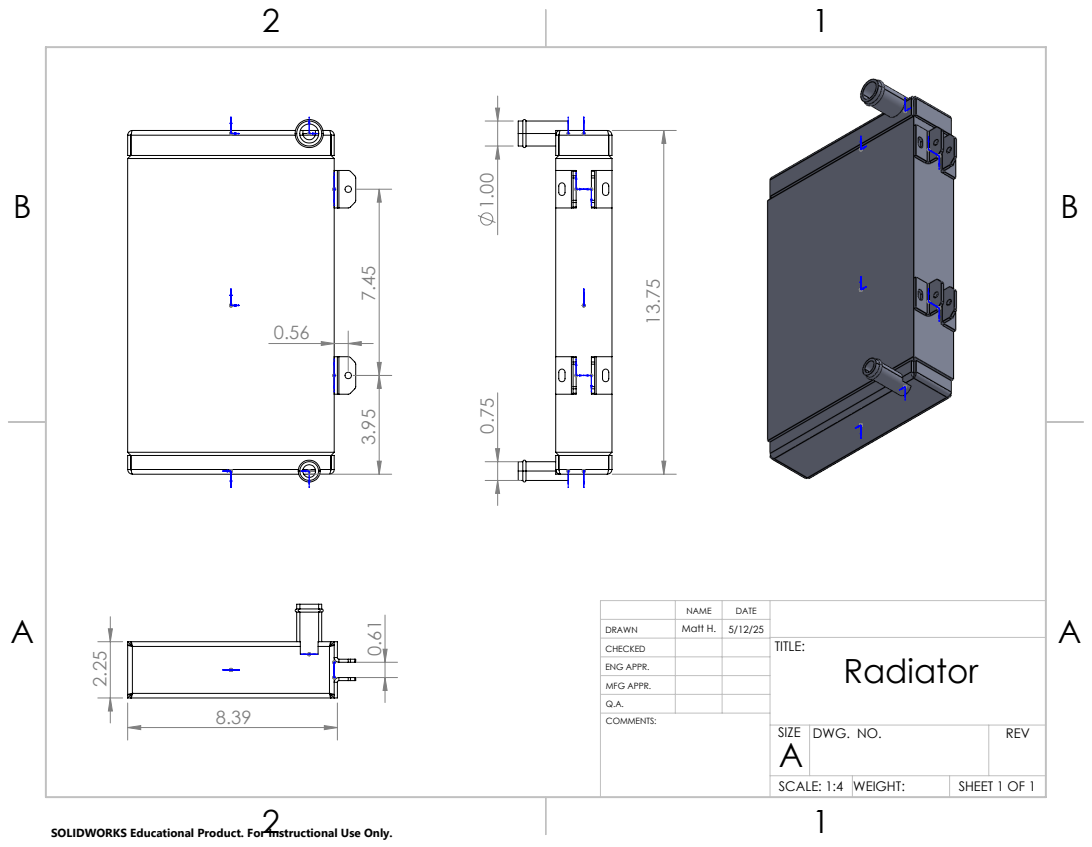
[picture p193: page 1]

NAME | DATE
CHECKED | | | TITLE: Radiator

DRAWN | Matt H. | 5/12/25

ENG APPR.
MFG APPR.
Q.A.

SIZE A | DWG. NO. | REV

SCALE: 1:4 | WEIGHT: | SHEET 1 OF 1

SOLIDWORKS Educational Product. For Instructional Use Only.
