bsobeloffgittes/NFR25-CAD/Accumulator/Drawings/Container Drawings/penthouse_internal_wall_drawing.pdf

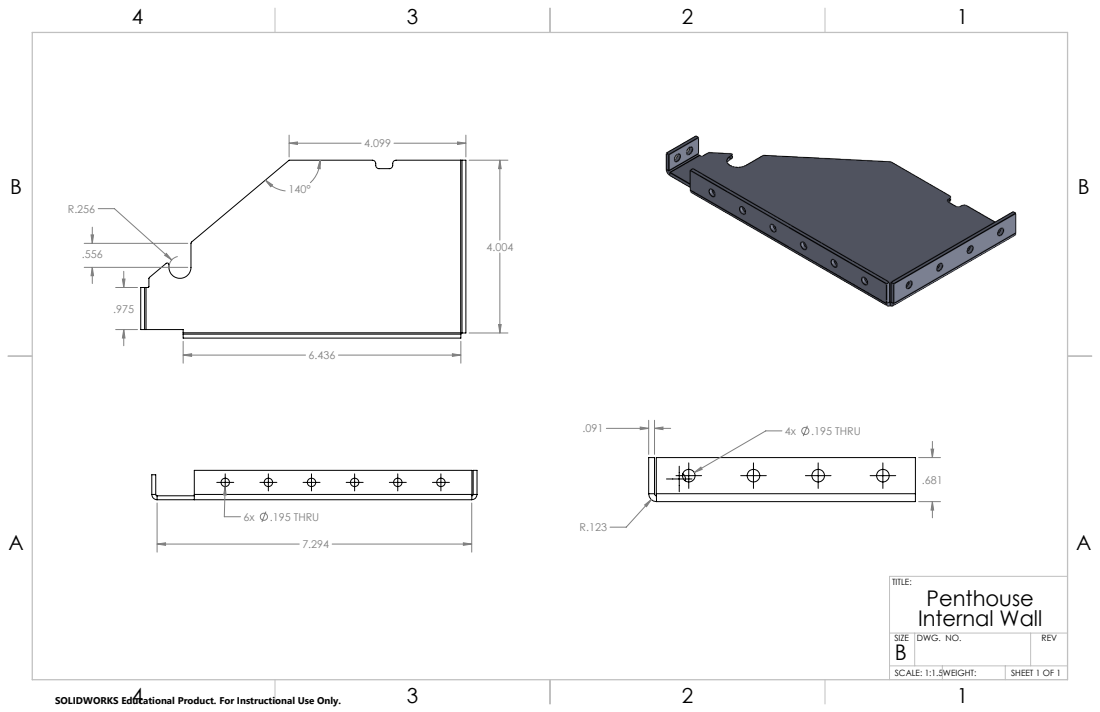
[picture p194: page 1]
6x .195 THRU; 4x .195 THRU .091; Internal Wall

SIZE B | DWG. NO. | REV

SCALE: 1:1.5WEIGHT: | | SHEET 1 OF 1

SOLIDWORKS Educational Product. For Instructional Use Only.
