bsobeloffgittes/NFR25-CAD/Accumulator/Drawings/Container Drawings/penthouse_left_wall_drawing.pdf

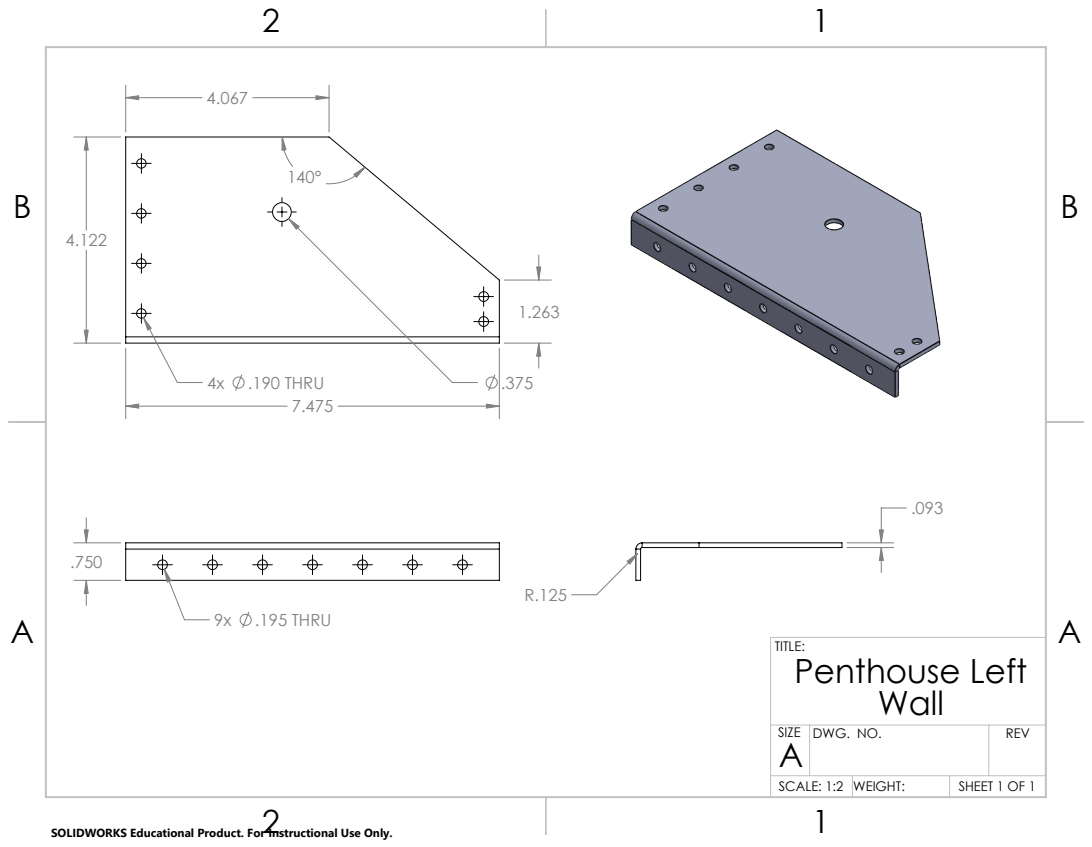
[picture p195: page 1]
9x .195 THRU; 4x .190 THRU; Penthouse Left

SIZE A | DWG. NO. | REV

SCALE: 1:2 | WEIGHT: | SHEET 1 OF 1

SOLIDWORKS Educational Product. For Instructional Use Only.
