bsobeloffgittes/NFR25-CAD/Accumulator/Drawings/Container Drawings/penthouse_lid_drawing.pdf

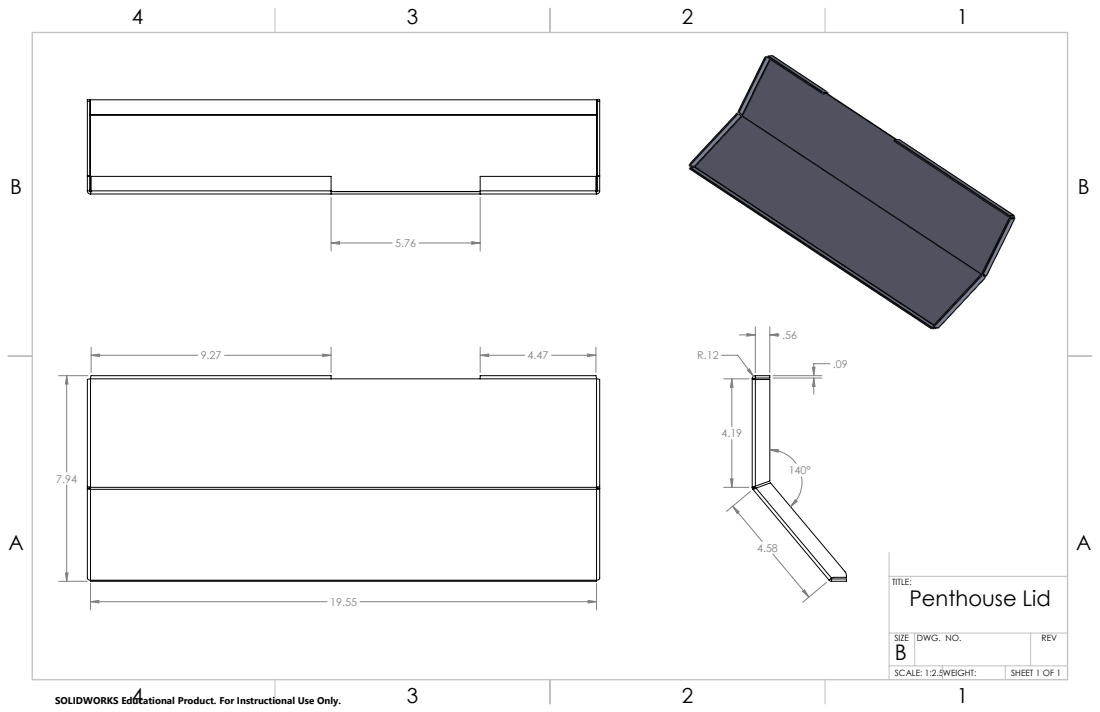
[picture p196: page 1]
Penthouse Lid

SIZE B | DWG. NO. | REV

SCALE: 1:2.5WEIGHT: | | SHEET 1 OF 1

SOLIDWORKS Educational Product. For Instructional Use Only.
