bsobeloffgittes/NFR25-CAD/Accumulator/Drawings/Container Drawings/penthouse_rear_wall_drawing.pdf

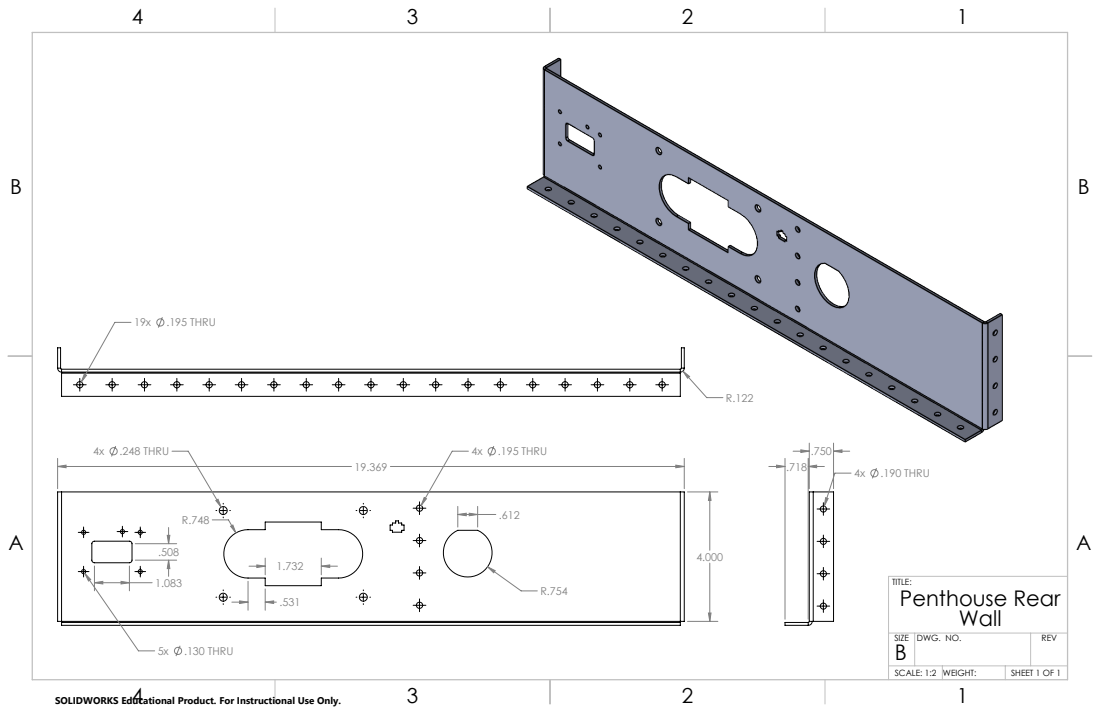
[picture p197: page 1]
4x .248 THRU; 5x .130 THRU; 4x .195 THRU; 4x .190 THRU; 19x .195 THRU; Penthouse Rear

SIZE B | DWG. NO. | REV

SCALE: 1:2 | WEIGHT: | SHEET 1 OF 1

SOLIDWORKS Educational Product. For Instructional Use Only.
