bsobeloffgittes/NFR25-CAD/Accumulator/Drawings/Container Drawings/penthouse_right_wall_drawing.pdf

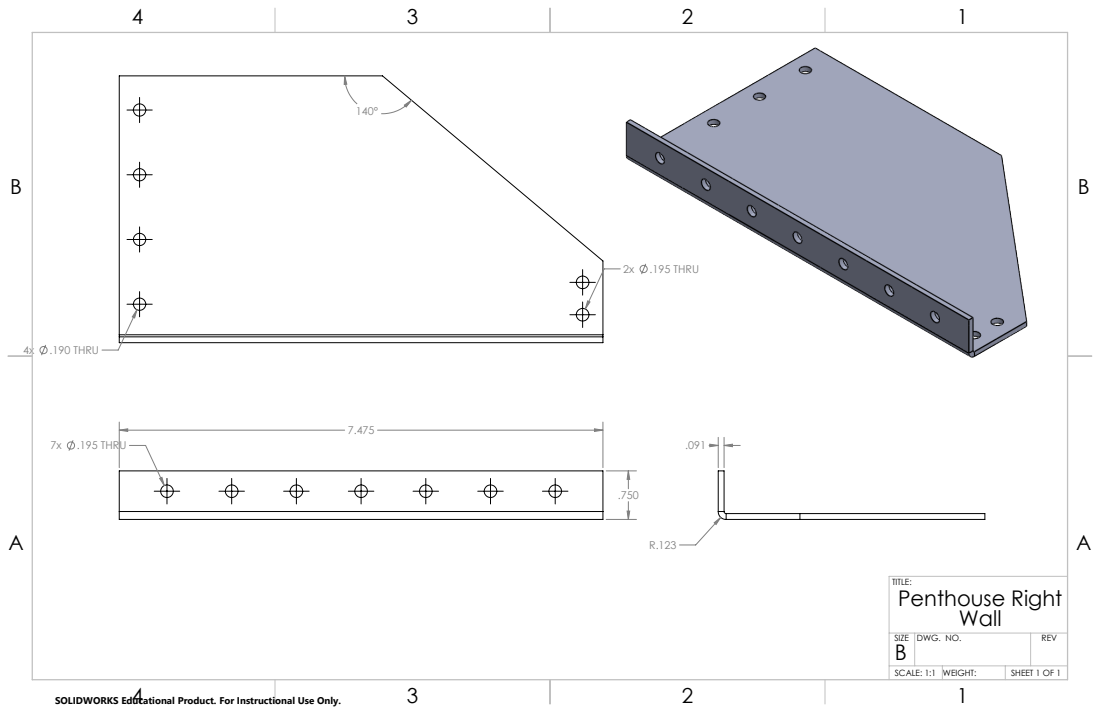
[picture p198: page 1]
7x .195 THRU; 4x .190 THRU; 2x .195 THRU; Penthouse Right

SIZE B | DWG. NO. | REV

SCALE: 1:1 | WEIGHT: | SHEET 1 OF 1

SOLIDWORKS Educational Product. For Instructional Use Only.
