bsobeloffgittes/NFR25-CAD/Accumulator/Drawings/Container Drawings/segment_box_lid_drawing.pdf

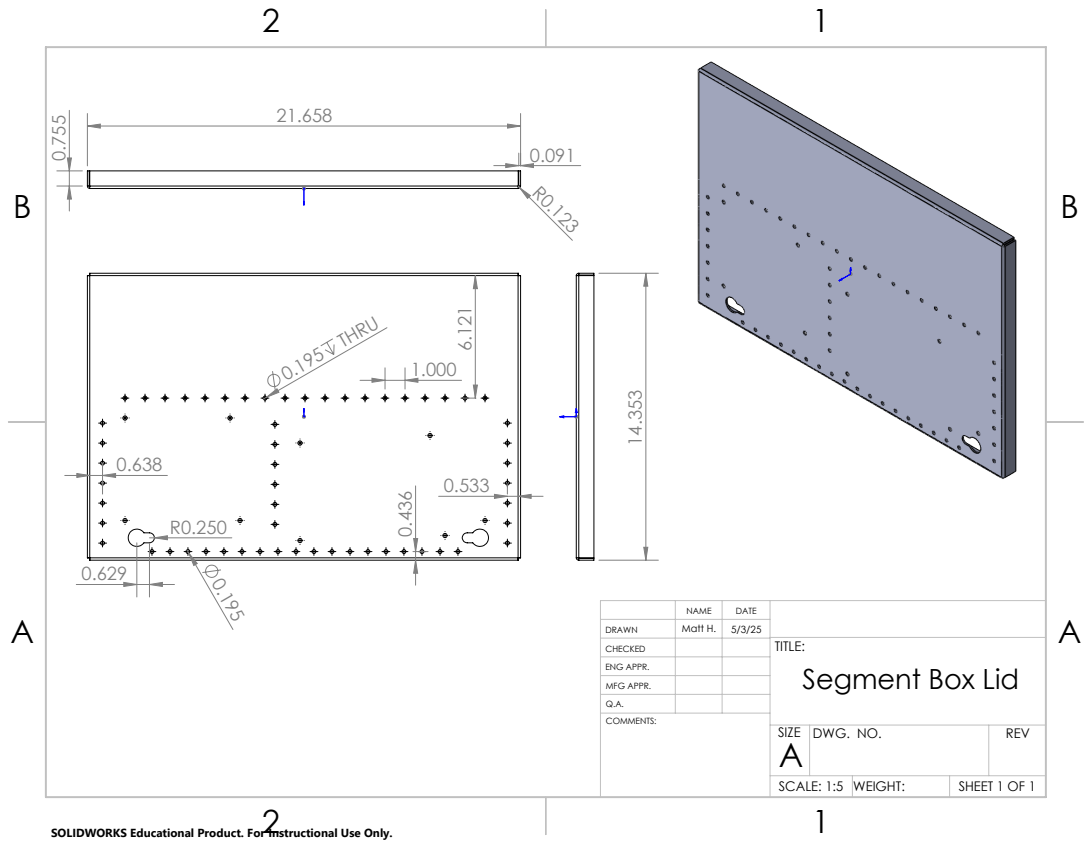
[picture p200: page 1]
0.195 THRU

NAME | DATE
CHECKED | | | TITLE: Segment Box Lid

DRAWN | Matt H. | 5/3/25

ENG APPR.
MFG APPR.
Q.A.

SIZE A | DWG. NO. | REV

SCALE: 1:5 | WEIGHT: | SHEET 1 OF 1

SOLIDWORKS Educational Product. For Instructional Use Only.
