bsobeloffgittes/NFR25-CAD/Accumulator/Drawings/Container Drawings/segment_box_wall_drawing.pdf

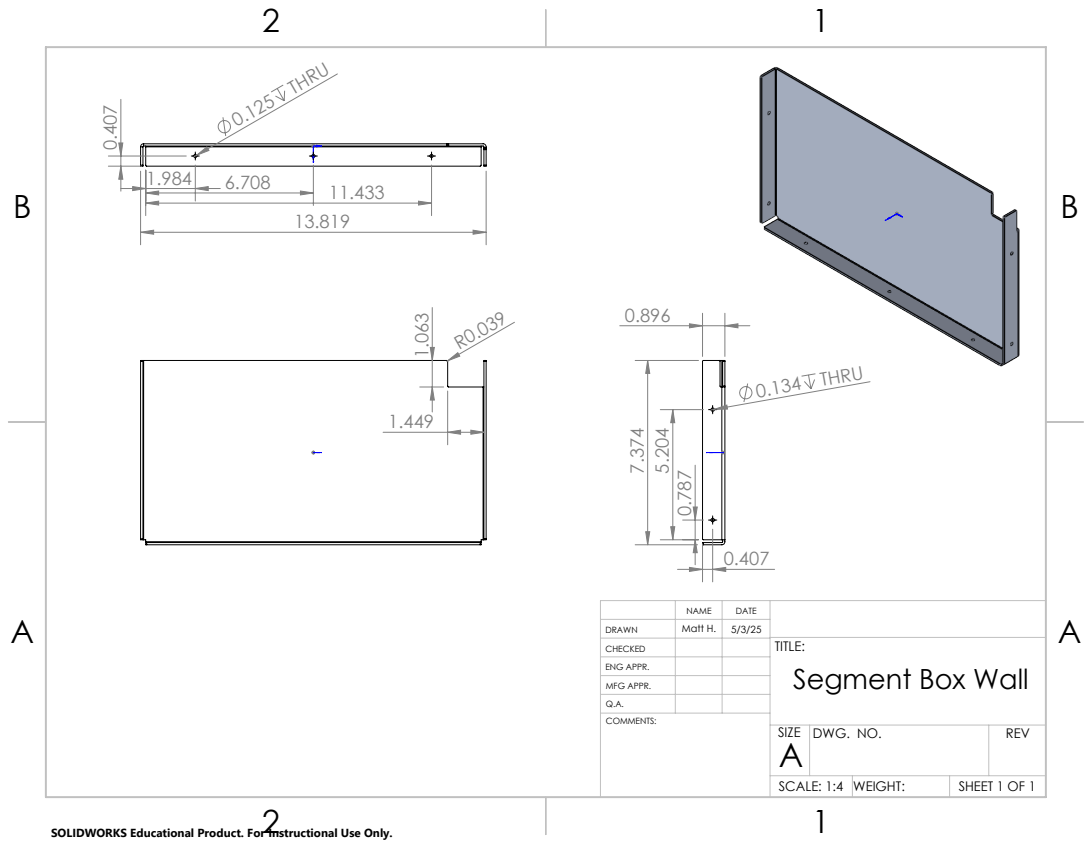
[picture p201: page 1]
0.125 THRU; 0.134 THRU

NAME | DATE
CHECKED | | | TITLE: Segment Box Wall

DRAWN | Matt H. | 5/3/25

ENG APPR.
MFG APPR.
Q.A.

SIZE A | DWG. NO. | REV

SCALE: 1:4 | WEIGHT: | SHEET 1 OF 1

SOLIDWORKS Educational Product. For Instructional Use Only.
