bsobeloffgittes/NFR25-CAD/Accumulator/Drawings/Segment Drawings/bottom_cell_holder_drawing.pdf

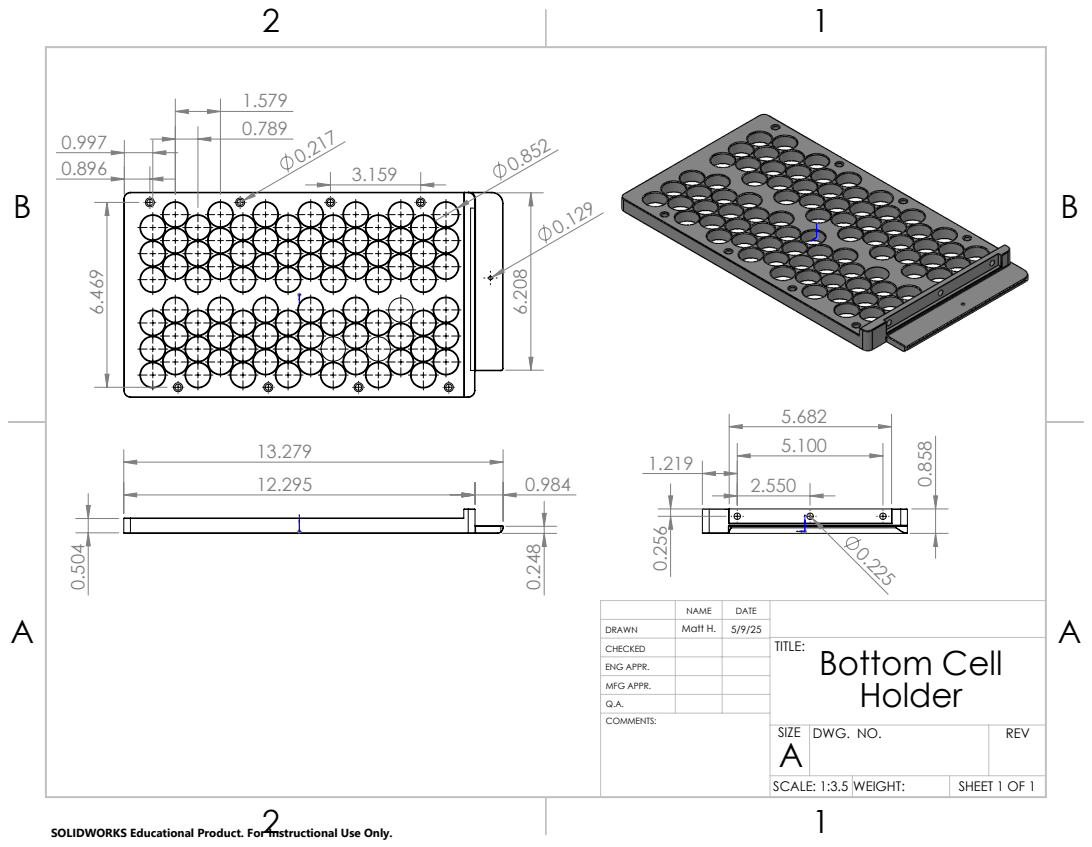
[picture p202: page 1]

NAME | DATE
CHECKED | | | TITLE: Bottom Cell Holder

DRAWN | Matt H. | 5/9/25

ENG APPR.
MFG APPR.
Q.A.

SIZE A | DWG. NO. | REV

SCALE: 1:3.5 WEIGHT: | | SHEET 1 OF 1

SOLIDWORKS Educational Product. For Instructional Use Only.
