bsobeloffgittes/NFR25-CAD/Accumulator/Drawings/Segment Drawings/master_negative_busbar_drawing.pdf

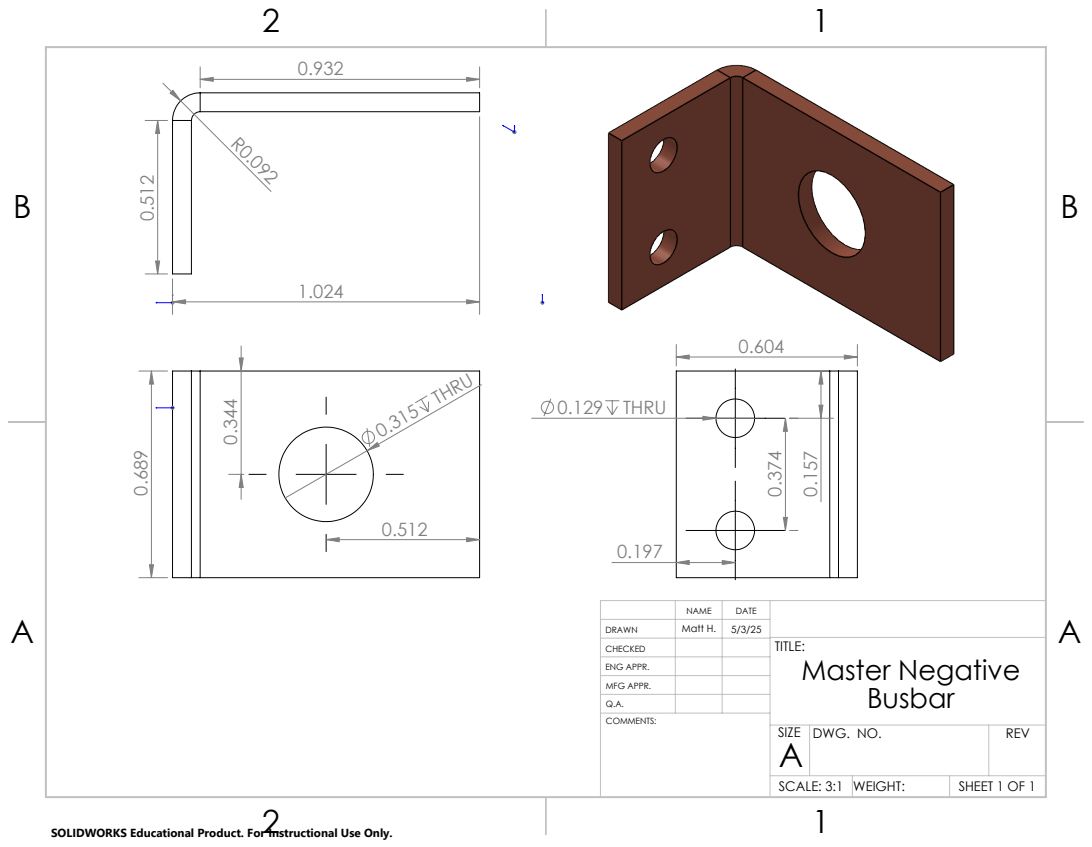
[picture p203: page 1]
0.315 THRU; 0.129 THRU

NAME | DATE
CHECKED | | | TITLE: Master Negative Busbar

DRAWN | Matt H. | 5/3/25

ENG APPR.
MFG APPR.
Q.A.

SIZE A | DWG. NO. | REV

SCALE: 3:1 | WEIGHT: | SHEET 1 OF 1

SOLIDWORKS Educational Product. For Instructional Use Only.
