bsobeloffgittes/NFR25-CAD/Accumulator/Drawings/Segment Drawings/negative_busbar_drawing.pdf

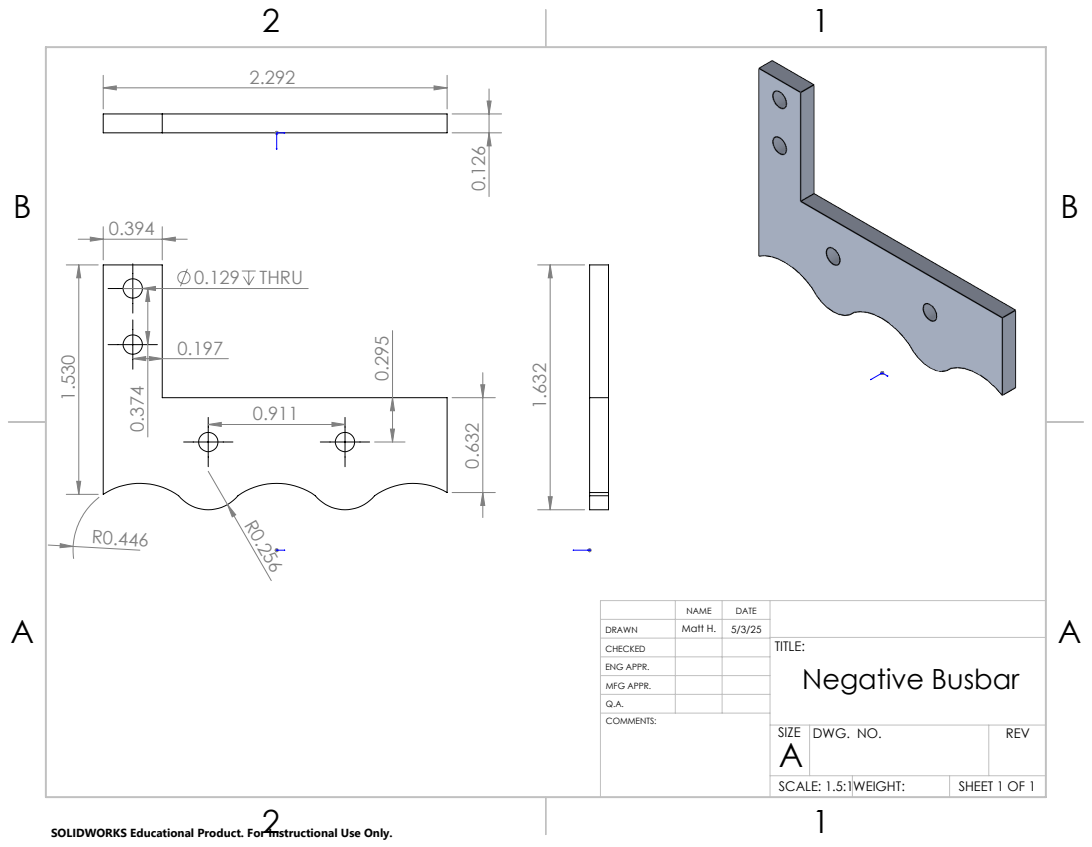
[picture p204: page 1]
0.129 THRU

NAME | DATE
CHECKED | | | TITLE: Negative Busbar

DRAWN | Matt H. | 5/3/25

ENG APPR.
MFG APPR.
Q.A.

SIZE A | DWG. NO. | REV

SCALE: 1.5:1WEIGHT: | | SHEET 1 OF 1

SOLIDWORKS Educational Product. For Instructional Use Only.
