bsobeloffgittes/NFR25-CAD/Accumulator/Drawings/Segment Drawings/top_cell_holder_drawing.pdf

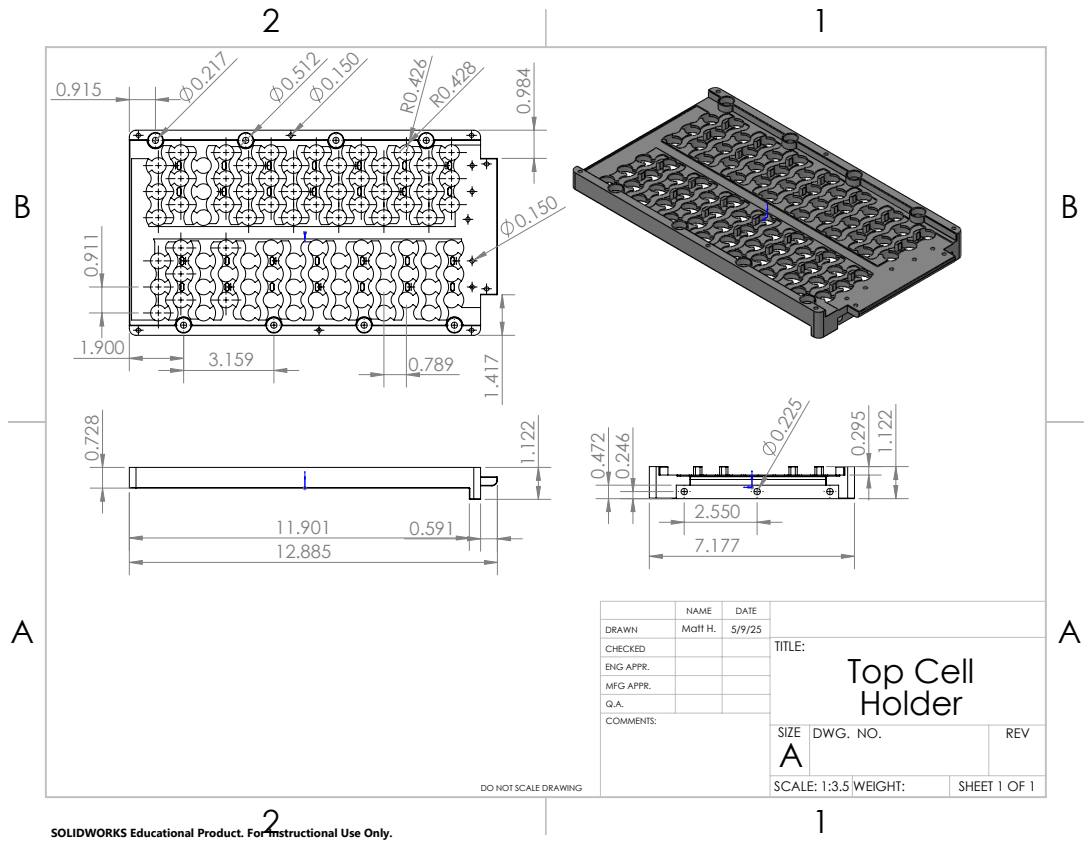
[picture p206: page 1]
DO NOT SCALE DRAWING; SHEET 1 OF 1

NAME | DATE
CHECKED | | | TITLE: Top Cell Holder

DRAWN | Matt H. | 5/9/25

ENG APPR.
MFG APPR.
Q.A.

SIZE A | DWG. NO. | REV

SCALE: 1:3.5 WEIGHT:

SOLIDWORKS Educational Product. For Instructional Use Only.
