bsobeloffgittes/NFR25-CAD/Aerodynamics/Bodywork/Drawings/Bodywork_Assem.pdf

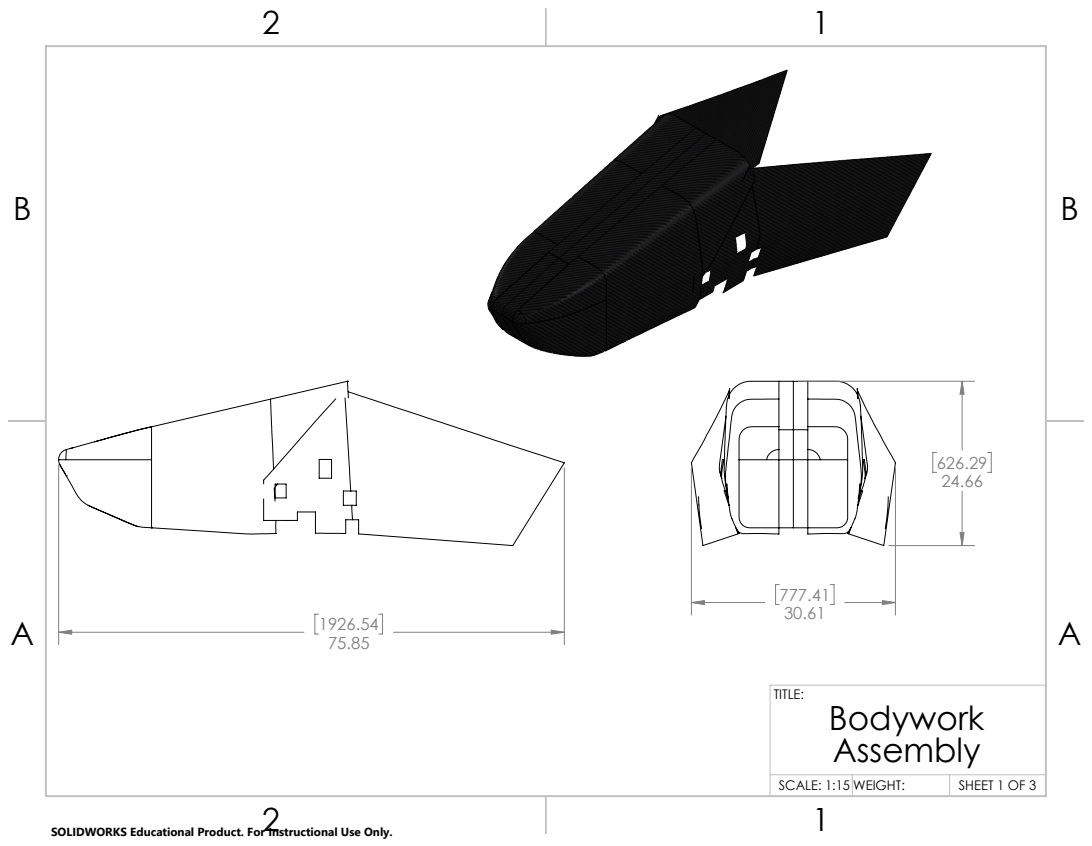
[picture p207: page 1]
SCALE: 1:15 WEIGHT:; SHEET 1 OF 3

SOLIDWORKS Educational Product. For Instructional Use Only.
