bsobeloffgittes/NFR25-CAD/Aerodynamics/Bodywork/Drawings/Nosecone.PDF

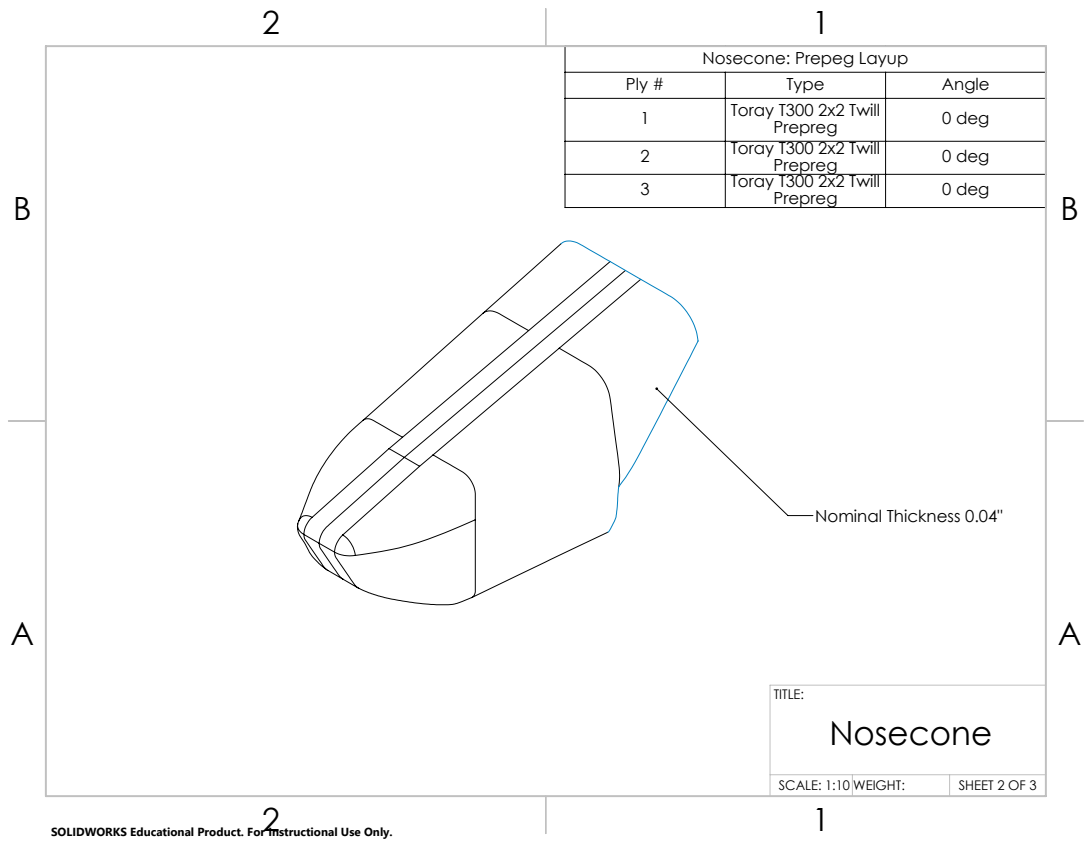
[picture p208: page 1]
Nominal Thickness 0.04"; SCALE: 1:10 WEIGHT:; SHEET 2 OF 3

Nosecone: Prepeg Layup

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

SOLIDWORKS Educational Product. For Instructional Use Only.
