bsobeloffgittes/NFR25-CAD/(commit log)

2024-07-01 add sus/chassis skeletons + frame
    hi
    [_Chassis_Skeleton_NFR24.SLDPRT, _Suspension_Skeleton_NFR24.SLDPRT]
2024-07-01 Deleted old frame/chassis skele and cleaned sus skeleton
    [_Chassis_Skeleton_NFR24.SLDPRT, _Suspension_Skeleton_NFR24.SLDPRT, _Suspension_Skeleton_NFR25.SLDPRT]
2024-07-01 Added sus skeleton to chassis skeleton + chassis skeleton to frame
    [Frame_NFR25.SLDPRT, _Chassis_Skeleton_NFR25.SLDPRT]
2024-07-01 Cleaned up suspension skeleton
    [_Suspension_Skeleton_NFR25.SLDPRT]
2024-07-01 created steering_analysis
    This will be to ensure wheels will turn enough
    [steering_analysis_NFR25.SLDPRT]
2024-07-02 Started block model
    [_Block_Model_NFR25.SLDPRT]
2024-07-08 Update _Chassis_Skeleton_NFR25.SLDPRT
    Started the chassis skeleton
    [_Chassis_Skeleton_NFR25.SLDPRT]
2024-07-09 Changed suspension skeleton to modified version of NFR24
    [_Suspension_Skeleton_NFR25.SLDPRT]
2024-07-09 Update _Chassis_Skeleton_NFR25.SLDPRT
    Started Chassis Skeleton with actual sus skeleton; main running tubes and FBH are in place, FRH and MH are up next
    [_Chassis_Skeleton_NFR25.SLDPRT]
2024-07-10 Update _Chassis_Skeleton_NFR25.SLDPRT
    FRH and Front triangulation added to chassis skeleton
    [_Chassis_Skeleton_NFR25.SLDPRT]
2024-07-10 Update _Chassis_Skeleton_NFR25.SLDPRT
    Second iteration of chassis skeleton complete; need to review SES
    [_Chassis_Skeleton_NFR25.SLDPRT]
2024-07-14 Uploaded Segment CAD
    - made folders with cell holders and segment assemblies
    [BottomCellHolder.SLDPRT, CellExample.SLDPRT, CellHolderTemplate.SLDPRT, PracticeCellHolder.SLDPRT, PracticeCellHolder2.SLDPRT, PracticeColdPlate1.SLDPRT, PracticeColdPlate2.SLDPRT, PracticeSegmentAssembly.SLDASM]
2024-07-14 Created container sizing assembly
    Added 8 identical segments in a mockup orientation to figure out accumulator container sizing
    [ContainerSizing.SLDASM]
2024-07-14 Updated segment size and created box dimensions
    [ContainerSizing.SLDASM]
2024-07-14 Fixed local file references
    :)
    [BottomCellHolder.SLDPRT, ContainerSizing.SLDASM, SegmentAssembly1.SLDASM, TopCellHolder.SLDPRT]
2024-07-14 Updated accumulator in block model
    [_Block_Model_NFR25.SLDPRT]
2024-07-17 created sketch of chassis skeleton with block model
    have both block model and chassis skeleton in 1 sketch
    [_Chassis_Skeleton+Block_Model_NFR25.SLDPRT]
2024-07-18 Created CFD Block Model Part file
    [CFD_Block_Model_NFR25.SLDPRT]
2024-07-19 Updated enclosure sizes
    [_Block_Model_NFR25.SLDPRT]
2024-07-20 double wishbone front
    [_Suspension_Skeleton_NFR25.SLDPRT, steering_analysis_NFR25.SLDPRT]
2024-07-20 Updated front sus geo, modified motor/diff placement, added pump, added maintenance panel
    [_Block_Model_NFR25.SLDPRT, _Suspension_Skeleton_NFR25.SLDPRT]
2024-07-21 Modified rear rocker geo, fixed broken external references
    [_Block_Model_NFR25.SLDPRT, _Chassis_Skeleton+Block_Model_NFR25.SLDPRT, _Suspension_Skeleton_NFR25.SLDPRT]
2024-07-22 Update _Chassis_Skeleton_NFR25.SLDPRT
    Redid front sus box to accommodate new sus points + minor changes to front triangulation
    [_Chassis_Skeleton_NFR25.SLDPRT]
2024-07-23 sus geo
    Clerances for droop and compression tested
    [_Suspension_Skeleton_NFR25.SLDPRT]
2024-07-24 Update _Chassis_Skeleton_NFR25.SLDPRT
    redid front with finalized sus points
    [_Chassis_Skeleton_NFR25.SLDPRT]
2024-07-26 rear added
    [_Suspension_Skeleton_NFR25.SLDPRT, steering_analysis_NFR25.SLDPRT]
2024-07-26 Added steering geo analysis
    [_Suspension_Skeleton_NFR25.SLDPRT]
2024-07-26 Repaired rear sus geo
    [_Suspension_Skeleton_NFR25.SLDPRT]
2024-07-26 Update _Chassis_Skeleton_NFR25.SLDPRT
    First round of changes for third iteration
    [_Chassis_Skeleton_NFR25.SLDPRT]
2024-07-26 updated steering front
    I guess I don't need to clarify front
    [_Suspension_Skeleton_NFR25.SLDPRT]
2024-07-28 Updated the CFD block model
    [CFD_Block_Model_NFR25.SLDPRT]
2024-07-30 Accumulator CAD
    i forgot to update this for like 2 weeks
    [BMS_DaughterBoard_25.SLDASM, BottomCellHolder.SLDPRT, BottomCellHolderNoMP.SLDPRT, BottomCellHolderTD.SLDPRT, BusBarTemplate.SLDPRT, CellHolderTemplate.SLDPRT, ColdPlate.SLDPRT, ColdPlateAssembly.SLDASM]
2024-07-30 not much changed
    [_Suspension_Skeleton_NFR25.SLDPRT]
2024-08-01 Changed maintenance plug busbar orientation
    [BusBarIteration1.SLDPRT, MirrorBMS_DaughterBoard_25.SLDASM, MirrorOneSegment.SLDASM, MirrorTopCellHolder.SLDPRT, OneSegment.SLDASM, TopCellHolder.SLDPRT, TwoSegments.SLDASM, TwoSegmentsMirrored.SLDASM]
2024-08-01 Changed surfaces to solid bodies
    [CFD_Block_Model_NFR25.SLDPRT]
2024-08-01 Update _Chassis_Skeleton_NFR25.SLDPRT
    second round of changes to third iteration
    [_Chassis_Skeleton_NFR25.SLDPRT]
2024-08-02 Added impact attenuator
    [_Block_Model_NFR25.SLDPRT]
2024-08-02 Update _Chassis_Skeleton_NFR25.SLDPRT
    second to last round of changes to fourth iteration
    [_Chassis_Skeleton_NFR25.SLDPRT]
2024-08-02 Learning how to make CAD template and made aero limits
    [CFD_Block_Model_NFR25.SLDPRT, NFR25 Aero Limits.SLDPRT]
2024-08-02 updates sus geo
    [_Suspension_Skeleton_NFR25.SLDPRT]
2024-08-03 Third iteration of frame complete
    [_Chassis_Skeleton_NFR25.SLDPRT]
2024-08-06 Started coping tubes
    [Frame_NFR25.SLDPRT, _Chassis_Skeleton_NFR25.SLDPRT, _Suspension_Skeleton_NFR25.SLDPRT]
2024-08-07 Widened front roll hoop
    [_Chassis_Skeleton_NFR25.SLDPRT]
2024-08-07 Widened front roll hoop more
    [_Chassis_Skeleton_NFR25.SLDPRT]
2024-08-07 Widened the front hoop even moar
    [_Chassis_Skeleton_NFR25.SLDPRT]
2024-08-07 Minor skeleton adjustments + all weldments in frame CAD
    [Frame_NFR25.SLDPRT, _Chassis_Skeleton_NFR25.SLDPRT]
2024-08-07 More minor adjustments to frame CAD
    [Frame_NFR25.SLDPRT]
2024-08-07 Maintenance plug and cell holder edits
    [BMS_25_V2.SLDASM, BMS_Sense_Connector_lower.SLDASM, BottomCellHolder.SLDPRT, BottomCellHolderNoMP.SLDPRT, BusBarIteration1.SLDPRT, BusBarTemplate.SLDPRT, CellBusbarTemplate.SLDPRT, ColdPlate.SLDPRT]
2024-08-07 Segment Assembly changes
    - maintenance plug busbar cad edited
    - new assembly for segment created
    [BottomCellHolder.SLDPRT, MasterNegativeTop.SLDPRT, MasterPositiveBottom.SLDPRT, MasterPositiveTop.SLDPRT, MockSensePCB.SLDPRT, OneSegTopNegative.SLDASM, OneSegTopPositive.SLDASM, TopCellHolder.SLDPRT]
2024-08-08 full accumulator assembly created
    pre-PDR
    [BottomCellHolder.SLDPRT, MasterNegativeBottom.SLDPRT, MasterNegativeTop.SLDPRT, MasterPositiveBottom.SLDPRT, MasterPositiveTop.SLDPRT, OneSegTopNegative.SLDASM, OneSegTopPositive.SLDASM, OneSegmentTemplate.SLDASM]
2024-08-08 created tubed coldplate cad
    [tubedColdplate.SLDPRT]
2024-08-09 Update the CFD Block Model
    [CFD_Block_Model_NFR25.SLDPRT]
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2024-08-09 Cell holder and maintenance plug update
    maintenance plugs converted to sheet metal
    [BottomCellHolder.SLDPRT, CellExample.SLDPRT, MasterNegativeSM.SLDPRT, MasterPositiveSM.SLDPRT, OneSegTopNegative.SLDASM, OneSegTopPositive.SLDASM, TopCellHolder.SLDPRT, bottomBusbar.SLDPRT]
2024-08-09 Coped the front + middle of the car; made changes to chassis skeleton following those suggested during frame DR
    [Frame_NFR25.SLDPRT, _Chassis_Skeleton_NFR25.SLDPRT, _Suspension_Skeleton_NFR25.SLDPRT]
2024-08-10 Added Correct BMS25 Daughterboard CAD
    As a part this time instead of a bummy assm
    [BMS_25_V2.SLDASM, BMS_DaughterBoard_25.SLDASM, BMS_Sense_Connector_lower.SLDASM]
2024-08-10 tabs added
    [_Chassis_Skeleton_NFR25.SLDPRT]
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2024-08-10 Fixed front rocker geo
    [Ohlin FSAE Shock Spring.SLDPRT, Ohlins TTX25 MkII FSAE Shock Assembly.SLDASM, Ohlins TTX25 MkII FSAE Shock Lower.SLDPRT, Ohlins TTX25 MkII FSAE Shock Upper.SLDPRT, _Suspension_Skeleton_NFR25.SLDPRT]
2024-08-10 First draft of coping done + minor changes to skeleton including:
    - made rear bulkhead vertical in skeleton
    - added tube in front triangulation for front rocker
    [_Chassis_Skeleton_NFR25.SLDPRT]
2024-08-11 cold plates updated
    [shittyColdplate.SLDPRT, shittyColdplateStep.STEP, tubedColdplate.SLDPRT, tubedColdplateStep.STEP]
2024-08-11 honestly no idea
    [4x40HeatSetInsert.SLDPRT, MasterNegativeTop.SLDPRT, MasterPositiveBottom.SLDPRT, OneSegTopNegative.SLDASM, OneSegTopPositive.SLDASM, TopCellHolder.SLDPRT, ansysTest.SLDPRT, ansysTest.STEP]
2024-08-11 Cell holder and Busbar edits
    - cell holder board and busbar supports thickened
    - sense PCB support layout changed
    - heatset insert holes added to cell holders and busbars
    [BottomCellHolder.SLDPRT, MasterNegativeSM.SLDPRT, MasterPositiveSM.SLDPRT, OneSegTopPositive.SLDASM, TopCellHolder.SLDPRT, bottomBusbar.SLDPRT]
2024-08-11 quick change
    [_Suspension_Skeleton_NFR25.SLDPRT]
2024-08-12 New assembly!
    Oooo fancy
    [AM-4T.SLDPRT, HAB-4ET-sphericalbearing.SLDPRT, NFR22 Spherical Bearing Housing.SLDPRT, Suspension_Assembly_NFR25.SLDASM, _Suspension_Skeleton_NFR25.SLDPRT]
2024-08-12 cold plate and busbar edits
    [BottomCellHolder.SLDPRT, CFDSimAssembly.SLDASM, CFDSimAssemblyStep.STEP, CellBusbarTemplate.SLDPRT, CellExample.SLDPRT, MasterNegativeSM.SLDPRT, MasterPositiveSM.SLDPRT, OneSegTopNegative.SLDASM]
2024-08-12 cell holder updated
    [TopCellHolder.SLDPRT, seriesColdPlate.SLDPRT]
2024-08-12 segment updates.
    [BottomCellHolder.SLDPRT, MasterNegativeSM.SLDPRT, MasterPositiveSM.SLDPRT, OneSegTopPositive.SLDASM, TopCellHolder.SLDPRT, bottomBusbar.SLDPRT, seriesColdPlate.SLDPRT]
2024-08-13 Raised height of the bends in both roll hoops and adjusted skeleton with new rear sus points
    [_Chassis_Skeleton_NFR25.SLDPRT]
2024-08-14 Updated CFD CAD w/ no block model
    [CFD_Block_Model_NFR25_v1.STEP, CFD_Block_Model_NFR25_v2.STEP, CFD_Block_Model_NFR25_v4.STEP]
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2024-08-14 Create rear hub nfr24.SLDPRT
    NFR24 rear hub design
    [rear hub nfr24.SLDPRT]
2024-08-14 Create the Rear Hubs File
    [RearHubs_NFR25.SLDPRT]
2024-08-14 Made rear bulkhead wider in order to make tubes leading up to it more centered along the bulkhead tubes they intersect with
    [_Chassis_Skeleton_NFR25.SLDPRT]
2024-08-15 Fixed some copes and changed order
    Changed order of copes to make it easier to weld. Cleaned up copes on the bulkhead and some nodes.
2024-08-15 Moved IA and diff
    [_Block_Model_NFR25.SLDPRT]
2024-08-15 Updated IA again, added diff model, added emrax motor model
    [_Block_Model_NFR25.SLDPRT]
2024-08-15 minor changes
    Honestly not sure what I changed - can't be much if anything
    [Suspension_Assembly_NFR25.SLDASM, _Suspension_Skeleton_NFR25.SLDPRT]
2024-08-15 Rebuilt sus skeleton to update diff placement
    [_Suspension_Skeleton_NFR25.SLDPRT]
2024-08-16 Create solidworks sketch.SLDPRT
    started front rocker design
    [solidworks sketch.SLDPRT]
2024-08-16 Create Front Rockers.SLDPRT
    renamed rocker file
    [Front Rockers.SLDPRT]
2024-08-16 Updates for nosecone CFD and Reese Design 1
    [Nosecone_Design_1.STEP, Side_Aero_V1.SLDPRT]
2024-08-16 Rear Hubs CAD Beginning
    + Bearing
    [RearHubAssembly.SLDASM, RearHubs_NFR25.SLDPRT, skf_bearing_61916-2rz_2.SLDASM, skf_bearing_61916-2rz_2_01.SLDPRT, skf_bearing_61916-2rz_2_02.SLDPRT, skf_bearing_61916-2rz_2_03.SLDPRT, skf_bearing_61916-2rz_2_04.SLDPRT, skf_bearing_61916-2rz_2_05.SLDPRT]
2024-08-16 Created Nosecone CFD CAD
    [Nosecone_Design_1_CFD.STEP]
2024-08-17 cell holder fea
    [BottomCellHolder.SLDPRT, mockContainer.SLDPRT]
2024-08-17 cold plate tubing radius changed to 3/16 OD
    [seriesColdPlate.SLDPRT]
2024-08-17 Cold plate channel changes
    [seriesColdPlateStep.STEP]
2024-08-17 Update Front Rockers.SLDPRT
    rocker blob v1
    [Front Rockers.SLDPRT]
2024-08-18 Edited the Nosecone and CFD Cad
    [Nosecone_Design_1_CFD.SLDPRT, Nosecone_Design_1_CFD.STEP]
2024-08-19 cell holder changes
    [CellHolderTemplate.SLDPRT, SegmentandColdplate.SLDASM]
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2024-08-19 8 segement 8 cold plate design
    old accumulator container nfr24 now modified to fit the 8 segment 8 cold plate design, still in progress
    [91831A135_18-8 Stainless Steel Nylon-Insert Locknut.SLDPRT, 92196A687_18-8 Stainless Steel Socket Head Screw.SLDPRT, Accumulator_Container_Assembly_2025.SLDASM, Accumulator_Container_E-Box.SLDPRT, Accumulator_Container_Lid_v2.SLDPRT, Accumulator_Container_Lid_v2.STEP, Accumulator_Container_OnePiece.SLDPRT, Inner_wall_long.SLDPRT]
2024-08-19 added front hubs file
    [FrontHub_NFR25.SLDPRT]
2024-08-20 Updated bodywork & CFD block model
    [NFR25_Bodywork.SLDASM, Nosecone_Design_1_Mold.SLDPRT, Nosecone_Design_1_Mold.STEP]
2024-08-20 more updates on the 8 segment including a lid
    [Accumulator_Container_Assembly_2025.SLDASM, Accumulator_Container_OnePiece.SLDPRT, Inner_wall_long.SLDPRT, Inner_wall_wide.SLDPRT, simplelid.SLDPRT]
2024-08-20 Revert "Merge branch 'main' of https://github.com/bsobeloffgittes/NFR25-CAD"
    This reverts commit d50a49d9a8d540c02b003dde6535724582d4e255, reversing
    changes made to 18c544b3e01319364073a3f379cbf8992b115b6d.
    [91831A135_18-8 Stainless Steel Nylon-Insert Locknut.SLDPRT, 92196A687_18-8 Stainless Steel Socket Head Screw.SLDPRT, Accumulator_Container_Assembly_2025.SLDASM, Accumulator_Container_E-Box.SLDPRT, Accumulator_Container_Lid_v2.SLDPRT, Accumulator_Container_Lid_v2.STEP, Accumulator_Container_OnePiece.SLDPRT, Inner_wall_long.SLDPRT]
2024-08-20 Reapply "Merge branch 'main' of https://github.com/bsobeloffgittes/NFR25-CAD"
    This reverts commit 74bbd0f67684c5ca707ce5ef46d66925453608a8.
    [91831A135_18-8 Stainless Steel Nylon-Insert Locknut.SLDPRT, 92196A687_18-8 Stainless Steel Socket Head Screw.SLDPRT, Accumulator_Container_Assembly_2025.SLDASM, Accumulator_Container_E-Box.SLDPRT, Accumulator_Container_Lid_v2.SLDPRT, Accumulator_Container_Lid_v2.STEP, Accumulator_Container_OnePiece.SLDPRT, Inner_wall_long.SLDPRT]
2024-08-21 cell holder adjustments
    [5seg_accumulator.SLDASM, 5seg_busbar_1.SLDPRT, BottomCellHolder.SLDPRT, BottomCellHolder_5segV2.SLDPRT, MasterNegativeSM.SLDPRT, MasterPositiveSM.SLDPRT, NFR_22_molicell_21700_Version_2.0 (shucked, different top geometry).SLDPRT, OneSegTopNegative.SLDASM]
2024-08-21 Added 5 Seg design
    [5seg_accumulator.SLDASM, 5seg_busbar_1.SLDPRT, 5seg_busbar_2.SLDPRT, BottomCellHolder_5segV2.SLDPRT, CellBusbarTemplate.SLDPRT, CellExample.SLDPRT, MasterNegativeBottom.SLDPRT, MasterNegativeSM.SLDPRT]
2024-08-21 side aero design 1
    four airfoil angled design, 08.21.24
    [airfoiltest2.SLDPRT]
2024-08-23 new sus projects
    [RearUpright NFR25.SLDPRT, Suspension_Assembly_NFR25.SLDASM, _Suspension_Skeleton_NFR25.SLDPRT]
2024-08-24 segment work
    [3inchSegBolt.SLDPRT, 5SegAssem.SLDASM, 5SegBottomCellHolder.SLDPRT, 5SegTopCellHolder.SLDPRT, MasterNeg5Seg.SLDPRT, MasterNegativeSM.SLDPRT, MasterPos5Seg.SLDPRT, MockSensePCB.SLDPRT]
2024-08-24 busbar and file rearrangment
    [5SegAssem.SLDASM, 5SegBottomCellHolder.SLDPRT, 5SegTopCellHolder.SLDPRT, 5seg_accumulator.SLDASM, 5seg_busbar_1.SLDPRT, 5seg_busbar_2.SLDPRT, BottomCellHolder.SLDPRT, BottomCellHolderTD.SLDPRT]
2024-08-24 bms holes added to cell holders.
    [5SegAssem.SLDASM, 5SegBottomCellHolder.SLDPRT, 5SegTopCellHolder.SLDPRT, 5seg_accumulator.SLDASM, bottomBusbar.SLDPRT]
2024-08-24 solidworks frame analysis
    [_Chassis_Skeleton_NFR25.SLDPRT]
2024-08-25 new planes added
    [_Suspension_Skeleton_NFR25.SLDPRT]
2024-08-25 Update RearUpright NFR25.SLDPRT
    [RearUpright NFR25.SLDPRT]
2024-08-25 no clevice
    [RearUpright NFR25.SLDPRT]
2024-08-26 Segments updated and hardware added
    [10mmSocket.SLDPRT, 3PBusbar.SLDPRT, 3PBusbar.STEP, 5SegBottomCellHolder.SLDPRT, 5SegTopCellHolder.SLDPRT, BMSBolt.SLDPRT, BusbarNut.SLDPRT, MasterNeg5Seg.SLDPRT]
2024-08-26 Progress in Rear Hubs
    Added brake interface and fixed the bearing interface
    [RearHubAssembly.SLDASM, RearHubs_NFR25.SLDPRT, Suspension_Assembly_NFR25.SLDASM, skf_bearing_61916-2rz_2.SLDASM, skf_bearing_61916-2rz_2_01.SLDPRT, skf_bearing_61916-2rz_2_02.SLDPRT, skf_bearing_61916-2rz_2_03.SLDPRT, skf_bearing_61916-2rz_2_04.SLDPRT]
2024-08-26 Small Change to Rear Hubs
    [RearHubs_NFR25.SLDPRT]
2024-08-26 bottom busbar built and added to assembly
    [SegmentCFD.SLDASM, SegmentNutM6.SLDPRT, bottomSegmentBusbar.SLDPRT]
2024-08-26 full segment saved
    [5SegBottomCellHolder.SLDPRT, 5SegTopCellHolder.SLDPRT, bottomSegmentBusbar.SLDPRT]
2024-08-27 bottom control arm
    [RearUpright NFR25.SLDPRT]
2024-08-27 front planes
    [_Suspension_Skeleton_NFR25.SLDPRT]
2024-08-27 caliper mount start
    [RearUpright NFR25.SLDPRT]
2024-08-27 Began on molds
    [NFR25_Bodywork.SLDASM, NFR25_Left_Back_Side_Panel_Mold.SLDPRT, Nosecone_Design_1.STEP, Nosecone_Design_1_CFD.SLDPRT, Nosecone_Design_1_CFD.STEP, Nosecone_Design_1_Mold.SLDPRT, Nosecone_Design_1_Mold.STEP]
2024-08-27 Rear Hub Changes
    Making it work with the sus assembly
    [RearHubAssembly.SLDASM, RearHubs_NFR25.SLDPRT, Suspension_Assembly_NFR25.SLDASM]
2024-08-28 Updated accumulator geometry in block model for 5 segment
    [_Block_Model_NFR25.SLDPRT]
2024-08-28 NFR24 Wheel Nut and Sleeve
    For reference
    [Wheel_Nut_NFR24.SLDPRT, rear hub back.SLDPRT]
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2024-08-28 Added powertrain components
    [D4672-TA.SLDPRT, tripod_housing_long.SLDPRT]
2024-08-28 Renamed powertrain -> drivetrain
    [D4672-TA.SLDPRT, tripod_housing_long.SLDPRT]
2024-08-28 Many changes
    - hardware added
    - full assembly created
    - top cover constructed.
    [10mmSocket.SLDPRT, 3PBusbar.SLDPRT, 3inchSegBolt.SLDPRT, 4x40HeatSetInsert.SLDPRT, 5SegBottomCellHolder.SLDPRT, 5SegTopCellHolder.SLDPRT, 5seg_accumulator.SLDASM, 5seg_busbar_1.SLDPRT]
2024-08-28 Rear upright added to assembly
    [RearUpright NFR25.SLDPRT, Suspension_Assembly_NFR25.SLDASM]
2024-08-29 segment work
    - edges filleted and sense PCB supports changed.
    [3PBusbar.SLDPRT, 5SegBottomCellHolder.SLDPRT, 5SegTopCellHolder.SLDPRT]
2024-08-29 segment work (fr this time)
    - sense PCB support changed and edges filleted
    [5SegBottomCellHolder.SLDPRT, 5SegTopCellHolder.SLDPRT, MasterNeg5Seg.SLDPRT, MasterPos5Seg.SLDPRT, TopCover.SLDPRT]
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2024-08-29 Fixed distance from edges to holes
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2024-08-29 Organized Front hubs
    Created a front hubs folder and added in the 32006 and 32007 skf bearings as well as the original front hubs file.
    [FrontHub_NFR25.SLDPRT, skf_bearing_32006_x_2.SLDASM, skf_bearing_32006_x_2_01.SLDPRT, skf_bearing_32006_x_2_02.SLDPRT, skf_bearing_32006_x_2_03.SLDPRT, skf_bearing_32007_x_2.SLDASM, skf_bearing_32007_x_2_01.SLDPRT, skf_bearing_32007_x_2_02.SLDPRT]
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2024-08-30 Update FrontHub_NFR25.SLDPRT
    Updated front hub
    [FrontHub_NFR25.SLDPRT]
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2024-08-30 coldplate bolt holes removed
    [seriesColdPlate.SLDPRT, seriesColdPlateStep.STEP]
2024-08-30 cell holder bolts changed from m6 to m5 for FEA
    [5SegBottomCellHolder.SLDPRT, 5SegTopCellHolder.SLDPRT]
2024-08-30 top cell holder bolts changed
    [5SegTopCellHolder.SLDPRT]
2024-08-30 updates to front planes
    [_Suspension_Skeleton_NFR25.SLDPRT]
2024-08-30 Made Rear Hubs Longer
    [RearHubs_NFR25.SLDPRT]
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2024-08-30 cell spacing changed to 1.5mm
    [3PBusbar.SLDPRT, 5SegBottomCellHolder.SLDPRT, 5SegTopCellHolder.SLDPRT, MasterNeg5Seg.SLDPRT, MasterPos5Seg.SLDPRT, TopCover.SLDPRT, bottomSegmentBusbar.SLDPRT]
2024-08-30 aligned Front_hub with B1
    [FrontHub_NFR25.SLDPRT]
2024-08-30 added simulations on cell holder
    [5SegTopCellHolder.SLDPRT]
2024-08-30 added center support in top cell holder
    [5SegTopCellHolder.SLDPRT]
2024-08-30 moving cell holder files
    [BottomCellHolder.SLDPRT, TopCellHolder.SLDPRT]
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2024-08-30 Created front hubs assembly and added bearings to it
    [Front_hubs_assembly.SLDASM, skf_bearing_32006_x_2.SLDASM, skf_bearing_32006_x_2_01.SLDPRT, skf_bearing_32006_x_2_02.SLDPRT, skf_bearing_32006_x_2_03.SLDPRT, skf_bearing_32007_x_2.SLDASM, skf_bearing_32007_x_2_01.SLDPRT, skf_bearing_32007_x_2_02.SLDPRT]
2024-08-31 Deleted the extra bodies
    [frame_w_rearwing_tabs.SLDPRT]
2024-08-31 Added room for wishbone end
    [RearUpright NFR25.SLDPRT]
2024-08-31 top cell holder update
    [M585mmSegmentBolt.SLDPRT, M5SegmentNut.SLDPRT, TopCellHolder.SLDPRT, TopCover.SLDPRT, bottomSegmentBusbar.SLDPRT]
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2024-08-31 Create NFR22-20 Float Pin.SLDPRT
    [NFR22-20 Float Pin.SLDPRT]
2024-08-31 added rear brake caliper CAD
    [Bleed Screw.SLDPRT, Brake Caliper 2.SLDPRT, Brake Caliper_Corrected.SLDPRT, Guide.SLDPRT, MirrorBleed Screw.SLDPRT, MirrorBrake Caliper 2.SLDPRT, MirrorBrake Caliper_Corrected.SLDPRT, MirrorGuide.SLDPRT]
2024-08-31 Added wheels and tires
    [Hoosier 16.0 x 7.5-10.SLDPRT, OZ FS Magnesium CL 10in Wheel 7.5in.SLDPRT]
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2024-08-31 Created Rear Wheel Assembly
    [MirrorWilwood_GP200.SLDASM, SKF_61916-2RZ.SLDPRT, Wheel_Nut_NFR24.SLDPRT, _Rear_Wheel_Assembly_Right_NFR25.SLDASM, _Suspension_Skeleton_NFR25.SLDPRT]
2024-08-31 Created rest of new suspension assemblies
    [AM-4T.SLDPRT, HAB-4ET-sphericalbearing.SLDPRT, MirrorBleed Screw.SLDPRT, MirrorBrake Caliper 2.SLDPRT, MirrorGuide.SLDPRT, MirrorPads.SLDPRT, MirrorWilwood_GP200.SLDASM, NFR22 Spherical Bearing Housing.SLDPRT]
2024-08-31 Added rod end for ARB, adjusted naming
    [AM-3.SLDPRT, AM-3.stp, Front_Corner_Assembly_Right_NFR25.SLDASM, Front_Wheel_Assembly_Right_NFR25.SLDASM, Rear_Corner_Assembly_Right_NFR25.SLDASM, Rear_Wheel_Assembly_Right_NFR25.SLDASM, _Front_Corner_Assembly_Right_NFR25.SLDASM, _Front_Wheel_Assembly_Right_NFR25.SLDASM]
2024-08-31 Added front brake calipers
    [22-048-OB_low_fidelity.SLDPRT]
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2024-09-01 Fixed improper mating in front wheel assem
    [Ohlins TTX25 MkII FSAE Shock Assembly.SLDASM, Rear_Wheel_Assembly_Right_NFR25.SLDASM]
2024-09-01 Modified full vehicle assembly
    [Front_Corner_Assembly_Right_NFR25.SLDASM, Front_Wheel_Assembly_Right_NFR25.SLDASM, Ohlins TTX25 MkII FSAE Shock Assembly.SLDASM, Rear_Corner_Assembly_Right_NFR25.SLDASM, _Chassis_Assembly_NFR25.SLDASM, _Chassis_Skeleton_NFR25.SLDPRT]
2024-09-01 Made Steering Skeleton V1
    made initial steering skeleton (nothing set in stone, just laying out components)
    [NFR25 Rack Pillow Block Bottom V1.SLDPRT, _Suspension_Skeleton_NFR25_w_Steering.SLDPRT]
2024-09-01 Finished most changes to Front Hub
    [FrontHub_NFR25.SLDPRT]
2024-09-01 Whole bunch of changes lol
    [Front_Corner_Assembly_Right_NFR25.SLDASM, Front_Wheel_Assembly_Right_NFR25.SLDASM, Ohlins TTX25 MkII FSAE Shock Assembly.SLDASM, Rear_Corner_Assembly_Right_NFR25.SLDASM, Rear_Wheel_Assembly_Right_NFR25.SLDASM, _Chassis_Skeleton_NFR25.SLDPRT, _Suspension_Skeleton_NFR25.SLDPRT]
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2024-09-01 Fixed missing file references
    [AM-4T.SLDPRT, Front_Corner_Assembly_Right_NFR25.SLDASM, Front_Wheel_Assembly_Right_NFR25.SLDASM, Hoosier 16.0 x 7.5-10.SLDPRT, Rear_Corner_Assembly_Right_NFR25.SLDASM, Rear_Wheel_Assembly_Right_NFR25.SLDASM]
2024-09-01 Revert "Merge branch 'main' of https://github.com/bsobeloffgittes/NFR25-CAD"
    This reverts commit 2940ffecb05a957f583f389b925c5d717767fd09, reversing
    changes made to ebca48228c921920afc38838e45a4c22418053fb.
    [22-048-OB_low_fidelity.SLDPRT, AM-3.SLDPRT, AM-3.stp, AM-4T.SLDPRT, Bleed Screw.SLDPRT, Brake Caliper 2.SLDPRT, Brake Caliper_Corrected.SLDPRT, FrontHub_NFR25.SLDPRT]
2024-09-01 Fixed broken stuff hopefully
    [Front_Corner_Assembly_Right_NFR25.SLDASM, Front_Wheel_Assembly_Right_NFR25.SLDASM, Rear_Corner_Assembly_Right_NFR25.SLDASM, Rear_Wheel_Assembly_Right_NFR25.SLDASM]
2024-09-01 Higher steering wheel point test
    wip
    [_Suspension_Skeleton_NFR25_w_Steering.SLDPRT]
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2024-09-01 Added IMD model
    Added IMD model, as well as .stl for the IMD connectors. For now IMD is block model, but connectors can be placed in the blocks' place if I can figure out how to precisely place parts within a .SLDPRT file
    [IMD_iso175.SLDPRT, c-2-1445055-2-b-3d.SLDPRT, c-2-1445055-2-b-3d.stl, c-2-1445057-8-d-3d.SLDPRT, c-2-1445057-8-d-3d.stl]
2024-09-02 Cell holder edits
    changing cell holder busbar space and FEA
    [TopCellHolder.SLDPRT]
2024-09-02 CAD for steering components
    Still messing with geometry so not final dimensions
    [NFR25_Steering_Assembly.SLDASM, Steering Lower Column.SLDPRT, Steering Mount.SLDPRT, Steering Upper Column.SLDPRT, Top Mount Adapter.SLDPRT, _Suspension_Skeleton_NFR25_w_Steering.SLDPRT]
2024-09-02 Steering assembly into frame
    And many other parts made
    [KAZ_Steering_Rack_-_Dumb_Solid.SLDPRT, NFR25_Steering_Assembly.SLDASM, NFR25_Steering_Assembly_In_Frame.SLDASM, Racetech Quick Release.SLDPRT, Ruland_HD-2A HD SERIES BLOCK_750-2A.SLDPRT, Ruland_HD-3A HD SERIES SMALL PIN_750-3A.SLDPRT, Ruland_HD-5A HD SERIES LARGE PIN_750-5A.SLDPRT, Ruland_Retaining Ring_750-6A INSTALLED.SLDPRT]
2024-09-03 changes to wheel and corner assembly
    clearance added for brake caliper
    [0.25-28 1.25in Bolt 91257A565.SLDPRT, 0.25-28 1.375in Bolt 91257A112.SLDPRT, 0.25-28 1.5in Bolt 91257A566.SLDPRT, 0.25-28 1.75in Bolt 91257A567.SLDPRT, 0.25-28 Locknut 99291A220.SLDPRT, 0.25in Washer 90107A029.SLDPRT, 0.625x0.5 insert.SLDPRT, AM-4T.SLDPRT]
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2024-09-03 90% of Steering Assembly CAD
    All components except for ujoints and small adapter inserts in assembly. Rules legal and no clearance issues but tie rod lengths TBD
    [NFR25 3D Ackerman Geometry Test.SLDPRT, NFR25_Steering_Assembly.SLDASM, NFR25_Steering_Assembly_In_Frame.SLDASM, Steering Lower Column.SLDPRT, Steering Mount.SLDPRT, Steering Upper Column.SLDPRT, Top Mount Adapter.SLDPRT, _Suspension_Skeleton_NFR25_w_Steering.SLDPRT]
2024-09-03 changing segments
    - cell size
    - busbar spacing
    - other shit
    [3PBusbar.SLDPRT, BottomCellHolder.SLDPRT, CellExample.SLDPRT, MasterNeg5Seg.SLDPRT, MasterPos5Seg.SLDPRT, TopCellHolder.SLDPRT, TopCover.SLDPRT, bottomBusbar.SLDPRT]
2024-09-03 small chnages to rear upright
    [M8-1.25 Locknut 94645A210.SLDPRT, RearUpright NFR25.SLDPRT]
2024-09-03 Update to steering assembly
    [NFR25_Steering_Assembly_In_Frame.SLDASM]
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2024-09-03 Hardware added and countersinks removed from busbars
    [10-32Insert.SLDPRT, BottomCellHolder.SLDPRT, MasterNeg5Seg.SLDPRT, MasterPos5Seg.SLDPRT, NylonBMSBolt3-16.SLDPRT, TopCellHolder.SLDPRT, bottomBusbar.SLDPRT, topBusbar.SLDPRT]
2024-09-04 Created Nosecone CFD Part
    [NFR25 Aero Limits.SLDPRT, Nosecone_2_CFD.SLDPRT, Nosecone_2_CFD.STEP]
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2024-09-04 busbar and cell holder edits
    [BottomCellHolder.SLDPRT, LowProfileBusbarBolt1-4.SLDPRT, LowProfileBusbarBolt3-8.SLDPRT, LowProfileBusbarBolts.SLDPRT, Molicel21700.SLDPRT, TopCellHolder.SLDPRT, TopCover.SLDPRT, bottomBusbar.SLDPRT]
2024-09-04 Updated container for 5 seg design
    [Accumulator_Container 5 SEG.SLDASM, Accumulator_Container_E-Box.SLDPRT, Accumulator_Container_Lid_v2.SLDPRT, Accumulator_Container_Lid_v2.STEP, Accumulator_Container_OnePiece.SLDPRT, Flat pattern - Accumulator_Container_E-Box.DXF, Flat pattern - Accumulator_Container_E-Box2.DXF, Flat pattern - Accumulator_Container_Lid_5_21_24.DXF]
2024-09-04 update box with lid
    [Accumulator_Container 5 SEG.SLDASM, Accumulator_Container_Lid_v2.SLDPRT, Accumulator_Container_OnePiece.SLDPRT, Accumulator_Container_OnePiece.STEP, Flat pattern - Accumulator_Container_E-Box.DXF, Flat pattern - Accumulator_Container_E-Box2.DXF, Flat pattern - Accumulator_Container_Lid_5_21_24.DXF, Flat pattern - Accumulator_Container_Lid_5_22_24.DXF]
2024-09-04 fillets and arm clearance
    [RearUpright NFR25.SLDPRT]
2024-09-04 PDR Updates to Rear Hubs
    [RearHubs_NFR25.SLDPRT]
2024-09-04 Not changes made by me?
    [Accumulator_Container_Lid_v2.SLDPRT, Accumulator_Container_OnePiece.STEP, Flat pattern - Accumulator_Container_E-Box.DXF, Flat pattern - Accumulator_Container_E-Box2.DXF, Flat pattern - Accumulator_Container_Lid_5_21_24.DXF, Flat pattern - Accumulator_Container_Lid_5_22_24.DXF, Flat pattern - Accumulator_Container_Lid_v2.DXF, Flat pattern - Accumulator_Container_Lid_v3.DXF]
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2024-09-05 Revert "Merge branch 'main' of https://github.com/bsobeloffgittes/NFR25-CAD"
    This reverts commit aaad014b1f50a42e040e137b95635ca15b6b99d0, reversing
    changes made to aaad5b0cde147e1f5419801aef7a3e853e851107.
    [NFR25 Aero Limits.SLDPRT]
2024-09-05 reverting incorrect changes 2
    [10-32Insert.SLDPRT, 3PBusbar.SLDPRT, CellExample.SLDPRT, MasterNeg5Seg.SLDPRT, MasterPos5Seg.SLDPRT, NylonBMSBolt3-16.SLDPRT, bottomSegmentBusbar.SLDPRT]
2024-09-05 bottom cell holder filleted
    [BottomCellHolder.SLDPRT, ColdPlate1.SLDPRT, ColdPlateTemplate.SLDPRT]
2024-09-05 Revert "reverting incorrect changes 2"
    This reverts commit c2a83022f52993629d2bc9d0eca336c04b5ac014.
    [10-32Insert.SLDPRT, 3PBusbar.SLDPRT, CellExample.SLDPRT, MasterNeg5Seg.SLDPRT, MasterPos5Seg.SLDPRT, NylonBMSBolt3-16.SLDPRT, bottomSegmentBusbar.SLDPRT]
2024-09-05 Got most up to date top cell holder
    [TopCellHolder.SLDPRT]
2024-09-05 Initial commit of SensePCB 3D Model
    [AMPHENOL_87606-320LF_CMP-002-00085-2.SLDPRT, NFR25_SensePCB.SLDASM, NFR25_SensePCB_BOARD.SLDPRT]
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2024-09-05 I messed up the sense PCB files
    [NFR25_SensePCB.SLDASM, NFR25_SensePCB_BOARD.SLDPRT]
2024-09-05 Integrated steering into suspension skeleton
    [NFR25_Steering_Assembly.SLDASM, NFR25_Steering_Assembly_In_Frame.SLDASM, Steering Upper Column.SLDPRT, _Steering_Assembly_NFR25.SLDASM, _Suspension_Skeleton_NFR25.SLDPRT, _Suspension_Skeleton_NFR25_w_Steering.SLDPRT, steering_analysis_NFR25.SLDPRT]
2024-09-05 Added steering to suspension and full vehicle assemblies
    [Front_Corner_Assembly_Right_NFR25.SLDASM, Front_Wheel_Assembly_Right_NFR25.SLDASM]
2024-09-05 Added sensePCB CAD to accumulator folder
    [AMPHENOL_87606-320LF_CMP-002-00085-2.SLDPRT, NFR25_SensePCB.SLDASM, NFR25_SensePCB_BOARD.SLDPRT]
2024-09-05 Added a lighter weight SensePCB
    [6072204096.SLDPRT, Board-Part-1.SLDPRT, Board.SLDASM, High Side.SLDASM, Low Side.SLDASM, SensePCB.SLDASM]
2024-09-05 cell holders and busbar adjusted for more sensePCB space.
    [BottomCellHolder.SLDPRT, CellExample.SLDPRT, Molicel21700.SLDPRT, NFR_22_molicell_21700_Version_2.0 (shucked, different top geometry).SLDPRT, TopCellHolder.SLDPRT, TopCover.SLDPRT, bottomSegmentBusbar.SLDPRT]
2024-09-05 SensePCB adjustments
    - bottom cell holder and top cell holder given extra space for sensePCB
    - bottom busbar changed to reflect other changes
    [BottomCellHolder.SLDPRT, TopCellHolder.SLDPRT, TopCover.SLDPRT, bottomSegmentBusbar.SLDPRT]
2024-09-05 same shit new pants
    [TopCellHolder.SLDPRT]
2024-09-05 cell holders adjusted to fit new sensePCB
    [BottomCellHolder.SLDPRT, TopCellHolder.SLDPRT]
2024-09-05 ***Segment Benchmark
    - hardware and whatnot added to assembly
    - there are a few more things that will need work, but in case of another hurricane drake in the github, this should be a pretty safe spot to revert back to
    [10-32Insert.SLDPRT, 3inchSegBolt.SLDPRT, 4x40HeatSetInsert.SLDPRT, 90633A005_4x40_LowProfileNylonLocknut.SLDPRT, 91290A105_M5_85mm_CapScrew.SLDPRT, 92220A121_4x40_1-4_LowProfileCapScrew.SLDPRT, 92220A122_4x40_3-8_LowProfileCapScrew.SLDPRT, 93365A120_4x40_HeatsetInsert.SLDPRT]
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2024-09-06 fixed inner bearing for front hubs
    [FrontHub_NFR25.SLDPRT, Front_hubs_assembly.SLDASM]
2024-09-06 Updated front hubs with proper fillets
    [FrontHub_NFR25.SLDPRT, Front_hubs_assembly.SLDASM]
2024-09-06 Added steering wheel file
    [Steering Wheel Plate.SLDPRT, _Steering_Assembly_NFR25.SLDASM]
2024-09-06 Fixed local reference
    [Front_Corner_Assembly_Right_NFR25.SLDASM, Front_Wheel_Assembly_Right_NFR25.SLDASM, NFR22-20 Float Pin.SLDPRT]
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2024-09-06 Changed to reference sus skele directly
    [FrontHub_NFR25.SLDPRT]
2024-09-06 Finished Front Hubs (with Benji's help)!
    [FrontHub_NFR25.SLDPRT]
2024-09-06 Rebuilt assemblies for more flexibility
    [Front_Corner_Assembly_Right_NFR25.SLDASM, Front_Wheel_Assembly_Right_NFR25.SLDASM, Ohlins TTX25 MkII FSAE Shock Assembly.SLDASM]
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2024-09-07 Moved steering rack to be in line with tie rods
    Stella's first iteration post-Isabella. Moved the steering rack to be in-line with the tie rod points. Added the distance between the steering rack to where the column actually starts (distance between the linear part and the pinion)
    [_Steering_Assembly_NFR25.SLDASM, _Suspension_Skeleton_NFR25.SLDPRT]
2024-09-07 cold plate work
    - first cold plate that youssef ran. resulted in 1 degree delta T. max temp was 32C
    [50635K649_1-8_CopperTubingShortNut.SLDPRT, 50675K46_1-8_CopperTubingNut.SLDPRT, CFDSimAssembly.SLDASM, ColdPlate1.SLDPRT, ColdPlate1Step.STEP, Thick_Coldplate.SLDPRT, thermalPad.SLDPRT]
2024-09-07 Changed steering column lengths
    Steering wheel now below the front hoop (now rules legal). Adjusted steering column lengths and angles to make this change
    [_Steering_Assembly_NFR25.SLDASM, _Suspension_Skeleton_NFR25.SLDPRT]
2024-09-07 shitty cold plates deleted and bottom facing cold plate created
    [50635K649_1-8_CopperTubingShortNut.SLDPRT, 50675K46_1-8_CopperTubingNut.SLDPRT, CFDSimAssembly.SLDASM, ColdPlate.SLDPRT, ColdPlate1.SLDPRT, ColdPlate2.SLDPRT, ColdPlateAssembly.SLDASM, ColdPlateTemplate.SLDPRT]
2024-09-07 inner wall parts added
    [Inner wall no flanges.SLDPRT, Inner_wall_long.SLDPRT]
2024-09-07 internal walls actually added
    [Accumulator_Container 5 SEG.SLDASM, Accumulator_Container_OnePiece.SLDPRT]
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2024-09-07 Moved steering mount point lower and to the front
    Resulted in changing u joint angles
    [_Suspension_Skeleton_NFR25.SLDPRT]
2024-09-07 busbars edited to make spacing easier
    [bottomBusbar.SLDPRT, topBusbar.SLDPRT]
2024-09-08 Added ujoints, steering rack to sus skeleton and assemblies
    [Ruland_us12-6-f.SLDASM, Steering Lower Column.SLDPRT, Steering Upper Column.SLDPRT, _Block_Model_NFR25.SLDPRT, _Steering_Assembly_NFR25.SLDASM, _Suspension_Skeleton_NFR25.SLDPRT]
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2024-09-08 Mold Manufacturing Check with foam
    [Layer_1.SLDASM, Layer_2.SLDASM, Layer_3.SLDASM, Layer_4.SLDASM, Layer_4_&_5.SLDASM, Layer_5.SLDASM, Layer_7_&_8.SLDASM, NB_1.SLDPRT]
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2024-09-08 Updated rear rocker geometry
    [_Suspension_Skeleton_NFR25.SLDPRT]
2024-09-08 Mold Manufacturing Check with foam, car number
    [Layer_1.SLDASM, Layer_2.SLDASM, Layer_3.SLDASM, Layer_4.SLDASM, Layer_4_&_5.SLDASM, Layer_5.SLDASM, Layer_7_&_8.SLDASM, NB_1.SLDPRT]
2024-09-08 Fixing up aero assembly
    [NFR25 Aero Limits.SLDPRT, NFR25_Bodywork.SLDASM, NFR25_RearWing_Eshan.SLDPRT]
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2024-09-08 added hv box connectors to assembly
    [3PBusbar.STEP, MasterNeg5Seg.STEP, MasterPos5Seg.STEP, PortTopBusbar.SLDPRT, SLPRBTPSO_PlaceholderFemaleAmphenol.SLDPRT, SSLPPB50BSO_PlaceholderMaleAmphenol.SLDPRT, bottomBusbar.STEP, bottomRightBusbar.SLDPRT]
2024-09-09 maintenance plugs and busbars updated
    [2043130010_FemaleMolex.SLDPRT, ColdPlate2.SLDPRT, FemaleMPBusbar.SLDPRT, Female_Maintenance_Plug_Assembly.SLDASM, TopCellHolder.SLDPRT]
2024-09-09 Added contactor 3D model
    Added EV200 3D model for use in penthouse planning
    [ev200a_KILOVAC-Contactor-500+Amps-12-900VDC.SLDPRT, iso175_IMD.SLDPRT]
2024-09-09 Added manual service disconnect (MSD) part
    [EM30MSD_Manual_Service_Disconnect.SLDPRT]
2024-09-09 Added penthouse layout, renamed vehicle assembly
    [penthouse_layout.SLDPRT]
2024-09-09 Prelim design of 3 element rear wing
    [NFR25_RearWing_Wes.SLDPRT]
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2024-09-09 Updated SensePCB design to include voltage sensing pads
    [NFR25_SensePCB.SLDPRT]
2024-09-09 another segment benchmark
    - protective tubes added
    - all hardware included
    - cold plates not yet finalized
    [BottomCellHolder.SLDPRT, ColdPlate2.SLDPRT, Part1.SLDPRT, SegmentBoltTubes.SLDPRT, TopCellHolder.SLDPRT, topBusbar.SLDPRT]
2024-09-09 step file for Hesse saved
    [Part1.SLDPRT]
2024-09-09 Testing curved airfoils on 3 element design
    [NFR25_RearWing_Wes - Messing_Around.SLDPRT]
2024-09-09 Rename NFR25_RearWing_Wes - Messing_Around.SLDPRT to NFR25_RearWing_Wes_Curved.SLDPRT
    [NFR25_RearWing_Wes_Curved.SLDPRT]
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2024-09-09 a-arm added to rear assembly
    [Ohlins TTX25 MkII FSAE Shock Assembly.SLDASM, RearUpright NFR25.SLDPRT]
2024-09-09 Renamed left navbar items and slight tweaks
    [NFR25_RearWing_Wes.SLDPRT, NFR25_RearWing_Wes_Curved.SLDPRT]
2024-09-10 Pushed steering mount 1 in back from driver
    Now 10 in from rack instead of 11 in
    [_Suspension_Skeleton_NFR25.SLDPRT]
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2024-09-10 added flanges and inner wall stuff
    [90thouspacer.SLDPRT, Accumulator_Container 5 SEG.SLDASM, Accumulator_Container_OnePiece.SLDPRT, Inner wall no flanges.SLDPRT, wall with flanges.SLDPRT]
2024-09-10 Updated steering assembly with correct mates and adapter and column
    Benji said to make a freshman meet the manufacturing requirement of tolerance = 0 thou
    [Steering Lower Column.SLDPRT, Steering Mount.SLDPRT, Steering Upper Column.SLDPRT, Top Mount Adapter.SLDPRT, _Steering_Assembly_NFR25.SLDASM]
2024-09-10 change to shock tabs
    [_Chassis_Skeleton_NFR25.SLDPRT]
2024-09-10 Raised accumulator 0.28" to allow for fittings
    [_Block_Model_NFR25.SLDPRT]
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2024-09-10 cold plate weight reduced
    [ColdPlate2.SLDPRT]
2024-09-10 Included General Jigging Assembly
    [Aluminum Extrusion 2.SLDPRT, Aluminum Extrusion.SLDPRT, Horizontal 1.SLDPRT, Horizontal 2.SLDPRT, Jigging Assembly.SLDASM, Long 1.SLDPRT, Long 2.SLDPRT]
2024-09-10 Fixed broken references
    [_Chassis_Skeleton_NFR25.SLDPRT, _Suspension_Skeleton_NFR25.SLDPRT]
2024-09-10 Fixed other things that got reverted
    [Steering Lower Column.SLDPRT, Steering Mount.SLDPRT, Steering Upper Column.SLDPRT, Top Mount Adapter.SLDPRT, _Block_Model_NFR25.SLDPRT, _Steering_Assembly_NFR25.SLDASM, _Suspension_Skeleton_NFR25.SLDPRT]
2024-09-10 FEA Case 1 on Rear Hubs
    [RearHubs_NFR25.SLDPRT]
2024-09-10 New Rear Rocker Model
    [Rear Rockers V2.SLDPRT]
2024-09-10 V1 of wheel turn angles
    based on current placement of rack
    [NFR25 3D Ackerman Geometry Test.SLDPRT]
2024-09-10 Updated Values for 3D Angle Sketch
    [NFR25 3D Ackerman Geometry Test.SLDPRT]
2024-09-11 Added reverted accumulator files
    [90thouspacer.SLDPRT, wall with flanges.SLDPRT]
2024-09-11 WIPs for steering target calcs
    [NFR25 3D Ackerman Geometry Test.SLDPRT, NFR25 Hairpin Angles.SLDPRT, Steering_Hairpin_w_Toe_Test.SLDPRT, steering_analysis_NFR25.SLDPRT]
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2024-09-11 reverted more changes
    [Accumulator_Container 5 SEG.SLDASM, Accumulator_Container_OnePiece.SLDPRT, Inner wall no flanges.SLDPRT]
2024-09-11 Added step files for the CFD template
    [NFR21_Side_Aero.STEP, NFR24_Undertray_Diffuser.STEP, NFR25_Straight_Wind_Tunnel.STEP]
2024-09-11 added rivet holes and rivets
    [97524A154_Sealing Blind Rivets.SLDPRT, 97524A154_Sealing Blind Rivets.STEP, Accumulator_Container 5 SEG.SLDASM, Accumulator_Container_OnePiece.SLDPRT, wall with flanges.SLDPRT]
2024-09-11 Made front roll hoop taller by roughly 0.5 inches
    [_Chassis_Skeleton_NFR25.SLDPRT]
2024-09-11 Suppressed hardware in accum assembly
    I made all of the segments lightweight versions and made derived configurations with suppressed hardware to make the assembly easier to manipulate
    [BottomCellHolder.SLDPRT, ColdPlate2.SLDPRT, PortTopBusbar.SLDPRT, TopCellHolder.SLDPRT]
2024-09-12 penthouse mockup created and maintenance connectors built
    [BottomCellHolder.SLDPRT, FemaleMPBusbar.SLDPRT, Female_Maintenance_Plug_Assembly.SLDASM, PenthouseMockup.SLDPRT, SegmentBoltTubes.SLDPRT, TopCellHolder.SLDPRT]
2024-09-12 last push before DR
    [91251A439_1-4x28_5-8_CapScrew.SLDPRT, 91864A047_1-4x28_1-2_CapScrew.SLDPRT, ColdPlate2.SLDPRT]
2024-09-12 Fixed rivet
    [97524A154_Sealing Blind Rivets.SLDPRT]
2024-09-12 bottom cell holder adjusted and full assembly saved
    [BottomCellHolder.SLDPRT, BottomCellHolder_BuildParts.STEP, TopCellHolder.SLDPRT, TopCellHolder_BuildParts.STEP]
2024-09-12 Fixed broken changes
    [2043130010_FemaleMolex.SLDPRT, 3PBusbar.STEP, 4138T521_Gas Spring.SLDPRT, 4138T521_Gas Spring_toppart.SLDPRT, 4143N18_Rotary Shaft (1).SLDPRT, 4143N18_Rotary Shaft.SLDPRT, 4473N18_Mounted Ball Bearing with Two-Bolt Flange.SLDPRT, 4473N18_Mounted Ball Bearing with Two-Bolt Flange.STEP]
2024-09-12 Update Rear Rockers V2.SLDPRT
    [Rear Rockers V2.SLDPRT]
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2024-09-12 Ran FEA for 3/4 cases for Front Hubs
    [FrontHub_NFR25.SLDPRT]
2024-09-12 Failed 2D sim of 3 element rear wing design 1
    [NFR25_RearWing_Wes.IGS]
2024-09-13 Rear Rockers Updates and added to Rear Corner Assembly
    [Rear Rockers V2.SLDPRT]
2024-09-13 Updated aero limits and assembly
    [NFR25_Aero.SLDASM]
2024-09-13 Reordered copes and moved jigging locs
    [Jigging Assembly.SLDASM]
2024-09-13 Updated front rockers and added to assembly
    [Front Rockers.SLDPRT, Front_Corner_Assembly_Right_NFR25.SLDASM, Ohlins TTX25 MkII FSAE Shock Lower.SLDPRT]
2024-09-13 fixed error in front rockers
    [Front Rockers.SLDPRT]
2024-09-14 Organizing different sim attempts
    [NFR25_RearWing_Design1_2D_Try2.STEP, NFR25_RearWing_Design1_2D_Try2_Raw.SLDPRT, NFR25_RearWing_Wes.IGS]
2024-09-14 Try 2 at 2D sim of 3 element rear wing -- success
    [drag-coeff.tsv, drag-force.tsv, lift-coeff.tsv, lift-force.tsv, pressure.tsv, velocity.tsv]
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2024-09-14 changes to accumulator post pdr
    [Accumulator_Container 5 SEG.SLDASM, Accumulator_Container_OnePiece.SLDPRT, ColdPlate2.SLDPRT, wall with flanges.SLDPRT]
2024-09-15 Updated the bodywork assem
    [NFR25_Bodywork.SLDASM]
2024-09-16 Removing sims from github
    [NFR25_RearWing_Design1_2D_Try2.STEP, NFR25_RearWing_Design1_2D_Try2_Raw.SLDPRT, NFR25_RearWing_Wes.IGS, drag-coeff.tsv, drag-force.tsv, lift-coeff.tsv, lift-force.tsv, pressure.tsv]
2024-09-16 Updated front rockers design
    [Front Rockers.SLDPRT]
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2024-09-17 Create wheel speed sensor.SLDPRT
    [wheel speed sensor.SLDPRT]
2024-09-17 bolt clearance test
    [RearUpright NFR25.SLDPRT]
2024-09-18 Cleared arms interferences
    [RearUpright NFR25.SLDPRT]
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2024-09-18 segment exploded view created
    [ColdPlate2.SLDPRT]
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2024-09-19 added pullrod and bolts
    [AM-4T.SLDPRT, Front_Uprights_NFR25.SLDPRT, Front_Wheel_Assembly_Right_NFR25.SLDASM, Ohlins TTX25 MkII FSAE Shock Assembly.SLDASM]
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2024-09-19 Front rockers PDR updates v1
    [Front Rockers.SLDPRT]
2024-09-19 Rockers PDR update v2
    [Front Rockers.SLDPRT]
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2024-09-20 changes to front upright
    [0.25-28 0.75in Bolt.SLDPRT, 0.25-28 1.0in Bolt.SLDPRT, 0.25-28 2.0in Bolt.SLDPRT, Front_Uprights_NFR25.SLDPRT, Front_Wheel_Assembly_Right_NFR25.SLDASM, Ohlins TTX25 MkII FSAE Shock Assembly.SLDASM, front Upright clevis NFR25.SLDPRT]
2024-09-20 moved front rotor 2mm outboard
    Made sure it updated on front hubs, all looks good on my end
    [FrontHub_NFR25.SLDPRT, Front_Uprights_NFR25.SLDPRT, Front_Wheel_Assembly_Right_NFR25.SLDASM, _Suspension_Skeleton_NFR25.SLDPRT]
2024-09-20 added brake caliper front
    [22-048-OB_low_fidelity.SLDPRT, M8-60mm Bolt.SLDPRT, OZ FS Magnesium CL 10in Wheel 7.5in.SLDPRT, Wheel_Nut_NFR24.SLDPRT]
2024-09-20 change to front tabs
    [Tab FEA Test.SLDPRT, _Chassis_Skeleton_NFR25.SLDPRT, _Suspension_Skeleton_NFR25.SLDPRT]
2024-09-20 Probably final changes to frame
    [_Chassis_Skeleton_NFR25.SLDPRT]
2024-09-21 okay so my changes last time didnt actually go through so this is probably the last/second to last changes to frame
    [_Chassis_Skeleton_NFR25.SLDPRT]
2024-09-22 Updated the decals in the nosecone
    [NFR25_Bodywork.SLDASM]
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2024-09-22 Updated bodywork for dr
    [NFR25_Bodywork.SLDASM]
2024-09-22 Updated the bodywork for dr
    [NFR25_Bodywork.SLDASM]
2024-09-23 tabs changed
    holes now 10mm apart instead of 14. Did FEA to make sure this was alright using 1000 lbs
    [_Chassis_Skeleton_NFR25.SLDPRT, _Suspension_Skeleton_NFR25.SLDPRT]
2024-09-23 Created current transducer cad for inverter
    [L01Z300S05_current_transducer.SLDPRT, L01Z300S05_current_transducer.STEP]
2024-09-23 Small changes to lid and constraints in accum
    [Accumulator_Container 5 SEG.SLDASM, Accumulator_Container_Lid_v2.SLDPRT, ColdPlate2.SLDPRT]
2024-09-23 cells changed to be more accurate dimensions
    [Molicel21700.SLDPRT, SegmentBoltTubes.SLDPRT]
2024-09-23 Updated bodywork and aero assem
    [NFR25_Aero.SLDASM, NFR25_Bodywork.SLDASM]
2024-09-23 rought penthouse sheet metal enclosure added
    [Accumulator_Container_Lid_v2.STEP, ColdPlate2.SLDPRT, Penthouse_box_U.SLDPRT, Penthouse_box_frontface.SLDPRT, Penthouse_lid.SLDPRT, penthouse_container.SLDASM]
2024-09-24 cold plate edited to fit into bottom cell holder and spacers created
    [BottomCellHolder.SLDPRT, ColdPlate2.SLDPRT, ColdPlateSpacers.SLDPRT]
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2024-09-24 shortened top adapter and mount
    [Steering Mount.SLDPRT, Top Mount Adapter.SLDPRT]
2024-09-24 send cut send files for busbars created
    [3PBusbarSCS.STEP, MasterNeg5SegSCS.STEP, MasterPos5SegSCS.STEP]
2024-09-24 added inboard rod ends
    [Front Rockers.SLDPRT, FrontHub_NFR25.SLDPRT, Front_Uprights_NFR25.SLDPRT, Rear Rockers V3.SLDPRT, RearUpright NFR25.SLDPRT, _Suspension_Skeleton_NFR25.SLDPRT]
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2024-09-25 Create 91280A087_Medium-Strength Class 8.8 Steel Hex Head Screw.SLDPRT
    [91280A087_Medium-Strength Class 8.8 Steel Hex Head Screw.SLDPRT]
2024-09-25 Made changes to allow for droop and compression of front suspension
    [Front_Lower_Arm_Assembly_NFR25.SLDASM, Front_Pull_Rod_Assembly_NFR25.SLDASM, Front_Tie_Rod_Assembly_NFR25.SLDASM, Front_Upper_Arm_Assembly_NFR25.SLDASM, Ohlins TTX25 MkII FSAE Shock Assembly.SLDASM]
2024-09-25 cold plate edited with new bend radius
    [3PBusbar.SLDPRT, ColdPlate2.SLDPRT, MasterNeg5Seg.SLDPRT, MasterPos5Seg.SLDPRT, bottomSegmentBusbar.SLDPRT]
2024-09-25 Added extension to sidepanels and cut the holes
    [NFR25_Bodywork.SLDASM]
2024-09-25 Updated Front hubs to improve outside braking FEA case
    [FrontHub_NFR25.SLDPRT]
2024-09-26 Rockers update -- bushing
    [Front Rockers.SLDPRT]
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2024-09-26 updated front wing design
    [NFR_25_FrontWing.SLDPRT]
2024-09-26 Created 2 wing design and tweaked 3 wing design
    [NFR25_RearWing_Design1_2D_Try2_Raw.SLDPRT, NFR25_RearWing_Wes-2element.SLDPRT, NFR25_RearWing_Wes-2element.STEP, NFR25_RearWing_Wes.SLDPRT, NFR25_RearWing_Wes_Assem.SLDASM]
2024-09-26 Check rules with Wes's wing and add it to aero assembly
    [NFR25_Aero.SLDASM, NFR25_RearWing_Wes-2element.SLDPRT]
2024-09-26 Thickened outer bearing mount to increase safety factor
    [FrontHub_NFR25.SLDPRT]
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2024-09-27 Fixed block model with new nosecone and side panels
    [CFD_Block_Model_NFR25_v7.STEP, NFR25_Bodywork.SLDASM]
2024-09-27 front wing change
    added inner endplates for the front wing
    [NFR25_Aero.SLDASM, NFR_25_FrontWing.SLDPRT]
2024-09-27 trying new inner bearing location to reduce stress
    [FrontHub_NFR25.SLDPRT]
2024-09-27 small changes to assembly
    [Front Rockers.SLDPRT, Front_Pull_Rod_Assembly_NFR25.SLDASM, _Suspension_Skeleton_NFR25.SLDPRT]
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2024-09-27 Penthouse Changes and some components in
    [Part1.SLDPRT, Penthouse_box_U.SLDPRT, Penthouse_box_backface.SLDPRT, Penthouse_box_frontface.SLDPRT, Penthouse_internals.SLDASM, Penthouse_leftwall.SLDPRT, Penthouse_rightwall.SLDPRT, Plastic Base Plate.SLDPRT]
2024-09-27 cold plate exploded view
    [ColdPlate2.SLDPRT]
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2024-09-27 Modified ARB geometry, created ARB assemblies
    [ARB_Assembly_Front_NFR25.SLDASM, ARB_Assembly_Rear_NFR25.SLDASM, _Suspension_Skeleton_NFR25.SLDPRT]
2024-09-27 dr changes (without arb change)
    [Front Rockers.SLDPRT]
2024-09-27 front rockers dr update w/ arb change
    [Front Rockers.SLDPRT]
2024-09-27 front rockers fea after dr
    [Front Rockers.SLDPRT]
2024-09-27 Made configurations of rear suspension to be free, compressed, droop
    [AM-4T.SLDPRT, Front_Lower_Arm_Assembly_NFR25.SLDASM, Front_Pull_Rod_Assembly_NFR25.SLDASM, Front_Tie_Rod_Assembly_NFR25.SLDASM, Front_Upper_Arm_Assembly_NFR25.SLDASM, Ohlins TTX25 MkII FSAE Shock Assembly.SLDASM, Rear_Front_Lower_Control_Arm_Assembly_NFR25.SLDASM, Rear_Pullrod_Assembly_NFR25.SLDASM]
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2024-09-28 top cell holder FEA
    [ColdPlateSpacers.SLDPRT, TopCellHolder.SLDPRT]
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2024-09-28 Front wing changes
    Increased height of outer endplates
    [NFR_25_FrontWing.SLDPRT]
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2024-09-28 change to brake plane
    [FrontHub_NFR25.SLDPRT, Front_Uprights_NFR25.SLDPRT, _Suspension_Skeleton_NFR25.SLDPRT]
2024-09-28 Fixed interference with the main hoop
    [NFR25_Bodywork.SLDASM]
2024-09-28 Fixed top limit in front wing
2024-09-29 Updated upright and FEA
    [RearUpright NFR25.SLDPRT]
2024-09-29 Revert "Updated upright and FEA"
    This reverts commit b56a2b642c97e5ad2fa2661a4fa15fcc36794f38.
    [RearUpright NFR25.SLDPRT]
2024-09-29 Accidentally caused some issues oopsies and hopefully fixed
    [97524A154_Sealing Blind Rivets.SLDPRT, ARB_Assembly_Front_NFR25.SLDASM, ARB_Assembly_Rear_NFR25.SLDASM, ColdPlate2.SLDPRT, D4672-TA - Tripod Bearings.SLDPRT, D4672-TA.SLDPRT, D4824 - Tripod Housing Medium.SLDPRT, D5159 - Axle 17in.SLDPRT]
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2024-09-29 updated wishbone end mockup
    [rough-block.SLDPRT]
2024-09-29 Updated rear upright
    Attempted to redo changes that were made during presenting but were lost due to SW freezing.
    [RearUpright NFR25.SLDPRT]
2024-09-30 Added half shafts, tripods, etc
    [bottomSegmentBusbarSCS.STEP]
2024-09-30 Flipped contactors in penthouse assembly
    Contactors were upside down.
    [Penthouse_internals.SLDASM]
2024-09-30 Moved top cockpit tubes up to be in compliance with F.6.2.3.b
    [_Chassis_Skeleton_NFR25.SLDPRT]
2024-09-30 Steering tubes moved inward to avoid other copes
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2024-09-30 Changes during hubs DR
    [RearHubs_NFR25.SLDPRT]
2024-09-30 Split the radiator to 3 bodies
    [NFR25_Radiator_v2.STEP]
2024-10-01 change to bearing location in the front
    [FrontHub_NFR25.SLDPRT, _Suspension_Skeleton_NFR25.SLDPRT]
2024-10-01 changed cold plate transparency
    [ColdPlate2.SLDPRT]
2024-10-01 saved something i think
    [ColdPlate2.SLDPRT, SegmentBoltTubes.SLDPRT]
2024-10-01 DR Changes to Rear Hubs
    [RearHubs_NFR25.SLDPRT]
2024-10-01 cold plate fea and files rearranged
    [2043130010_FemaleMolex.SLDPRT, 3PBusbar.SLDPRT, 3PBusbarSCS.STEP, 50635K649_1-8_CopperTubingShortNut.SLDPRT, 50675K46_1-8_CopperTubingNut.SLDPRT, 51055K92_PushOn_1-4_3-16_Coupler.SLDPRT, 5779K372_PushOn_1-4_3-16_Barb.SLDPRT, 90thouspacer.SLDPRT]
2024-10-02 Change for Rubber Gasket
    [RearHubs_NFR25.SLDPRT]
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2024-10-02 Cutout for penthouse and other tweaks
    [MSDXLF000R Base Mockup.SLDPRT, MSDXLF000R Mockup.SLDPRT, Penthouse_box_backface.SLDPRT, Plastic Base Plate.SLDPRT, penthouse_container.SLDASM]
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2024-10-02 added holes and adjusted mates in pedalbox
    [4143N17_Rotary Shaft_machined.SLDPRT, BrakePedalAttachmentLeft.SLDPRT, BrakePedalBody.SLDPRT, ThrottlePedalAttachmentLeft.SLDPRT, ThrottlePedalAttachmentRight.SLDPRT, ThrottlePedalBody.SLDPRT]
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2024-10-02 new maintenance plug cad
    [5543A23_1-4_socket.SLDPRT, AccumColdPlate.SLDPRT, SLPRBBPSO_Receptacle.SLDPRT]
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2024-10-03 Added new bearings for Front hubs
    [skf_bearing_32008_x_2.SLDASM, skf_bearing_32008_x_2_01.SLDPRT, skf_bearing_32008_x_2_02.SLDPRT, skf_bearing_32008_x_2_03.SLDPRT]
2024-10-03 Updated front hubs assem
    [Front_hubs_assembly.SLDASM, skf_bearing_32008_x_2.SLDASM, skf_bearing_32008_x_2_01.SLDPRT, skf_bearing_32008_x_2_02.SLDPRT, skf_bearing_32008_x_2_03.SLDPRT]
2024-10-03 Updated Front hubs/FH assembly
    [FrontHub_NFR25.SLDPRT, Front_hubs_assembly.SLDASM]
2024-10-03 radiator copied in and full assembly transparency adjusted
    [Accumulator_Container 5 SEG.SLDASM, Accumulator_Container_OnePiece.SLDPRT, penthouse_container.SLDASM, rad_fins.STEP]
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2024-10-03 Made additional tubes in front in case front triangulation is deemed lacking by SES, added sketch for inverter tube to chassis skeleton
    [_Chassis_Skeleton_NFR25.SLDPRT]
2024-10-03 Updated side panel molds
    [NFR25_Bodywork.SLDASM, NFR25_Left_Back_Side_Panel_Mold.SLDPRT, NFR25_Right_Back_Side_Panel_Mold.SLDPRT]
2024-10-03 cold plate configurations renamed, maintenance plug busbars created
    [AccumColdPlate.SLDPRT, Accumulator_Container 5 SEG.SLDASM, Accumulator_Container_OnePiece.SLDPRT, PortTopBusbar.SLDPRT, SLPRBBPSO_Receptacle.SLDPRT, SLPRBBPSO_Receptacle_Modded.SLDPRT, bottomRightBusbar.SLDPRT]
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2024-10-04 2 element 2d sim files
    [2-element-2d-windtunnel.STEP, 2d-windtunnel.SLDPRT]
2024-10-04 Beefing up for inside cornering
    [RearUpright NFR25.SLDPRT]
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2024-10-05 top cover laser cut dxf created
    [TopCover.SLDPRT, TopCoverLaserFile.DXF]
2024-10-05 disconnect added to penthouse
    [Penthouse_box_backface.SLDPRT, Penthouse_box_frontface.SLDPRT, Penthouse_leftwall.SLDPRT, Penthouse_rightwall.SLDPRT, Plastic Base Plate.SLDPRT, penthouse_container.SLDASM]
2024-10-05 DR front hubs update
    [FrontHub_NFR25.SLDPRT]
2024-10-06 Bearing Fix
    [Front_Uprights_NFR25.SLDPRT]
2024-10-06 Made pedalbox drawings for general
    [Brake Side.SLDDRW, Throttle Back.SLDDRW, Throttle Front.SLDDRW, Throttle Right.SLDDRW]
2024-10-06 DRS design and CFD prep
    [2-element-2d-windtunnel.STEP, 2d-windtunnel.SLDPRT, NFR25_RearWing_2element.SLDPRT, NFR25_RearWing_2element.STEP, NFR25_RearWing_2element_NOCHANGES.SLDPRT, NFR25_RearWing_2element_windtunnel.SLDPRT, NFR25_RearWing_2element_windtunnel.STEP, NFR25_RearWing_Design1_2D_Try2_Raw.SLDPRT]
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2024-10-06 front sus pot hole added
    [Front Rockers.SLDPRT]
2024-10-06 nosecone mdf panel calc
    [Assem1.SLDASM]
2024-10-06 updated rockers and billet
    [Front Rockers.SLDPRT, Front Rockers_FEA.STEP, Rear Rockers V3.SLDPRT, Rear Rockers V3.STEP, Rockers billet assembly.SLDASM, Rockers billet assembly.STEP]
2024-10-06 Penthouse lid and rivet holes
    [Accumulator_Container 5 SEG.SLDASM, Accumulator_Container_Lid_v2.SLDPRT, Penthouse_box_backface.SLDPRT, Penthouse_box_frontface.SLDPRT, Penthouse_leftwall.SLDPRT, Penthouse_lid.SLDPRT, Penthouse_rightwall.SLDPRT, Plastic Base Plate.SLDPRT]
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2024-10-06 Updated the rear wing top tabs
    [Left_Rear_Wing_Top_Tab.STEP, Right_Rear_Wing_Top_Tab.STEP, frame_w_rearwing_tabs.SLDPRT]
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2024-10-06 Moved inverter mounting tube forward
    [_Chassis_Skeleton_NFR25.SLDPRT]
2024-10-07 fixed weird cope on right just-in-case tube
2024-10-07 Added bend to cold plate tubing
    [AccumColdPlate.SLDPRT, TopCover.SLDPRT]
2024-10-07 Changed maintenance plug color
    [SLPRBBPSO_Receptacle.SLDPRT]
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2024-10-07 Updated Drawing with some sizes
    [Frame_NFR25.SLDDRW]
2024-10-07 fea correction
    [RearUpright NFR25.SLDPRT]
2024-10-07 Fixed Inverter Mounting Tube Cope
2024-10-08 Updated sizing descriptions in cut list
    [Frame_NFR25.SLDDRW]
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2024-10-09 Fixed sus tab extrusion relations
    [Frame_NFR25.SLDDRW]
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2024-10-09 penthouse changes? i thought i saved before
    [Penthouse_box_backface.SLDPRT, Penthouse_box_frontface.SLDPRT, Penthouse_leftwall.SLDPRT, Penthouse_lid.SLDPRT, Penthouse_rightwall.SLDPRT, penthouse_container.SLDASM]
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2024-10-09 saved again just in case
    [Frame_NFR25.SLDDRW]
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2024-10-09 final changes before last sus tab
    [Frame_NFR25.SLDDRW]
2024-10-09 slots added in accum container
    [Accumulator_Container 5 SEG.SLDASM, Accumulator_Container_Lid_v2.STEP, Accumulator_Container_OnePiece.SLDPRT, Penthouse_box_backface.SLDPRT, Penthouse_box_frontface.SLDPRT, Penthouse_leftwall.SLDPRT, Penthouse_lid.SLDPRT, Penthouse_rightwall.SLDPRT]
2024-10-09 accum lengthened, assemblies reconstrained
    [Accumulator_Container 5 SEG.SLDASM, Accumulator_Container_OnePiece.SLDPRT, Penthouse_box_frontface.SLDPRT, Penthouse_leftwall.SLDPRT, Penthouse_lid.SLDPRT, Penthouse_rightwall.SLDPRT, penthouse_container.SLDASM]
2024-10-09 made drawings for pedals
    [Brake Pedal.SLDDRW, Throttle Pedal.SLDDRW]
2024-10-09 added pdf of drawings
    [Throttle Right.SLDDRW]
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2024-10-10 sheet metal thicknesses + bend radii
    [Accumulator_Container 5 SEG.SLDASM, Accumulator_Container_Lid_v2.SLDPRT, Accumulator_Container_OnePiece.SLDPRT, Penthouse_box_frontface.SLDPRT, Penthouse_leftwall.SLDPRT, Penthouse_lid.SLDPRT, Penthouse_rightwall.SLDPRT, penthouse_container.SLDASM]
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2024-10-11 finalized drawings with missings tabs
    [Frame_NFR25.SLDDRW]
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2024-10-14 Added PLAs for busbars on segments
    Added PLA sections to cover busbars.
    [PLA Part2.SLDPRT, PLA_pt1.SLDPRT]
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2024-10-14 Increased clearances around and over slots surrounding standoffs in segments
    [Busbar_BondingJig_Bottom.SLDPRT, Busbar_BondingJig_Top.SLDPRT]
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2024-10-15 material changed for hardware
    [91251A439_1-4x28_5-8_CapScrew.SLDPRT]
2024-10-15 3p busbar appearance change for manufacturing
    [3PBusbar.SLDPRT]
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2024-10-15 Deleted duplicate uprights part
    [Front_Uprights_NFR25.SLDPRT]
2024-10-16 busbar colors changed again for assembly
    [3PBusbar.SLDPRT]
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2024-10-16 some container files rearranged
    [Accumulator_Container 5 SEG.SLDASM, Accumulator_Container_OnePiece.SLDPRT, Penthouse_box_frontface.SLDPRT, Penthouse_leftwall.SLDPRT, Penthouse_lid.SLDPRT, Penthouse_rightwall.SLDPRT, penthouse_container.SLDASM, penthouse_layout.SLDPRT]
2024-10-17 Create Container in frame.SLDASM
    [Container in frame.SLDASM]
2024-10-17 creating rear wing tabs
    [_Chassis_Skeleton_NFR25.SLDPRT]
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2024-10-17 Improved modeling of accum container
    [AccumColdPlate.SLDPRT, Accumulator_Container 5 SEG.SLDASM, Accumulator_Container_Lid_v2.SLDPRT, Accumulator_Container_OnePiece.SLDPRT, Penthouse_box_backface.SLDPRT, Penthouse_box_frontface.SLDPRT, Penthouse_leftwall.SLDPRT, Penthouse_rightwall.SLDPRT]
2024-10-17 Penthouse work
    Added HV board and BMS mainboard STEP files to assembly. Moved mounting plate into penthouse assembly so it could be visible when doing layout. Much work left to be done.
    [iso175_IMD.SLDPRT, mounting_plate.SLDPRT]
2024-10-17 busbar bond jig edited
    [Busbar_BondingJig_Bottom.SLDPRT, Busbar_BondingJig_BottomPrint.STL]
2024-10-18 Fixed Top Jog Tolerances
    [Busbar_BondingJig_Bottom.SLDPRT, Busbar_BondingJig_Top.SLDPRT]
2024-10-20 added jig for top busbars
    [TopJig.SLDPRT, TopJigPrint.STL]
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2024-10-20 added msd and adjusted penthouse
    [Penthouse_box_backface.SLDPRT, Penthouse_leftwall.SLDPRT, Penthouse_lid.SLDPRT, Penthouse_rightwall.SLDPRT, mounting_plate.SLDPRT]
2024-10-20 renaming files and cleaning up
    [NFR25_RearWing_2element_windtunnel.SLDPRT, NFR25_RearWing_2element_windtunnel.STEP, NFR25_RearWing_NOCHANGES.SLDPRT, NFR25_RearWing_drs.SLDPRT, NFR25_RearWing_high_aoa.SLDPRT]
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2024-10-20 high aoa rear wing
    [NFR25_RearWing_high_aoa.SLDPRT]
2024-10-20 Increased lower column height by 0.5 inches.
    [Steering Lower Column.SLDPRT, _Steering_Assembly_NFR25.SLDASM, _Suspension_Skeleton_NFR25.SLDPRT]
2024-10-20 Changes to Hub and Drawing
    [RearHubs_NFR25.SLDDRW, RearHubs_NFR25.SLDPRT]
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2024-10-21 master positive and negative file names switched
    [MasterNegative.SLDPRT, MasterPositive.SLDPRT, PortTopBusbar.SLDPRT]
2024-10-21 Created carbon fiber tube assembly
    [Carbon tube assembly.SLDASM, Carbon tube.SLDPRT, Insert.SLDPRT]
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2024-10-21 updated missing tube information
    [Frame_NFR25.SLDDRW]
2024-10-21 changed some of the measurements of tabs
    [Frame_NFR25.SLDDRW, _Chassis_Skeleton_NFR25.SLDPRT]
2024-10-21 filled out cutlist custom
    [Frame_NFR25.SLDDRW]
2024-10-21 finished balloon minus hidden
    [Frame_NFR25.SLDDRW]
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2024-10-21 now it's really done
    [Frame_NFR25.SLDDRW]
2024-10-21 now it's really really done
    [Frame_NFR25.SLDDRW]
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2024-10-22 made sus tab jigging assembly
    [sus tab jigging assembly.SLDASM]
2024-10-22 Create Side mount v1.SLDPRT
    [Side mount v1.SLDPRT]
2024-10-22 updated carbon fiber tube assembly
    added inserts to both sides of the carbon fiber tube and added a rod end
    [AB-4-AuroraBearingC0.-1.SLDPRT, Carbon tube assembly.SLDASM, Insert.SLDPRT]
2024-10-22 Side Mount Initial Iteration
    [Side Mount Assy.SLDASM, Side chassis mount v1.SLDPRT, Side mount v1.SLDPRT]
2024-10-22 Update Side Mount Assy.SLDASM
    [Side Mount Assy.SLDASM]
2024-10-23 Added steering configurations to front corner assembly
    [Front_Lower_Arm_Assembly_NFR25.SLDASM, Front_Pull_Rod_Assembly_NFR25.SLDASM, Front_Tie_Rod_Assembly_NFR25.SLDASM, Front_Upper_Arm_Assembly_NFR25.SLDASM, Ohlins TTX25 MkII FSAE Shock Assembly.SLDASM]
2024-10-23 started drawing front hubs
    [FrontHub_NFR25.SLDPRT, FrontHub_NFR25_drawing.SLDDRW]
2024-10-23 New iteration + Updated full assy
    [Side Mount Assy.SLDASM, Side chassis mount v1.SLDPRT, Side mount v1.SLDPRT]
2024-10-24 messing around with rear wing tabs
    [NFR25_RearWing_tab.SLDPRT]
2024-10-24 Made test file and deleted placeholder
    [testfile.SLDPRT]
2024-10-24 Created eccentric plate test file
    [eccentric plate test.SLDPRT]
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2024-10-24 Created MDM test file
    [MDMTest.SLDPRT]
2024-10-24 Added MDMTest file to test assembly file
    [test assembly.SLDASM]
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2024-10-24 created segment assembly cover
    [segAssemblyCover.SLDPRT]
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2024-10-24 fixed balloon drawing
    [Frame_NFR25.SLDDRW, Frame_NFR25_Drawing.SLDDRW]
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2024-10-24 Create tabs.SLDPRT
    new tab added to side aero folder
    [tabs.SLDPRT]
2024-10-24 Segment Changes
    - intersegment hardware added
    - top left busbar created
    - left and right busbars edited for better maintenance plug clearance
    - cold plate recession removed
    - cold plate spacers deleted
    [90633A411_10x32_LowProfileNylonLocknut.SLDPRT, 92220A173_10x32_1-2_LowProfileCapScrew.SLDPRT, AccumColdPlate.SLDPRT, bottomRightBusbar.SLDPRT, topBusbar.SLDPRT, topLeftBusbar.SLDPRT]
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2024-10-24 Accumulator Changes
    - intersegment maintenance plug covers created
    [Accumulator_Container 5 SEG.SLDASM, Accumulator_Container_OnePiece.SLDPRT, FemaleMPBusbar.SLDPRT, Female_Maintenance_Plug_Assembly.SLDASM, Female_Maintenance_Plug_Cover.SLDPRT]
2024-10-24 small accumulator changes
    appearances changes and busbar dimensions altered
    [3PBusbar.SLDPRT, Accumulator_Container 5 SEG.SLDASM, NFR25_SensePCB.SLDPRT, bottomRightBusbar.SLDPRT, topLeftBusbar.SLDPRT]
2024-10-25 Added undertray into github
    [Flat_Plank_undertray_step file.STEP]
2024-10-25 So many file changes
    lots of shit renamed --> accumulator assembly tree restructured
    [50635K649_1-8_CopperTubingShortNut.SLDPRT, 50675K46_1-8_CopperTubingNut.SLDPRT, 91251A439_1-4x28_5-8_CapScrew.SLDPRT, 91864A047_1-4x28_1-2_CapScrew.SLDPRT, AccumColdPlate.SLDPRT, AccumColdPlateMarcello.STEP, Accumulator_Container 5 SEG.SLDASM, BarbBlockModel.SLDPRT]
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2024-10-25 cold plate assembly unsupressed
    [Cold_Plate_Assembly.SLDASM]
2024-10-25 Final adjustments to frame for cartesian
    will revert trim on front coilover tabs if need be
2024-10-25 changed penthouse mates, cutouts in flanges on lid and front
    [Accumulator_Container_Lid_v2.SLDPRT, Container.SLDASM, Penthouse_Container.SLDASM, Penthouse_Front_Wall.SLDPRT, Penthouse_Lid.SLDPRT, Penthouse_Rear_Wall.SLDPRT]
2024-10-25 segments laterally constrained in container slots
    [Penthouse_Container.SLDASM]
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2024-10-25 bottom cell holders measured for SES
    [BottomCellHolder.SLDPRT]
2024-10-26 added baseplate to sus tab jigging
    [Total Baseplate.SLDASM, sus tab jigging assembly.SLDASM]
2024-10-26 Sizing Fix
    [Front_Uprights_NFR25.SLDPRT, front Upright clevis NFR25.SLDPRT]
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2024-10-26 Steering Fix
    [Front_Uprights_NFR25.SLDPRT]
2024-10-26 finalized frame placement on baseplate
    [sus tab jigging assembly.SLDASM]
2024-10-26 made cylinder for sus tab jigging assembly
    [cylinder.SLDPRT, tab.SLDPRT]
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2024-10-26 made brick for sus tab jig assembly
    [brick.SLDPRT, cylinder.SLDPRT]
2024-10-26 made tab for sus tab jigging assembly
    [tab.SLDPRT]
2024-10-26 Put in reference for MDassembly into drivetrain folder
    [Diff Sprocket Mockup (NOT EXACT).SLDPRT, Diff_Sprocket_Adapter_NFR23_V20.SLDPRT, Jack_Bar.SLDPRT, MDMonutSquareTab.SLDPRT, MDMonutSquareTabBottom.SLDPRT, MDMonutSquareTabTop.SLDPRT, MDMountLeft.SLDPRT.SLDPRT, MDMountRight.SLDPRT.SLDPRT]
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2024-10-26 Added second rod end
    [Carbon tube assembly.SLDASM]
2024-10-26 Edited with frame assembly
    [Side Mount Assy.SLDASM, Side mount v1.SLDPRT]
2024-10-26 Added the new baseplate, adaptor, brick, cylinder
    [brick.SLDPRT, tab.SLDPRT]
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2024-10-26 Created MSA spacer (based on nfr24)
    [Spacer.SLDPRT]
2024-10-26 Fixed distance from the center of the 0.25in DIA circle to the center of the plate
    [MDMTest.SLDPRT]
2024-10-26 Pushed rod ends in
    [Carbon tube assembly.SLDASM]
2024-10-26 Rear wing mounting assem
    [MDMTest.SLDPRT, NFR25_RearWing_Mounting.SLDASM, RearHubs_NFR25.SLDDRW, RearHubs_NFR25.SLDPRT, Spacer.SLDPRT]
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2024-10-26 Created Steering Column to U Joint Adapter
    [Steering Column to U Joint Adapter.SLDPRT]
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2024-10-26 Some penthouse changes
    I had the wrong HV board 3D model in there; replaced it with AMC chip one. Placed energy meter back into penthouse assembly.
2024-10-26 Remove fixture space from brick
    [1010-S-92-CL.sldprt, 91290A148_Alloy Steel Socket Head Screw (1).SLDPRT, Slab.SLDPRT, SquareRods.SLDPRT, _Block_Model_NFR24.SLDPRT, _Chassis_Skeleton_NFR24.SLDPRT, _Powertrain_Skeleton_NFR24.SLDPRT, _Suspension_Skeleton_NFR24.SLDPRT]
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2024-10-26 rear wing mounting cf tubes
    [Carbon tube assembly.SLDASM, Carbon tube.SLDPRT, NFR25_RearWing_Mounting.SLDASM]
2024-10-26 Made test part for differential sprocket adapter
    [Test_DSA.SLDPRT]
2024-10-26 added tripod bearing to hubs folder
    [D4672-TA - Tripod Bearings.SLDPRT]
2024-10-26 Updated front hubs and finished drawing
    [FrontHub_NFR25.SLDPRT, FrontHub_NFR25_drawing.SLDDRW]
2024-10-26 updated billet, not final
    [Rockers billet assembly.SLDASM]
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2024-10-27 Updated rear wing assembly
    [Active_Aero_Linkages.SLDPRT, NFR25_RearWing_Inserts.SLDPRT, NFR25_RearWing_Mounting.SLDASM, NFR25_RearWing_high_aoa.SLDPRT, Rear_Wing_NFR25.SLDASM, Swan_Neck.SLDPRT]
2024-10-27 Added inverter CAD files and created assembly
    [Inverter_Power_Stage_NFR25.step]
2024-10-28 saved 3 bodies(test worked good)
    [001(2).SLDPRT, 002(2).SLDPRT, 003.SLDPRT]
2024-10-28 Upright drawings and stock
    [Rear Upright in Stock.SLDASM, RearUpright NFR25.SLDPRT, Upright Stock Drawing.SLDDRW, Upright Stock.SLDPRT]
2024-10-28 Revert "Merge branch 'main' of https://github.com/bsobeloffgittes/NFR25-CAD"
    This reverts commit 16d450fdb7cf970aa42bf0b79d4ddc06a7e0af64, reversing
    changes made to 3b96bce3a06848d79d0ef109fca7e540d19f7633.
    [001(2).SLDPRT, 002(2).SLDPRT, 003.SLDPRT, 1010-S-92-CL.sldprt, 91290A148_Alloy Steel Socket Head Screw (1).SLDPRT, AB-4-AuroraBearingC0.-1.SLDPRT, Active_Aero_Linkages.SLDPRT, Adapter.SLDPRT]
2024-10-28 exported shit ton of tubes
    [004.SLDPRT, 005.SLDPRT, 006.SLDPRT, 007.SLDPRT, 008.SLDPRT, 009.SLDPRT, 010.SLDPRT, 011.SLDPRT]
2024-10-28 dont forget to fetch before committing:)
    [001.SLDPRT, 002.SLDPRT, 003.SLDPRT]
2024-10-28 last missing ones
    [038.SLDPRT, 045.SLDPRT, 055.SLDPRT, 081.SLDPRT]
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2024-10-28 Reverting the revert of the merge
    [001(2).SLDPRT, 002(2).SLDPRT, 1010-S-92-CL.sldprt, 91290A148_Alloy Steel Socket Head Screw (1).SLDPRT, AB-4-AuroraBearingC0.-1.SLDPRT, Active_Aero_Linkages.SLDPRT, Adapter.SLDPRT, Assem1.SLDASM]
2024-10-28 Added the bottom tabs
    [6527K161_Low-Carbon Steel Rectangular Tube.SLDPRT, Bottom Tabs.SLDPRT, Carbon tube assembly.SLDASM, Carbon tube.SLDPRT, Insert.SLDPRT, Low-Carbon Steel Rectangular Tube Tab Stock.SLDPRT, NFR25_RearWing_Mounting.SLDASM]
2024-10-28 Created the aluminum tabs
    [Aluminum Tabs.SLDPRT, Bottom Tabs.SLDPRT, Carbon tube assembly.SLDASM, NFR25_RearWing_Mounting.SLDASM]
2024-10-28 Created V2
    Adjusted to Z requirement
    [Side Mount Assy V2.SLDASM, Side Mount Assy.SLDASM, Side chassis mount v2.SLDPRT, Side mount v2.SLDPRT]
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2024-10-28 Updated the Aero Assembly
    [NFR25_Bodywork.SLDASM, Rear_Wing_NFR25.SLDASM, Undertray Assembly NFR25.SLDASM]
2024-10-28 Updated the side panel molds
    [Left_Side_Panel_Mold_v2.SLDPRT, NFR25_Left_Back_Side_Panel_Mold.SLDPRT, NFR25_Right_Back_Side_Panel_Mold.SLDPRT]
2024-10-28 Adjusted penthouse to increase firewall clearance, moved accumulator in assembly
    [Penthouse_Container.SLDASM, Penthouse_Front_Wall.SLDPRT, Penthouse_Left_Wall.SLDPRT, Penthouse_Lid.SLDPRT, Penthouse_Rear_Wall.SLDPRT, Penthouse_Rightwall.SLDPRT, Ruland_us12-6-f.SLDASM]
2024-10-28 replaced baseplate on sus jigging assembly
    [1010-S-92-CL.sldprt, 91290A148_Alloy Steel Socket Head Screw (1).SLDPRT, Slab.SLDPRT, SquareRods.SLDPRT, Total Baseplate.SLDASM, _Block_Model_NFR24.SLDPRT, _Chassis_Skeleton_NFR24.SLDPRT, _Powertrain_Skeleton_NFR24.SLDPRT]
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2024-10-28 change to rear drawing
    [RearHubs_NFR25.SLDDRW]
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2024-10-29 Active aero linkages sketch
    [Active_Aero_Linkages_2.SLDPRT]
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2024-10-29 inner wall thickness changes
    [Container.SLDASM, wall with flanges.SLDPRT]
2024-10-29 test FEA on container
    [TestAssemblyFEA.SLDASM, TestPieceFEA.SLDPRT]
2024-10-29 Made Pillow block for steering rack
    [KAZ_Steering_Rack_-_Dumb_Solid.SLDPRT, Ruland_HD-2A HD SERIES BLOCK_750-2A.SLDPRT, Ruland_HD-3A HD SERIES SMALL PIN_750-3A.SLDPRT, Ruland_HD-5A HD SERIES LARGE PIN_750-5A.SLDPRT, Ruland_Y750 YOKES_Y6X6-LH.SLDPRT, Ruland_Y750 YOKES_Y6X6-SH.SLDPRT, Steering Upper Column.SLDPRT, _Steering_Assembly_NFR25.SLDASM]
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2024-10-30 V2 Passes SES, Start FEA
    [Side Mount Assy V2.SLDASM, Side chassis mount v2.SLDPRT, Side mount v2.SLDPRT]
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2024-10-31 small changes in accum
    [Accumulator_Container_OnePiece.SLDPRT, Container.SLDASM, Penthouse_Container.SLDASM, Penthouse_Lid.SLDPRT, SLPRBBPSO_Receptacle.SLDPRT, wall with flanges.SLDPRT]
2024-10-31 Top tabs for rear wing mounting
    [NFR25_RearWing_Mounting.SLDASM, Top Tabs.SLDPRT]
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2024-10-31 Created MDM file and broke the skeleton reference in the frame part file
    [MDMount_NFR25.SLDPRT, _Chassis_Skeleton_NFR25.SLDPRT]
2024-10-31 Segments respaced in assembly
    [Cold_Plate_Assembly.SLDASM, Container.SLDASM, FemaleMPBusbar.SLDPRT, Female_Maintenance_Plug_Assembly.SLDASM, Female_Maintenance_Plug_Cover.SLDPRT]
2024-11-01 Small changes. Materials changed
    [Cold_Plate_Assembly.SLDASM, Container.SLDASM, Female_Maintenance_Plug_Assembly.SLDASM, Female_Maintenance_Plug_Cover.SLDPRT, Penthouse_Container.SLDASM, wall with flanges.SLDPRT]
2024-11-01 added some stuff to frame jigging
    [Jigging Assembly.SLDASM, Total Baseplate.SLDASM]
2024-11-01 this method feels better:)
    [Horizontal 1.SLDPRT, Horizontal 2.SLDPRT, Jigging Assembly.SLDASM, Long 1.SLDPRT, Long 2.SLDPRT, Tube Holder.SLDPRT, d.DXF]
2024-11-01 updated rear wing mounting
    [Active_Aero_Linkages.SLDPRT, NFR25_RearWing_Inserts.SLDPRT, NFR25_RearWing_Mounting.SLDASM, Rear_Wing_NFR25.SLDASM, Swan_Neck.SLDPRT]
2024-11-01 added new front hub bearing
    [skf_32008_x.SLDPRT, skf_32009_x.SLDPRT]
2024-11-01 Updated front hubs to have correct bearing interface
    [FrontHub_NFR25.SLDPRT]
2024-11-01 Changed front hub bearing face diameter
    [FrontHub_NFR25.SLDPRT]
2024-11-01 Modeled DC link capacitor
    [944U221K801ACM_DC_Link_Capacitor.SLDPRT]
2024-11-01 updated the rear wing mounting assembly
    [3099T13_Pulley for Wire Rope-for Lifting.SLDPRT, Cable_Pulley_Tabs.SLDPRT, Carbon tube assembly.SLDASM, NFR25_RearWing_Mounting.SLDASM, Pulley.SLDASM, Pulley_Body.SLDPRT, Pulley_Eye.SLDPRT, Swan_Neck.SLDPRT]
2024-11-01 changes to front wheel assembly
    [Front_Uprights_NFR25.SLDPRT]
2024-11-01 Changes to rear hubs+uprights
    [OZ FS Magnesium CL 10in Wheel 7.5in.SLDPRT, RearHubs_NFR25.SLDPRT, RearUpright NFR25.SLDPRT]
2024-11-01 changes post DR
    updated hole and slot placements, new connector cutout in penthouse
    [Accumulator_Container_OnePiece.SLDPRT, Container.SLDASM, wall with flanges.SLDPRT]
2024-11-01 created Anton's lv connector
    [1823444-2-LVCONNECTOR.SLDPRT]
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2024-11-02 Added GLV connector to penthouse
    Also removed the sketch for the two separate one-pole TS connectors, as we have decided to seek out a two-pole for the main connector.
    [Penthouse_Container.SLDASM, Penthouse_Rear_Wall.SLDPRT]
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2024-11-02 test cold plate step file created
    [TestColdPlate.SLDPRT, TestColdPlateStep.STEP]
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2024-11-02 Create NFR22-20 Float PinREAR.SLDPRT
    Created float pin for rear, extended .03" to clear thicker rear rotors.
    [NFR22-20 Float PinREAR.SLDPRT]
2024-11-02 Added new updated rear float pins.
    Added new updated rear float pins, .03" longer than fronts.
    [RearUpright NFR25.SLDPRT]
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2024-11-02 updated front hubs drawing
    [FrontHub_NFR25_drawing.SLDDRW]
2024-11-02 Update Steering Column to U Joint Adapter
    [Steering Column to U Joint Adapter.SLDPRT]
2024-11-02 Create Front Hub Small Inner Wheel Nut.SLDPRT
    Matches up with inner wheel nut thread face, flush with end of hub when pushed against stationary part of bearing. 18 cuts match up with 18 holes on hub. 1.25" drive.
    [Front Hub Small Inner Wheel Nut.SLDPRT]
2024-11-02 Create SensorMountv2.SLDPRT
    Added tire sensor mount
    [SensorMountv2.SLDPRT]
2024-11-02 Added new Front Hub Small Inner Wheel Nut to assembly
    See part in front hubs folder
    [FrontHub_NFR25.SLDPRT]
2024-11-02 Added main battery connector to penthouse
    Modeled main battery connector (ELRA2Z25) and added to penthouse assembly.
    [ELRA2Z25_main_battery_connector.SLDPRT]
2024-11-02 Replaced old front and rear rotor sldprt files with new ones
    [Rotor_Front_NFR24.SLDPRT, Rotor_Front_NFR25.SLDPRT, Rotor_Rear_NFR24.SLDPRT, Rotor_Rear_NFR25.SLDPRT]
2024-11-02 Added new front and rear brake rotors to front and rear wheel assemblies
    GP200 not changed idk why when editing the rear wheel assembly it thought something changed
    [MirrorWilwood_GP200.SLDASM]
2024-11-02 DSA Initial FEA test
    [Test_DSA.SLDPRT]
2024-11-02 Create ThrottlePedalBodyCopy9.5in.SLDPRT
    Added the 9.5 inch pedal to the Throttle Custom Pedal Parts folder
    [ThrottlePedalBodyCopy9.5in.SLDPRT]
2024-11-02 Designed first jig (testing)
    [brick.SLDPRT, first jig TESTING.SLDPRT, sus tab jigging assembly.SLDASM]
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2024-11-02 did fea for adapter
    [Adapter.SLDPRT]
2024-11-02 Changed the diameter of the test MDM and test eccentric plate and created an assembly with 3 aligned holes
    [Test Eccentric Plate (4 in) and Test MDM (5 in) Assembly.SLDASM, Test Eccentric Plate (4 in).SLDPRT, Test MDM (5 in).SLDPRT]
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2024-11-02 cold plate weight reduction
    [Cold_Plate.SLDPRT, Cold_Plate_Assembly.SLDASM]
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2024-11-03 First version of right mdm done + moved bearings from reference folder to this years folder
    [MDMount_NFR25.SLDPRT, _Chassis_Skeleton+Block_Model_NFR25.SLDPRT, _Chassis_Skeleton_NFR25.SLDPRT, skf_bearing_16009_2.stp.SLDPRT, skf_bearing_61910-2rs1_2.stp.SLDPRT, skf_bearing_61911_2.stp.SLDPRT]
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2024-11-04 Merged bodies of the MDM
    [MDMount_NFR25.SLDPRT]
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2024-11-05 made another suspension tab jig
    [Total Baseplate.SLDASM, first jig TESTING.SLDPRT, sus tab jigging assembly.SLDASM]
2024-11-05 Added left configuration to MDM file
    [MDMount_NFR25.SLDPRT]
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2024-11-05 New FW Step file
    [NFR_25_FrontWing_V2 (drew)NO_VORTEX_GENS.STEP]
2024-11-05 fixed front wing position
    [Front_Wing_Assembly.SLDASM, Front_Wing_updated.STEP, NFR_25_FrontWing_V2 (drew).SLDPRT, NFR_25_FrontWing_V2 (drew)NO_VORTEX_GENS.STEP]
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2024-11-05 fixed trailing edge of front wing
    [Front_Wing_Assembly.SLDASM, NFR_25_FrontWing_V2 (drew).SLDPRT, NFR_25_FrontWing_V2 (drew)NO_VORTEX_GENS.STEP]
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2024-11-05 rear hub drawing changes
    [RearHubsFinalDrawing_NFR25.SLDDRW]
2024-11-05 rear hub drawing modifications
    Umm Benji this is a stashed change, hope it's alright
    [FrontHub_NFR25_drawing.SLDDRW, RearHubs_NFR25.SLDPRT]
2024-11-05 updated pedalbox design - with brake side included and other hardware
    [2938T76_High-Load Oil-Embedded Sleeve Bearing.SLDPRT, 4143N17_Rotary Shaft_machined.SLDPRT, 98541A116_External Retaining Ring.SLDPRT, Assem1.SLDASM, BrakePedal.SLDPRT, BrakePedalBody.SLDPRT, Euro-XPD-2832-836-214-911-00.STEP.SLDPRT, Rail.SLDPRT]
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2024-11-06 Update Front Hub Small Inner Wheel Nut.SLDPRT
    18 to 17 holes for optimal pinnability
    [Front Hub Small Inner Wheel Nut.SLDPRT]
2024-11-06 Added e-stop and pre-load stops
    [9271K112_Torsion Spring.SLDPRT, Brake Pedal Face Mockup.SLDPRT, BrakePedal.SLDPRT, BrakePedalBody.SLDPRT, Killswitch GRB49A-05_3D_12-16-13.SLDPRT, ThrottlePedal.SLDPRT, ThrottlePedalBody.SLDPRT, killswitch mount.SLDPRT]
2024-11-06 cold plates and copper bending jig
    cold plates further weight reduced
    jig die drawings created
    [Cold_Plate.SLDPRT, Cold_Plate_Assembly.SLDASM, CopperBendingJig.SLDASM, CopperBendingJigBasePlate.SLDPRT, CopperBendingJigBricks.SLDPRT, CopperBendingJigDies.SLDPRT, CopperBendingJigDies_Drawing.SLDDRW]
2024-11-06 cold plate weight further reduced
    [Cold_Plate.SLDPRT, Cold_Plate_Assembly.SLDASM]
2024-11-06 heel stops, new hardware on pedalbox
    [90631A009_Low-Strength Steel Nylon-Insert Locknut.SLDPRT, 91251A082_Black-Oxide Alloy Steel Socket Head Screw.SLDPRT, 91251A201_Black-Oxide Alloy Steel Socket Head Screw.SLDPRT, 91290A452_Alloy Steel Socket Head Screw.SLDPRT, 91864A026_Black-Oxide Alloy Steel Socket Head Screw.SLDPRT, 91864A027_Black-Oxide Alloy Steel Socket Head Screw.SLDPRT, 94407A102_18-8 Stainless Steel Nylon-Insert Locknut.S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]
2024-11-06 Running new fea +V3 files made
    [Side Mount Assy V2.SLDASM, Side chassis mount v2.SLDPRT, Side chassis mount v3.SLDPRT, Side mount v2.SLDPRT, Side mount v3.SLDPRT]
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2024-11-06 Rockers CNC files + topology optimization study
    [Front Rockers.SLDPRT, Rockers topology optimization.step]
2024-11-06 some stops and stuff
    [Back Stop Throttle.SLDPRT, BrakePedal.SLDPRT, Part1.SLDPRT, ThrottlePedalBody.SLDPRT]
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2024-11-07 Valid V3 (aluminum) model
    [Side Mount Assy V3.SLDASM, Side chassis mount v3.SLDPRT, Side mount v3.SLDPRT]
2024-11-07 updated fw with vortex gens
    [NFR_25_FrontWing_V2 (drew).STEP]
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2024-11-07 Added msa adapter to chassis frame
    [Adapter.SLDPRT]
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2024-11-07 Updated right MDM and eccentric plate
    [MDMount_NFR25.SLDPRT]
2024-11-07 Single shear swan neck mounting & Rear wing insert weight saving
    [NFR25_RearWing_Inserts.SLDPRT, NFR25_RearWing_Mounting.SLDASM, Swan_Neck.SLDPRT]
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2024-11-07 Fixed some issues with the first jigging test
    [Total Baseplate.SLDASM, cylinder.SLDPRT, first jig TESTING.SLDPRT, sus tab jigging assembly.SLDASM]
2024-11-07 Fixing issues on the first testing jig
    [first jig TESTING.SLDPRT, sus tab jigging assembly.SLDASM]
2024-11-07 spacer 3d print file created
    [HesseSpacers.SLDPRT, HesseSpacersPrint.STL]
2024-11-07 fixed FW mates
    [Front_Wing_Assembly.SLDASM, NFR_25_FrontWing_V2 (drew).SLDPRT, NFR_25_FrontWing_V2 (drew)NO_VORTEX_GENS.STEP]
2024-11-07 cold plate tolerances changed
    [Cold_Plate.SLDPRT, Cold_Plate_Youssef.STEP]
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2024-11-08 new triple foil fw design
    [NFR_25_FrontWing_V3(triple_foil).SLDPRT]
2024-11-08 changes to front corner assembly
    [Front Rockers.SLDPRT, Front_Upper_Arm_Assembly_NFR25.SLDASM, front Upright clevis NFR25.SLDPRT]
2024-11-08 updated the front wing cad
    [NFR_25_FrontWing_V2 (drew).SLDPRT, NFR_25_FrontWing_V3(triple_foil).SLDPRT, NFR_25_FrontWing_V3.STEP, NFR_25_FrontWing_V4.STEP]
2024-11-08 getting front wing dr ready
    [NFR_25_FrontWing_V2 (drew).SLDPRT, NFR_25_FrontWing_V3_1_2d_sim.STEP, NFR_25_FrontWing_V3_2_2d_sim.STEP, NFR_25_FrontWing_V3_2d_sim.STEP, NFR_25_FrontWing_V3_3_2d_sim.STEP, NFR_25_FrontWing_V3_4_2d_sim.STEP, NFR_25_FrontWing_V3_5_2d_sim.STEP, NFR_25_FrontWing_V3_6_2d_sim.STEP]
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2024-11-09 Uploaded SES drawing file
    [Frame_NFR25_SES_Drawings.SLDDRW]
2024-11-09 final fw w vortex gens
    [NFR_25_FrontWing_V3_6_3d_sim.SLDPRT, NFR_25_FrontWing_VFINAL.STEP]
2024-11-09 updated fw with vortex gen(again)
    [NFR_25_FrontWing_V2 (drew).SLDPRT]
2024-11-09 Thickened mounts to nice IPS numbers and organized feature tree
    [MDMount_NFR25.SLDPRT]
2024-11-09 forgot to name a thing nicely so i did that
    [MDMount_NFR25.SLDPRT]
2024-11-09 New jigs and stuff
    [Total Baseplate.SLDASM, sus tab jigging assembly.SLDASM]
2024-11-09 did initial fea on spacer
    [Spacer.SLDPRT]
2024-11-09 Changed orientation of bolt holes for motor on right MDM and added MDM + bearings into drivetrain assembly
    [MDMount_NFR25.SLDPRT]
2024-11-10 New mounts in assembly- issues
    [Cold_Plate_Assembly.SLDASM, Container.SLDASM, Side Mount Assy V3.SLDASM, Side chassis mount v3.SLDPRT, wall with flanges.SLDPRT]
2024-11-10 added spacers and sensor
    [8mm shaft cutdown.SLDPRT, 91251A194_Black-Oxide Alloy Steel Socket Head Screw.SLDPRT, 91251A197_Black-Oxide Alloy Steel Socket Head Screw.SLDPRT, 91864A033_Black-Oxide Alloy Steel Socket Head Screw.SLDPRT, BackBrakeSpacer.SLDPRT, PedalSpacer.SLDPRT, ThrottlePedal.SLDPRT, ThrottlePedalBody.SLDPRT]
2024-11-11 sus tab changes saved
    [041.SLDPRT, 042.SLDPRT, 044.SLDPRT, 052.SLDPRT, 055 Redone.SLDPRT, 055.SLDPRT, 063.SLDPRT, 064.SLDPRT]
2024-11-11 new top cover
    - expanded holes because of poor fitments
    [TopCover.SLDPRT, TopCoverLaserFileLooseFit.DXF]
2024-11-12 renamed some stuff and imported msa sprocket
    [MSA Adapter.SLDPRT, MSA Spacer.SLDPRT, MSA Sprocket.SLDPRT]
2024-11-12 removed heels and fixed sensor angle
    [BrakePedal.SLDPRT, Rail.SLDPRT, ThrottlePedal.SLDPRT]
2024-11-12 added dsa to drivetrain
    [Adapter.SLDPRT, skf_bearing_16009_2.stp.SLDPRT, skf_bearing_61910-2rs1_2.stp.SLDPRT, skf_bearing_61911_2.stp.SLDPRT]
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2024-11-12 Created area to fit water cooling tubes through MDM
    [MDMount_NFR25.SLDPRT]
2024-11-12 suppressed slots on rails, deleted press fit dowel
    suppressed slots on rails, deleted press fit dowel
    [BrakePedal.SLDPRT, Rail.SLDPRT, ThrottlePedal.SLDPRT]
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2024-11-12 Baseplate Changes
    Thinned out throttle baseplate, extruded bolt holes and remated bolts
    [ThrottlePedal.SLDPRT]
2024-11-12 added msa sprocket to assembly
    [Adapter.SLDPRT, MSA Adapter.SLDPRT]
2024-11-12 Clearance fix
    [Front_Uprights_NFR25.SLDPRT]
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2024-11-13 added ublocks and changed jigs
    [Jigging Assembly.SLDASM, Standardized_UBlock.SLDPRT, UBlock_Square.SLDPRT]
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2024-11-14 3d print files
    - sensePCB jig
    - dp460 plunger
    [dp460plunger.SLDPRT, dp460plungerPrint.STL, sensepcbJig.SLDPRT, sensepcbJigPrint.STL]
2024-11-14 tube not model editted
    [Container.SLDASM, TubenutBlockModel.SLDPRT, wall with flanges.SLDPRT]
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2024-11-14 added inserts to rw second foil
    [NFR25_RearWing_Inserts.SLDPRT, NFR25_RearWing_Mounting.SLDASM]
2024-11-14 Rear mounts + Added to full car assembly
    Also changed width and SA of side mounts
    [ARB_Assembly_Front_NFR25.SLDASM, ARB_Assembly_Rear_NFR25.SLDASM, Container.SLDASM, Front_Uprights_NFR25.SLDPRT, Front_Wing_Assembly.SLDASM, NFR25_Aero.SLDASM, Rear Mount Assy V1.SLDASM, Rear Rockers V3.SLDPRT]
2024-11-14 Small changes to mounts
    [Container.SLDASM, Rear Mount Assy V1.SLDASM, Rear chassis mount v1.SLDPRT, Rear mount v1.SLDPRT, wall with flanges.SLDPRT]
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2024-11-15 updated the wing molds
    [FW1.STL, FW1_v1.SLDDRW, FW1_v1.SLDPRT, FW1_v1.STEP, FW2.STL, FW2_v1.SLDDRW, FW2_v1.STEP, FW3.STL]
2024-11-15 Thickness changed + Fits SES locationally
    [Container.SLDASM, NFR25_Aero.SLDASM, NFR25_RearWing_Mounting.SLDASM, Rear Mount Assy V1.SLDASM, Rear chassis mount v1.SLDPRT, Rear chassis mount v2.SLDPRT, Rear mount v2.SLDPRT, Rear_Wing_NFR25.SLDASM]
2024-11-16 incomplete cold plate changes
    [ColdPlateFittingAssembly.SLDASM, Cold_Plate.SLDPRT, Cold_Plate_Assembly.SLDASM, RightAngleBlockModel.SLDPRT, TubeNutCollar.SLDPRT, TubenutBlockModel.SLDPRT]
2024-11-16 saved - no real changes
    [ColdPlateFittingAssembly.SLDASM, Cold_Plate.SLDPRT, Cold_Plate_Assembly.SLDASM, Container.SLDASM, wall with flanges.SLDPRT]
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2024-11-16 rear mounts fix
    [Rear Mount Assy V2.SLDASM, Rear chassis mount v2.SLDPRT, Rear mount v2.SLDPRT]
2024-11-16 busbars changed and cold plates edited
    [ColdPlateFittingAssembly.SLDASM, Cold_Plate.SLDPRT, Cold_Plate_Assembly.SLDASM, Container.SLDASM, bottomBusbar.SLDPRT, wall with flanges.SLDPRT]
2024-11-17 Rear mounts pass + made drawings
    [91280A087_Medium-Strength Class 8.8 Steel Hex Head Screw.SLDPRT, Rear Mount Assy V2.SLDASM, Rear chassis mount v2.SLDDRW, Rear mount v2.SLDDRW, Rear mount v2.SLDPRT]
2024-11-17 Rear mounts in accumulator
    [Container.SLDASM]
2024-11-17 Drawings + Screenshots for PDR
    [Side Mount Assy V3.SLDASM, Side mount v3 Drawing.SLDDRW, Side mount v3.SLDPRT]
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2024-11-17 Added U-Joint Column Adapter to Assembly, Shortened Columns
    [Ruland_us12-6-f.SLDASM, Steering Upper Column.SLDPRT, _Steering_Assembly_NFR25.SLDASM]
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2024-11-17 rockers drawing 2nd op
    [Front Rockers.SLDPRT]
2024-11-17 Updated wheel nut with fillets and made float pin .030" longer for rotor expansion
    [Front Hub Small Inner Wheel Nut.SLDPRT, NFR22-20 Float PinREAR.SLDPRT]
2024-11-17 made more sus tabs
    [sus tab jigging assembly.SLDASM]
2024-11-17 started creating spacer in drivetrain assembly
    [MSA Spacer.SLDPRT, MSA Sprocket.SLDPRT]
2024-11-18 Added holes to brake pedal and throttle pedal mounts
    Added holes for screwing in the heel cups
    [BrakePedal.SLDPRT, ThrottlePedal.SLDPRT]
2024-11-18 fixed front wing for simulations
    [Front_Wing_Assembly.SLDASM, NFR_25_FrontWing_V2 (drew).SLDPRT, NFR_25_FrontWing_V2 (drew).STEP]
2024-11-19 Create 5waysplitter11.2.SLDPRT
    Added 5 way splitter file -- dimensions are not finalized. Should be well defined
    [5waysplitter11.2.SLDPRT]
2024-11-19 Servo motor and mount
    [Active_Aero_Mounting.SLDASM, Servo_Mount.SLDPRT, servo_motor.SLDPRT]
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2024-11-19 Made maintenance plug covers orange
    For ESF screenshots.
    [Female_Maintenance_Plug_Assembly.SLDASM]
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2024-11-19 Penthouse additions and changes
    Added:
    - Model and cutout of micro-fit 3.0 we are considering using for TSMP connector on driver right
    - Better 3D model of main battery connector receptacle
    - First 3D model of main battery connector plug (though it is allegedly a 16mm^2 plug, the mechanical dimensions we care about are accurate)
    Changed:
    - BMS MB is now inside the box. Left it not fully defined
    - Flipped reversed latch, I think caused by a mirror feature. This meant I deleted the mirror feature and added and mated another latch assembly
    - Freed the two driver-rear-facing latches because A) their mates were breaking randomly, and B) we have yet to finalize their locations, so we can figure o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
    [0430200400.SLDPRT, ELPA2Z1601.stp, ELRA2Z03.stp, Penthouse_Container.SLDASM, Penthouse_Left_Wall.SLDPRT, Penthouse_Rear_Wall.SLDPRT, Penthouse_Rightwall.SLDPRT]
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2024-11-20 fixed drivetrain mates
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2024-11-20 updated drivetrain assembly with correct sprocket sizes
    [Motor_Sprocket_NFR25.SLDPRT]
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2024-11-20 extracted first roll hoop
    [Full Main RH.SLDPRT, Main RH 1.SLDPRT, Only Baseplate.SLDASM]
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2024-11-21 wing mold edit for stratasys
    [FW1.STL, FW1_v1.SLDDRW, FW1_v1.SLDPRT, FW1_v1.STEP, FW2_v1.SLDDRW, FW2_v1.SLDPRT, FW3_v1.SLDPRT, RW1.STL]
2024-11-21 updated wheel temp sensor mount
    [SensorMountv2.SLDPRT]
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2024-11-21 moved new diff sprocket to correct folder
    [NFR25 Diff Sprocket.SLDPRT]
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2024-11-21 Added Floor Parts to Ergo folder
    [PedalBox Floor^_Chassis_Assembly_NFR25.SLDPRT, Rectangular Tab.SLDPRT, Seat Floor^_Chassis_Assembly_NFR25.SLDPRT]
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2024-11-21 cooling splitter
    Added threads, changed dimensions of holes to match anticipated barb size
    [5waysplitter11.2.SLDPRT]
2024-11-21 Trying to fix the floor files
    [New Rectangle Tab.SLDPRT, Seat Floor^_Chassis_Assembly_NFR25.SLDPRT]
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2024-11-21 Fixed floor files
    [Seat Floor^_Chassis_Assembly_NFR25.SLDPRT]
2024-11-21 did fea on new sprocket without spline
    [MSA Sprocket - old ver..SLDPRT, Motor_Sprocket_NFR25 - without spline.SLDPRT]
2024-11-21 Ran FEA on MDM
    [MDMount_NFR25.SLDPRT]
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2024-11-21 Added square U-block gcode
    Also created a folder in jigging, which holds the .step I imported into Fusion and the gcode.
    [UBlock_Square.STEP]
2024-11-21 throttle pedal bolt hole adjustment
    Cut extruded the back of the throttle pedal to be flat, extruded a hole through pedal, found proper bolt on mcmaster and mated it to the bolt hole.
    [ThrottlePedalBody.SLDPRT]
2024-11-21 my shit didnt save:(
    [Aluminum Extrusion.SLDPRT, Jigging Assembly.SLDASM, Main RH 1.SLDPRT, Main RH Setup.SLDASM]
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2024-11-21 cold plate bolts changed
    [92196A315_1-4x28_3-8CapScrew.SLDPRT, Cold_Plate.SLDPRT, Cold_Plate_Assembly.SLDASM, Container.SLDASM, wall with flanges.SLDPRT]
2024-11-21 roll hoop setup done
    [Main RH Setup.SLDASM]
2024-11-21 Organized jigging assembly + checked interference
    [Jigging Assembly.SLDASM]
2024-11-21 Update 5waysplitter11.2.SLDPRT
    Changed outlet hole size and threading
    [5waysplitter11.2.SLDPRT]
2024-11-21 fixed interference with jigging
    [Aluminum Extrusion.SLDPRT, Jigging Assembly.SLDASM, Total Baseplate.SLDASM, Tube Holder.SLDPRT]
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2024-11-22 added servo mount to main assembly
    [Active_Aero_Mounting.SLDASM, NFR25_RearWing_Mounting.SLDASM, Servo_Mount.SLDPRT]
2024-11-22 updated clearance holes
    [Active_Aero_Mounting.SLDASM, MirrorServo_Brace.SLDPRT, NFR25_RearWing_Mounting.SLDASM, Servo_Brace.SLDPRT]
2024-11-22 frame jigging setup all done
    [Aluminum Extrusion.SLDPRT, Jigging Assembly.SLDASM, Total Baseplate.SLDASM, Tube Holder.SLDPRT]
2024-11-22 waterjet setup complete
    i legit lost years of my life
    [FBH Holder.DXF, Fifth Plate.DXF, First Plate.DXF, Fourth Plate.DXF, RBH Holder.DXF, Second Plate.DXF, Seventh Plate.DXF, Sixth Plate.DXF]
2024-11-22 hid the stock border
    [_Waterjet Setup.DXF]
2024-11-22 saving and pushing again just in case
    [Jigging Assembly.SLDASM, _Setup CAD.SLDPRT]
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2024-11-23 Penthouse work w/ new e-meter info
    - Modified cutout for energy meter according to new document
    - Added energy meter plug, and very roughly modeled the features SAE has indicated will be on the exterior (last photo)
    - Replaced GLV connector with Anton's new one
    - Added cutout for new GLV connector
    [ColdPlateFittingAssembly.SLDASM, Cold_Plate_Assembly.SLDASM, Container.SLDASM, Female_Maintenance_Plug_Assembly.SLDASM, HDP24-18-20PE.stp, Penthouse_Container.SLDASM, Penthouse_Rear_Wall.SLDPRT, wall with flanges.SLDPRT]
2024-11-23 updated servo motor mounting to swan neck
    [Active_Aero_Mounting.SLDASM, NFR25_RearWing_Inserts.SLDPRT, NFR25_RearWing_Mounting.SLDASM, Servo_Mount.SLDPRT, Swan_Neck.SLDPRT]
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2024-11-23 changes in sus jigs
    [Total Baseplate.SLDASM, first jig TESTING.SLDPRT, sus tab jigging assembly.SLDASM]
2024-11-23 Edited radius of end of MDM, reran FEA
    [MDMount_NFR25.SLDPRT]
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2024-11-23 adjusted cooling splitter assembly
    Changed hole sizes and depth to better align with anticipated barbs
    [5346K13_1-4Hose1-8NPTThreads.SLDPRT, 5WaySplitter.SLDASM, 5waysplitter11.2.SLDPRT]
2024-11-23 fixing rebuild errors
    [sus tab jigging assembly.SLDASM]
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2024-11-23 Update 5WaySplitter.SLDASM
    Added remaining barbs to assembly and constrained each appropriately
    [5WaySplitter.SLDASM]
2024-11-23 updates on the fixed jigs
    [sus tab jigging assembly.SLDASM]
2024-11-23 Update sus tab jigging assembly.SLDASM
    [sus tab jigging assembly.SLDASM]
2024-11-23 Segment Changes
    - new amphenol plugs included
    - busbars updated
    - new hardware
    [92220A174_10x32_5-8 LowProfileCapScrew.SLDPRT, SLPRABPSO-Receptacle.SLDPRT, SLPRBBPSO_Receptacle.SLDPRT, bottomRightBusbar.SLDPRT, topLeftBusbar.SLDPRT]
2024-11-23 Fixed mates of the rectangular tabs
    [MDMount_NFR25.SLDPRT, PedalBox Floor^_Chassis_Assembly_NFR25.SLDPRT, Seat Floor^_Chassis_Assembly_NFR25.SLDPRT]
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2024-11-23 more updates on sus jigs
    [sus tab jigging assembly.SLDASM]
2024-11-23 Mounts good tolerances + individual ses
    [Side Mount Assy V3.SLDASM, Side chassis mount v3.SLDPRT, Side mount v3.SLDPRT, Tolerance stackup sketch.SLDPRT]
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2024-11-23 edited FEA for msa adapter and made changes to spacer
    [Adapter.SLDPRT, MSA Spacer.SLDPRT]
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2024-11-24 new maintenance plugs put in
    [Penthouse_Container.SLDASM, Penthouse_Left_Wall.SLDPRT, Penthouse_Lid.SLDPRT, Penthouse_Rightwall.SLDPRT, Southco-TL-40-111-52.sldasm]
2024-11-24 2/2 penthouse commits
    weird github thing, had to stash these
    [Container.SLDASM, Female_Maintenance_Plug_Assembly.SLDASM, SLPPA25BSO.stp, wall with flanges.SLDPRT]
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2024-11-24 Added inverter to full car assembly, changed accumulator in full car assembly to lightweight
    [Container.SLDASM, Inverter_Container_NFR25.SLDPRT, wall with flanges.SLDPRT]
2024-11-24 Fixed rubbing on hub caps, showed wheels
    [RearHubCaps_NFR25.SLDPRT]
2024-11-24 Fixed Right MDM FEA + design alterations:
    - reduced bolt hole radius to 0.257 in
    - made mount prongs(?) symmetrical
    - reduced the size of the section that holds msa bearing on left mount
    [MDMount_NFR25.SLDPRT]
2024-11-24 Added shunt resistor, made room for TSCB
    [SH6918F500BHEP Shunt Resistor.SLDPRT]
2024-11-24 added screw files into pedalbox folder
    updated the screw file used in the pedalbox assembly folder.
    [91251A146_Black-Oxide Alloy Steel Socket Head Screw.SLDPRT, 91864A033_Black-Oxide Alloy Steel Socket Head Screw.SLDPRT]
2024-11-25 Added lower steering adapter to assembly, shortened lower steering column
    [Ruland_us12-6-f.SLDASM, Steering Lower Column.SLDPRT, _Steering_Assembly_NFR25.SLDASM, lower_steering_adapter_nfr24.SLDPRT]
2024-11-25 Added cold plate, fasteners to inverter assembly
    [90128A234_M5x10_Screw.SLDPRT, 90453A113_M5_Low-Profile_Nylock.SLDPRT, 90631A112_M4_Nylock.SLDPRT, 90631A115_M8_Nylock.SLDPRT, 93310A813_Nylon_Patch_M5x10.SLDPRT, DC+_Busbar_Inverter_NFR25.SLDPRT, DC-_Busbar_Inverter_NFR25.SLDPRT, Inverter_Cold_Plate_NFR25.SLDPRT]
2024-11-25 changes to hubs
    changed hubs and drawings
    [FrontHub_NFR25.SLDPRT, FrontHub_NFR25_drawing.SLDDRW, RearHubs_NFR25.SLDDRW, RearHubs_NFR25.SLDPRT]
2024-11-26 maintenance plugs adjusted and cold plates saved
    [ColdPlateFittingAssembly.SLDASM, Cold_Plate.SLDPRT, Cold_Plate_Assembly.SLDASM, Container.SLDASM, FemaleMPBottomCover.SLDPRT, FemaleMPBusbar.SLDPRT, Female_Maintenance_Plug_Assembly.SLDASM, Female_Maintenance_Plug_Cover.SLDPRT]
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2024-11-26 rounded out edges of msa spacer
    [Adapter.SLDPRT]
2024-11-26 changed msa spacer length
    [MSA Spacer.SLDPRT]
2024-11-26 created 2nd msa spacer and added to drivetrain assembly
    [2nd MSA Spacer.SLDPRT, MDMount_NFR25.SLDPRT, MSA Spacer.SLDPRT]
2024-11-26 updated msa adapter fea
    [Adapter.SLDPRT]
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2024-11-26 fixed aero assembly
    [Active_Aero_Mounting.SLDASM, Carbon tube assembly.SLDASM, Front_Wing_Assembly.SLDASM, NFR25_Aero.SLDASM, NFR25_Bodywork.SLDASM, NFR25_RearWing_Mounting.SLDASM, Pulley.SLDASM, Rear_Wing_NFR25.SLDASM]
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2024-11-27 threads altered on splitter
    [5346K13_1-4Hose1-8NPTThreads.SLDPRT, 5WaySplitter.SLDASM, 5WaySplitterStep.STEP]
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2024-11-27 hard sus jigs updates
    [Total Baseplate.SLDASM, sus tab jigging assembly.SLDASM]
2024-11-27 changed dimensions of splitter
    edited splitter dimensions to align outlet barbs with inlet barb (removed overlap), and eliminated some excess material (not done yet)
    [5WaySplitter.SLDASM, 5waysplitter11.2.SLDPRT]
2024-11-28 updated 80/20 thicknesses according to inventory
    [Aluminum Extrusion.SLDPRT, Jigging Assembly.SLDASM]
2024-11-29 getting left side panel CAM ready
    [Left Side Panel Stock.SLDPRT, Left Side Panel Stock.STEP, NFR25_Left_Back_Side_Panel_Mold.SLDPRT]
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2024-12-01 Modeled TS wiring in penthouse
    [LSCR101.stp, NFR25_SensePCB.SLDPRT]
2024-12-03 Small penthouse changes
    Modified wiring, including making short one between shunt R and main TS connector a busbar. Moved contactors towards driver rear to accommodate wire under lid better.
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2024-12-03 busbars updated and sendcutsend files created
    [bottomBusbar.SLDPRT, bottomRightBusbar.SLDPRT, bottomRightBusbarSCS.STEP, topBusbar.SLDPRT, topBusbarSCS.STEP, topLeftBusbar.SLDPRT, topLeftBusbarSCS.STEP]
2024-12-03 container scs file created
    [Accumulator_Container_OnePieceSCS.STEP, Container.SLDASM]
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2024-12-03 cold plate fittings added
    [BarbBlockModel.SLDPRT, ColdPlateFittingAssembly.SLDASM, Cold_Plate_Assembly.SLDASM, Container.SLDASM, topBusbar.SLDPRT, wall with flanges.SLDPRT]
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2024-12-05 Updated for deeper stronger nut
    [Front Hub Small Inner Wheel Nut.SLDPRT]
2024-12-05 splitter body
    Added cut in splitter to reduce mass
    [5WaySplitter.SLDASM, 5waysplitter11.2.SLDPRT]
2024-12-05 new lower wishbone end
    replaced old lower wishbone end
    [front_lower_wishbone_end.SLDPRT, wishbone_end_front_lower_nfr25.SLDPRT]
2024-12-05 upper front wishbone end
    new model, and saved skeleton (no changes)
    [_Suspension_Skeleton_NFR25.SLDPRT, wishbone_end_front_upper_nfr25.SLDPRT]
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2024-12-05 edited cad and made step file
    summary
    [wishbone_end_front_upper_nfr25.SLDPRT, wishbone_end_front_upper_nfr25_STEP.SLDPRT, wishbone_end_front_upper_nfr25_STEP.STEP]
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2024-12-07 cold plates and container updated
    [91864A047_1-4x28_1-2_CapScrew.SLDPRT, 92141A029_Stainless_1-4_Washer.SLDPRT, 94709A416_1-4_.75_SealingWasher.SLDPRT, Accumulator_Container_OnePiece.SLDPRT, Cold_Plate.SLDPRT, Cold_Plate_Assembly.SLDASM, Container.SLDASM, Female_Maintenance_Plug_Assembly.SLDASM]
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2024-12-09 new container and segment box
    [Accumulator_Container_OnePiece.SLDPRT, Container.SLDASM, Container2.SLDASM, InternalWall.SLDPRT, InternalWallSCS.STEP, Lid2.SLDPRT, Lid2SCS.STEP, MockContainer.SLDPRT]
2024-12-09 Modifications to accum container
    [Container2.SLDASM, Lid2.SLDPRT, MockContainer2.SLDPRT]
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2024-12-10 number of rivets changed
    [Container2.SLDASM, FemaleMPBottomCover.SLDPRT, Female_Maintenance_Plug_Assembly.SLDASM, Female_Maintenance_Plug_Cover.SLDPRT, MockContainer2.SLDPRT]
2024-12-10 penthouse work
    - changed number of rivets and location for penthouse container
    - adjust segment box lid and added rivets
    - created new accumulator assembly
    [Container.SLDASM, Container2.SLDASM, Lid2.SLDPRT, MockContainer2.SLDPRT, Penthouse_Container.SLDASM, Penthouse_Front_Wall.SLDPRT, Penthouse_Left_Wall.SLDPRT, Penthouse_Lid.SLDPRT]
2024-12-11 Penthouse and accumulator assembly work
    - added penthouse internal wall
    - added internal wall rivet holes to segment box lid
    - changed rear wall of penthouse
    [Container2.SLDASM, InternalWall.SLDPRT, Lid2.SLDPRT, MockContainer2.SLDPRT, PenthouseInternalWall.SLDPRT, PenthouseLid2.SLDPRT, Penthouse_Container.SLDASM, Penthouse_Lid.SLDPRT]
2024-12-11 Hella files rearranged
    Accumulator container fixes and files rearranged
    [1823444-2-LVCONNECTOR.SLDPRT, 1823444-2-LV_Connector.SLDPRT, 90thouspacer.SLDPRT, 91831A135_18-8 Stainless Steel Nylon-Insert Locknut.SLDPRT, 92196A687_18-8 Stainless Steel Socket Head Screw.SLDPRT, 97524A154_Sealing Blind Rivets.SLDPRT, 97524A154_Sealing Blind Rivets.STEP, Accumulator_Container_Assembly_2025.SLDASM]
2024-12-11 many sendcutsend files created
    [Flat pattern - PenthouseLid.DXF, PenthouseInternalWall.SLDPRT, PenthouseInternalWallSCS.STEP, PenthouseLid.SLDPRT, PenthouseLidSCS.STEP, Penthouse_Container.SLDASM, Penthouse_Front_WallSCS.STEP, Penthouse_Left_WallSCS.STEP]
2024-12-11 Mounts in New Segment box
    [ColdPlateFittingAssembly.SLDASM, Cold_Plate_Assembly.SLDASM, Female_Maintenance_Plug_Assembly.SLDASM, SegmentContainer.SLDASM]
2024-12-11 Added new accumulator assembly to vehicle assembly, made lightweight version of accum assem
    [_NFR25_Vehicle_Assembly.SLDASM]
2024-12-11 Rear mounts weld bead tolerance
    [Rear Mount Assy V2.SLDASM, Rear chassis mount v2.SLDPRT, Rear mount v2.SLDPRT, Side Mount Assy V3.SLDASM]
2024-12-11 Mounts in new seg box positions good
    [ColdPlateFittingAssembly.SLDASM, Cold_Plate_Assembly.SLDASM, Female_Maintenance_Plug_Assembly.SLDASM, Rear Mount Assy V2.SLDASM, SegmentContainer.SLDASM, Side Mount Assy V3.SLDASM, Side chassis mount v3.SLDPRT, Side mount v3.SLDPRT]
2024-12-12 topology for front wing
    [Front_Wing_Assembly.SLDASM]
2024-12-12 Added Front Anti-Roll Bar
    [ARB_Assembly_Front_NFR25.SLDASM, Front_arb_bearing_6338K572_Oil-Embedded Flanged Sleeve Bearing.SLDPRT, Front_arb_bolt_92620A241_Zinc Yellow-Chromate Plated Hex Head Screw.SLDPRT, Front_arb_slot.SLDPRT, Front_arb_small_bar_89955K479.SLDPRT, Front_arb_small_tube_end_insert.SLDPRT, Front_arb_tab.SLDPRT, Front_arb_torsion_bar_89955K299.SLDPRT]
2024-12-12 SS and FEA for DR
    [Rear Mount Assy V2.SLDASM, Rear chassis mount v2.SLDDRW, Rear chassis mount v2.SLDPRT, Rear mount v2.SLDPRT, Side Mount Assy V3.SLDASM, Side chassis mount v3 Drawing.SLDDRW, Side mount v3 Drawing.SLDDRW, Side mount v3.SLDPRT]
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2024-12-13 cold plate weight reduction sketch
    [Cold_Plate.SLDPRT, Cold_Plate_Assembly.SLDASM]
2024-12-14 changes on brake side
    [BrakePedal.SLDPRT, ThrottlePedal.SLDPRT, ThrottlePedalBody.SLDPRT]
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2024-12-14 ses fw & rw
    [Front_Wing_Assembly.SLDASM]
2024-12-15 changed orientation of cross sectional plane for SES
    [MDMount_NFR25.SLDPRT]
2024-12-15 Changed rivet file to get rid of part sticking out
    [97525A680_18-8 Stainless Steel Blind Rivets.SLDPRT]
2024-12-15 Orientation of penthouse side walls changed
    [PenthouseLid.SLDPRT, Penthouse_Container.SLDASM]
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2024-12-16 Modified inverter assembly to match updated driver board
    [9448K12_Brass Submersible Cord Grip.SLDPRT, ISB-300-A-802_current_transducer.SLDPRT, Inverter_Container_NFR25.SLDPRT, Phase_Busbar_Inverter_NFR25.SLDPRT, W_Busbar_Inverter_NFR25.SLDPRT]
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2024-12-17 Updated to new inverter model, added MSD inside of inverter
    [90576A102_Medium-Strength Steel Nylon-Insert Locknut.SLDPRT, 92095A184_Button Head Hex Drive Screw.SLDPRT, 92095A460_Button Head Hex Drive Screw.SLDPRT, 92510A035_Aluminum Unthreaded Spacer.SLDPRT, 92510A442_Aluminum Unthreaded Spacer.SLDPRT, DC+_Busbar_Inverter_NFR25.SLDPRT, DC-_Busbar_Inverter_NFR25.SLDPRT, EM30MSD_Manual_Service_Disconnect.SLDPRT]
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2024-12-18 Solid part files for XACT and drawing pdfs
    [Rear Mount Chassis side Solid File.x_t, Rear Mount Container side Solid File.x_t, Side Mount Assy V3.SLDASM, Side Mount Chassis side Solid File.x_t, Side Mount Container side Solid File.x_t, Side mount v3 Drawing.SLDDRW, Side mount v3.SLDPRT]
2024-12-18 minor changes for accuracy
    [1_frame.SLDDRW, 1_frame.SLDPRT, Aluminum Extrusion.SLDPRT, Jigging Assembly.SLDASM]
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2024-12-19 Partially mirrored front corner assembly
    [Front Rockers.SLDPRT, FrontHub_NFR25.SLDPRT, Front_Uprights_NFR25.SLDPRT]
2024-12-19 Moved inverter to general electrical assembly, created mounting tab
    [Inverter Tab.SLDPRT, Inverter_Container_NFR25.SLDPRT, _NFR25_Vehicle_Assembly.SLDASM]
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2024-12-19 Re suppressed boards in lightweight configuration
    [Penthouse_Container.SLDASM]
2024-12-19 some more accuracy to real life
    [7_frame 1x1.SLDDRW, 7_frame 1x1.SLDPRT, Aluminum Extrusion.SLDPRT]
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2024-12-20 added weird 8020 design
    [Weird_8020.SLDPRT]
2024-12-20 Penthouse internal wall edits
    [PenthouseInternalWall.SLDPRT, Penthouse_Container.SLDASM, Penthouse_Front_Wall.SLDPRT, Penthouse_Left_Wall.SLDPRT, Penthouse_Rear_Wall.SLDPRT, Penthouse_Rightwall.SLDPRT]
2024-12-20 Fixed incorrect energy meter bolt pattern
    [Penthouse_Rear_Wall.SLDPRT]
2024-12-20 Changes on MDM flange
    [MDMount_NFR25.SLDPRT]
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2024-12-22 Front arb with separatable tabs, which allows removing the bar after welding the upper tab
    [ARB_Assembly_Front_NFR25.SLDASM, Front_arb_lower_tab.SLDPRT, Front_arb_small_bar_89955K479.SLDPRT, Front_arb_tab_long_screw_1_3_8_91251A210_Black-Oxide Alloy Steel Socket Head Screw.SLDPRT, Front_arb_tab_nut_94528A112_Titanium Nylon-Insert Locknut.SLDPRT, Front_arb_upper_tab.SLDPRT]
2024-12-23 Moved tsmp connector, fully defined penthouse container, adjusted holes in penthouse wall
    [PenthouseInternalWall.SLDPRT, PenthouseLid.SLDPRT, Penthouse_Container.SLDASM, Penthouse_Front_Wall.SLDPRT, Penthouse_Rear_Wall.SLDPRT, SegmentContainer.SLDASM]
2024-12-24 maintenance plug safety
    created new plug safety folder, added work in progress parts/assemblies for preliminary safety features
    [FemaleMPBottomCover_ethanTEST.SLDPRT, FemaleMPBusbar_ethanTEST.SLDPRT, Female_Maintenance_Plug_Assembly_ethanTEMP.SLDASM, Female_Maintenance_Plug_Cover_ethanTEST.SLDPRT, cap_base.SLDPRT, femaleMolexMP_ethanTEST.SLDPRT]
2024-12-25 Changes on eccentric plate for fastener clearance
    [MDMount_NFR25.SLDPRT]
2024-12-26 safety cap
    created safety cap assembly and added to segment assembly, and updated safety cap further
    [Safety_cap.SLDASM, cap_base.SLDPRT]
2024-12-27 segment lid holes realigned
    [SegmentContainer.SLDASM, SegmentLid.SLDPRT]
2024-12-28 Weight reduction cuts and rerun of fea for left and right mdm
    [MDMount_NFR25.SLDPRT]
2024-12-29 positive stop and a few small changes
    [BrakePedal.SLDPRT, ThrottlePedal.SLDPRT, ThrottlePedalBody.SLDPRT]
2024-12-29 Sheet metal submitted to sendcutsend
    [FemaleMPBusbar.SLDPRT, FemaleMPBusbar.STEP, Female_Maintenance_Plug_Assembly.SLDASM, Female_Maintenance_Plug_Cover.SLDPRT, PenthouseInternalWall.SLDPRT, PenthouseInternalWall.STEP, PenthouseInternalWallSCS.STEP, PenthouseLid.SLDPRT]
2024-12-31 Changes to MDM thickness + added jack bar to drivetrain assem
    [Jack_Bar.SLDPRT, MDMount_NFR25.SLDPRT]
2025-01-01 Added jacking point to MDM
    [MDMount_NFR25.SLDPRT]
2025-01-01 Fixed jacking point on MDM
    [Jack_Bar.SLDPRT, MDMount_NFR25.SLDPRT, _Chassis_Skeleton_NFR25.SLDPRT]
2025-01-02 Cold plate weight reduction and maintenance plug adjustments
    [Cold_Plate.SLDPRT, Cold_Plate_Assembly.SLDASM, FemaleMPBusbar.SLDPRT, Female_Maintenance_Plug_Assembly.SLDASM, PenthouseInternalWall.SLDPRT, Penthouse_Container.SLDASM, Rear Mount Assy V2.SLDASM, SegmentContainer.SLDASM]
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2025-01-03 Step File for Rear Hubcaps
    [RearHubCaps_NFR25_step.STEP]
2025-01-03 cell holder moment of inertia measurements
    [Female_Maintenance_Plug_Assembly.SLDASM, MOI_Calcs.SLDPRT, Moi_Calcs_Assem.SLDASM, Rear Mount Assy V2.SLDASM, Side Mount Assy V3.SLDASM]
2025-01-04 triple checking sendcut send stuff and minor busbar edits
    [FemaleMPBusbar.SLDPRT, Female_Maintenance_Plug_Assembly.SLDASM, PenthouseInternalWall.SLDPRT, PenthouseLid.SLDPRT, Penthouse_Container.SLDASM, Rear Mount Assy V2.SLDASM, Segment Lid.STEP, SegmentContainer.SLDASM]
2025-01-04 Reorganized inverter file structure
    [90128A234_M5x10_Screw.SLDPRT, 90453A113_M5_Low-Profile_Nylock.SLDPRT, 90576A102_Medium-Strength Steel Nylon-Insert Locknut.SLDPRT, 90631A112_M4_Nylock.SLDPRT, 90631A115_M8_Nylock.SLDPRT, 92095A184_Button Head Hex Drive Screw.SLDPRT, 92095A460_Button Head Hex Drive Screw.SLDPRT, 92510A035_Aluminum Unthreaded Spacer.SLDPRT]
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2025-01-06 front wing updates SES
    [Front_Wing_Assembly.SLDASM, NFR_25_FrontWing_V2 (drew).SLDPRT]
2025-01-06 Added lv battery block model
    [LV_Battery_Block.SLDPRT]
2025-01-06 SES drawings and ss
    [Rear chassis mount SES drawing.SLDDRW, Rear chassis mount v2.SLDPRT, Rear mount container side SES Drawing.SLDDRW, Side chassis mount SES drawing.SLDDRW, Side mount container side SES drawing.SLDDRW, Side mount v3.SLDPRT]
2025-01-06 Lap Belt Tabs added to chassis assembly
    [Lap Belt Tab.SLDPRT]
2025-01-06 moment of inertia calculations
    [ColdPlateFittingAssembly.SLDASM, Cold_Plate_Assembly.SLDASM, SegmentContainer.SLDASM]
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2025-01-08 safety cap
    updated safety cap
    [cap_base.SLDPRT]
2025-01-08 deleted extraneous file
    deleted unused assembly file (will update new file title)
    [Safety_cap.SLDASM]
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2025-01-09 Added nut and bolt files to MDM folder
    [92620A564_Zinc Yellow-Chromate Plated Hex Head Screw.SLDPRT, 97135A215_High-Strength Steel Nylon-Insert Locknut.SLDPRT]
2025-01-09 threaded bolt holes on spacer
    [MSA Spacer.SLDPRT]
2025-01-09 FEA on new DSA
    [DSA_v7.SLDPRT]
2025-01-09 cooling splitter version 2
    Created cooling splitter and assembly with cylindrical body -- will need to be CNCed at some point
    [5346K13_1-4Hose1-8NPTThreads.SLDPRT, 5WaySplitter.SLDASM, 5waysplitter11.2.SLDPRT, cap_base.SLDPRT, cylindrical splitter assembly.SLDASM, splitter cylindrical body.SLDPRT]
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2025-01-09 Updated Base Plate Pre-Final
    [Base_Plate.SLDPRT, Base_Plate_Assembly.SLDASM, Part1.SLDPRT]
2025-01-10 Finalized Base Plate Assembly 1/9 for CNC
    [Base_Plate.SLDPRT, Base_Plate_Assembly.SLDASM]
2025-01-10 Final Base Plate Assembly
    [Base_Plate.SLDPRT, Base_Plate_Assembly.SLDASM]
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2025-01-10 Increased minimum cross section thickness
    [Front Hub Small Inner Wheel Nut.SLDPRT]
2025-01-10 base plate thickness adjusted
    [Base_Plate.SLDPRT, Base_Plate.STEP]
2025-01-10 full assembly saved and files moved
    [Base_Plate.SLDPRT, Base_Plate.STEP, Base_Plate_Assembly.SLDASM, ColdPlateTemplate.SLDPRT, Cold_Plate_Assembly.SLDASM, Flat pattern - PenthouseLid.DXF, Part1.SLDPRT, Rear Mount Assy V2.SLDASM]
2025-01-11 Update cylindrical splitter assembly.SLDASM
    rebuilt assembly
    [cylindrical splitter assembly.SLDASM]
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2025-01-11 deleted older versions of msa sprocket
    [MSA Sprocket - old ver..SLDPRT]
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2025-01-11 Updated Base Plate File
    [Base_Plate_Assembly.SLDASM, Base_Plate_STEP_Updated.STEP]
2025-01-11 Modeled the holes that will be used to mount motor on mdm
    [MDMount_NFR25.SLDPRT]
2025-01-11 Base Plate Width Update Final
    [Base_Plate.SLDPRT, Base_Plate_STEP_Final.STEP]
2025-01-11 Modified hub cap hole size
    [RearHubCaps_NFR25.SLDPRT, Wheel_Nut_NFR24.SLDPRT, Wheel_Nut_NFR24.STEP]
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2025-01-11 16 holes, .13" width
    [Front Hub Small Inner Wheel Nut.SLDPRT]
2025-01-11 4 Spoked DSA no lip
    [DSA_v7.SLDPRT]
2025-01-11 changes to sus jigs
    [Total Baseplate.SLDASM, left_1_lower.SLDPRT, left_1_upper.SLDPRT, left_2_upper.SLDPRT, left_lower(1).SLDPRT, left_lower(1).STL, left_middle(1).SLDPRT, left_middle(1).STL]
2025-01-11 Redid msa spacer fea
    [MSA Spacer.SLDPRT]
2025-01-11 Optimized throttle pedal
    Optimized throttle pedal based on topology study.
    [ThrottlePedalBody.SLDPRT]
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2025-01-12 Added resolver plate to motor
2025-01-12 Left MDM Weight Reduction
    [MDMount_NFR25.SLDPRT]
2025-01-12 create active_aero_arm_v1
    active aero arm/linkage using dims from Active_Aero_Linkages
    [active_aero_arm_v1.SLDPRT]
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2025-01-14 Made motor hole on MDM fit resolver in drivetrain assem
    [MDMount_NFR25.SLDPRT]
2025-01-15 active aero arm convert to steel
    [Active_Aero_Linkages.SLDPRT, Jigging Assembly.SLDASM, active_aero_arm_v1.SLDPRT]
2025-01-15 .9008" inner diameter for threads to bite
    [Front Hub Inner Wheel Nut.SLDPRT]
2025-01-15 started fea for active aero arm
    [active_aero_arm_v1 (1).SLDPRT]
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2025-01-15 Made welding tabs for the front arb thicker, replaced old bolts with longer ones, added temporary drop link for the rear arb
    [ARB_Assembly_Front_NFR25.SLDASM, ARB_Assembly_Rear_NFR25.SLDASM, Front_arb_tab_longer_screw_91251A149_Black-Oxide Alloy Steel Socket Head Screw.SLDPRT, Front_arb_upper_tab.SLDPRT, _Suspension_Skeleton_NFR25.SLDPRT, rear_arb_drop_link.SLDPRT]
2025-01-15 updates on sus jigs
    [sus tab jigging assembly.SLDASM]
2025-01-15 updates on sus tab jigs
    [sus tab jigging assembly.SLDASM]
2025-01-15 Inverter assembly finalized perhaps?
    [6-2271117-2.SLDPRT, 93705A851_18-8 Stainless Steel Thread-Locking Socket Head Screw.SLDPRT, 95105A135_Zinc-Plated Steel Heavy-Duty Rivet Nut.SLDPRT, 97447A020_Aluminum Blind Rivets with Aluminum Mandrel.SLDPRT, Inverter Tab.SLDPRT, Inverter_Container_NFR25.SLDPRT, T4111012081-000.SLDPRT, T4171030012-001.SLDPRT]
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2025-01-16 added 2nd msa spacer to drivetrain assembly
    [2nd MSA Spacer.SLDPRT, MDMount_NFR25.SLDPRT, MSA Spacer.SLDPRT]
2025-01-16 added new arms docs, changed lower wishbone end
    [steel_wishbone_end_idea.SLDPRT, wishbone_end_front_lower_nfr25.SLDPRT, wishbone_steel_front_upper_nfr25.SLDPRT]
2025-01-16 created cold plate machining step
    [Cold_Plate_Machining.STEP]
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2025-01-17 First try safety lights enclosure
    [Safety Lights Enclosure Final.SLDPRT]
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2025-01-18 updated fea for msa adapter and spacer
    [Adapter.SLDPRT, MSA Spacer.SLDPRT]
2025-01-18 added jackbar part into drivetrain assembly
    [DSA_v7.SLDPRT]
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2025-01-18 Flipped upright for opposite CAM
    [Upright Stock.SLDPRT]
2025-01-18 Flipped upright
    [MirrorRearUpright NFR25.SLDPRT, MirrorUpright Stock.SLDPRT, Rear Upright in Stock.SLDASM, Upright Stock.SLDPRT]
2025-01-18 Hopefully fixed reverted files
    [1823444-2-LV_Connector.SLDPRT, 90409A135_High-Strength Grade 8 Steel Hex Head Screw.SLDPRT, 90thouspacer.SLDPRT, 91831A135_18-8 Stainless Steel Nylon-Insert Locknut.SLDPRT, 91864A033_Black-Oxide Alloy Steel Socket Head Screw.SLDPRT, 91864A047_1-4x28_1-2_CapScrew.SLDPRT, 92196A687_18-8 Stainless Steel Socket Head Screw.SLDPRT, 944U221K801ACM_DC_Link_Capacitor.SLDPRT]
2025-01-18 Fixed broken part of sus assembly
2025-01-18 Fixed lightweight config of accum assem
    [PenthouseInternalWall.SLDPRT, Penthouse_Container.SLDASM, Rear Mount Assy V2.SLDASM, SLPRABPSO-Receptacle.SLDPRT, Side Mount Assy V3.SLDASM]
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2025-01-18 Re-implemented front wing changes
    [NFR_25_FrontWing_V2 (drew).SLDPRT, NewInserts.SLDASM]
2025-01-18 sus tab jigs organizing files
    [left_lower(1).STL, left_middle(1).STL, left_upper(1).STL, right_lower(1).STL, right_upper(1).STL, rigth_middle(1).STL]
2025-01-18 changed inverter cable glands
    [9448K14_Brass Submersible Cord Grip.SLDPRT, Inverter_Container_NFR25.SLDPRT]
2025-01-18 splitter drawing
    suppressed threads and created drawing
    [5waysplitter11.2.SLDPRT, 5waysplitterdrawing.SLDDRW]
2025-01-18 changed msa adapter thickness + updated fea
    [Adapter.SLDPRT]
2025-01-18 Added more weight reduction cuts
    [MDMount_NFR25.SLDPRT]
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2025-01-18 updated fea for msa spacer
    [MSA Spacer.SLDPRT]
2025-01-18 organizing sus tab jig files
    [back_lower_1(L).SLDPRT, back_lower_1_(R).SLDPRT, back_lower_2(L).SLDPRT, back_lower_2_(R).SLDPRT, back_lower_3(L).SLDPRT, back_lower_3_(R).SLDPRT, back_upper_1(L).SLDPRT, back_upper_1(R).SLDPRT]
2025-01-18 updated spacer and adapter
    [Adapter.SLDPRT, MSA Spacer.SLDPRT]
2025-01-18 organizing file names sus tab jig
    [front_lower_1(R).SLDPRT, front_lower_2(R).SLDPRT, front_upper_1(R).SLDPRT, front_upper_2(R).SLDPRT, front_upper_3(L).SLDPRT, front_upper_3(R).SLDPRT, sus tab jigging assembly.SLDASM]
2025-01-18 Added tabs for jackbar onto mdm
    [Jackbar_Part.SLDPRT, MDMount_NFR25.SLDPRT]
2025-01-18 Finalized(?) jackbar tabs on MDM
    [MDMount_NFR25.SLDPRT]
2025-01-18 changes to sus tab jigs
    [back_lower_3(L).SLDPRT, back_upper_3(L).SLDPRT, sus tab jigging assembly.SLDASM]
2025-01-18 Edited throttle pedal heel cup
    [newthrottlepedal.SLDPRT]
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2025-01-18 Made jackbar tabs not cross reference two files and added more jackbar mounts into drivetrain assembly
    [Jackbar_Part.SLDPRT, MDMount_NFR25.SLDPRT]
2025-01-18 sus tab jig changes
    [back_lower_1(L).SLDPRT, back_lower_2(L).SLDPRT, back_upper_2(L).SLDPRT, sus tab jigging assembly.SLDASM]
2025-01-19 Added cold plate ground wire
    Might delete later
    [SegmentContainer.SLDASM]
2025-01-19 Made eccentric plate flange smaller to stop interference
    [MDMount_NFR25.SLDPRT]
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2025-01-20 Got rid of unnecessary features and fixed right mount FEA
    [MDMount_NFR25.SLDPRT]
2025-01-20 Fixed jackbar mount FEA
    [Jackbar_Part.SLDPRT]
2025-01-20 Renamed jackbar mount file
    [Jackbar_Mount.SLDPRT, Jackbar_Part.SLDPRT]
2025-01-20 fixed jackbar mounts in drivetrain assembly
    [Jackbar_Mount.SLDPRT, MDMount_NFR25.SLDPRT]
2025-01-20 forgot to push something
    [DSA_v7.SLDPRT]
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2025-01-20 deleted old bending jig files
    [CopperBendingJig.SLDASM, CopperBendingJigBasePlate.SLDPRT, CopperBendingJigBricks.SLDPRT, CopperBendingJigDies.SLDPRT, CopperBendingJigDies_Drawing.SLDDRW]
2025-01-21 fixing aero assembly
    [AB-4-AuroraBearingC0.-1.SLDPRT, Front_Wing_Assembly.SLDASM, NFR25_Bodywork.SLDASM, NFR25_RearWing_Mounting.SLDASM, Rear_Wing_NFR25.SLDASM, Undertray Assembly NFR25.SLDASM]
2025-01-21 updated the aero assembly pt2
    [NFR25_RearWing_Mounting.SLDASM, Rear_Wing_NFR25.SLDASM]
2025-01-21 replaced 61911 bearing with one with shielding
    [skf_bearing_61909-2rs1_2.SLDPRT, skf_bearing_61911-2rs1_2.SLDPRT, skf_bearing_61911_2.stp.SLDPRT]
2025-01-21 sus tab jig updates
    [front_lower_1(L).SLDPRT, front_lower_2(L).SLDPRT, front_upper_1(L).SLDPRT, front_upper_2(L).SLDPRT, front_upper_3(L).SLDPRT, sus tab jigging assembly.SLDASM]
2025-01-22 changed fillets of weight reduction cuts to 3/16in and re-ran fea
    [MDMount_NFR25.SLDPRT]
2025-01-22 extruded eccentric plates of left and right mdms by additional 10 thou, re-ran fea
    [MDMount_NFR25.SLDPRT]
2025-01-22 1/2in fillet on left and right mounts for thinning weight reduction cuts, re-ran fea
    [MDMount_NFR25.SLDPRT]
2025-01-22 changed motor hole size to 9 mm on right mdm, re-ran fea
    [MDMount_NFR25.SLDPRT]
2025-01-22 increased final thickness of right mdm by 0.1in, re-ran fea
    [MDMount_NFR25.SLDPRT]
2025-01-22 Made inverter assembly lightweight in full assembly
    [ColdPlateFittingAssembly.SLDASM]
2025-01-22 aligned msa adapter holes to spacer holes
    [Adapter.SLDPRT, MSA Spacer.SLDPRT]
2025-01-22 renamed msa sleeve file
    [2nd MSA Spacer.SLDPRT, MSA Sleeve.SLDPRT]
2025-01-22 post DR MDM changes
    - thickened height of jackbar mounts
    - adjusted jackbar tabs accordingly on mount
    - made it so jackbar mounts come 10 thou off the surface of mdm
    - replaced mdm bearing with correct one and adjusted mdm for said bearing
    [Jackbar_Mount.SLDPRT, MDMount_NFR25.SLDPRT]
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2025-01-22 Fixed the DSA Folder
    [DSA_v7.SLDPRT, Test_DSA.SLDPRT, Test_DSA_v2.SLDPRT, Test_DSA_v3.SLDPRT, Test_DSA_v4.SLDPRT, Test_DSA_v5.SLDPRT, Test_DSA_v6.SLDPRT]
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2025-01-23 Edited brake pedal heel cup
    [newbrakepedal.SLDPRT]
2025-01-23 added cyinders for sus tabs
    [Total Baseplate.SLDASM, cyl_medium.SLDPRT, cyl_short.SLDPRT, cyl_tall.SLDPRT, sus tab jigging assembly.SLDASM]
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2025-01-23 added chamfers to spacer
    [MSA Spacer.SLDPRT]
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2025-01-23 DSA final update i think
    [DSA.SLDPRT]
2025-01-23 sus tab jig mirroring
    [Mirrorback_lower_1(L).SLDPRT, Mirrorback_lower_2(L).SLDPRT, Mirrorback_lower_3(L).SLDPRT, Mirrorback_upper_1(L).SLDPRT, Mirrorback_upper_2(L).SLDPRT, Mirrorback_upper_3(L).SLDPRT, Mirrorfront_lower_1(L).SLDPRT, Mirrorfront_lower_2(L).SLDPRT]
2025-01-23 Holes in floor
    created holes in floor in order to redo mates with tabs.
    [New Rectangle Tab.SLDPRT, Seat Floor^_Chassis_Assembly_NFR25.SLDPRT]
2025-01-23 fixed the left mount fillet
    [MDMount_NFR25.SLDPRT]
2025-01-23 changed threads on msa spacer
    [MSA Spacer.SLDPRT, MSA_Assembly.SLDASM]
2025-01-23 sus tab jigs stl files
    [Mirrorback_lower_1(L).STL, Mirrorback_lower_2(L).SLDPRT, Mirrorback_lower_2(L).STL, Mirrorback_lower_3(L).STL, Mirrorback_upper_1(L).STL, Mirrorback_upper_2(L).STL, Mirrorback_upper_3(L).STL, Mirrorfront_lower_1(L).STL]
2025-01-23 Updating the front wing assembly
    [90630A145_High-Strength Steel Nylon-Insert Locknut.SLDPRT, 92620A563_Zinc Yellow-Chromate Plated Hex Head Screw.SLDPRT, 94459A340_Heat-Set Inserts for Plastic.SLDPRT, Front_Wing_Assembly.SLDASM, NFR_25_FrontWing_V2 (drew).SLDPRT, Structural Tube.SLDPRT]
2025-01-23 Fixed rear sus assembly misalignment and hid some sketches
    [ARB_Assembly_Front_NFR25.SLDASM, ARB_Assembly_Rear_NFR25.SLDASM, FrontHub_NFR25.SLDPRT, Rear Rockers V3.SLDPRT, RearHubCaps_NFR25.SLDPRT, RearUpright NFR25.SLDPRT, Steering Lower Column.SLDPRT, Steering Upper Column.SLDPRT]
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2025-01-25 Update Safety Lights Enclosure Final.SLDPRT
    [Safety Lights Enclosure Final.SLDPRT]
2025-01-25 lv battery box testing created
    [LV_Battery_Block.SLDPRT, LV_Battery_Testing.SLDPRT, LV_Battery_Testing_Assem.SLDASM]
2025-01-25 New fw insert updates
    [Front_Wing_Assembly.SLDASM, MidFoilInsert.SLDPRT, TopFoilInsert.SLDPRT]
2025-01-25 slight fw insert changes
    [Front_Wing_Assembly.SLDASM, MidFoilInsert.SLDPRT, TopFoilInsert.SLDPRT]
2025-01-25 separated mounts and eccentric plates into new part files
    [MDMount_NFR25-Left Eccentric Plate.SLDPRT, MDMount_NFR25-Left Mount.SLDPRT, MDMount_NFR25-Right Eccentric Plate.SLDPRT, MDMount_NFR25-Right Mount.SLDPRT]
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2025-01-25 segment safety updates
    deleted old misc files, updated safety cap and created connected safety cap parts, and added these to segment assembly
    [FemaleMPBottomCover_ethanTEST.SLDPRT, FemaleMPBusbar_ethanTEST.SLDPRT, Female_Maintenance_Plug_Assembly_ethanTEMP.SLDASM, Female_Maintenance_Plug_Cover_ethanTEST.SLDPRT, cap_base.SLDPRT, femaleMolexMP_ethanTEST.SLDPRT, safety_cap.SLDPRT, safety_cap_connected.SLDPRT]
2025-01-25 Changes to RLM Safety Indicator and Their Enclosure
    [Ready to Move Light.SLDPRT, Safety Lights Enclosure Final.SLDPRT, Safety Status Indicator.SLDPRT]
2025-01-25 added m8 screws for drivetrain
    [90117A205_Alloy Steel Wire-Lockable Socket Head Screw.SLDPRT]
2025-01-25 kinda major changes to msa
    [90117A205_Alloy Steel Wire-Lockable Socket Head Screw.SLDPRT, Adapter.SLDPRT, MSA Sleeve.SLDPRT, MSA Spacer.SLDPRT, MSA_Assembly.SLDASM]
2025-01-26 Updated the radiator step files for the sim
    [Radiator_8x8.STEP, Radiator_8x9.STEP]
2025-01-27 Added hole to throttle pedal body
    [ThrottlePedalBody.SLDPRT]
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2025-01-28 various arms docs edits
    [steel_wishbone_insert_nfr25.SLDPRT, steel_wishbone_insert_nfr25_DWG.SLDDRW, steel_wishbone_jigging_block_nfr25.SLDPRT, steel_wishbone_jigging_plate_nfr25.SLDDRW, steel_wishbone_jigging_plate_nfr25.SLDPRT, wishbone_steel_front_upper_nfr25.SLDPRT]
2025-01-29 Updated right side panel stock
    [Right Side Panel Stock.SLDPRT, Right Side Panel Stock.STEP]
2025-01-29 sum shit who knows
    [93298A130_Medium-Strength Steel Nylon-Insert Flange Locknut.SLDPRT, Female_Maintenance_Plug_Assembly.SLDASM, Rear Mount Assy V2.SLDASM, Rear mount v2.SLDPRT, Side Mount Assy V3.SLDASM, Side mount v3.SLDPRT, TopCover.SLDPRT]
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2025-01-29 Fixed Local Bolts Issue and Rollback Issue
    [Rear_Mount_Assembly.SLDASM, Side_Accumulator_Mount.SLDPRT, Side_Chassis_Mount.SLDPRT, Side_Mount_Assembly.SLDASM]
2025-01-29 Mount name changes
    Missing components in bigger assemblies fixed
    [Side_Mount_Assembly.SLDASM]
2025-01-29 Updated Drawings
    Reflect BL single layer cross section
    [Rear mount container side SES Drawing.SLDDRW, Side mount container side SES drawing.SLDDRW, Side_Mount_Assembly.SLDASM]
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2025-01-29 Fixed wrong bolt
    [90409A137_High-Strength Grade 8 Steel Hex Head Screw.SLDPRT, 90409A138_High-Strength Grade 8 Steel Hex Head Screw.SLDPRT, Rear_Mount_Assembly.SLDASM]
2025-01-29 martinez fixed bolts
2025-01-29 Added shoulder harness tabs to restrict movement side to side for SES
    [New Rectangle Tab.SLDPRT, Seat Floor^_Chassis_Assembly_NFR25.SLDPRT, Shoulder Harness Tab.SLDPRT]
2025-01-30 added baseplate to full steering assembly
    [Total Baseplate.SLDASM, _Steering_Assembly_NFR25.SLDASM]
2025-01-30 DSA fixed in assembly
2025-01-30 Added updated brake pedal body
    [UpdatedBrakePedalBody.SLDPRT]
2025-01-30 Replaced old brake pedal body with new one
2025-01-30 update steering rack pillow block mount
    delete old part that was placeholder stock
    add new designed part
    replaced part in assembly w/proper mates, mirrored for both sides
    [NFR25 Rack Pillow Block Bottom V1.SLDPRT, NFR25 Rack Pillow Block Mount.SLDPRT, _Steering_Assembly_NFR25.SLDASM]
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2025-01-30 cell holder for characterization
    added folder in segments and added cell holder and assembly for cell characterization
    [NFR_22_molicell_21700_Version_2.0 (shucked, different top geometry).SLDPRT, cell char holder assembly.SLDASM, cell char holder.SLDPRT]
2025-01-30 Edited right mdm slightly
    [MDMount_NFR25-Right Mount.SLDPRT, MDMount_NFR25-Right Mount.STEP, MDMount_NFR25.SLDPRT]
2025-01-30 final updates on sus tab jigs
    [Mirrorback_lower_2(L).SLDPRT, Mirrorback_lower_2(L)_final_copy.STL, Mirrorback_upper_1(L).SLDPRT, Mirrorback_upper_1(L)_copy.STL, Mirrorfront_upper_1(L).SLDPRT, Mirrorfront_upper_1(L)_copy.STL, back_lower_2(L).SLDPRT, back_upper_1(L).SLDPRT]
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2025-01-31 active aero virtual rig
    [Active Aero Insert.SLDPRT, Active Aero Insert.STEP, Active Aero Virtual Rig.SLDASM, Active_Aero_Linkages.SLDPRT, Active_Aero_Mounting.SLDASM, NFR25_RearWing_Inserts.SLDPRT, NFR25_RearWing_Mounting.SLDASM, Rear_Wing_NFR25.SLDASM]
2025-01-31 steering jigging
    added steering jigging to the steering assembly
    [Ruland_us12-6-f.SLDASM, Steering Pillow Jig.SLDPRT, _Steering_Assembly_NFR25.SLDASM]
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2025-01-31 Changed inverter to passively cooled, exported step files for bystronic
    [DC+_Busbar_Inverter_NFR25.SLDPRT, DC-_Busbar_Inverter_NFR25.SLDPRT, ISB-300-A-802_current_transducer.SLDPRT, InverterBody.STEP, InverterLeftWall.STEP, InverterLid.STEP, InverterRightWall.STEP, Inverter_Cold_Plate_NFR25.SLDPRT]
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2025-01-31 fixed inverter tab
    [Inverter Tab.STEP]
2025-01-31 Initial changes to penthouse layout
    [HV_Penthouse_Mounting_Plate_NFR25.SLDPRT, LV_Penthouse_Mounting_Plate_NFR25.SLDPRT, PenthouseInternalWall.SLDPRT, Penthouse_Container.SLDASM, SegmentContainer.SLDASM, SegmentLid.SLDPRT, Voltage_Indicator_Board_NFR25.SLDPRT, iso175_IMD.SLDPRT]
2025-01-31 More changes to penthouse internals
    [HV_Penthouse_Mounting_Plate_NFR25.SLDPRT, LV_Penthouse_Mounting_Plate_NFR25.SLDPRT, PenthouseInternalWall.SLDPRT, Penthouse_Container.SLDASM, SegmentContainer.SLDASM, SegmentLid.SLDPRT, Southco-TL-40-111-52.sldasm]
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2025-01-31 updates sus tab jigs
    [Mirrorback_upper_1(L).SLDPRT, Mirrorfront_lower_1(L).SLDPRT, back_upper_1(L).SLDPRT, front_lower_1(L).SLDPRT]
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2025-02-01 Added fasteners, etc to penthouse and made other changes
    [90128A121_6-32-1875_Zinc-Plated Alloy Steel Socket Head Screw.SLDPRT, 90631A007_6-32 Nylon-Insert Locknut.SLDPRT, 91251A146_6-32-375_Black-Oxide Alloy Steel Socket Head Screw.SLDPRT, 92985A130_Splined Press-Fit Threaded Standoffs with Open End.SLDPRT, 93505A441_Male-Female Threaded Hex Standoff.SLDPRT, Energy_Meter_Busbar.SLDPRT, Energy_Meter_Busbar.STEP, HV_Penthouse_Mounting_Plate_NFR25.SLDPRT]
2025-02-01 Swapped out bms mainboard model
    [LV_Penthouse_Mounting_Plate_NFR25.SLDPRT]
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2025-02-01 Added fillets to throttle pedal body
    [ThrottlePedalBody.SLDPRT]
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2025-02-01 Changing screw hole size
    [94459A340_Heat-Set Inserts for Plastic.SLDPRT, Active_Aero_Mounting.SLDASM, NFR25_RearWing_Inserts.SLDPRT, NFR25_RearWing_Mounting.SLDASM, Rear_Wing_NFR25.SLDASM]
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2025-02-01 Adding holes for struct tubes
    [Active_Aero_Mounting.SLDASM, NFR25_RearWing_Inserts.SLDPRT, NFR25_RearWing_Mounting.SLDASM, Rear_Wing_NFR25.SLDASM, Structural Tube.SLDPRT]
2025-02-01 Added structural tubes and heat inserts to rear wing
    [Rear_Wing_NFR25.SLDASM, rw_struct_tube.SLDPRT]
2025-02-01 lv battery cell holder cad
    [lv_cell_holder.SLDPRT]
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2025-02-01 Lengthened bottom of killswitch mount
    [killswitch mount.SLDPRT]
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2025-02-01 maintenance plug cover slits added
    [FemaleMPBottomCover.SLDPRT, Female_Maintenance_Plug_Assembly.SLDASM, Female_Maintenance_Plug_Cover.SLDPRT, mp_cover_print.STL]
2025-02-01 spacer drawings for rear wing tabs
    [Left Side Panel After Cure.STEP]
2025-02-01 fix for structural tube
    [91255A027_Button Head Hex Drive Screw.SLDPRT, Front_Wing_Assembly.SLDASM, Structural Tube.SLDPRT]
2025-02-01 fixing the aero assembly
    [Front_Wing_Assembly.SLDASM, NFR25_Bodywork.SLDASM]
2025-02-02 Hid block model surfaces
    [MDMount_NFR25.SLDPRT]
2025-02-02 Suppressed jigs from steering assembly
    [Ruland_us12-6-f.SLDASM, _Steering_Assembly_NFR25.SLDASM]
2025-02-02 Oops suppressed the frame from steering as well
    [Ruland_us12-6-f.SLDASM, _Steering_Assembly_NFR25.SLDASM]
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2025-02-02 maintenance plug bottom cover changed
    [FemaleMPBottomCover.SLDPRT, Female_Maintenance_Plug_Assembly.SLDASM, mp_bottom_cover_print.STL]
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2025-02-03 Changes to MSA to change from 13 to 11 tooth sprocket
    [MSA Sleeve.SLDPRT, MSA Spacer.SLDPRT, MSA Sprocket_NFR25_version2.SLDPRT, MSA_Assembly.SLDASM]
2025-02-04 Create 0.25-28 2.25in Bolt.SLDPRT
    [0.25-28 2.25in Bolt.SLDPRT]
2025-02-04 stl files
    stl files for maintenance plug safety and cell holder
    [cell char holder.STL, safety_cap.STL, safety_cap_connected.STL]
2025-02-04 new steering jigging assembly
    [Jigging Assembly.SLDASM, Steering_Jigging_Assembly_NFR25.SLDASM, UpperSteeringCylinder.SLDPRT, _Steering_Assembly_NFR25.SLDASM, topadapterjigging.SLDPRT]
2025-02-04 added 2-force members to rear assembly
    [Rear_Front_Lower_Control_Arm_Assembly_NFR25.SLDASM, Rear_Rear_Lower_Control_Arm_Assembly_NFR25.SLDASM]
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2025-02-05 update active aero mounting thickness
    [Active_Aero_Mounting.SLDASM, Servo_Mount.SLDPRT]
2025-02-05 Update _Suspension_Skeleton_NFR25.SLDPRT
    updated rear upper pullrod point
    [_Suspension_Skeleton_NFR25.SLDPRT]
2025-02-05 mild changes to chassis stuff, brake light
    - Added chain guard to drivetrain assembly
    - Deleted fake aero tabs on top of rear bulkhead (that have made it into probably 20 screenshots I have taken of the CAD)
    - modeled brake light --> elec asm
    [_Chassis_Skeleton_NFR25.SLDPRT, _NFR25_Vehicle_Assembly.SLDASM, brake_light.SLDPRT, pedalbox_throttle.SLDASM, throttle_baseplate.SLDPRT, throttle_shaft.SLDPRT]
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2025-02-05 Added shutdown buttons, fully constrained brake light
    [Maintenance_Panel_NFR25.SLDPRT, Shutdown_Button_Mounting_Plate_NFR25.SLDPRT, Shutdown_Button_Switch.SLDPRT, Shutdown_Button_Twist_Part.SLDPRT, _Maintenance_Panel_Assembly_NFR25.SLDASM, brake_light.SLDPRT]
2025-02-06 Motor diff mount tab jigs
    [Mirrorback_lower_2(L).SLDPRT, Mirrorback_lower_3(L).SLDPRT, Mirrorback_upper_1(L).SLDPRT, Mirrorback_upper_3(L).SLDPRT, Mirrorfront_lower_1(L).SLDPRT, Mirrorfront_lower_2(L).SLDPRT, Mirrorfront_upper_1(L).SLDPRT, Mirrorfront_upper_2(L).SLDPRT]
2025-02-06 Added LV Battery Files
    [LV_Cell_Holder.SLDPRT, LV_Segment.SLDASM, Single_cell.SLDPRT]
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2025-02-06 Screws and nuts in rw mounting
    [91841A195_18-8 Stainless Steel Hex Nut.SLDPRT, 92949A271_18-8 Stainless Steel Button Head Hex Drive Screw.SLDPRT, 98189A130_A286 Stainless Steel Washer.SLDPRT, Aluminum Tabs.SLDPRT, NFR25_RearWing_Mounting.SLDASM, Rear_Wing_NFR25.SLDASM]
2025-02-06 Motor diff mount tab jigs updates
    [sus tab jigging assembly.SLDASM]
2025-02-06 maintenance plug safety
    changed wall thickness for 3d printing
    [safety_cap.SLDPRT, safety_cap_connected.SLDPRT]
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2025-02-08 Update rear wing jig
    [NFR25_RearWing_Jig.STL]
2025-02-08 Made final edits to inverter busbars for sendcut send, added GLVMS and TSMS cad models
    [Battery Disconnect Switch.SLDPRT, DC+_Busbar_Inverter_NFR25.SLDPRT, DC+_Busbar_Inverter_NFR25.STEP, DC-_Busbar_Inverter_NFR25.SLDPRT, DC-_Busbar_Inverter_NFR25.STEP, GLVMS Circle.SLDPRT, Inverter_Cold_Plate_NFR25.SLDPRT, Inverter_Cold_Plate_Spacer.STEP]
2025-02-08 CF cutouts for the side panels
    [Left Side Panel Back.DXF, Left Side Panel Front.DXF]
2025-02-08 Mirrored tabs for the undertray
    [Undertray Assembly NFR25.SLDASM, control_cable.SLDPRT]
2025-02-08 Suppressed busbar in penthouse lightweight config
    [Energy_Meter_Busbar.SLDPRT, PenthouseInternalWall.SLDPRT, Penthouse_Container.SLDASM, Southco-TL-40-111-52.sldasm]
2025-02-08 basically redid the cad correctly
    throttle side completely done, brake base done
    [4143N17_Rotary Shaft_machined.SLDPRT, 8mm shaft cutdown.SLDPRT, 92695A215_Alloy Steel Cone-Point Set Screws.SLDPRT, BrakePedal.SLDPRT, BrakePedal_corrected.SLDPRT, MaserCylinderShaft.SLDPRT, MiniBackBrakeSpacer.SLDPRT, PedalSpacer.SLDPRT]
2025-02-08 Added tabs for pump driver
    [Maintenance_Panel_NFR25.SLDPRT, Pump Driver Tab 1.SLDPRT, Pump Driver Tab 2.SLDPRT, Shutdown_Button_Mounting_Plate_NFR25.SLDPRT, _Maintenance_Panel_Assembly_NFR25.SLDASM]
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2025-02-08 saving motor diff mount tab jigs stls
    [Part31^sus tab jigging assembly.SLDPRT, left lower.SLDPRT, left lower.STL, left upper.STL, mirror lower.SLDPRT, mirror lower.STL, mirror upper.SLDPRT, mirror upper.STL]
2025-02-08 uprights fea in progress
    [0.25-28 1.375in Bolt 91257A112.SLDPRT, 0.25-28 1.5in Bolt 91257A566.SLDPRT, FRONT ROTOR FINAL.SLDPRT, Front Uprights Assembly.SLDASM, Front_Uprights_NFR25.SLDPRT]
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2025-02-08 safety cap and cell characterization
    changes and stl files
    [cell char base plate.SLDPRT, cell char base plate.STL, cell char holder assembly.SLDASM, cell char holder.SLDPRT, cell char holder.STL, safety_cap.3mf, safety_cap.STL, safety_cap_connected.STL]
2025-02-08 LV battery bolt progress
    [LV_Cell_Holder.SLDPRT, LV_Segment.SLDASM]
2025-02-08 Added holes to throttle pedal face
    [Throttle Pedal Mockup.SLDPRT]
2025-02-08 Added holes for screws to throttle pedal face
    [Throttle Pedal Mockup.SLDPRT]
2025-02-08 Create bottom left and right rear wing jigs
    [NFR25_RearWing_Jig.STL, NFR25_RearWing_Jig_BottomL.STL, NFR25_RearWing_Jig_BottomR.STL]
2025-02-08 adding hardware to the front wing assembly
    [90128A944_Zinc-Plated Alloy Steel Socket Head Screw.SLDPRT, 90631A411_Low-Strength Steel Nylon-Insert Locknut.SLDPRT, 91251A342_Black-Oxide Alloy Steel Socket Head Screw.SLDPRT, 98019A226_18-8 Stainless Steel Mil. Spec. Washer.SLDPRT, Front_Wing_Assembly.SLDASM, NFR25_Bodywork.SLDASM, Undertray Assembly NFR25.SLDASM, Whisker.SLDPRT]
2025-02-09 Adding hardware to the rear wing assembly
    [6338K413_Oil-Embedded Flanged Sleeve Bearing.SLDPRT, 91251A347_Black-Oxide Alloy Steel Socket Head Screw.SLDPRT, 94361A114_Short-Thread Alloy Steel Shoulder Screw.SLDPRT, Active_Aero_Linkages.SLDPRT, Active_Aero_Mounting.SLDASM, Carbon tube assembly.SLDASM, NFR25_RearWing_Inserts.SLDPRT, NFR25_RearWing_Mounting.SLDASM]
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2025-02-09 assembly update
    added attachment + display to assembly
    [Board v1 draft.SLDPRT, Dashbox assembly.SLDASM, Dashbox.SLDPRT, board box attachement.SLDPRT, display screen.SLDPRT]
2025-02-09 step file for 3D printer
    [display screen.STEP]
2025-02-09 Rear antiroll bar is finally there
    [ARB_Assembly_Rear_NFR25.SLDASM, Rear_arb_bearing_6338K123_Oil-Embedded 841 Bronze Flanged Sleeve Bearing.SLDPRT, Rear_arb_slot.SLDPRT, Rear_arb_tab.SLDPRT, Rear_arb_tab_longer_screw_91251A149_Black-Oxide Alloy Steel Socket Head Screw.SLDPRT, Rear_arb_torsion_bar_89955K299.SLDPRT, Rear_arb_torsion_lever_adapter.SLDPRT, Rear_arb_upper_tab.SLDPRT]
2025-02-09 Manually merged changes in pedalbox assembly
    [9271K903_Torsion Spring (1).SLDPRT, 9271K908_Torsion Spring.SLDPRT, 9271K908_Torsion Spring_sketched.SLDPRT, Bent Sheet Metal Estop Mount.SLDPRT, BrakePedal_corrected.SLDPRT, MaserCylinderShaft.SLDPRT, MiniBackBrakeSpacer.SLDPRT]
2025-02-09 Springs on throttle side and small changes w/ brake side mating
    [9271K903_Torsion Spring_sketched.SLDPRT, 9271K908_Torsion Spring_sketched.SLDPRT, BrakePedal_corrected.SLDPRT]
2025-02-09 Added spacers, remade killswitch mount, some changes in brake pedal cad
    [Bent Sheet Metal Estop Mount.SLDPRT, BrakePedal_corrected.SLDPRT, FrontBrakeSpacer.SLDPRT, PedalSpacer.SLDPRT, ThrottlePedal_corrected.SLDPRT, UpdatedBrakePedalBody.SLDPRT]
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2025-02-09 Fixed tabs on the rear anti-roll bar
    [ARB_Assembly_Rear_NFR25.SLDASM, Rear_arb_upper_tab.SLDPRT, _Chassis_Skeleton_NFR25.SLDPRT]
2025-02-09 Created the bodywork tab
    [Bodywork Tab.SLDPRT]
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2025-02-09 Fixed the rear wing and undertray
    [94035A182_18-8 Stainless Steel Precision Shoulder Screw.SLDPRT, 94035A183_18-8 Stainless Steel Precision Shoulder Screw.SLDPRT, 94035A539_18-8 Stainless Steel Precision Shoulder Screw.SLDPRT, Active_Aero_Linkages.SLDPRT, Active_Aero_Mounting.SLDASM, NFR25_RearWing_Inserts.SLDPRT, NFR25_RearWing_Mounting.SLDASM, Undertray Assembly NFR25.SLDASM]
2025-02-09 Update swan neck jig
    [NFR25_RearWing_Jig_SwanNeck.STL]
2025-02-10 Added hardware to the rear wing
    [6338K413_Oil-Embedded Flanged Sleeve Bearing.SLDPRT, 91090A105_Zinc-Plated Steel Oversized Washer.SLDPRT, 91251A347_Black-Oxide Alloy Steel Socket Head Screw.SLDPRT, 92620A563_Zinc Yellow-Chromate Plated Hex Head Screw.SLDPRT, 92620A565_Zinc Yellow-Chromate Plated Hex Head Screw.SLDPRT, 92620A701_Zinc Yellow-Chromate Plated Hex Head Screw.SLDPRT, 94035A539_18-8 Stainless Steel Precision Shoulder 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]
2025-02-10 Did some stuff to fix massive file sizes
    [FrontHub_NFR25.SLDPRT, Front_Lower_Arm_Assembly_NFR25.SLDASM, Front_Pull_Rod_Assembly_NFR25.SLDASM, Front_Tie_Rod_Assembly_NFR25.SLDASM, Front_Upper_Arm_Assembly_NFR25.SLDASM, Rear_Front_Lower_Control_Arm_Assembly_NFR25.SLDASM, Rear_Rear_Lower_Control_Arm_Assembly_NFR25.SLDASM, Rear_Tie_Rod_Assembly_NFR25.SLDASM]
2025-02-10 Added tabs for rear daq, updated inverter heat sink
    [Inverter_Cold_Plate_NFR25.SLDPRT, Maintenance_Panel_NFR25.SLDPRT, Shutdown_Button_Mounting_Plate_NFR25.SLDPRT, Standard 1in Tab.SLDPRT, _Maintenance_Panel_Assembly_NFR25.SLDASM]
2025-02-10 Adjusted top face to account for cover
    [LV_Cell_Holder.SLDPRT]
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2025-02-11 new mounts jig concept
    [Jig assembly.SLDASM, Mount Jig Bar.SLDPRT]
2025-02-11 Update ID and OD of carbon tube and inserts
    [Carbon tube assembly.SLDASM, Carbon tube.SLDPRT, Insert.SLDPRT, NFR25_RearWing_Mounting.SLDASM]
2025-02-11 Added additional material to throttle pedal arm
    [ThrottlePedalArm_Corrected.SLDPRT]
2025-02-11 updated the rear wing insert
    [Insert.SLDDRW, Insert.SLDPRT, Top Tabs Spacer.SLDDRW]
2025-02-11 arms stuff my bad for messing everything up sorry everbody
    [Front_Lower_Arm_Assembly_NFR25.SLDASM, Front_Pull_Rod_Assembly_NFR25.SLDASM, Front_Tie_Rod_Assembly_NFR25.SLDASM, Front_Upper_Arm_Assembly_NFR25.SLDASM, Rear_Front_Lower_Control_Arm_Assembly_NFR25.SLDASM, Rear_Pullrod_Assembly_NFR25.SLDASM, Rear_Rear_Lower_Control_Arm_Assembly_NFR25.SLDASM, Rear_Tie_Rod_Assembly_NFR25.SLDASM]
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2025-02-12 Create endplate_mold.SLDPRT
    Endplate mold created
    [endplate_mold.SLDPRT]
2025-02-12 Added new current sensor to penthouse assembly
    [Energy_Meter_Busbar.SLDPRT, PenthouseInternalWall.SLDPRT, Penthouse_Container.SLDASM, Safety Status Indicator.SLDPRT]
2025-02-12 updated the front wing assembly
    [92562A143_Mil. Spec. Alloy Steel Socket Head Screw.SLDPRT, Front_Wing_Assembly.SLDASM]
2025-02-12 Added bms to LV Battery
    [LV_Cell_Cover.SLDPRT, LV_Cell_Holder.SLDPRT, LV_Cell_Holder_Bottom.SLDPRT, LV_Cell_Holder_Top.SLDPRT, LV_Segment.SLDASM, bms_block.SLDPRT]
2025-02-12 Adjusted LV Battery Segment
    [LV_Cell_Cover.SLDPRT, LV_Segment.SLDASM]
2025-02-13 Rebuilt cooling fluid splitter
    [5_Way_Splitter_2.0.SLDPRT, 5_Way_Splitter_2.0.STEP, 5waysplitter11.2.SLDPRT]
2025-02-13 Rockers tabs dxf files
    [Front-Front Rockers Tab.DXF, Front-Rear Rockers Tab.DXF, Rear-Front Rockers Tab.DXF, Rear-Rear-Rocker Tabs.DXF]
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2025-02-13 Added LV BMS mounts
    [LV_Cell_BMS_Mount.SLDPRT, LV_Cell_Holder_Bottom.SLDPRT, LV_Cell_Holder_Top.SLDPRT, LV_Segment.SLDASM]
2025-02-13 rocker tabs into sus tab assembly
    [0.25-28 2.0 in Bolt 91257A566.SLDPRT, Female 0.25-28 Rod end.SLDPRT, Front Rockers.SLDPRT, Rockers Tabs Assembly.SLDASM]
2025-02-13 heat insert for LV battery
    [4-40_Tapered Heat-Set Inserts for Plastic.SLDPRT, 6-32_Tapered Heat-Set Inserts for Plastic.SLDPRT, 93365A154_Tapered Heat-Set Inserts for Plastic.SLDPRT, LV_Cell_Holder_Bottom.SLDPRT, LV_Cell_Holder_Top.SLDPRT, LV_Segment.SLDASM]
2025-02-13 RW D-ring for tension cables
    [3076T35_800 lbs. Capacity Zinc Plated Steel Tie-Down Ring.SLDPRT, 33815T41_Tie-Down Ring.SLDPRT, Aluminum Tabs.SLDPRT, Cable_Pulley_Tabs.SLDPRT, Carbon tube assembly.SLDASM, Carbon tube.SLDPRT, NFR25_RearWing_Mounting.SLDASM]
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2025-02-13 Updated parts for FEA friendliness, more hardware
    Made clevis narrower to eliminate 0-thickness solid from contact with upright
    Hardware to attach clevis to upright
    All work is Yassine's/others, just uploading for the sync
    [91257A112_Zinc Yellow-Chromate Plated Hex Head Screw.SLDPRT, 99291A220_Top-Lock Distorted-Thread Locknut.SLDPRT, Front Uprights Assembly.SLDASM, front Upright clevis NFR25.SLDPRT]
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2025-02-13 changing servo mount to sheet metal
    [Active_Aero_Mounting.SLDASM, Carbon tube assembly.SLDASM, Carbon tube.SLDPRT, NFR25_RearWing_Mounting.SLDASM, Servo_Mount.SLDPRT]
2025-02-13 fix assembly errors
    [Active_Aero_Mounting.SLDASM, Carbon tube assembly.SLDASM, Carbon tube.SLDPRT, Front_Wing_Assembly.SLDASM, Insert.SLDPRT, NFR25_Bodywork.SLDASM, NFR25_RearWing_Mounting.SLDASM, Undertray Assembly NFR25.SLDASM]
2025-02-14 adjusting safety cap dims
    [safety_cap.3mf, safety_cap.SLDPRT, safety_cap.STL, safety_cap_connected.SLDPRT, safety_cap_connected.STL]
2025-02-14 Updated LV Cell Cover
    [LV_Cell_Cover.SLDPRT, LV_Cell_Holder_Bottom.SLDPRT, LV_Cell_Holder_Top.SLDPRT, LV_Segment.SLDASM]
2025-02-14 Broke references in rockers tabs to reduce rebuild times
    Also added shutdown button for dashboard
    [Dashboard Estop.SLDPRT]
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2025-02-15 rocker tab jigging updates
    [rocker tab jig front A.SLDPRT, rocker tab jig front A.STL, rocker tab jig front left.SLDPRT, rocker tab jig front left.STL]
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2025-02-15 created PDM block model
    [PDM block model.SLDPRT]
2025-02-15 LV model cell holder
    [LV model cell holder.SLDPRT, LV model cell holder.STL]
2025-02-15 LV cell holder test
    [LV model cell holder.3mf, safety_cap.3mf]
2025-02-15 Update LV model cell holder.3mf
    [LV model cell holder.3mf]
2025-02-15 Update LV model cell holder.SLDPRT
    [LV model cell holder.SLDPRT]
2025-02-15 Changed top LV cell holder
    [4-40_Tapered Heat-Set Inserts for Plastic.SLDPRT, 6-32_Tapered Heat-Set Inserts for Plastic.SLDPRT, LV_Cell_Cover.SLDPRT, LV_Cell_Holder_Top.SLDPRT, LV_Segment.SLDASM, PDM block model.SLDPRT]
2025-02-15 created front wing tab jigs
    [frontwing_tab_jig.SLDPRT]
2025-02-15 Revert "Merge branch 'main' of https://github.com/bsobeloffgittes/NFR25-CAD"
    This reverts commit bcb8cd8da11e0d2c13c30b4e8f693ca1c636af95, reversing
    changes made to 3e420e0ffe1d46874f23179e24fa65f3bbc74e13.
    [4-40_Tapered Heat-Set Inserts for Plastic.SLDPRT, 6-32_Tapered Heat-Set Inserts for Plastic.SLDPRT, LV model cell holder.3mf, LV model cell holder.SLDPRT, LV model cell holder.STL, LV_Cell_Cover.SLDPRT, LV_Cell_Holder_Top.SLDPRT, LV_Segment.SLDASM]
2025-02-15 Fixed Rear ARB (hopefully)
    [ARB_Assembly_Rear_NFR25.SLDASM, Rear_arb_tab.SLDPRT, Rear_arb_torsion_bar_89955K299.SLDPRT, Rear_arb_upper_tab.SLDPRT]
2025-02-15 arms parts updates
    added rear steel arm cad
    [wishbone_end_front_lower_nfr25.SLDPRT, wishbone_steel_front_upper_nfr25.SLDPRT, wishbone_steel_rear_upper_nfr25.SLDPRT]
2025-02-15 rocker tab jigs final updates
    [rocker tab jig back A.SLDPRT, rocker tab jig back A.STL, rocker tab jig back left.SLDPRT, rocker tab jig back left.STL, rocker tab jig front A.SLDPRT, rocker tab jig front A_v2.STL, rocker tab jig front left.SLDPRT, rocker tab jig front left_v2.STL]
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2025-02-15 Changed LV Cell Holder Bottom
    [4-40_Tapered Heat-Set Inserts for Plastic.SLDPRT, 6-32_Tapered Heat-Set Inserts for Plastic.SLDPRT, LV_Cell_Cover.SLDPRT, LV_Cell_Cover_Top.SLDPRT, LV_Cell_Holder_Bottom.SLDPRT]
2025-02-15 Updated LV Cell Assembly
    [LV_Segment.SLDASM]
2025-02-16 LV Holder Top connection slots
    [LV_Cell_Cover_Top.SLDPRT, LV_Cell_Holder_Bottom.SLDPRT, LV_Cell_Holder_Top.SLDPRT, LV_Segment.SLDASM, PDM_block.SLDPRT]
2025-02-16 Added LV bolts and BMS brackets
    [91280A278_Medium-Strength Class 8.8 Steel Hex Head Screw.SLDPRT, LV_Cell_BMS_Mount.SLDPRT, LV_Cell_Cover_Bottom.SLDPRT, LV_Cell_Cover_Top.SLDPRT, LV_Cell_Holder_Bottom.SLDPRT, LV_Cell_Holder_Top.SLDPRT, LV_Segment.SLDASM]
2025-02-16 make aero look cool
    [92562A143_Mil. Spec. Alloy Steel Socket Head Screw.SLDPRT, Front_Wing_Assembly.SLDASM, NFR25_RearWing_DONOTCHANGEhigh_aoa.SLDPRT, NFR25_RearWing_Inserts.SLDPRT, NFR25_RearWing_Mounting.SLDASM, NFR_25_FrontWing_V2 (drew).SLDPRT, TopFoilInsert.SLDPRT, Undertray_V10.SLDPRT]
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2025-02-17 Added brake light tab, adjusted maintenance panel
    [72913-0_Banana_Jack_Black.SLDPRT, Brake Light Tab.SLDPRT, Maintenance_Panel_NFR25.SLDPRT, _Maintenance_Panel_Assembly_NFR25.SLDASM, brake_light.SLDPRT]
2025-02-17 FEA testing on throttle pedal arm
    [ThrottlePedalArm_Corrected.SLDPRT]
2025-02-18 Updated boards to new version in penthouse, added tscb
    [HV_Penthouse_Mounting_Plate_NFR25.SLDPRT, LV_Penthouse_Mounting_Plate_NFR25.SLDPRT, TSCB_NFR25.SLDPRT, TSCB_NFR25.step]
2025-02-18 fixed brake pedal ratio + pos stop, FEA on throttle side
    [Bent Sheet Metal Estop Mount.SLDPRT, BrakePedal_corrected.SLDPRT, ThrottlePedal_corrected.SLDPRT, UpdatedBrakePedalBody.SLDPRT]
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2025-02-18 fixed mate controller for brake side
    [BackBrakeSpacer.SLDPRT, BrakePedal_corrected.SLDPRT]
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2025-02-19 fixed front wing insert
    [Front_Wing_Assembly.SLDASM, MidFoilInsert.SLDPRT, NFR_25_FrontWing_V2 (drew).SLDPRT]
2025-02-19 wind tunnel stuff - ginger
    [Sides.SLDPRT, Top & bottom.SLDPRT, Wind Tunnel Assembly.SLDASM, wind_tunnel (2).SLDPRT]
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2025-02-19 Added ring terminals to LV segment
    [7113K202_Ring Terminals.SLDPRT, 91280A174_Medium-Strength Class 8.8 Steel Hex Head Screw.SLDPRT, Box_Thickness_Test.SLDPRT, LV_Cell_BMS_Mount.SLDPRT, LV_Cell_Cover_Bottom.SLDPRT, LV_Cell_Cover_Top.SLDPRT, LV_Cell_Holder_Bottom.SLDPRT, LV_Cell_Holder_Top.SLDPRT]
2025-02-20 3d printed inserts stl creation
    [FW_MF_Insert.STL, FW_SF_Insert.STL, FW_TF_Insert.STL, RW_MF_Insert.STL, RW_SF_Insert.STL, TopFoilInsert.SLDPRT, endplate_mold.SLDPRT]
2025-02-20 rw aluminum tab drawings
    [Aluminum Tabs For Drawing.SLDDRW, Aluminum Tabs For Drawing.SLDPRT, Aluminum Tabs.STEP]
2025-02-20 Update Aluminum Tabs For Drawing.SLDDRW
    [Aluminum Tabs For Drawing.SLDDRW]
2025-02-20 Updated LV Top Holder
    [91290A362_Alloy Steel Socket Head Screw.SLDPRT, 92220A121_Alloy Steel Low-Profile Socket Head Screw.SLDPRT, LV_Cell_BMS_Mount.SLDPRT, LV_Cell_Cover_Bottom.SLDPRT, LV_Cell_Cover_Top.SLDPRT, LV_Cell_Holder_Top.SLDPRT, LV_Segment.SLDASM]
2025-02-20 Updated LV Battery hardware
    [92220A142_Alloy Steel Low-Profile Socket Head Screw.SLDPRT, Box_Thickness_Test.SLDPRT, LV_Cell_BMS_Mount.SLDPRT, LV_Cell_Cover_Bottom.SLDPRT, LV_Cell_Cover_Top.SLDPRT, LV_Cell_Holder_Bottom.SLDPRT, LV_Cell_Holder_Top.SLDPRT]
2025-02-21 Changed jackbar mount holes to match what was water jetted
    [Jackbar_Mount.SLDPRT, MDMount_NFR25.SLDPRT]
2025-02-21 CFD block model fix
    [CFD_Block_Model_NFR25_v10.STEP]
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2025-02-21 updated the block model
    [CFD_Block_Model_NFR25_v11.STEP]
2025-02-22 Added new ARB geo, updated penthouse
    [HSC100S6K8J_Precharge_Resistor.SLDPRT, HV_Penthouse_Mounting_Plate_NFR25.SLDPRT, Lower_Rear_ARB_Assembly_NFR25.SLDASM, PenthouseInternalWall.SLDPRT, Penthouse_Container.SLDASM, Rear_ARB_Geometry_NFR25.SLDPRT]
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2025-02-22 Moved pump to other side of car and added tabs
    [Inverter_Cold_Plate_NFR25.SLDPRT, Maintenance_Panel_NFR25.SLDPRT, Pump Driver Tab 1.SLDPRT, Pump Driver Tab 2.SLDPRT, Pump Tab Lower.SLDPRT, Pump Tab Upper.SLDPRT, _Maintenance_Panel_Assembly_NFR25.SLDASM]
2025-02-22 Updated Cell Holder wire channels
    [LV_Cell_BMS_Mount.SLDPRT, LV_Cell_Bolt_Sheath.SLDPRT, LV_Cell_Cover_Bottom.SLDPRT, LV_Cell_Cover_Top.SLDPRT, LV_Cell_Holder_Bottom.SLDPRT, LV_Cell_Holder_Top.SLDPRT]
2025-02-22 new flange bearings, updated brake side and fea
    [4143N17_Rotary Shaft_machined.SLDPRT, 7119N124_Ultra-Low-Friction Oil-Embedded Sleeve Bearing.SLDPRT, 8mm shaft cutdown.SLDPRT, Bent Sheet Metal Estop Mount.SLDPRT, BrakePedal_corrected.SLDPRT, MaserCylinderShaft.SLDPRT, MiniBackBrakeSpacer.SLDPRT, MiniBackBrakeSpacerLeft.SLDPRT]
2025-02-23 Updated to new version of VI board in penthouse
    [HV_Penthouse_Mounting_Plate_NFR25.SLDPRT, PenthouseInternalWall.SLDPRT, Penthouse_Container.SLDASM]
2025-02-25 front wing main foil mold
    [Front_Wing_Main_Foil.STEP, Front_Wing_Main_Foil_Mold.SLDPRT, Front_Wing_Main_Foil_Mold.STEP, Front_Wing_Molds.SLDPRT, NFR_25_FrontWing_V2 (drew).SLDPRT]
2025-02-26 Constrain bar laterally, removed unnecessary hardware
    [ARB_Assembly_Front_NFR25.SLDASM, Front_arb_lower_tab.SLDPRT, Front_arb_small_bar_89955K479.SLDPRT, Front_arb_torsion_bar_89955K299.SLDPRT, Front_arb_upper_tab.SLDPRT]
2025-02-26 Fixed mates for mount to play nice with tubing
    😸
    [ARB_Assembly_Front_NFR25.SLDASM]
2025-02-26 created test LV battery cell holder
    Please do not delete this file
    [LV test battery holder (do not delete).SLDPRT]
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2025-02-26 test battery cell holder
    updated dims and created test assembly to check fit
    [LV test battery holder (do not delete).SLDPRT, Test LV battery assembly.SLDASM]
2025-02-27 wind tunnel cut outs
    [Sides.SLDPRT, Top & bottom.SLDPRT, Wind Tunnel Assembly.SLDASM]
2025-02-27 Updated LV to fit BMS
    [LV_Cell_BMS_Mount.SLDPRT, LV_Cell_Bolt_Sheath.SLDPRT, LV_Cell_Cover_Bottom.SLDPRT, LV_Cell_Cover_Top.SLDPRT, LV_Cell_Holder_Bottom.SLDPRT, LV_Cell_Holder_Top.SLDPRT, bms_block.SLDPRT]
2025-02-27 Updated top LV cell holder
    [LV_Cell_Bolt_Sheath.SLDPRT, LV_Cell_Cover_Top.SLDPRT, LV_Cell_Holder_Top.SLDPRT]
2025-02-27 test cell holder
    updated dims, added lower lip, added critical ergonomic grip to improve critical dexterous and efficiency concerns
    [LV test battery holder (do not delete).SLDPRT, LV test battery holder (do not delete).STL]
2025-02-27 fixing cfd block model
    [CFD_Block_Model_NFR25_v14.STEP, NFR_25_FrontWing_Top_Mount.STEP, NFR_25_FrontWing_V2 (drew).STEP]
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2025-02-28 Updated LV BMS mount and wires
    [LV_BMS_Mount.SLDPRT, LV_Cell_BMS_Mount.SLDPRT, LV_Cell_Bolt_Sheath.SLDPRT, LV_Cell_Cover_Bottom.SLDPRT, LV_Cell_Cover_Top.SLDPRT, LV_Cell_Holder_Bottom.SLDPRT, LV_Cell_Holder_Top.SLDPRT]
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2025-03-01 spacer changes adn drawings
    [8mm shaft cutdown.SLDDRW, 8mm shaft cutdown.SLDPRT, BackBrakeSpacer.SLDDRW, PedalSpacer.SLDPRT, PedalSpacerShortened.SLDPRT, SpringHolder.SLDDRW, ThrottlePedal_corrected_3_1_25.SLDDRW, ThrottleSpacer.SLDPRT]
2025-03-01 created frame with steering and arb
    [Frame + Steering Assembly.SLDASM, Steering_Jigging_Assembly_NFR25.SLDASM, _Steering_Assembly_NFR25.SLDASM]
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2025-03-01 Beginnings of new front ARB
    [New_7815K28_Multipurpose_Flanged_Sleeve_Bearing.SLDPRT, New_90044A132_Black-Oxide_Alloy_Steel_Socket_Head_Screw.SLDPRT, New_Front_ARB.SLDASM, New_Front_ARBMount.SLDPRT, New_Front_ARB_FrameMount.SLDPRT]
2025-03-02 drawings updated so they r legible
    [SpringHolder.SLDDRW]
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2025-03-02 Further Developed New Front ARB Assembly
    Added other side ARB mount, Added tension bar, and created/added steel inserts to assembly.
    [New_Front_ARB.SLDASM, New_Front_ARB_Steel_Inster.SLDPRT]
2025-03-03 Put New Front ARB files in New_Front_ARB folder, updated front arb assembly
    Front ARB assembly: added aluminum sleeve, end bolts, and delrin spacer
    [92620A567_Zinc Yellow-Chromate Plated Hex Head Screw.SLDPRT, New_7815K28_Multipurpose_Flanged_Sleeve_Bearing.SLDPRT, New_90044A132_Black-Oxide_Alloy_Steel_Socket_Head_Screw.SLDPRT, New_Front_ARB.SLDASM, New_Front_ARBMount.SLDPRT, New_Front_ARB_Delrin_Spacer.SLDPRT, New_Front_ARB_FrameMount.SLDPRT, New_Front_ARB_Sleeve.SLDPRT]
2025-03-03 added new part for mounting jackbar for welding
    [Jack_Bar.SLDPRT, MDMount_NFR25.SLDPRT]
2025-03-03 putting in the CoP😁
    [Active_Aero_Linkages.SLDPRT, Active_Aero_Mounting.SLDASM, Front_Wing_Assembly.SLDASM, NFR25_RearWing_Mounting.SLDASM, TopFoilInsert.SLDPRT]
2025-03-03 Copied files for tabs manufacturing, fixed floor tabs, fixed broken pedalbox mate
    [15X---Standard 1in Tab.SLDPRT, 1X---Brake Light Tab.SLDPRT, 1X---Maintenance_Panel_NFR25.SLDPRT, 1X---Pump Tab Lower.SLDPRT, 1X---Pump Tab Upper.SLDPRT, 2X---Front Floor Front Tab NFR25.SLDPRT, 2X---Front Floor Rear Tab NFR25.SLDPRT, 2X---Main Floor Front Tab NFR25.SLDPRT]
2025-03-03 steel front wishbone
    new cad
    [wishbone_steel_front_upper_nfr25.SLDPRT]
2025-03-03 added rear steel wishbone
    rear steel wishbone [NOTE: USE V2 VERSION]
    [wishbone_steel_rear_upper_V2_nfr25.SLDPRT]
2025-03-04 fixed the undertray
    [Undertray Assembly NFR25.SLDASM, control_cable.SLDPRT]
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2025-03-05 Added upper wishbones to sus assemblies and mirrored sus properly
    [Front_Lower_Arm_Assembly_NFR25.SLDASM, Front_Pull_Rod_Assembly_NFR25.SLDASM, Front_Tie_Rod_Assembly_NFR25.SLDASM, Front_Upper_Arm_Assembly_NFR25.SLDASM, Front_Uprights_NFR25.SLDPRT, MirrorWilwood_GP200.SLDASM, Ohlins TTX25 MkII FSAE Shock Assembly.SLDASM, Rear Rockers V3.SLDPRT]
2025-03-05 Further ARB refinements
    Made tapering lever, added d-shaft, mount that prevents bolt from turning
    [New_Front_ARBMount.SLDPRT, New_Front_ARB_Lever.SLDPRT, New_Front_ARB_Steel_Inster.SLDPRT]
2025-03-05 Increased thickness of sleeve
    [New_Front_ARB_Sleeve.SLDPRT]
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2025-03-06 endplate mold step files created
    [endplate_mold.STEP, endplate_mold_stock.SLDPRT, endplate_mold_stock.STEP]
2025-03-06 Revert "Merge branch 'main' of https://github.com/bsobeloffgittes/NFR25-CAD"
    This reverts commit fc1585adf71e3e3786f5f8dc817b8af900147a09, reversing
    changes made to 78455a7d1220eeeb44f5e3dcd07402bf985cfde0.
2025-03-06 created endplate mold assembly
    [NFR_25_FrontWing_V2 (drew).SLDPRT, endplate_mold.SLDPRT, endplate_route_mold.SLDASM, endplate_route_mold.STEP]
2025-03-06 Made ARB assembly part of old one, added end links
    💯 💠
    [AF-3.SLDPRT]
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2025-03-06 Create Radiator mount.SLDPRT
    radiator mount initial design
    [Radiator mount.SLDPRT]
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2025-03-06 dxfs for the wings
    [Aluminum Tabs For Drawing.SLDDRW, Front_Wing_SF.dxf, Front_Wing_TF.DXF, Front_wing_MF.dxf, Rear_Wing_MF.DXF, Rear_Wing_SF.DXF]
2025-03-06 changes to arb assembly
    [AM-3 Motion.SLDASM, AM-3 Spherical.SLDPRT, AM-3.SLDPRT, Left Mount.SLDASM, Right Mount.SLDASM]
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2025-03-08 Changed holes on throttle pedal face
    [Throttle Pedal Mockup.SLDPRT]
2025-03-08 Updated LV BMS Mount
    [LV_BMS_Mount.SLDPRT]
2025-03-08 add lid and bolt hole to the sheet metal lv battery box
    [LV_battery_container.SLDPRT, LV_container_with_Lid.SLDASM, lid.SLDPRT]
2025-03-08 Charger enclosure project
    Created elementary model for charger enclosure and imported all molex and amphenol interlocks/plugs, and created charger block model and assembly
    [Charger enclosure.SLDPRT, ELRA2Z03.SLDPRT, Elcon HK-J-H650-12 block model.SLDPRT, Enclosure assembly.SLDASM, HVSL362022A.SLDPRT, Molex 348302001.SLDPRT]
2025-03-09 created spacer for mdm
    [Spacer for MDM.SLDPRT]
2025-03-10 Added chain and motor guard tabs, fixed rebuild errors
    [2X---Chain Guard Tab.SLDPRT, 2X---Motor Guard Tab.SLDPRT, Chain Guard Tab.SLDPRT, Chain Guard.SLDPRT, Jack_Bar.SLDPRT, MSA Sprocket_NFR25_version2.SLDPRT, Motor Guard Tab.SLDPRT, Motor Guard.SLDPRT]
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2025-03-11 Added tabs for swirlpot, added catch can
    [3X---Swirlpot_Tab_NFR25.SLDPRT, Catch_Can_NFR25.SLDPRT, Swirlpot.SLDPRT, Swirlpot_Tab_NFR25.SLDPRT, _Chassis_Skeleton_NFR25.SLDPRT]
2025-03-11 Standard tabs added to Chassis assembly for dashboard placement
    [MDMount_NFR25.SLDPRT, Seat Floor^_Chassis_Assembly_NFR25.SLDPRT, Standard Tab.SLDPRT]
2025-03-11 updated the cfd model
    [CFD_Block_Model_NFR25_v15.STEP]
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2025-03-11 lv battery connector added
    [1823444-2_LV_main_connector.SLDPRT, 95105A135_Zinc-Plated Steel Heavy-Duty Rivet Nut.SLDPRT, LV_battery_container.SLDPRT]
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2025-03-12 moving files
    sorry for multiple commits
    [Molex 348302001.SLDPRT]
2025-03-12 Changed tssi/rml tabs, fixed broken chassis assem mates
    [2X---TSSI, RML Tabs.SLDPRT, TSSI, RML Tabs.SLDPRT]
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2025-03-13 Fixed LV battery position
    [_Chassis_Skeleton_NFR25.SLDPRT]
2025-03-13 Fixed catch can mates
    [MDMount_NFR25.SLDPRT, MSA_Assembly.SLDASM]
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2025-03-13 made assembly and dxf of 0.25 tabs
    [0.25 tabs assem.DXF, 0.25 tabs assem.SLDASM]
2025-03-13 Added fuse holders to penthouse
    [01500603Z_fuse_holder.SLDPRT, PenthouseInternalWall.SLDPRT]
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2025-03-13 Charger enclosure stuff
    added plugs and changed shape, will add standoffs/spacers later
    [9546K548_Neoprene Bumper.SLDPRT, Charger enclosure.SLDPRT, Elcon HK-J-H650-12 block model.SLDPRT, Enclosure assembly.SLDASM]
2025-03-13 Update Active Aero Virtual Rig.SLDASM
    [Active Aero Virtual Rig.SLDASM]
2025-03-13 Add rear ARB tabs, update front ARB lever arm thickness
    .1" thickness ->> to actual thickness we have .125"
    [New_Front_ARB_Lever.SLDPRT, New_Rear_ARB_Tab.SLDPRT]
2025-03-13 Shoutout solidworks crash
    lost a bunch of stuff
    [91075A468_Male-Female Threaded Hex Standoff.SLDPRT]
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2025-03-13 made assembly and dxf for pt1 of 0.0625 tabs
    [0.0625 tabs pt1.DXF, 0.0625 tabs pt1.SLDASM]
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2025-03-13 Added radiator to electrical assembly, fixed broken accum assembly lightweight config
    [PenthouseInternalWall.SLDPRT, Penthouse_Container.SLDASM, SegmentContainer.SLDASM, SegmentLid.SLDPRT]
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2025-03-14 created 0.0625 tabs pt2 assem
    [0.0625 tabs pt2.SLDASM]
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2025-03-15 endplate + undertray tab
    [Carbon tube assembly.SLDASM, Nosecone.blend, Undertray Assembly NFR25.SLDASM, Undertray_Tab_Location.SLDASM, Undertray_front_top_tab.SLDPRT, endplate_mold.SLDPRT, inside_endplate_mold.STEP, inside_endplate_mold_+_stock.STEP]
2025-03-15 Add files via upload
    new design for active aero linkage + fea?
    [active_aero_arm_v3.SLDPRT]
2025-03-15 Manufacturability edits to pedalbox
    [9271K903_Torsion Spring_sketched.SLDPRT, 9271K908_Torsion Spring_sketched.SLDPRT, Throttle Pedal Mockup.SLDPRT, ThrottlePedalArm_Corrected.SLDPRT, UpdatedBrakePedalBody.SLDPRT]
2025-03-15 Modified 0.0625 pt2 assem, created pt3 assem, modified 0.25 tabs assem
    [0.0625 tabs pt2.DXF, 0.0625 tabs pt2.SLDASM, 0.0625 tabs pt3.DXF, 0.0625 tabs pt3.SLDASM, 0.25 tabs assem.SLDASM]
2025-03-16 deleted files for dash file organization
    [12 pin connector.SLDPRT, 4 pin connector.SLDPRT, 5in-display.SLDPRT, Board v1 draft.SLDPRT, Box Loft.SLDPRT, Dashboard CAD.SLDPRT, Dashboard assembly.SLDASM, Dashbox Petite.SLDPRT]
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2025-03-16 updated dashboard dashbox cad
    [12 pin connector.SLDPRT, 4 pin connector.SLDPRT, Box Loft.SLDPRT, Dashbox Assembly.SLDASM, Dashbox Petite.SLDPRT, Dashbox assembly.SLDASM, Dashbox.SLDPRT, PCB mockup.SLDPRT]
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2025-03-16 Fixed location of lv battery hopefully
    [90128A121_6-32-1875_Zinc-Plated Alloy Steel Socket Head Screw.SLDPRT, 90453A113_M5_Low-Profile_Nylock.SLDPRT, 93705A851_18-8 Stainless Steel Thread-Locking Socket Head Screw.SLDPRT, 9448K14_Brass Submersible Cord Grip.SLDPRT, _NFR25_Vehicle_Assembly.SLDASM, bms_standoff.SLDPRT, bms_standoff_print.STL]
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2025-03-16 Create Radiator with mounts.SLDASM
    [Radiator with mounts.SLDASM]
2025-03-16 made 0.125 tab assem, started 0.0625 pt4 assem
    [0.0625 tabs pt4.SLDASM, 0.125 tabs assem.DXF, 0.125 tabs assem.SLDASM, 3X---Undertray_front_top_tab.SLDPRT]
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2025-03-17 Added dashboard tabs, added more tabs for waterjetting
    [4X---LV_tabs.SLDPRT, _Dashboard_Assembly_NFR25.SLDASM]
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2025-03-17 fixed firewall tabs
    [Firewall Tab Bottom.SLDPRT, Firewall Tab Top.SLDPRT, Total Baseplate.SLDASM, _Chassis_Skeleton_NFR25.SLDPRT]
2025-03-18 created 0.125 tabs pt2 and 0.0625 tabs pt4
    [0.0625 tabs pt4.DXF, 0.0625 tabs pt4.SLDASM, 0.125 tabs pt 2.DXF, 0.125 tabs pt 2.SLDASM, 4X---LV_tabs.SLDPRT, Bodywork Tab.SLDPRT]
2025-03-18 lv battery connectors and cutouts
    [HDP24-18-6PN.SLDPRT, LV_battery_container.SLDPRT, t4171030012-001.SLDPRT]
2025-03-18 LV battery container STEP files for Bystronic
    [lv_box_container.STEP, lv_box_lid.STEP]
2025-03-18 Fixed firewall tabs to be in the right place, fixed tabs in chassis assembly
    [2X---Firewall Tab 2.SLDPRT, 2X---Firewall Tab Bottom.SLDPRT, 2X---Firewall Tab Top.SLDPRT, 2X---Firewall Tab.SLDPRT, Firewall Tab Bottom.SLDPRT, Firewall Tab Top.SLDPRT, INCORRECT-2X---Firewall Tab 2.SLDPRT, INCORRECT-2X---Firewall Tab.SLDPRT]
2025-03-18 Changed rear hubs hub cap hole to 10-32
    Was 8-32. Changed to create 3D model for Janler manufacturing.
    [RearHubs_NFR25.SLDPRT, RearHubs_NFR25.STEP]
2025-03-19 Added jigs for dashboard tabs, pump tabs, rml tabs, back dack tabs; fixed broken mates in lv batter assem
    [Back daq jig.DXF, Back daq jig.SLDPRT, Dashboard Jig.DXF, Dashboard Jig.SLDPRT, INTG7-060 Pump Electrical Box.DXF, INTG7-060 Pump.DXF, RML Jig.DXF, RML Jig.SLDPRT]
2025-03-20 Added lv battery tab jig
    [LV_battery_container.DXF]
2025-03-20 edits from a long time ago.. i think
    [NFR25_Nosecone_mdf_1.STEP, NFR25_Nosecone_mdf_2.STEP, NFR25_Nosecone_mdf_3.STEP, NFR25_Nosecone_mdf_4.STEP]
2025-03-21 Create Inside Endplate Mold and Stock.STEP
    [Inside Endplate Mold and Stock.STEP]
2025-03-21 Pedal changes for machining
    [Pedal Machining Assembly.SLDASM, Pedal Stock.SLDPRT, Pedal Stock.STEP, ThrottlePedalArm_Corrected.SLDPRT, UpdatedBrakePedalBody.SLDPRT]
2025-03-21 Added new BQ flex PCB setup
    Header flipper, new flexes added. Suppressed old headers that were on BQ CAD.
    [BQ_FLEX_HIGH_ADAPTER.SLDPRT, BQ_FLEX_HIGH_v2-1.SLDPRT, BQ_FLEX_HIGH_v2.SLDPRT, BQ_FLEX_LOW_ADAPTER.SLDPRT, BQ_FLEX_LOW_v2.SLDPRT]
2025-03-24 Added TSSI/RML enclosure rebuilt full vehicle assembly and re-added sus assem and aero, fixed rebuild errors
    [RML Enclosure Assembly.SLDASM, RML TSSI Enclosure.SLDPRT, Ready to Move Light.SLDPRT, Safety Lights Enclosure Final.SLDPRT, Safety Status Indicator.SLDPRT, _NFR25_Vehicle_Assembly.SLDASM]
2025-03-24 Updated RML/TSSI enclosure to look better
    [RML Enclosure Assembly.SLDASM, RML TSSI Enclosure.SLDPRT]
2025-03-24 Fixed broken reference in lv battery assembly
2025-03-26 Started dyno gearbox cad
    [5905K73_Needle-Roller Bearing.SLDPRT, 5909K295_1 mm Thick Washer for 8 mm Shaft Diameter Needle-Roller Thrust Bearing.SLDPRT, 5909K3_Needle-Roller Thrust Bearing.SLDPRT, 92981A151_Alloy Steel Shoulder Screws.SLDPRT, Gearbox Assembly.SLDASM, Planet Carrier.SLDPRT, Planet Gear.SLDPRT, Ring Gear.SLDPRT]
2025-03-26 More edits to dyno gearbox
    [5972K242_Ball Bearing.SLDPRT, 97763A232_18-8 Stainless Steel Button Head Hex Drive Screws.SLDPRT, 98029A011_Black-Oxide Steel Oversized Washer.SLDPRT, Gearbox Enclosure.SLDPRT, Gearbox Output Shaft.SLDPRT, Output Shaft Spacer.SLDPRT, Planet Carrier.SLDPRT, Ring Gear.SLDPRT]
2025-03-26 Flipped side of connector on rml enclosure
    [RML Enclosure Assembly.SLDASM, RML TSSI Enclosure.SLDPRT]
2025-03-26 water cooling changes
    I removed the goofy radiator from the aero assembly and replaced the one in the electrical assembly with the radiator that has tabs
    [Front_Wing_Assembly.SLDASM, NFR_25_FrontWing_V2 (drew).SLDPRT, Radiator with mounts.SLDASM, Radiator_Mounts.SLDPRT, Rear_Rear_Lower_Control_Arm_Assembly_NFR25.SLDASM, Rear_Tie_Rod_Assembly_NFR25.SLDASM, Undertray Assembly NFR25.SLDASM, _NFR25_Vehicle_Assembly.SLDASM]
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2025-03-27 Completed first iteration of dashboard/dashbox
    [5in-display.SLDPRT, 93365A130_Tapered Heat-Set Inserts for Plastic 6-32.SLDPRT, 94459A340_Heat-Set Inserts for Plastic.SLDPRT, 97164A107_Tapered Heat-Set Inserts for Plastic 4-40.SLDPRT, DT04-4P-CL03.SLDPRT, DTM04-12PA-L012.SLDPRT, Dashboard_NFR25.SLDPRT, Dashbox_Enclosure_NFR25.SLDPRT]
2025-03-27 For dashbox: added connector and inertia switch mounting, cleaned up design more
    [Dashbox_Enclosure_NFR25.SLDPRT, InertiaSwitch.SLDPRT, Screen Holder.SLDPRT]
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2025-03-27 Added rotary encoder to dashboard
    [DSA.SLDPRT, Dashboard_NFR25.SLDPRT, Dashbox_Enclosure_NFR25.SLDPRT, Firewall Tab Bottom.SLDPRT, Rotary Encoder Knob.SLDPRT, Rotary Encoder pec11r-4120f-s0018.SLDPRT, Screen Holder.SLDPRT, Swirlpot_Tab_NFR25.SLDPRT]
2025-03-28 Increased strength of dyno gears to meet min requirements, simplified planet bearing setup
    [57155K472_Flanged Ball Bearing.SLDPRT, 90269A236_316 Stainless Steel Shoulder Screw.SLDPRT, 92981A751_Alloy Steel Shoulder Screws.SLDPRT, Gearbox Enclosure.SLDPRT, Gearbox Output Shaft.SLDPRT, Planet Carrier.SLDPRT, Planet Gear.SLDPRT, Ring Gear.SLDPRT]
2025-03-28 Added voltage indicator light to penthouse
    [Energy_Meter_Busbar.SLDPRT, PenthouseInternalWall.SLDPRT, Penthouse_Container.SLDASM, Penthouse_Left_Wall.SLDPRT, Penthouse_Rear_Wall.SLDPRT, Voltage Indicator Holder.SLDPRT, Voltage Indicator WP7113.SLDPRT]
2025-03-29 Started design of dyno outside of gearbox
    [25KW MOTOR MA-3D.SLDPRT, 5905K73_Needle-Roller Bearing.SLDPRT, 5909K295_1 mm Thick Washer for 8 mm Shaft Diameter Needle-Roller Thrust Bearing.SLDPRT, 5909K3_Needle-Roller Thrust Bearing.SLDPRT, 90269A236_316 Stainless Steel Shoulder Screw.SLDPRT, 92981A751_Alloy Steel Shoulder Screws.SLDPRT, Gearbox Enclosure.SLDPRT, Gearbox Output Shaft.SLDPRT]
2025-03-29 Added first iteration of rest of dyno assembly
    [3487N26_Force Sensor.SLDPRT, Dyno Base Plate.SLDPRT, Flywheel.SLDPRT, Gearbox Enclosure.SLDPRT, Gearbox Output Shaft.SLDPRT, Motor Stand.SLDPRT, Motor Torque Arm.SLDPRT, Planet Carrier.SLDPRT]
2025-04-01 Update Throttle Pedal Mockup.SLDPRT
    [Throttle Pedal Mockup.SLDPRT]
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2025-04-03 charger redesign
    vertical
    [53535A12_Rubber Foot.SLDPRT, Charger enclosure.SLDPRT, new charger enclosure.SLDPRT]
2025-04-03 trying to fix the charger
    [new assembly.SLDASM]
2025-04-03 Broke rml enclosure (will fix)
    [RML TSSI Enclosure.SLDPRT]
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2025-04-03 Finished putting TSSI on top of RML
    [RML Enclosure Assembly.SLDASM, RML TSSI Enclosure.SLDPRT]
2025-04-03 Updated rear hubs from Janler feedback
    [RearHubs_NFR25.SLDPRT]
2025-04-03 Added hole for wiring grommet to RML enclosure
    [RML Enclosure Assembly.SLDASM, RML TSSI Enclosure.SLDPRT]
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2025-04-03 Created dxf file for laser cutting dashboard
    [Dashboard_NFR25.DXF]
2025-04-03 Added STL file for dashbox 3D printing
    [Dashboard_NFR25_1.DXF, Dashbox_Enclosure_NFR25.SLDPRT, Dashbox_Run_1.STL]
2025-04-04 Fixed pump model, fixed rml/tssi, updated electrical assembly
    [INTG7-060 Pump.SLDPRT, Pump Tab Lower.SLDPRT, Pump Tab Upper.SLDPRT, RML Enclosure Assembly.SLDASM, RML TSSI Enclosure.SLDPRT]
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2025-04-05 Updated pump jig cad
    [INTG7-060 Pump.DXF]
2025-04-05 potential heat sensor mount
    [SensorMountv3.SLDASM, SensorMountv3pt1.SLDPRT, SensorMountv3pt2.SLDPRT]
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2025-04-05 lots of charger changes
    created new block models for components that aren't available online, fixed vertical enclosure and added lid, added threaded rubber feet
    [40mm red button.SLDPRT, 53535A12_Rubber Foot.SLDPRT, 9541K44_Threaded-Stud Bumper.SLDPRT, Elcon HK-J-H650-12 block model.SLDPRT, Elcon HK-LF-540-12-A block model.SLDPRT, Enclosure assembly.SLDASM, J1772 block.SLDPRT, TSMP block.SLDPRT]
2025-04-06 segment box update after segment short
    - made long busbar (temporary)
    - updated segment box assembly
    [LongFemaleMPBottomCover.SLDPRT, LongFemaleMPBottomCoverPrint.STL, LongFemaleMPBusbar.SLDPRT, LongFemaleMPBusbarSCS.STEP, LongFemale_Maintenance_Plug_Cover.SLDPRT, LongFemale_Maintenance_Plug_CoverPrint.STL, LongMP.SLDASM]
2025-04-06 added rml enclosure stl
    [rml enclosure front.STL, rml enclosure rear.STL]
2025-04-08 Updated dashbox internal frame
    It now locates the screen driver board properly.
    [93365A130_Tapered Heat-Set Inserts for Plastic 6-32.SLDPRT, Dashbox_Enclosure_NFR25.SLDPRT]
2025-04-08 last 1/16th in tabs i forgot to push from like a week ago
    [0.0625 tabs pt5.DXF, 0.0625 tabs pt5.SLDASM]
2025-04-10 charger !!!
    -added cutouts to enclosure per datasheets
    -added block models of voltmeter and ammeter
    -new rubber feet
    etc
    [100A analog ammeter.SLDPRT, 40mm red button.SLDPRT, 91075A468_Male-Female Threaded Hex Standoff.SLDPRT, 9541K44_Threaded-Stud Bumper.SLDPRT, 9541K85_Threaded-Stud Bumper.SLDPRT, 9546K548_Neoprene Bumper.SLDPRT, Charger enclosure.SLDPRT, Elcon HK-LF-540-12-A block model.SLDPRT]
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2025-04-12 rear tire sensor mounts
    [Ohlins TTX25 MkII FSAE Shock Assembly.SLDASM, RearHubCaps_NFR25.SLDPRT, RearUpright NFR25.SLDPRT, SensorMountREAR.SLDASM, SensorMountREARpt1.SLDPRT, SensorMountREARpt2.SLDPRT, SensorMountv3.SLDASM, SensorMountv3pt2.SLDPRT]
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2025-04-12 moved firewall to github
    [firewall dxf.DXF]
2025-04-12 correct file now
    [Firewall.SLDPRT]
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2025-04-13 changed position of main floor and trimmed firewall accordingly
    [Main Floor Front Tab NFR25.SLDPRT, Seat Floor^_Chassis_Assembly_NFR25.SLDPRT]
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2025-04-15 dimension changes to tire sensor mounts
    [SensorMountFRONTv4pt2.SLDPRT, SensorMountREARpt2.SLDPRT]
2025-04-17 charger
    found correct dimensions for bold holes
    [Elcon HK-LF-540-12-A block model.SLDPRT, new charger enclosure.SLDPRT]
2025-04-17 renaming files
    cleaning charger stuff up
    [Charger Enclosure.SLDPRT, TE HDP20.SLDPRT]
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2025-04-18 added safety wire bolts to msa
    [90117A205_Alloy Steel Wire-Lockable Socket Head Screw.SLDPRT, MSA_Assembly.SLDASM]
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2025-04-19 Modified inverter cold plate for 3/8
    [GLVMS Circle.SLDPRT, Inverter_Cold_Plate_NFR25.SLDPRT, Inverter_Thermal_Spacer_NFR25.SLDPRT, RearHubs_NFR25.SLDDRW, TSMS Circle.SLDPRT]
2025-04-19 added side mounting retaining ring to throttle pedalbox
    [97431A320_Side-Mount External Retaining Rings.SLDPRT]
2025-04-19 created msa adapter drawing
    [NFR25 MSA Adapter Drawing.SLDDRW]
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2025-04-21 Added standoffs to DAQ box
    [91075A117_Male-Female Threaded Hex Standoff.SLDPRT, Back-DAQ_Enclosure.SLDPRT, DAQ_Cover.SLDPRT]
2025-04-21 Moved DAQ Enclosure ports
    [Back-DAQ_Enclosure.SLDPRT]
2025-04-22 gasket + 3d print for rear hub tripod housing
    [3d printed tripod insert.SLDPRT, butthole_gasket_dxf_p1.DXF]
2025-04-23 Changes for janler 4/22
    [RearHubs_NFR25.SLDDRW]
2025-04-24 Create Steering angle insert.SLDPRT
    [Steering angle insert.SLDPRT]
2025-04-24 Added DAQ box grid
    [91075A117_Male-Female Threaded Hex Standoff.SLDPRT, Back-DAQ_Enclosure.SLDPRT, DAQ_Cover.SLDPRT]
2025-04-24 Created Rear ARB Tab
    Waterjet from 1/8" steel sheet
    [Rear_ARB_Tab.SLDPRT]
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2025-04-24 Changed DAQ box grid
    [Back-DAQ_Enclosure.SLDPRT, DAQ_Cover.SLDPRT]
2025-04-24 underdefined sketches creep me out
    [NFR25_RearWing_DONOTCHANGEhigh_aoa.SLDPRT]
2025-04-24 updated the servo mount
    [Active_Aero_Mounting.SLDASM, Servo_Mount.SLDPRT, Servo_brace_v2.SLDPRT]
2025-04-24 Machining files for inverter cold plate
    [Inverter_Cold_Plate_NFR25.SLDPRT, Inverter_Cold_Plate_NFR25.STEP]
2025-04-24 added upper firewall tab to tabs folder
    [10X---Upper Firewall Tab.SLDPRT]
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2025-04-25 active aero linkage v4
    design changes but did not run fea
    [active_aero_arm_v4.SLDPRT]
2025-04-25 finalizing active aero arm
    [Active Aero Virtual Rig V2.SLDASM, NFR25_RearWing_Mounting.SLDASM, RW_SF_Insert_Active_Aero.SLDPRT, active_aero_arm_v4.SLDPRT]
2025-04-25 Made gearbox changes from prof. wang meeting
    [5905K528_Needle-Roller Bearing.SLDPRT, 5905K73_Needle-Roller Bearing.SLDPRT, 92981A302_Alloy Steel Shoulder Screws.SLDPRT, Planet Carrier.SLDPRT, Planet Gear.SLDPRT]
2025-04-26 charger
    added mounting plate for resistors
    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
    [Charger Enclosure.SLDPRT, Internals mounting plate assembly.SLDASM, avc2.r.SLDPRT, charger internals mounting plate.SLDPRT, te hsa50.SLDPRT]
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2025-04-27 Chain guard final changes
    [Chain Guard.SLDPRT]
2025-04-28 Added angular backlash to gears to account for manufacturing tolerances
    [Gearbox Output Shaft.SLDPRT, Planet Gear.SLDPRT, Ring Gear.SLDPRT, Sun Gear.SLDPRT]
2025-04-29 Started gear drawings and added radiator tabs
    [Planet Gear.SLDDRW, Planet Gear.SLDPRT, Q18741-10 Radiator.SLDASM, Radiator with mounts.SLDASM, Radiator_Tab_Lower.SLDPRT, Radiator_Tab_Upper.SLDPRT, Radiator_Tab_Upper_Upper.SLDPRT, Ring Gear.SLDDRW]
2025-04-29 Created Rear ARB Assembly
    Still need to add torsion bar
    [New_Rear_ARB.SLDASM, New_Rear_ARB_Delrin_Spacer.SLDPRT, New_Rear_ARB_Steel_Inster.SLDPRT, Rear_ARB_Left_Mount.SLDASM, Rear_ARB_Right_Mount.SLDASM]
2025-04-29 preliminary rear ARB rocker side arm
    needs to be FEA'd
    can we get much higher *so high*
    [prelim_rear_rocker_arm.SLDPRT]
2025-04-29 Updated TSMS and GLVMS circles
    Changed hole spacing to 40mm, from measurement on the car.
    [GLVMS Circle.SLDPRT, TSMS Circle.SLDPRT]
2025-04-29 Gear drawings and radiator tab changes
    [Heat Treatment Tester.SLDPRT, Planet Gear.SLDDRW, Radiator_Tab_Lower.SLDPRT, Radiator_Tab_Upper.SLDPRT, Radiator_Tab_Upper_Upper.SLDPRT, Ring Gear.SLDDRW, Sun Gear.SLDDRW]
2025-04-30 Started changes for design judging submissions
    [Main Floor Front Tab NFR25.SLDPRT, NFR-Logo-Part.SLDPRT, PedalBox Floor^_Chassis_Assembly_NFR25.SLDPRT, Planet Gear.SLDPRT, Ring Gear.SLDPRT, Seat Floor^_Chassis_Assembly_NFR25.SLDPRT, Sun Gear.SLDPRT]
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2025-05-01 charger
    decided on hardware and changed design
    [90480A195_Low-Strength Steel Hex Nut.SLDPRT, 92499A622_18-8 Stainless Steel Male-Female Hex Thread Adapter.SLDPRT, 92510A397_Aluminum Unthreaded Spacer.SLDPRT, 92865A564_Medium-Strength Grade 5 Steel Hex Head Screw.SLDPRT, Charger Enclosure.SLDPRT, c-hdp24-18-20pn-d-3d.stp, charger internals mounting plate.SLDPRT]
2025-05-01 Added new brake-side hardware and spacer piece to pedalbox
    Added grade 8+ nuts & bolts, modeled brake-side bolt spacer
    [91205A203_Alloy Steel Thread-Locking Socket Head Screw.SLDPRT, 91205A205_Alloy Steel Thread-Locking Socket Head Screw.SLDPRT, 94830A490_Steel Thin Flex-Top Locknut for Heavy Vibration.SLDPRT, Q18741-10 Radiator.SLDASM, brake_side_washer.SLDPRT, radiator_tab_)jig.DXF, radiator_tab_)jig.SLDASM]
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2025-05-02 Initial changes for 3 view drawings
    [NFR25 Rack Pillow Block Mount.SLDPRT, Radiator with mounts.SLDASM, _Maintenance_Panel_Assembly_NFR25.SLDASM, _Steering_Assembly_NFR25.SLDASM]
2025-05-02 Added daq box hardware
    [93365A130_Tapered Heat-Set Inserts for Plastic (1).SLDPRT]
2025-05-02 Created the servo brace for the 55kg
    [Servo_brace_v2_55kg.SLDPRT, Servo_brace_v2_55kg.STL]
2025-05-02 Rear Rocker Arm Prototype
    Added Bolt Holes
    [Rear_Rocker_Arm Prototype.SLDPRT]
2025-05-02 Started modeling hoses - not worth the time
    [5WaySplitter.SLDASM, Tractive_System_Wiring_NFR25.SLDPRT, Watercooling_Routing_NFR25.SLDPRT]
2025-05-03 Updated undertray with current tabs and hardware
    [92620A564_Zinc Yellow-Chromate Plated Hex Head Screw.SLDPRT, 93286A013_Aluminum Washer.SLDPRT, 95462A505_Medium-Strength Steel Hex Nut.SLDPRT, Undertray Assembly NFR25.SLDASM, Undertray_Tab_Location.SLDASM, Undertray_tab_front.SLDPRT]
2025-05-03 trimmed undertray according to as buitl
    [Undertray Assembly NFR25.SLDASM, Undertray_V10.SLDPRT]
2025-05-03 updated front wing with trims and rear wing with the hardware
    [90480A009_Low-Strength Steel Hex Nut.SLDPRT, 91251A194_Black-Oxide Alloy Steel Socket Head Screw.SLDPRT, 91251A199_Black-Oxide Alloy Steel Socket Head Screw.SLDPRT, NFR_25_FrontWing_V2 (drew).SLDPRT, RW_Control_Cable.SLDPRT, TopFoilInsert.SLDPRT]
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2025-05-03 new diff sprocket model for cost report
    [diff_sprocket_new.SLDPRT]
2025-05-03 3/8ths and 1/2 barb splitters + drawings
    [5_Way_Splitter_2.0.SLDPRT, 5_Way_Splitter_3.0_halfinch.SLDDRW, 5_Way_Splitter_3.0_halfinch.SLDPRT, 5_Way_Splitter_3.0_threeeighths.SLDDRW, 5_Way_Splitter_3.0_threeeighths.SLDPRT, 5waysplitterdrawing.SLDDRW]
2025-05-03 finished msa adapter drawing
    [Adapter.SLDPRT, NFR25 MSA Adapter Drawing.SLDDRW]
2025-05-03 bunch of drawings created
    [Cold_Plate.SLDPRT, MasterNegative.SLDPRT, MasterPositive.SLDPRT, SegmentContainer.SLDASM, SegmentExternalWalls.SLDPRT, SegmentInternalWall.SLDPRT, SegmentLid.SLDPRT, bottomBusbar.SLDPRT]
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2025-05-03 Drawing for MDM Left Eccentric plate
    [Drawing_MDMount_NFR25-Left Eccentric Plate.SLDDRW, MDMount_NFR25-Left Eccentric Plate.SLDPRT, MDMount_NFR25.SLDPRT, _Chassis_Skeleton+Block_Model_NFR25.SLDPRT]
2025-05-03 made msa sleeve drawing
    [NFR25 MSA Adapter Drawing.SLDDRW, NFR25 MSA Sleeve Drawing.SLDDRW]
2025-05-03 Final splitter drawing edits
    [5_Way_Splitter_3.0_halfinch.SLDDRW, 5_Way_Splitter_3.0_threeeighths.SLDDRW]
2025-05-03 made msa sprocket drawing
    [NFR25 MSA Sprocket Drawing.SLDDRW]
2025-05-03 DSA Drawing (Updated) and MSA Spacer Drawing
    [DSA.SLDDRW, MSA Spacer.SLDDRW]
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2025-05-03 Updated MDM Left Eccentric Plate drawing
    [Drawing_MDMount_NFR25-Left Eccentric Plate.SLDDRW, MDMount_NFR25-Left Eccentric Plate.SLDPRT, MDMount_NFR25.SLDPRT]
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2025-05-03 created drawing for throttle pedal arm
    [ThrottlePedalArm_Corrected_5_3_25.SLDDRW]
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2025-05-04 drawing for maintenance plug busbar
    charlie said to add a description
    [maintenance_plug_busbar_drawing.SLDDRW]
2025-05-04 drawings for penthouse parts and some others
    [PenthouseInternalWall.SLDPRT, PenthouseLid.SLDPRT, Penthouse_Front_Wall.SLDPRT, Penthouse_Left_Wall.SLDPRT, Penthouse_Rear_Wall.SLDPRT, Penthouse_Right_Wall.SLDPRT, SegmentBoltTubes.SLDPRT, master_negative_busbar_drawing.SLDDRW]
2025-05-04 maintenance plug drawings
    cover, busbar, bottom
    [maintenance_plug_bottom_drawing.SLDDRW, maintenance_plug_busbar_drawing.SLDDRW, maintenance_plug_cover_drawing.SLDDRW]
2025-05-04 gasket v2 + steering angle standoffs
    [Angle sensor standoffs.SLDPRT, Butthole gasket sketch.SLDPRT, butthole_gasket_dxf_p2.DXF]
2025-05-04 drawing format for maintenance plug cover+busbar
    [maintenance_plug_busbar_drawing.SLDDRW, maintenance_plug_cover_drawing.SLDDRW]
2025-05-04 drawing format for maintenance plug bottom
    [maintenance_plug_bottom_drawing.SLDDRW]
2025-05-05 Added grips to steering
    [Steering Wheel Assembly.SLDASM]
2025-05-06 swirl pots 90 degree barb
    [90 degree barb.SLDPRT]
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2025-05-06 mate tab to swirlpot
    [Firewall Tab Bottom.SLDPRT]
2025-05-06 Update Rear_Rocker_ARB_Arm.SLDPRT
    correct hole placement, fea thinkings
2025-05-07 new safety wire bolts
    [Chain Guard Tab.SLDPRT, Chain Guard.SLDPRT]
2025-05-07 stickers and undertray tab
    [Undertray_tab_front.SLDPRT]
2025-05-07 rear rocker arm: corrected bolt hole orientation
2025-05-07 swirl pot top dimensions
    [top.SLDPRT]
2025-05-07 Created rocker arm and reference rocker assembly, added bolt
    [92981A415_Alloy Steel Shoulder Screws.SLDPRT, Rear_Rocker_For_Arm_Reference.SLDPRT, Reference_Rocker and Arm Assem.SLDASM]
2025-05-08 changed bolts in drivetrain
    m8 are not safety wire bc mcmaster doesn't have safety wire
    [91290A426_Alloy Steel Socket Head Screw.SLDPRT]
2025-05-08 add fea models to rocker arm, change rocker arm arcdesign
    [Reference_Rocker and Arm Assem.SLDASM]
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2025-05-08 Create NFR25 MSA Assembly Drawing.SLDDRW
    [NFR25 MSA Assembly Drawing.SLDDRW]
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2025-05-08 wheel speed sensor extendo
    [wheel_speed_sensor_extendo.SLDPRT, wheel_speed_sensor_extendo.STL]
2025-05-08 Create _Suspension_Skeleton_NFR25 - Copy.SLDPRT
    [_Suspension_Skeleton_NFR25 - Copy.SLDPRT]
2025-05-08 wheel speed sensor cyl spacer
    [wheel_speed_sensor_cyl.SLDPRT, wheel_speed_sensor_cyl.STL]
2025-05-09 Created drawings for right mdm and eplate
    [Drawing_Right_Eccentric_Plate_NFR25.SLDDRW, Drawing_Right_MDMount_NFR25.SLDDRW, Jackbar_Mount.SLDPRT, MDMount_NFR25-Right Eccentric Plate.SLDPRT, MDMount_NFR25.SLDPRT]
2025-05-09 swirl pot tabs and dimension fixes
    [Swirl Pot Assembly.SLDASM, Tube.SLDPRT, bottom.SLDPRT, tabsnew.SLDPRT, top.SLDPRT]
2025-05-09 Fixed bezels on dash screen holder
    [Screen Holder.SLDPRT]
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2025-05-11 drawings for cost report
    [Front-Rear Rocker Tabs.SLDDRW, Front-Rear Rocker Tabs.SLDPRT, RearHubAssembly.SLDASM, RearHubAssembly.SLDDRW, Rear_ARB_Tab.SLDDRW, Wheel_Nut_NFR24.SLDDRW, front Upright clevis NFR25.SLDDRW, rear hub back.SLDDRW]
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2025-05-11 created left mdmount drawing and touched up on the right mount drawing
    [Drawing_Left_MDMount_NFR25.SLDDRW, Drawing_Right_MDMount_NFR25.SLDDRW, MDMount_NFR25.SLDPRT]
2025-05-11 modified swirl pot tabs
    [Swirl Pot Assembly.SLDASM, Swirl Pot.SLDPRT, Tube.SLDPRT, tabsnew.SLDPRT]
2025-05-12 Formatting changes for MDM drawings
    [Drawing_Left_MDMount_NFR25.SLDDRW, Drawing_MDMount_NFR25-Left Eccentric Plate.SLDDRW, Drawing_Right_Eccentric_Plate_NFR25.SLDDRW, Drawing_Right_MDMount_NFR25.SLDDRW, MDMount_NFR25.SLDPRT]
2025-05-13 Made more drawings for mdm/jacking point
    [Drawing_Jack_Bar_NFR25.SLDDRW, Drawing_Jackbar_Mount.SLDDRW, Drawing_Jacking_Point_Assem.SLDDRW, Jackbar_Mount.SLDPRT]
2025-05-13 Change Rear ARB Arm Shape
    [Reference_Rocker and Arm Assem.SLDASM]
2025-05-13 water cooling fitting drawings
    [BarbBlockModel Drawing.SLDDRW, RightAngleBlockModel Drawing.SLDDRW, TubenutBlockModel Drawing.SLDDRW]
2025-05-13 made swirl pot tab longer
    [tabsnew.SLDPRT]
2025-05-13 added new cold plate for inverter
    [90576A102_Medium-Strength Steel Nylon-Insert Locknut.SLDPRT, 90631A115_M8_Nylock.SLDPRT, 92095A184_Button Head Hex Drive Screw.SLDPRT, 92095A460_Button Head Hex Drive Screw.SLDPRT, 92510A035_Aluminum Unthreaded Spacer.SLDPRT, 92510A442_Aluminum Unthreaded Spacer.SLDPRT, 93310A813_Nylon_Patch_M5x10.SLDPRT, Inverter_Cold_Plate_NFR25.SLDPRT]
2025-05-13 Revert "added new cold plate for inverter"
    This reverts commit 708f6120eed29b0c3fe211695361b5f2cbe486fb.
    [90576A102_Medium-Strength Steel Nylon-Insert Locknut.SLDPRT, 90631A115_M8_Nylock.SLDPRT, 92095A184_Button Head Hex Drive Screw.SLDPRT, 92095A460_Button Head Hex Drive Screw.SLDPRT, 92510A035_Aluminum Unthreaded Spacer.SLDPRT, 92510A442_Aluminum Unthreaded Spacer.SLDPRT, 93310A813_Nylon_Patch_M5x10.SLDPRT, Inverter_Cold_Plate_NFR25.SLDPRT]
2025-05-13 New cold plate for inverter
    [90576A102_Medium-Strength Steel Nylon-Insert Locknut.SLDPRT, 90631A115_M8_Nylock.SLDPRT, 92095A184_Button Head Hex Drive Screw.SLDPRT, 92095A460_Button Head Hex Drive Screw.SLDPRT, 92510A035_Aluminum Unthreaded Spacer.SLDPRT, 92510A442_Aluminum Unthreaded Spacer.SLDPRT, 93310A813_Nylon_Patch_M5x10.SLDPRT, Inverter_Cold_Plate_NFR25.SLDPRT]
2025-05-15 Added daq box wire cover
    [DAQ_Acrylic_Cover.SLDPRT]
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2025-05-15 Rear ARB Big Update
    Created torsion bar, create torsion bar lever, added both to rear ARB assembly, changed steel insert to match torsion bar ID
    [New_Rear_ARB.SLDASM, New_Rear_ARB_Lever.SLDPRT, New_Rear_ARB_Steel_Inster.SLDPRT, Rear_ARB_Torsion_Bar.SLDPRT]
2025-05-16 Rear ARB Changes
    Added pin slots to torsion bar, steel insert
    [New_Rear_ARB.SLDASM, New_Rear_ARB_Steel_Inster.SLDPRT, Rear_ARB_Right_Mount.SLDASM, Rear_ARB_Torsion_Bar.SLDPRT]
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2025-05-19 fixed mates
    [PedalBox Floor^_Chassis_Assembly_NFR25.SLDPRT]
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2025-05-22 New Iteration of Rear ARB
    Changed to accommodate aluminum insert (not steel), constrained lever arms.
    [New_Rear_ARB.SLDASM, New_Rear_ARB_Cyl_Delrin_Spacer.SLDPRT, New_Rear_ARB_Delrin_Spacer.SLDPRT, New_Rear_ARB_Lever.SLDPRT, New_Rear_ARB_Steel_Inster.SLDPRT, Rear_ARB_Torsion_Bar.SLDPRT]
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2025-05-28 Tripod bearing inserts updated
    Added 0.25" and 0.5" versions.
    [3d printed tripod insert.SLDPRT, 3d printed tripod insert_0.25in.STL, 3d printed tripod insert_0.50in.STL]
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2025-05-29 charger step files
    created step files of charger box and lid
    [Charger Enclosure.SLDPRT, charger_enclosure_box.SLDPRT, charger_enclosure_box.STEP, charger_enclosure_lid.SLDPRT, charger_enclosure_lid.STEP]
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2025-06-11 cell characterization stuff added
    [Molicel21700.SLDPRT, cell_char_base.SLDPRT, cell_char_cap.SLDPRT, cell_char_power_res.SLDPRT]
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2025-06-12 front wing step files
    [NFR_25_FrontWing_V2_Endplate_Updated.SLDPRT, NFR_25_FrontWing_V2_Endplate_Updated.STEP]
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2025-07-06 Fixed major assembly rebuild errors
    [Active Aero Virtual Rig V2.SLDASM, Active_Aero_Mounting.SLDASM, Carbon tube assembly.SLDASM, Dashboard_NFR25.SLDPRT, Dashbox_Enclosure_NFR25.SLDPRT, Inverter_Cold_Plate_NFR25.SLDPRT, MDMount_NFR25.SLDPRT, MSA_Assembly.SLDASM]
2025-07-07 Fixed dashboard constraints and aero appearances
    [Dashboard_NFR25.SLDPRT, Dashbox_Enclosure_NFR25.SLDPRT, PedalBox Floor^_Chassis_Assembly_NFR25.SLDPRT, Screen Holder.SLDPRT, _NFR25_Vehicle_Assembly.SLDASM]
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2025-07-27 Update 3d printed tripod insert.DXF
    [3d printed tripod insert.DXF]
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2026-07-29 fixing gitignore to disregard tire data
